corelab-umich/kiteCADRepo/solidworks/Exp Scale Manta Ray/Vendor Parts/Hi-Tec/HS-5086WP.jpg

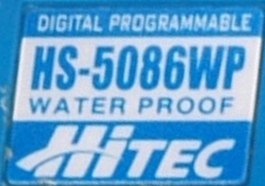
solidworks/Exp Scale Manta Ray/Vendor Parts/Hi-Tec/HS-5086WP.jpg
