corelab-umich/kiteCADRepo/README.md

# kiteCADRepo
Repo to house the CAD for the DOE kite
