corelab-umich/kiteCADRepo/solidworks/Exp Scale Manta Ray/EXK BOM.xlsx

ITEM NO. | PART NUMBER | DESCRIPTION | QTY. | Vendor | Notes | Date Ordered | Date Expected | Date Received
42 | SW1250MG | SERVO MOTOR | 4 | Amazon | In Stock | 2021-03-06 | 2021-03-12 | 2021-03-11
9 | BAR02 | DEPTH SENSOR | 1 | Blue Robotics | In Stock | N/A | N/A | N/A
1 | 2401K123 | SHAFT COUPLER - HSTAB | 2 | MCM | Ordered | 2021-03-10 | 2021-03-14
2 | 2401K820_ALUMINUM FLEXIBLE SHAFT COUPLING | SHAFT COUPLER FLEXIBLE COUPLING | 1 | MCM | Ordered | 2021-03-10 | 2021-03-14
3 | 2867T47 | BRIDLE HINGE PIN BUSHING | 2 | MCM | Ordered | 2021-03-10 | 2021-03-14
4 | 90145A508 | WING SHEAR PIN | 6 | MCM | Ordered | 2021-03-10 | 2021-03-14
5 | 92510A817 | ALUMINUM SPACER - TETHER PINCH LOCATION | 1 | MCM | Ordered | 2021-03-10 | 2021-03-14
6 | 92735A430 | BRIDLE HINGE PIN | 1 | MCM | Ordered | 2021-03-10 | 2021-03-14
7 | 92735A500 | CLEVIS PIN - TETHER | 1 | MCM | Ordered | 2021-03-10 | 2021-03-14
8 | 93615A216 | WING MOUNT SCREW | 6 | MCM | Ordered | 2021-03-10 | 2021-03-14
44 | W_626_2Z | BEARING 7mm ID X 19mm OD X 6mm H | 6 | MCM | In Stock | N/A | N/A
10 | Bridle |  | 1 | NCSU | 3D Printed | N/A
38 | MirrorEXK-02-0010 | MOTOR MOUNT STBD | 1 | NCSU | 3D Printed | N/A
39 | MirrorEXK-02-0024 | AILERON STBD | 1 | NCSU | 3D Printed | N/A
40 | MirrorEXK-02-0024 | AILERON HINGE STBD | 1 | NCSU | 3D Printed | N/A
34 | MCBH12-F | CONNECTOR, BULKHEAD, 12 PIN, FEMALE | 1 | TTI | Waiting on account w/ TTI. Currently waiting on Toni Rand | TBD
35 | MCBH8-F | CONNECTOR, 8 PIN, BULKHEAD, MALE | 1 | TTI | Waiting on account w/ TTI. Currently waiting on Toni Rand | TBD
36 | MCIL12M | CONNECTOR, 12 PIN, INLINE | 1 | TTI | Waiting on account w/ TTI. Currently waiting on Toni Rand | TBD
37 | MCIL8M | CONNECTOR, 8 PIN, INLINE | 1 | TTI | Waiting on account w/ TTI. Currently waiting on Toni Rand | TBD
11 | CB6014CR04-1P | NUTPLATE | 8 | VX | Quote Due Tomorrow
43 | Skin |  | 1 | VX | Quote Due Tomorrow
12 | EXK-01-0002 | NOSE CONE | 1 | Xometry | Order 15007 | 2021-03-09 | 2021-03-20
13 | EXK-01-0006 | TAILCONE | 1 | Xometry | Order 15009 | TBD
14 | EXK-01-0008 | FUSELAGE | 1 | Xometry | Order 15006 | TBD
17 | EXK-01-0014 | SPARS | 1 | Xometry | SoleSource | TBD
19 | EXK-02-0003 | RIB, WING ROOT | 1 | Xometry | SoleSource | TBD
20 | EXK-02-0003-02 | RIB WING ROOT STBD | 1 | Xometry | SoleSource | TBD
21 | EXK-02-0009-01 | RIB, WING TIP | 1 | Xometry | SoleSource | TBD
22 | EXK-02-0009-02 | RIB WING TIP STBD | 1 | Xometry | SoleSource | TBD
26 | EXK-02-0014-01 | SPAR, HORIZONTAL STABILIZER | 2 | Xometry | Shipped | TBD
27 | EXK-02-0014-02 | SPAR, VERTICAL STABILIZER | 1 | Xometry | Shipped | TBD
29 | EXK-02-0017 | WINGBOX | 1 | Xometry | Order 15005 | TBD
15 | EXK-01-0010 | STABILIZER | 3 | VX | Quote Due Tomorrow
16 | EXK-01-0012 | FOAM CORE | 1 | VX | Quote Due Tomorrow
18 | EXK-01-0016 | BRIDLE CLEVIS | 1 | NCSU | 3D Printed
23 | EXK-02-0010 | MOTOR MOUNT PORT | 1 | NCSU | 3D Printed
24 | EXK-02-0012 | STABILIZER BEARING BLOCK | 3 | Xometry | 1500A - Ordered | TBD | 2021-03-24
25 | EXK-02-0013 | STABILIZER CONTROL HORN | 2 | NCSU | Waterjet
28 | EXK-02-0015 | MOTOR CONTROL HORN | 2 | NCSU | Waterjet
30 | EXK-02-0024 | AILERON PORT | 1 | NCSU | 3D Printed
31 | EXK-02-0024 | AILERON HINGE PORT | 1 | NCSU | 3D Printed
32 | EXK-02-0025 | STATIC TRAILING EDGE PORT | 1 | NCSU | 3D Printed
33 | EXK-02-0028 | PCB MOUNT | 1 | NCSU | 3D Printed
41 | PCB-Step |  | 1
45 | Weights | N/A | Many | NCSU | Waterjet
