corelab-umich/kiteCADRepo/solidworks/Line Angle Sensor/LAS BOM.xlsx

ITEM NO. | PART NUMBER | DESCRIPTION | QTY. | Vendor
1 | LAS-01-0002 | LAS AZIMUTH PIVOT ARM | 1
2 | LAS-01-0008 | TETHER GUIDE ROLLER MOUNT | 1
3 | LAS-01-0010 | SHAFT END | 2
4 | LAS-01-0012 | TETHER ARM | 1
5 | LAS-01-0018 | LAS BOOM ARM BUOY | 1
6 | LAS-01-0020 | TETHER GUIDE ROLLER | 2
7 | LAS-02-0002 | LAS AZIMUTH AXIS - ENCODER | 1
8 | LAS-02-0003 | LAS AZIMUTH AXIS - PASSIVE | 1
9 | LAS-02-0006 | LAS ELEVATION PIVOT ARM | 1
10 | LAS-03-0002 | LAS BASE PLATE | 1
11 | LAS-03-0004 | LAS ELEVATION AXIS PIVOT MOUNT | 1
12 | LAS-03-0005 | LAS ELEVATION AXIS PIVOT MOUNT - OPPOSITE | 1
13 | LAS-03-0008 | TETHER REDIRECT | 1
14 | 4668K15 | BEARING, 440C, 1/2" SHAFT | 2 | MCMASTER CARR
15 | 5908K31 | BEARING, 316SS, 8mm SHAFT | 4 | MCMASTER CARR
16 | 90145A878 | 1/8" D, 5/16" L, 18-8 | 7 | MCMASTER CARR
17 | 90715A005 | LOCKNUT, 316 SS, 4-40 | 2 | MCMASTER CARR
18 | 90792A445 | 1/2" SHOULDER SCREW SHIM - 0.03" 316SS | 7 | MCMASTER CARR
19 | 91116A130 | WASHER, SS, OVERSIZED, M4 | 2 | MCMASTER CARR
20 | 92185A078 | #2-56, 5/16" L, 316 SS | 2 | MCMASTER CARR
21 | 92185A191 | #8-32, 5/16" L, 316 SS | 2 | MCMASTER CARR
22 | 92185A196 | #8-32, 5/8" L, 316 SS | 20 | MCMASTER CARR
23 | 92510A724 | ANODE, #8 X 1/2" OD X 3/8" L | 2 | MCMASTER CARR
24 | 92735A120 | 3/16" SS CLEVIS PIN | 2 | MCMASTER CARR
25 | 94805A115 | 3/6-16 JAM NUT 316 SS | 2 | MCMASTER CARR
26 | 97345A104 | SHOULDER SCREW, 316 SS, 1/8" X 5/8" | 2 | MCMASTER CARR
27 | 97345A732 | 3" X 1/2" 316 SHOULDER SCREW | 1 | MCMASTER CARR
28 | RM22-3D | RM22 ENCODER | 2 | RENISHAW
29 | RMA-shaft8mm | RMA MAGNETIC ACTUATOR | 2 | RENISHAW
