corelab-umich/kiteCADRepo/Creo/kite_7_31_20/kite_asm.stp

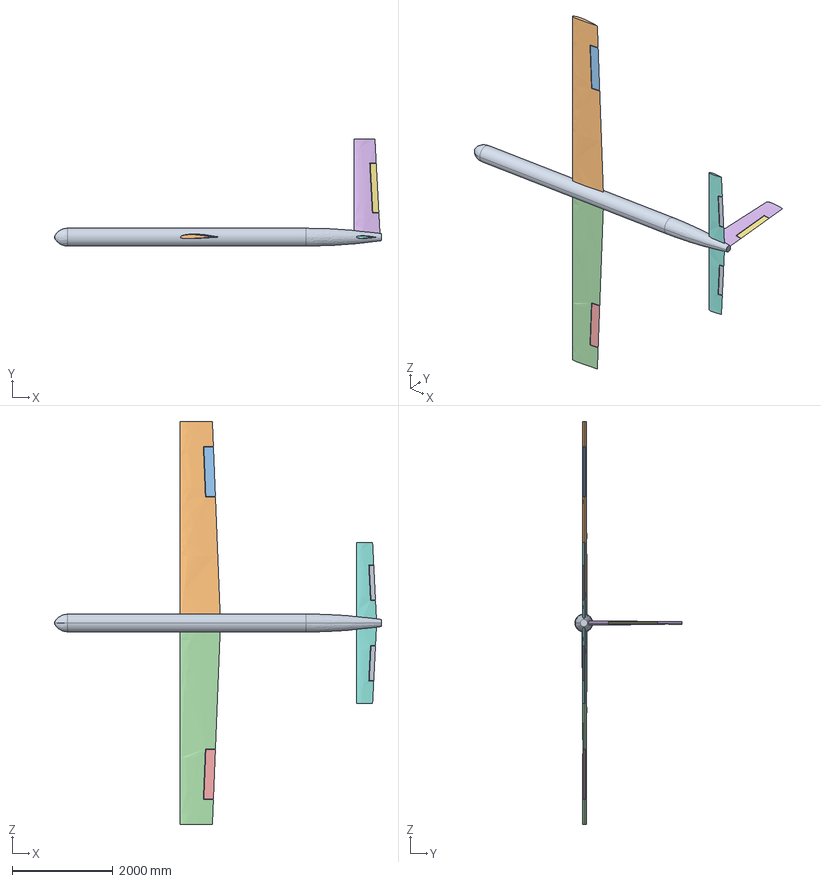
[picture p2: CAD file, 2020-09-25]
Creo/kite_7_31_20/kite_asm.stp
6500.0 x 2127.8 x 8000.0 mm
KITE_SKEL
FUSELAGE_CONCEPT
NACA2412_P_4M_0-8C_0S_0D_0-8T
NACA2412_S_4M_0-8C_0S_0D_0-8T
NACA0015_1-95M_0-52C_0S_0D_0-8T
NACA0015_1-6M_0-4C_0S_0D_0-8T
STBD_HSTAB
