corelab-umich/kiteCADRepo/solidworks/Pool Tow Testing - Full Scale/Kite Launch Platform.SLDASM

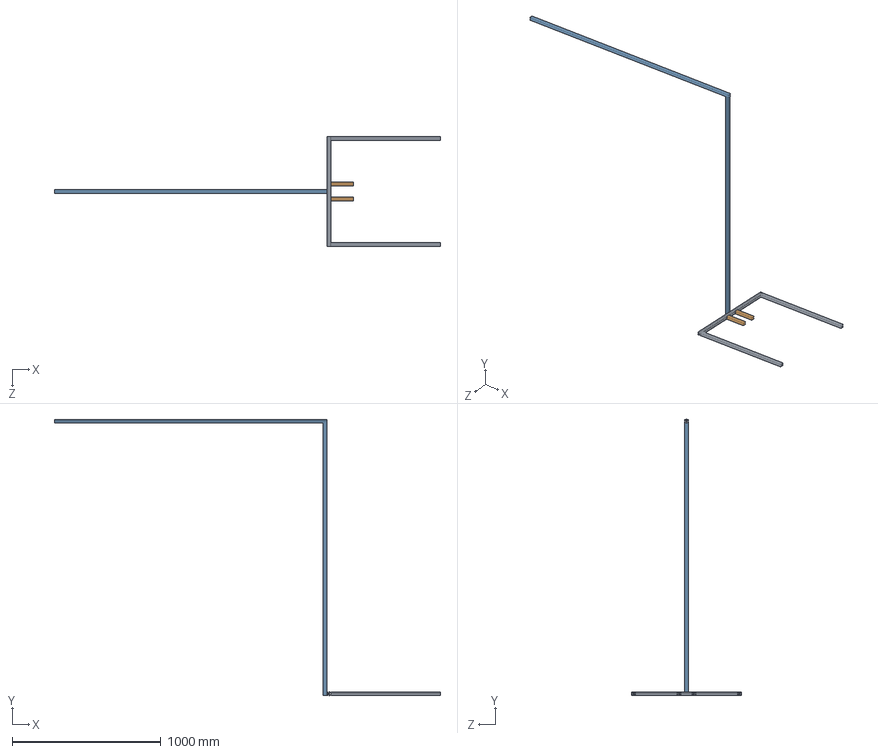
[picture p3: CAD file, 2021-04-08]
solidworks/Pool Tow Testing - Full Scale/Kite Launch Platform.SLDASM
2590.8 x 1854.2 x 736.6 mm
8020 -1inch - 2 ft 5 inchesV3 x 3
8020 -1inch - 0 ft 6 in x 2
8020 -1inch - 6 ft 0 in x 2
