corelab-umich/kiteCADRepo/solidworks/Pool Tow Testing - Full Scale/Raft/Raft Enclosure/Battery_Mount.SLDASM

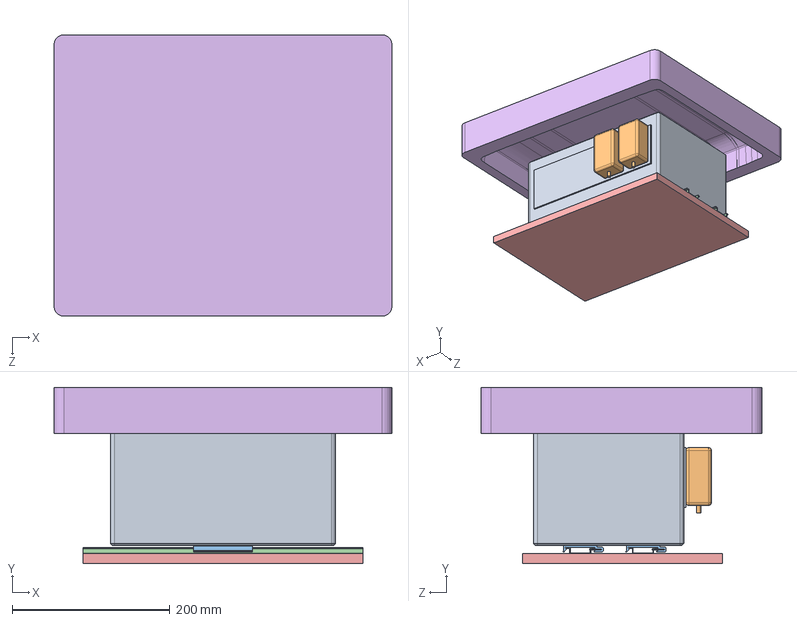
[picture p4: CAD file, 2021-01-22]
solidworks/Pool Tow Testing - Full Scale/Raft/Raft Enclosure/Battery_Mount.SLDASM
428.6 x 223.4 x 356.9 mm
GoalZero
ACAdapter x 2
8961K107_MOUNTING ADAPTERS FOR DIN RAIL x 2
8961K93_MOUNTING ADAPTERS FOR DIN RAIL-2 x 2
Back_Plate
1507 Top Tub
