corelab-umich/kiteCADRepo/solidworks/Pool Tow Testing - Full Scale/Retraction System/GomexusReel.SLDASM

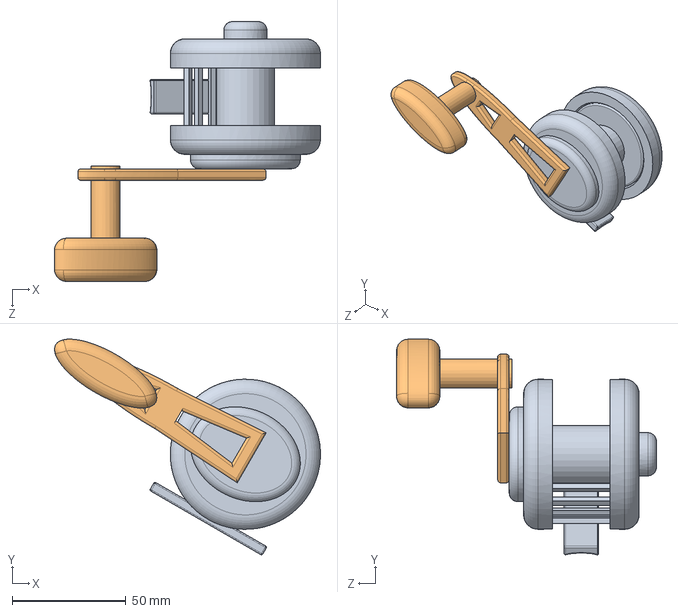
[picture p5: CAD file, 2021-02-22]
solidworks/Pool Tow Testing - Full Scale/Retraction System/GomexusReel.SLDASM
117.0 x 94.9 x 114.3 mm
Reel
Handle
