corelab-umich/kiteCADRepo/solidworks/Pool Tow Testing - Full Scale/TOW FEA ANALYSIS Brainstorm/_Tow System Assy BRAINSTORMV3FEA.SLDASM

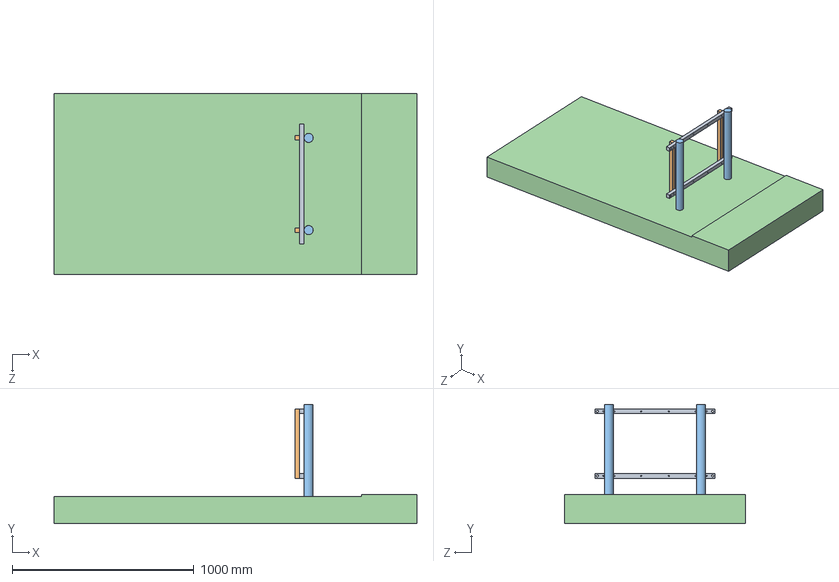
[picture p6: CAD file, 2021-01-13]
solidworks/Pool Tow Testing - Full Scale/TOW FEA ANALYSIS Brainstorm/_Tow System Assy BRAINSTORMV3FEA.SLDASM
2000.0 x 658.0 x 1000.0 mm
Guy Wire Span BeamV3FEA x 2
Guy Wire Vert BeamV3FEA x 2
6689T606 CHROME-PLATED HARDENED 4140 ALLOY STEEL ROD 2in ODFEA x 2
Pool Surface Constraints
