corelab-umich/kiteCADRepo/solidworks/TowAssy/Tow Test Assy V1.0.SLDASM

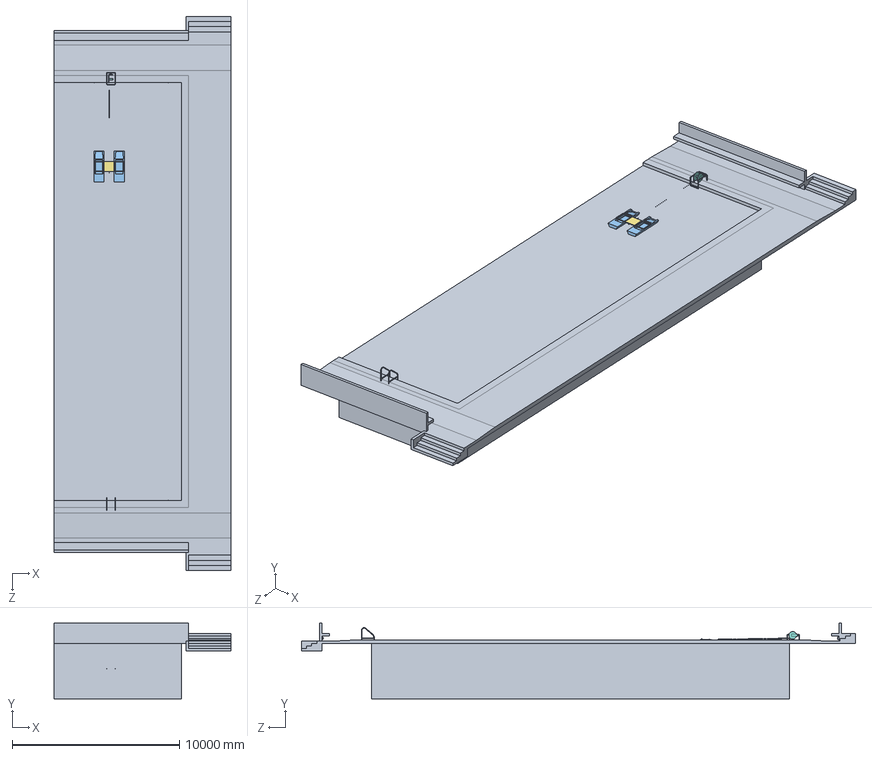
[picture p7: CAD file, 2020-10-07]
solidworks/TowAssy/Tow Test Assy V1.0.SLDASM
10591.8 x 4521.2 x 33153.4 mm
NCSU Olympic Pool V2.0
1.5 inch lifting eye - no nut x 4
6 foot Pontoon x 2
8020 -1inch - 6 feet x 2
8020 -1inch - 22 inches - lifting eye holes x 2
1.5 inch lifting eye x 6
2 ft x 2ft Al sheet
Double 8020 1 inch x 22 inch x 2
Basic Caribiner x 2
8020 -1inch - 5 ft 0 in x 2
8020 -1inch - 2 ft 4 inches x 2
8020 -1inch - 1 ft 6 in x 2
8020 -1inch - 0 ft 4.5 in x 2
8020 -1inch - 1 ft 7 in x 5
Retraction Bracket
Retraction Reel
1-2 inch x 1 inch SS, 1-2-20 x 4
1-2-20 SS Nut x 4
Retraction Cable
Swim Ladder V1.0
