corelab-umich/kiteCADRepo/solidworks/MantaRay/MRkiteAssemblyWithProp_FS.SLDASM

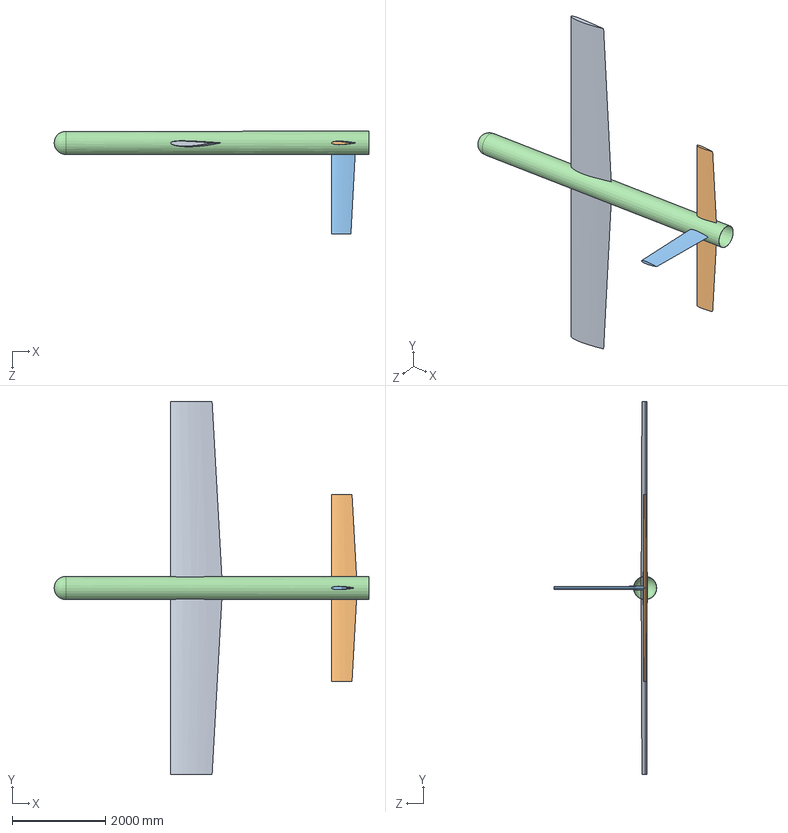
[picture p8: CAD file, 2021-01-22]
solidworks/MantaRay/MRkiteAssemblyWithProp_FS.SLDASM
6750.0 x 7999.9 x 2200.0 mm
MRwing_FS
MRhStab_FS
MRvStab_FS
MRfuselageWithProp_FS
