corelab-umich/kiteCADRepo/solidworks/Pool Tow Testing - Full Scale/Raft/Raft Enclosure/LCA_Baseline_Enclosure_16122020.SLDASM

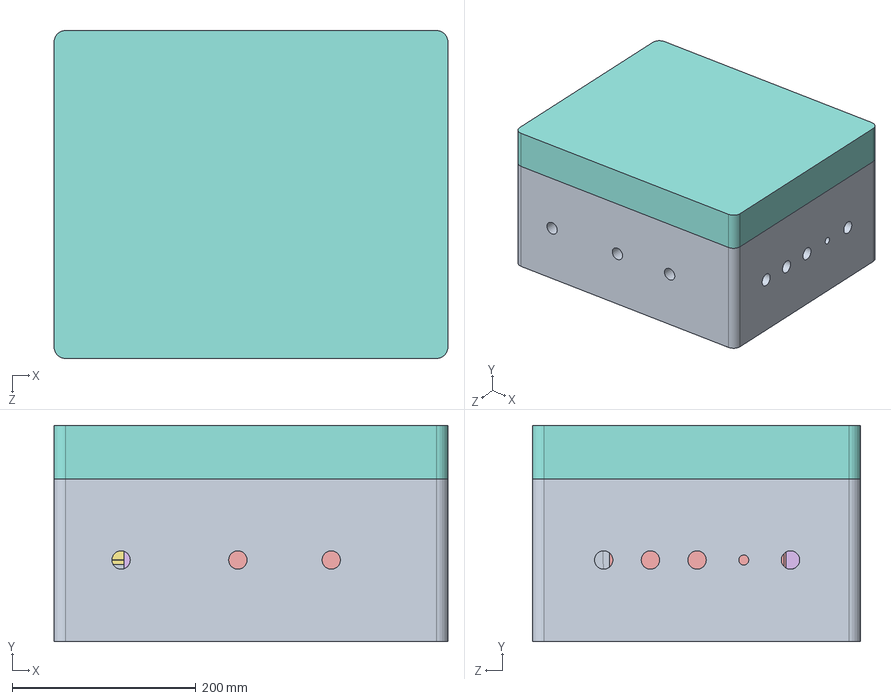
[picture p9: CAD file, 2021-01-22]
solidworks/Pool Tow Testing - Full Scale/Raft/Raft Enclosure/LCA_Baseline_Enclosure_16122020.SLDASM
428.6 x 235.5 x 356.9 mm
1507 Bottom Tub
Back_Plate
8961K93_MOUNTING ADAPTERS FOR DIN RAIL-2
8961K107_MOUNTING ADAPTERS FOR DIN RAIL
BaselineSpeedgoat
LoadCellAmplifier
8961K93_MOUNTING ADAPTERS FOR DIN RAIL 6in
1507 Top Tub
