corelab-umich/kiteCADRepo/solidworks/Pool Tow Testing - Full Scale/TOW FEA ANALYSIS Brainstorm/_Tow System Assy BRAINSTORMV3FEA_defeature.SLDPRT

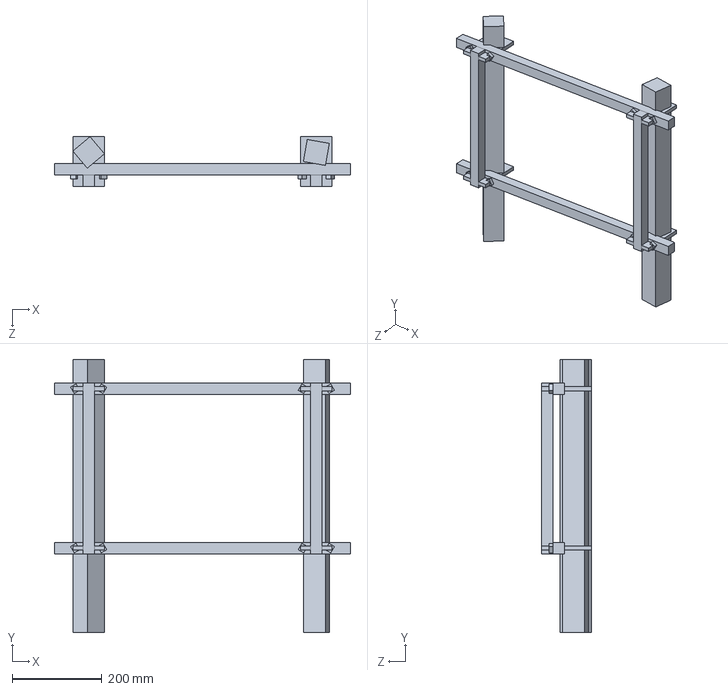
[picture p10: CAD file, 2021-01-08]
solidworks/Pool Tow Testing - Full Scale/TOW FEA ANALYSIS Brainstorm/_Tow System Assy BRAINSTORMV3FEA_defeature.SLDPRT
660.4 x 609.6 x 111.2 mm
