corelab-umich/kiteCADRepo/solidworks/Privateer/Total Pressure Line.SLDPRT

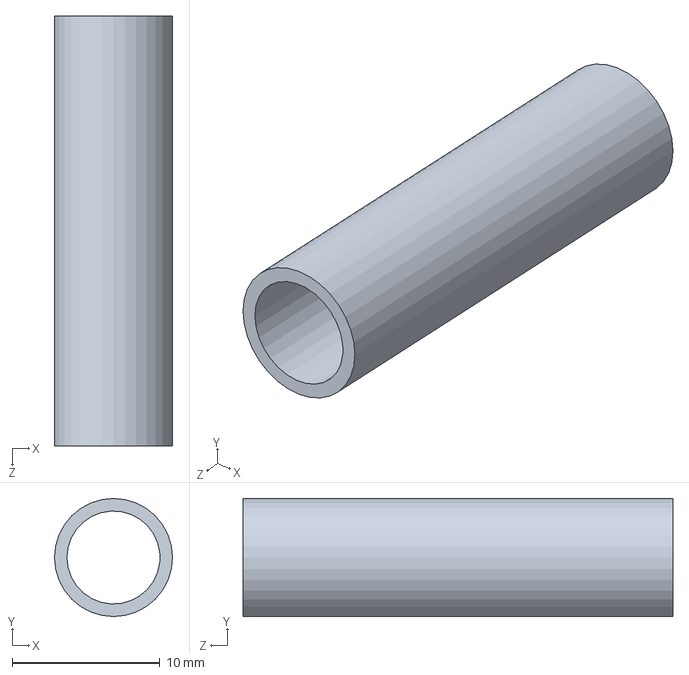
[picture p11: CAD file, 2024-01-24]
solidworks/Privateer/Total Pressure Line.SLDPRT
8.00 x 8.00 x 29.1 mm
