corelab-umich/kiteCADRepo/solidworks/Exp Scale Manta Ray/EXK-02-0019.SLDASM

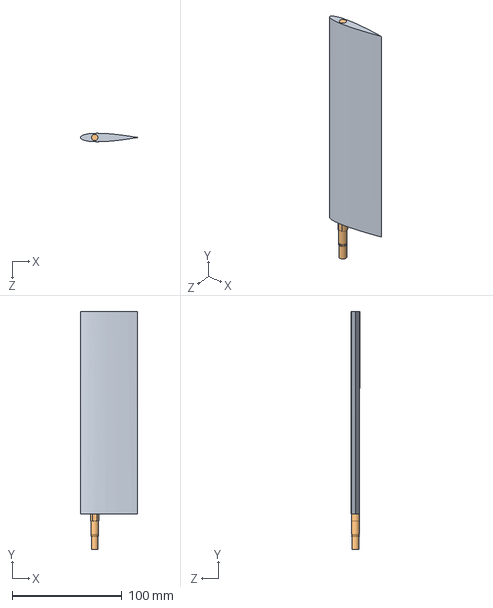
[picture p12: CAD file, 2024-01-24]
solidworks/Exp Scale Manta Ray/EXK-02-0019.SLDASM
52.0 x 217.2 x 7.79 mm
EXK-01-0010
EXK-02-0014
