corelab-umich/kiteCADRepo/solidworks/Exp Scale Manta Ray/Vendor Parts/KitePCB.SLDASM

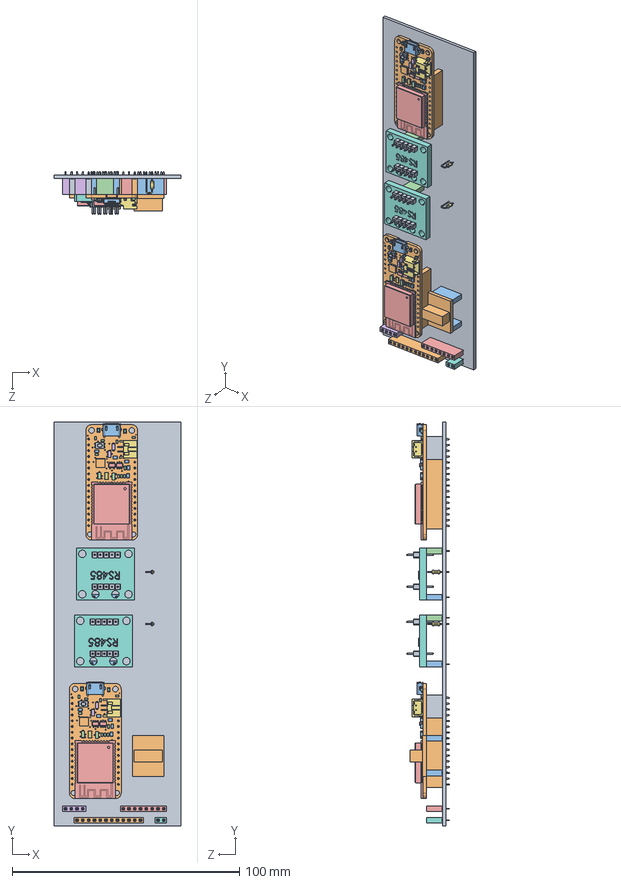
[picture p13: CAD file, 2021-05-12]
solidworks/Exp Scale Manta Ray/Vendor Parts/KitePCB.SLDASM
55.9 x 177.8 x 18.9 mm
SOLID.step.STEP x 2
SOLID-0.step.STEP x 3
SOLID-1.step.STEP x 4
SOLID-2.step.STEP x 2
SOLID-3.step.STEP
SOLID-4.step.STEP
SOLID-5.step.STEP x 2
SOLID-6.step.STEP
COMPOUND.step.STEP
Board.stp.STEP x 2
10uF.stp.STEP x 10
4.7K.stp.STEP x 18
MCP73831T-2ACI_OT.stp.STEP x 4
MBR120.stp.STEP x 2
JSTPH.stp.STEP x 2
RED.stp.STEP x 4
KMR2.stp.STEP x 2
CP2104.stp.STEP x 2
20329.stp.STEP x 2
mmbt2222.stp.STEP x 4
ESP32_WROOM32_SKINNY.stp.STEP x 2
DMG3415U.stp.STEP x 2
10K.stp.STEP x 2
UARTRS485Breakout.STEP x 2
5pin_M_254.STEP x 4
SWD_breakout.STEP
