corelab-umich/kiteCADRepo/solidworks/Exp Scale Manta Ray/Vendor Parts/Lord/huzzah32.stp.SLDASM

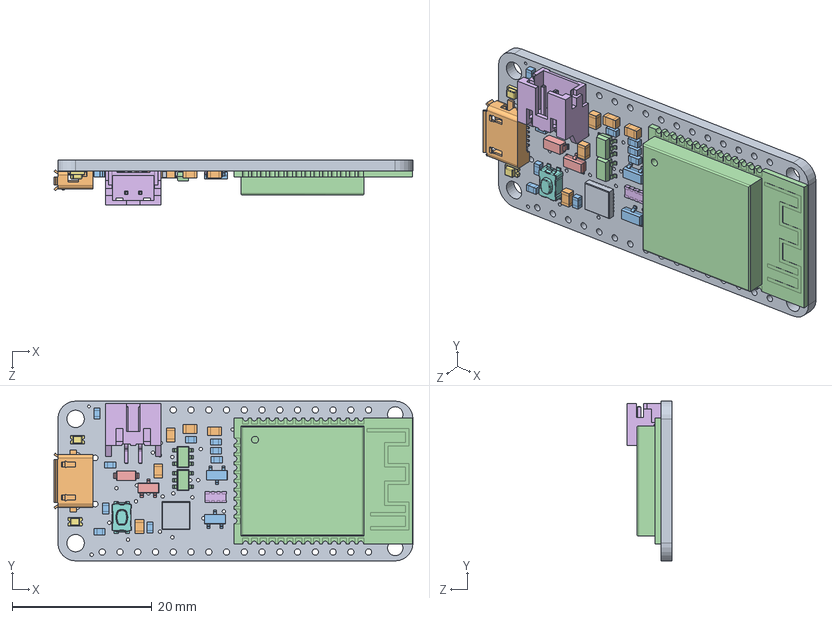
[picture p14: CAD file, 2020-10-07]
solidworks/Exp Scale Manta Ray/Vendor Parts/Lord/huzzah32.stp.SLDASM
51.4 x 22.9 x 6.37 mm
Board.stp
10uF.stp x 5
4.7K.stp x 9
MCP73831T-2ACI_OT.stp x 2
MBR120.stp
JSTPH.stp
RED.stp x 2
KMR2.stp
CP2104.stp
20329.stp
mmbt2222.stp x 2
ESP32_WROOM32_SKINNY.stp
DMG3415U.stp
10K.stp
