corelab-umich/kiteCADRepo/solidworks/Pool Tow Testing - Full Scale/Raft/LAS Standoff/_LAS Standoff Assy V1.0.SLDASM

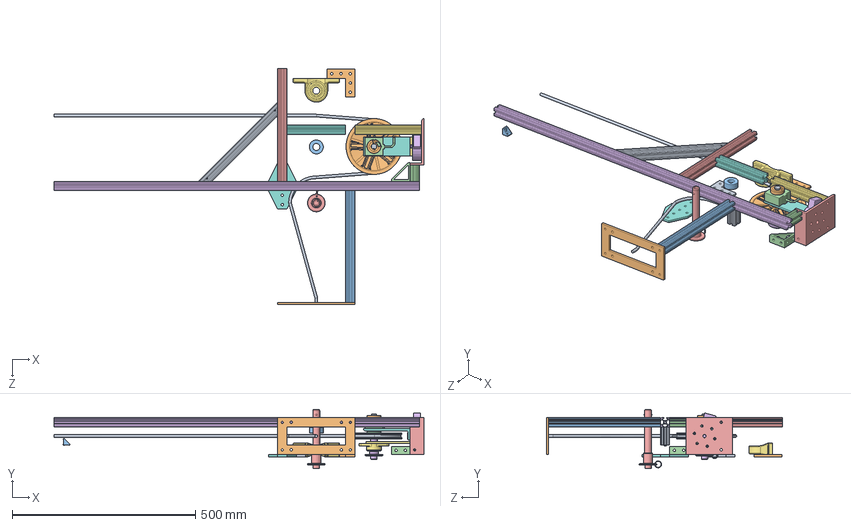
[picture p15: CAD file, 2021-07-02]
solidworks/Pool Tow Testing - Full Scale/Raft/LAS Standoff/_LAS Standoff Assy V1.0.SLDASM
1008.5 x 161.3 x 644.5 mm
Load Cell - 50 to 1000lbs
8982K461_ Left Custom for Load Cell and Pulley Bracket
8982K461_ Right Custom for Load Cell and Pulley Bracket
Encoder Placeholder
90585A068_TYPE 316 SS FLAT-HEAD SOCKET CAP SCREW
6656K182_ULTRA-THIN BALL BEARING x 2
7405K230_FULLY KEYED 316 STAINLESS STEEL DRIVE SHAFT
1511K260_QUICK-RELEASE CLAMPING SHAFT COLLAR
Custom Pulley for Encoder V2.0
