corelab-umich/kiteCADRepo/solidworks/Pool Tow Testing - Full Scale/Raft/Raft Enclosure/Battery Enclosure 16122020.SLDASM

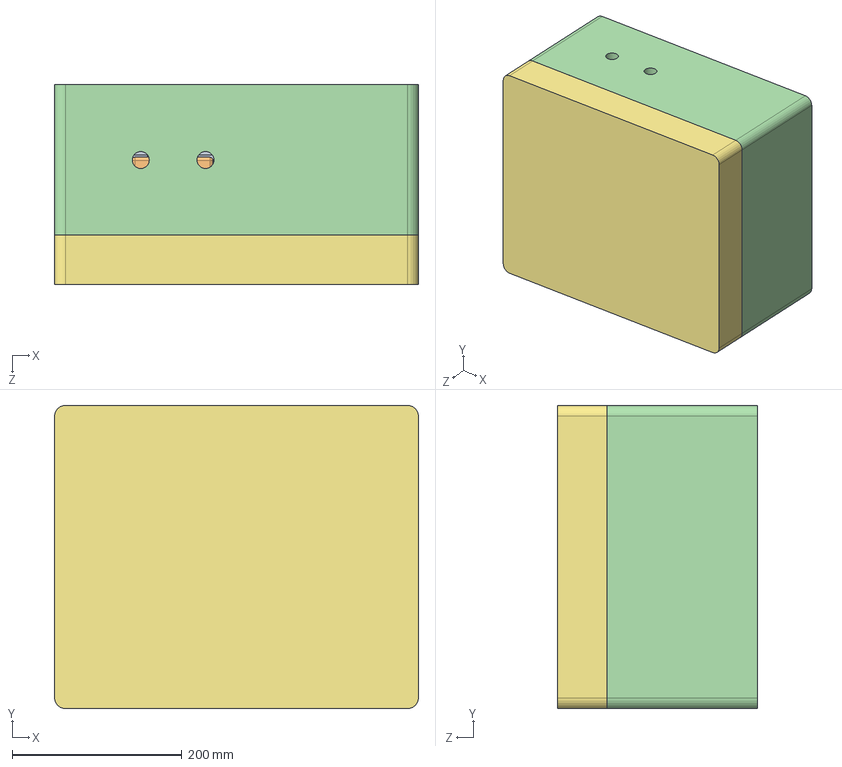
[picture p16: CAD file, 2021-01-22]
solidworks/Pool Tow Testing - Full Scale/Raft/Raft Enclosure/Battery Enclosure 16122020.SLDASM
428.6 x 356.9 x 235.5 mm
GoalZero
ACAdapter x 2
8961K107_MOUNTING ADAPTERS FOR DIN RAIL x 2
1507 Bottom Tub Battery 1
8961K93_MOUNTING ADAPTERS FOR DIN RAIL-2 x 2
Back_Plate
1507 Top Tub
