corelab-umich/kiteCADRepo/solidworks/Pool Tow Testing - Full Scale/TOW FEA Simplified/_Tow System Assy BRAINSTORMV3FEASimp.SLDASM

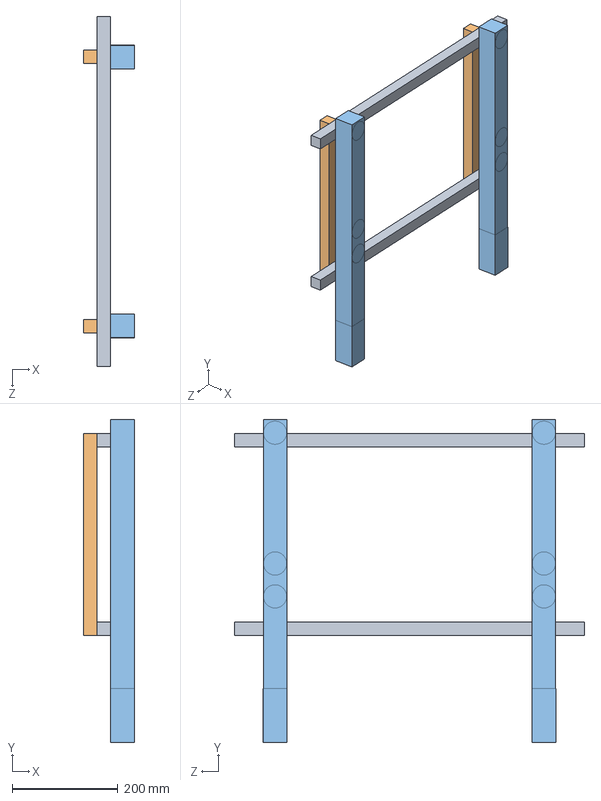
[picture p17: CAD file, 2021-01-18]
solidworks/Pool Tow Testing - Full Scale/TOW FEA Simplified/_Tow System Assy BRAINSTORMV3FEASimp.SLDASM
95.9 x 609.6 x 660.4 mm
Guy Wire Span BeamV3FEASimp x 2
Guy Wire Vert BeamV3FEASimp x 2
Chrome Plated Steel Simp x 2
