corelab-umich/kiteCADRepo/solidworks/Exp Scale Manta Ray/Vendor Parts/Hi-Tec/HS-5086WP.SLDASM

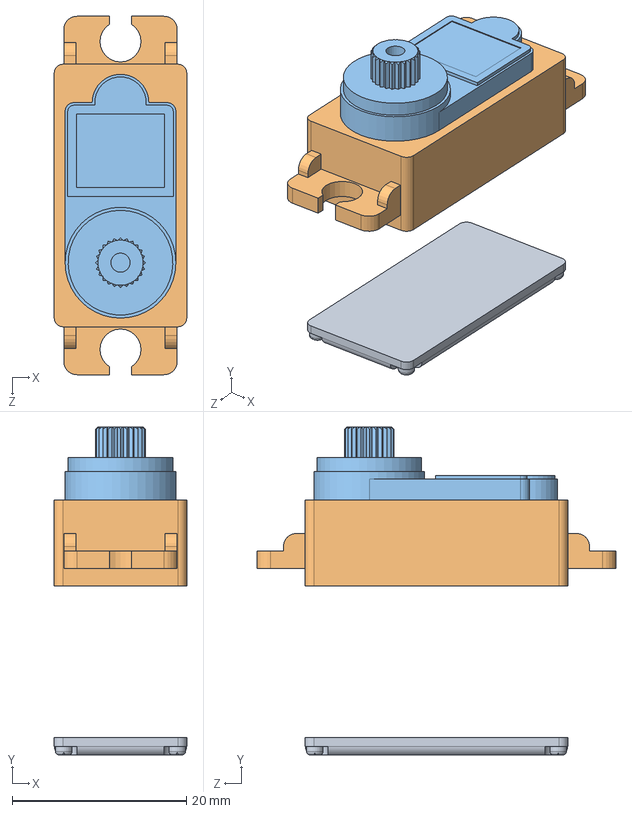
[picture p18: CAD file, 2020-12-30]
solidworks/Exp Scale Manta Ray/Vendor Parts/Hi-Tec/HS-5086WP.SLDASM
15.2 x 37.6 x 41.1 mm
HS-5086WP_bottom
HS-5086WP_upper
HS-5086WP_top
