corelab-umich/kiteCADRepo/solidworks/Pool Tow Testing - Full Scale/Retraction System/Retraction Reel Subassembly.SLDASM

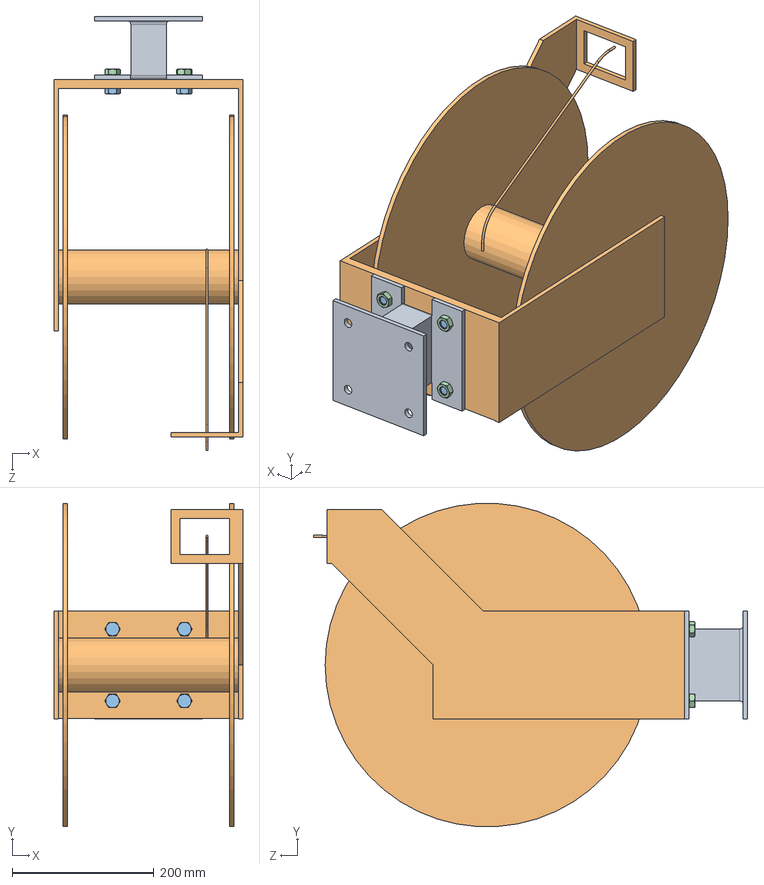
[picture p19: CAD file, 2020-12-16]
solidworks/Pool Tow Testing - Full Scale/Retraction System/Retraction Reel Subassembly.SLDASM
266.7 x 456.3 x 613.6 mm
Retraction Bracket
Retraction Reel
1-2 inch x 1 inch SS, 1-2-20 x 4
1-2-20 SS Nut x 4
