corelab-umich/kiteCADRepo/solidworks/Pool Tow Testing - Full Scale/Retraction System/_Retraction System Assy V1.0.SLDASM

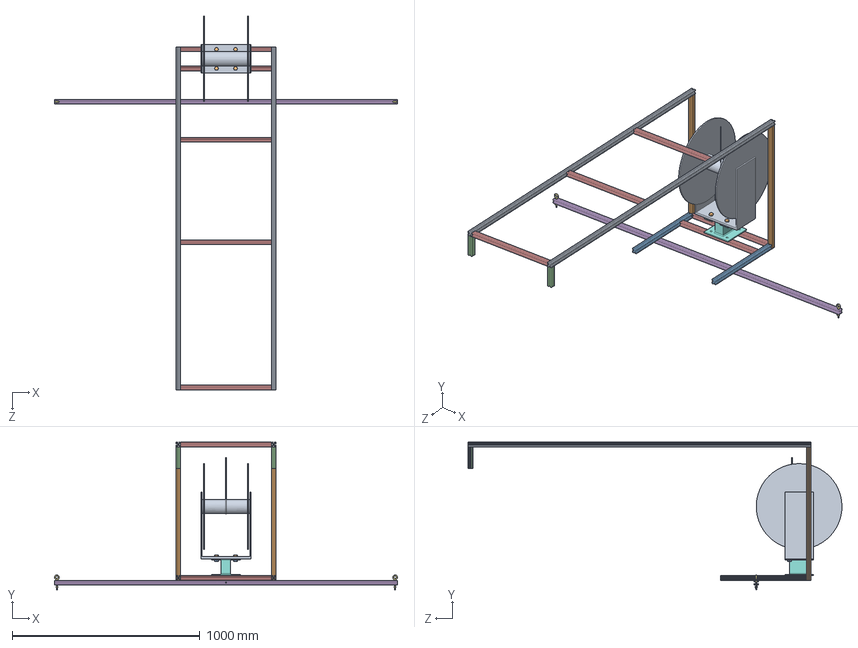
[picture p20: CAD file, 2020-12-16]
solidworks/Pool Tow Testing - Full Scale/Retraction System/_Retraction System Assy V1.0.SLDASM
1828.8 x 787.4 x 1993.8 mm
8020 -1inch - 5 ft 0 in x 2
8020 -1inch - 2 ft 4 inches x 2
8020 -1inch - 1 ft 6 in x 2
8020 -1inch - 0 ft 4.5 in x 2
8020 -1inch - 1 ft 7 in x 5
8020 -1inch - 6 feet with guide line holes
1.5 inch lifting eye x 2
Retraction Bracket
Retraction Reel
1-2 inch x 1 inch SS, 1-2-20 x 4
1-2-20 SS Nut x 4
