corelab-umich/kiteCADRepo/solidworks/Boat_w_A_Frame/kiteAssembly_FS.SLDPRT

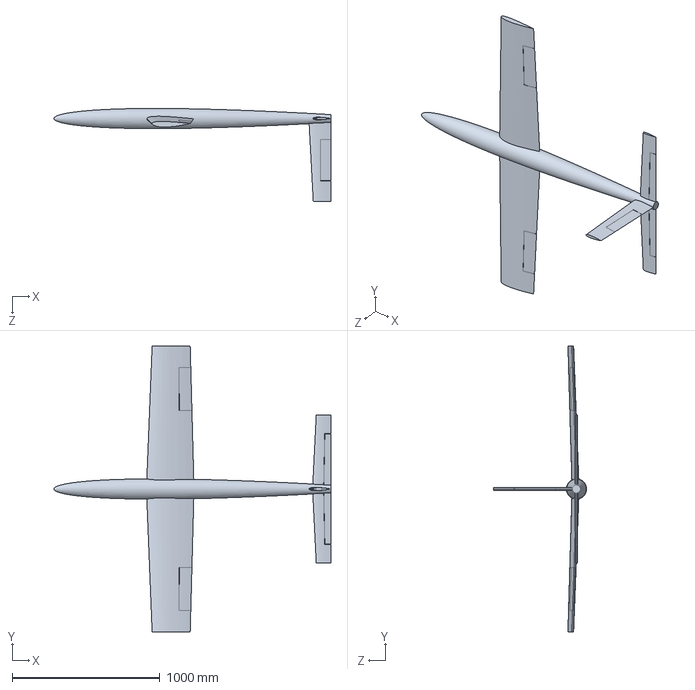
[picture p21: CAD file, 2024-01-24]
solidworks/Boat_w_A_Frame/kiteAssembly_FS.SLDPRT
1875.8 x 1935.0 x 631.1 mm
