corelab-umich/kiteCADRepo/solidworks/Pool Tow Testing - Full Scale/Retraction System/Retraction Frame.SLDASM

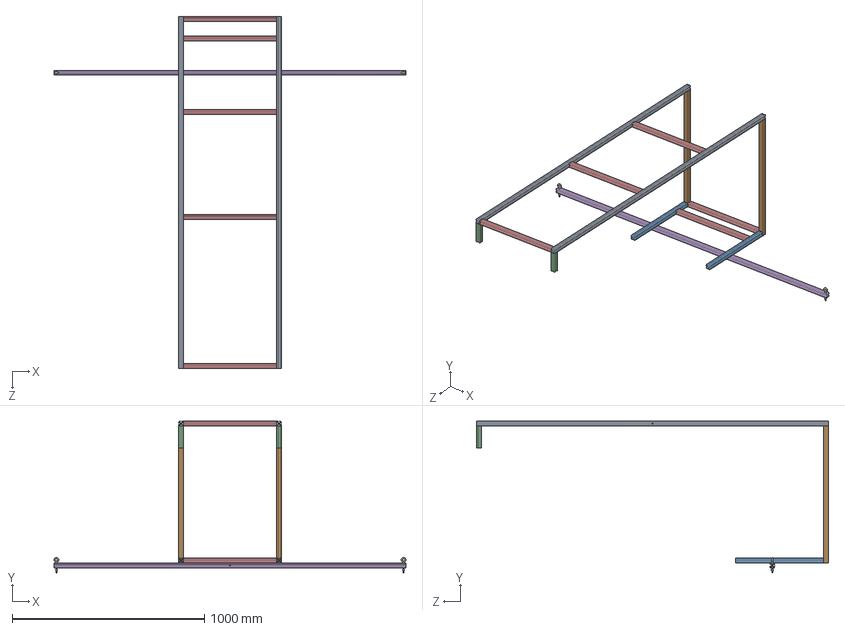
[picture p22: CAD file, 2020-10-29]
solidworks/Pool Tow Testing - Full Scale/Retraction System/Retraction Frame.SLDASM
1828.8 x 787.4 x 1828.8 mm
8020 -1inch - 5 ft 0 in x 2
8020 -1inch - 2 ft 4 inches x 2
8020 -1inch - 1 ft 6 in x 2
8020 -1inch - 0 ft 4.5 in x 2
8020 -1inch - 1 ft 7 in x 5
8020 -1inch - 6 feet with guide line holes
1.5 inch lifting eye x 2
