corelab-umich/kiteCADRepo/solidworks/Line Angle Sensor/LAS-02-0000.SLDASM

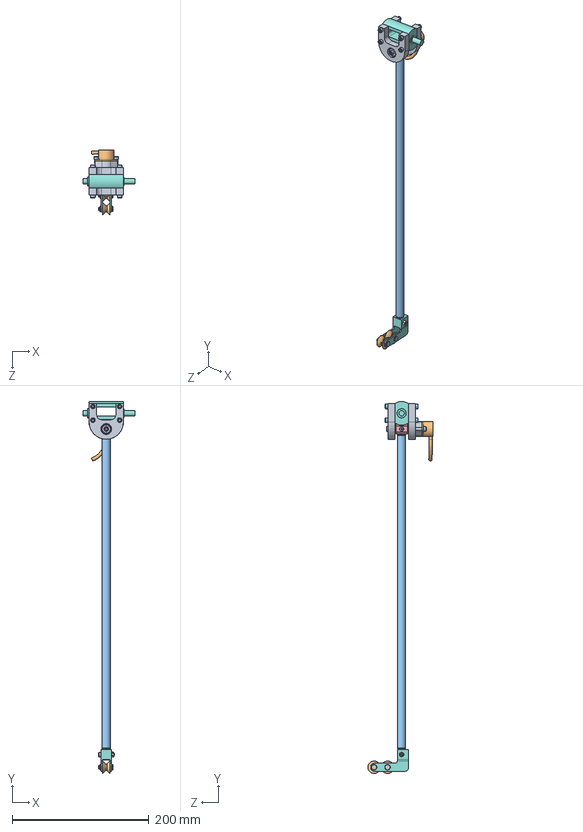
[picture p23: CAD file, 2024-01-24]
solidworks/Line Angle Sensor/LAS-02-0000.SLDASM
76.0 x 543.6 x 95.4 mm
LAS-02-0002
RM22-3D
LAS-01-0012
LAS-01-0010 x 2
LAS-01-0002
97345A104 x 2
90715A005 x 2
LAS-01-0008
92735A120_GROOVED CLEVIS PIN WITH RETAINING RING x 2
LAS-01-0020 x 2
socket head cap screw_ai x 11
dowel pin_ai x 3
RMA-shaft8mm
91116A130_TYPE 18-8 STAINLESS STL OVERSIZED FLAT WASHER
5908K310 x 2
LAS-02-0006
LAS-02-0003
