corelab-umich/kiteCADRepo/solidworks/Pool Tow Testing - Full Scale/TOW FEA ANALYSIS/FEA - _Tow System Assy V1.1_defeature.SLDPRT

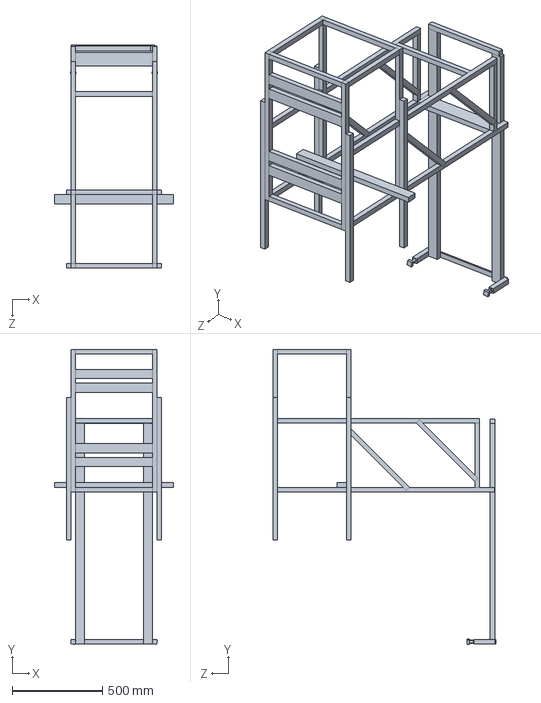
[picture p24: CAD file, 2020-12-30]
solidworks/Pool Tow Testing - Full Scale/TOW FEA ANALYSIS/FEA - _Tow System Assy V1.1_defeature.SLDPRT
660.4 x 1630.8 x 1235.2 mm
