corelab-umich/kiteCADRepo/solidworks/Line Angle Sensor/LAS-01-0016.SLDASM

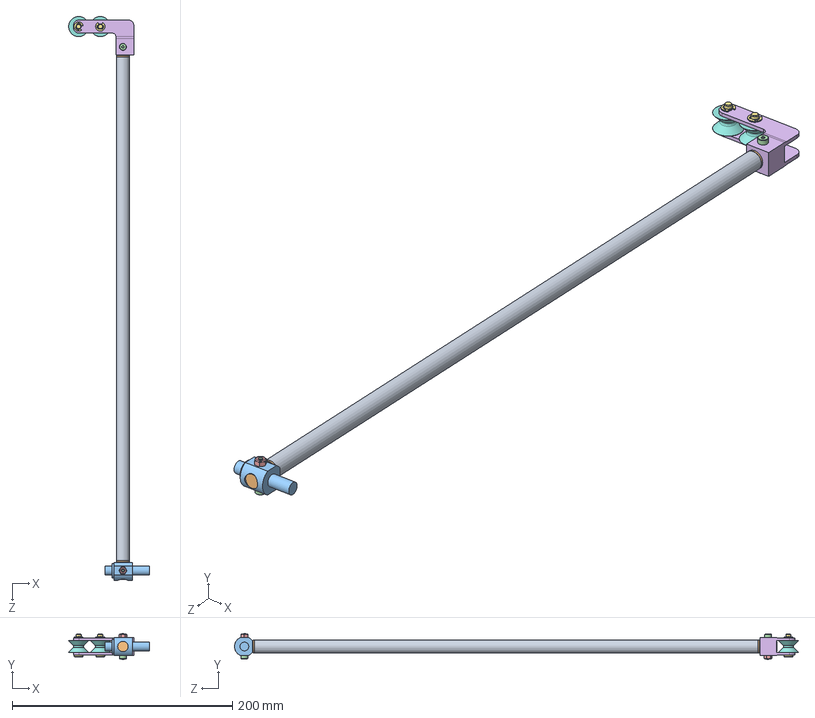
[picture p25: CAD file, 2024-01-24]
solidworks/Line Angle Sensor/LAS-01-0016.SLDASM
73.4 x 23.7 x 512.4 mm
LAS-01-0012
LAS-01-0010 x 2
LAS-01-0002
97345A104 x 2
90715A005 x 2
LAS-01-0008
92735A120_GROOVED CLEVIS PIN WITH RETAINING RING x 2
LAS-01-0020 x 2
