corelab-umich/kiteCADRepo/solidworks/Privateer/Full lake test Assm/lake test set up 2/18-18mm Misalinemnt coupler.SLDASM

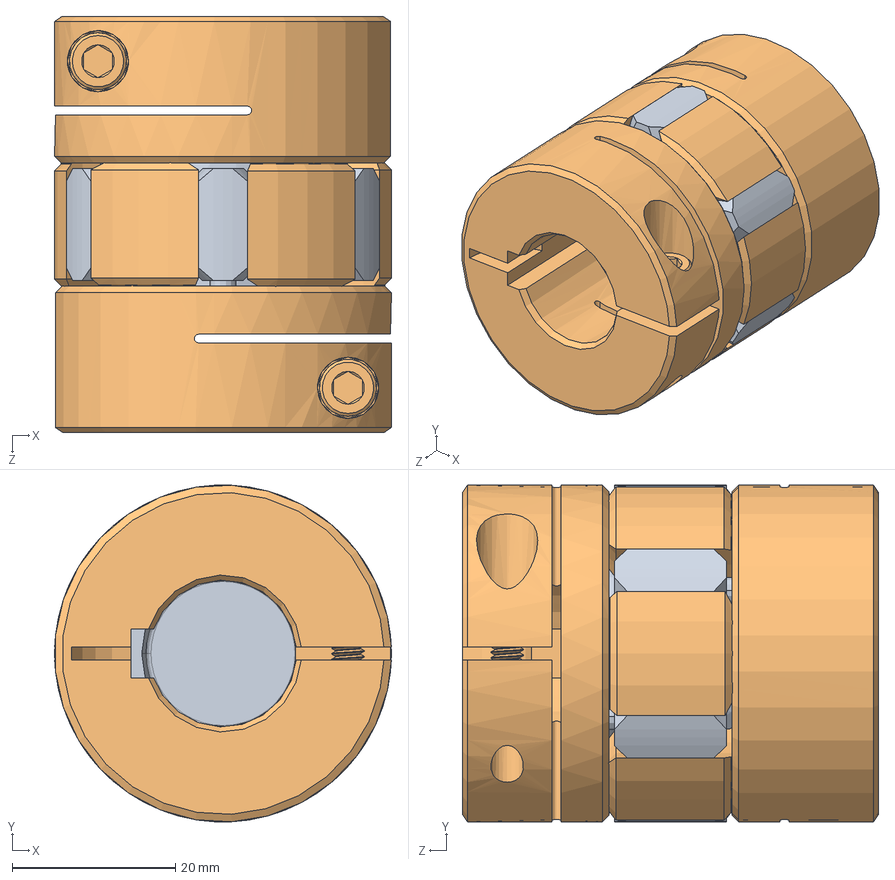
[picture p26: CAD file, 2021-07-02]
solidworks/Privateer/Full lake test Assm/lake test set up 2/18-18mm Misalinemnt coupler.SLDASM
41.3 x 41.3 x 51.0 mm
9845T210_VIBRATE-DAMPING PRECISION FLEXIBLE SHAFT CPLG
9845T471_VIBRATE-DAMPING PRECISION FLEXIBLE SHAFT COUPLING x 2
