corelab-umich/kiteCADRepo/solidworks/Privateer/Velocity Sensor and Pitot Tube As Built/Velocity Sensor V2.0.SLDASM

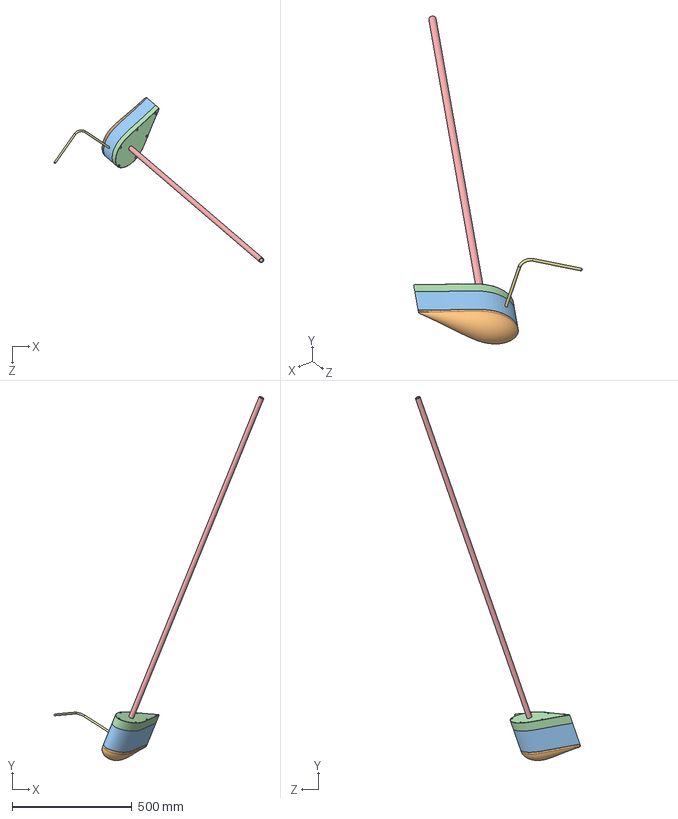
[picture p27: CAD file, 2021-07-02]
solidworks/Privateer/Velocity Sensor and Pitot Tube As Built/Velocity Sensor V2.0.SLDASM
875.0 x 1519.1 x 690.1 mm
655A-07-C
Lower End Cap
MidUnit-Eppler862
UppeCap-Eppler862
Strut
10-24 Thread Size_6in Long x 6
Pitot Tube
