corelab-umich/kiteCADRepo/solidworks/Exp Scale Manta Ray/Coupler_Assy.SLDASM

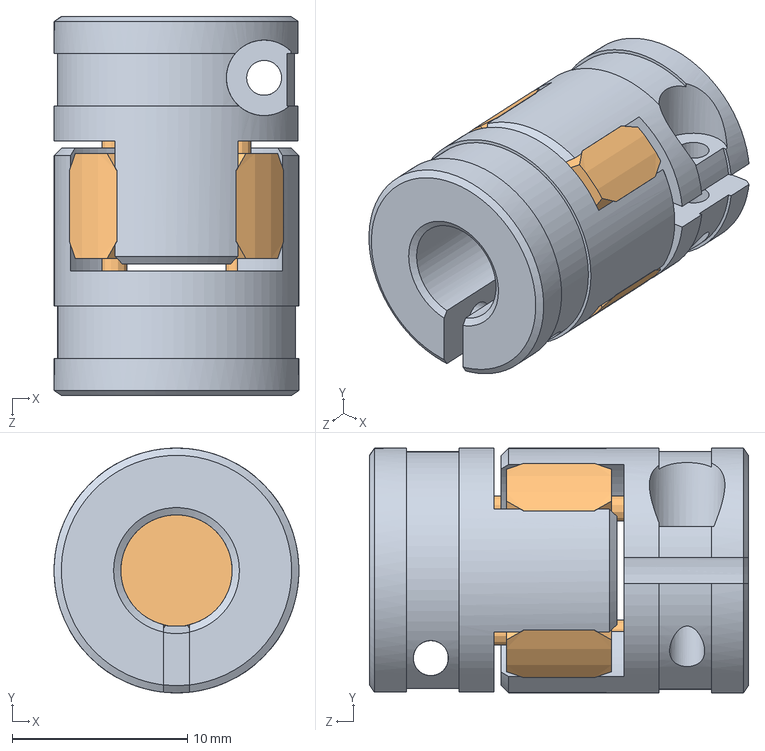
[picture p28: CAD file, 2024-01-24]
solidworks/Exp Scale Manta Ray/Coupler_Assy.SLDASM
14.0 x 14.0 x 21.6 mm
2401K123_ALUMINUM FLEXIBLE SHAFT COUPLING x 2
2401K820_ALUMINUM FLEXIBLE SHAFT COUPLING
