corelab-umich/kiteCADRepo/solidworks/Exp Scale Manta Ray/MirrorEXK-02-0028.SLDASM

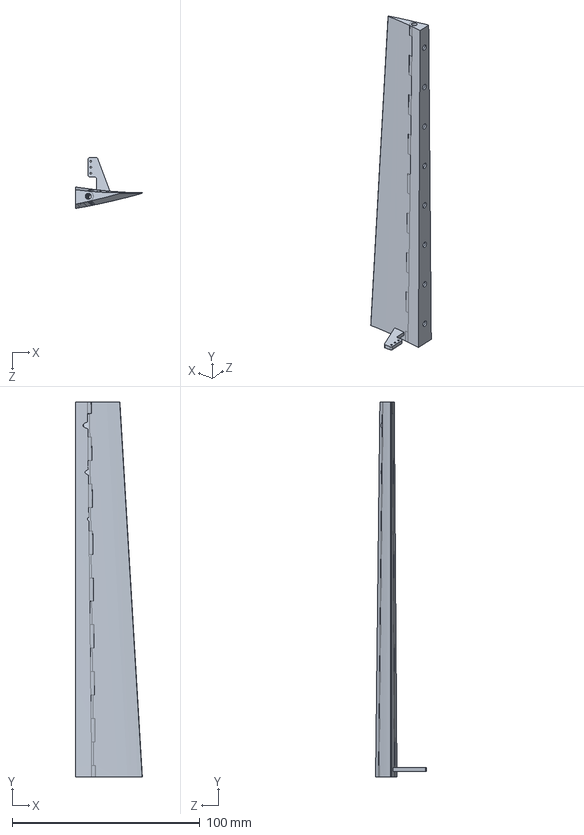
[picture p29: CAD file, 2024-01-24]
solidworks/Exp Scale Manta Ray/MirrorEXK-02-0028.SLDASM
35.6 x 200.0 x 27.2 mm
MirrorEXK-02-0024 x 2
