corelab-umich/kiteCADRepo/solidworks/Line Angle Sensor/LAS-01-0014.SLDASM

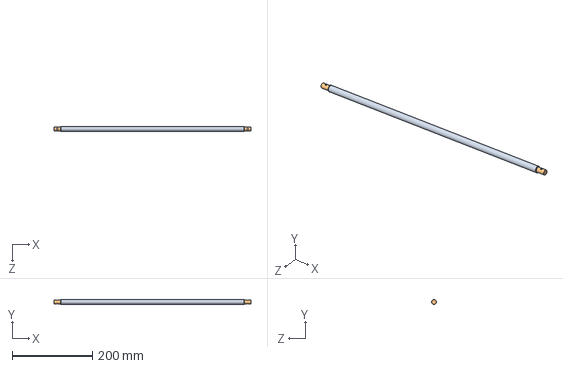
[picture p30: CAD file, 2024-01-24]
solidworks/Line Angle Sensor/LAS-01-0014.SLDASM
491.7 x 12.0 x 12.0 mm
LAS-01-0012
LAS-01-0010 x 2
