corelab-umich/kiteCADRepo/solidworks/Pool Tow Testing - Full Scale/TOW FEA ANALYSIS/FEA - _Tow System Assy V1.1_defeature v3.SLDPRT

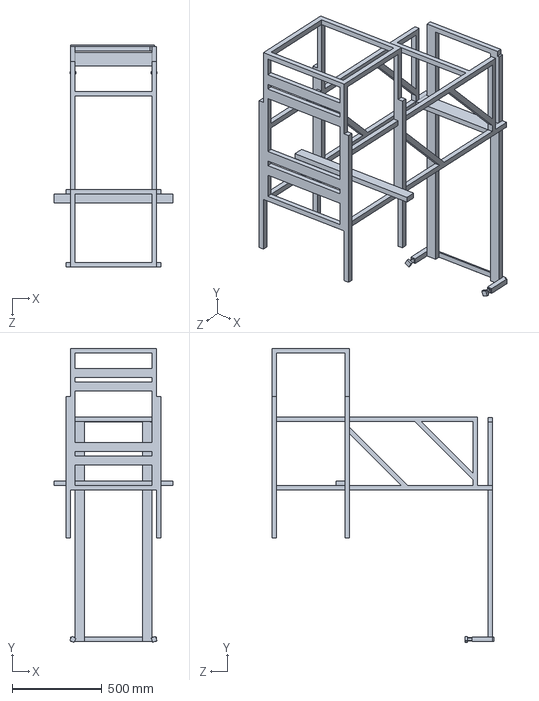
[picture p31: CAD file, 2020-12-30]
solidworks/Pool Tow Testing - Full Scale/TOW FEA ANALYSIS/FEA - _Tow System Assy V1.1_defeature v3.SLDPRT
660.4 x 1633.4 x 1235.2 mm
