corelab-umich/kiteCADRepo/solidworks/Privateer/Full lake test Assm/lake test set up 2/Drum assm.SLDASM

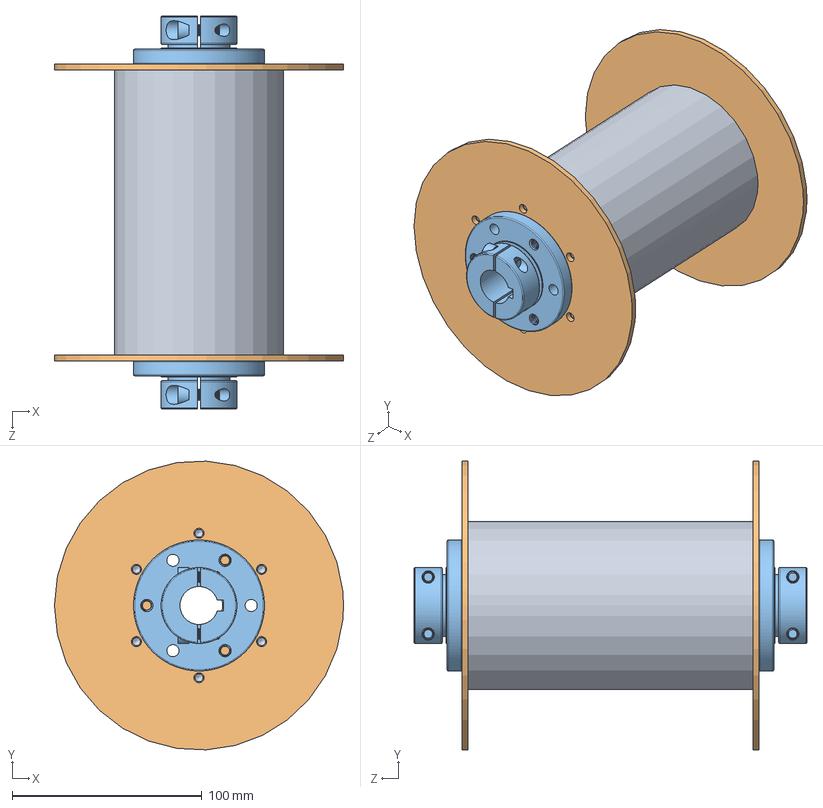
[picture p32: CAD file, 2021-07-02]
solidworks/Privateer/Full lake test Assm/lake test set up 2/Drum assm.SLDASM
152.4 x 152.2 x 207.1 mm
3.5in pipe
Disk x 2
9604T17_FLANGE-MOUNT SHAFT COLLAR (1) x 2
