corelab-umich/kiteCADRepo/solidworks/Exp Scale Manta Ray/Electronics Sled.SLDASM

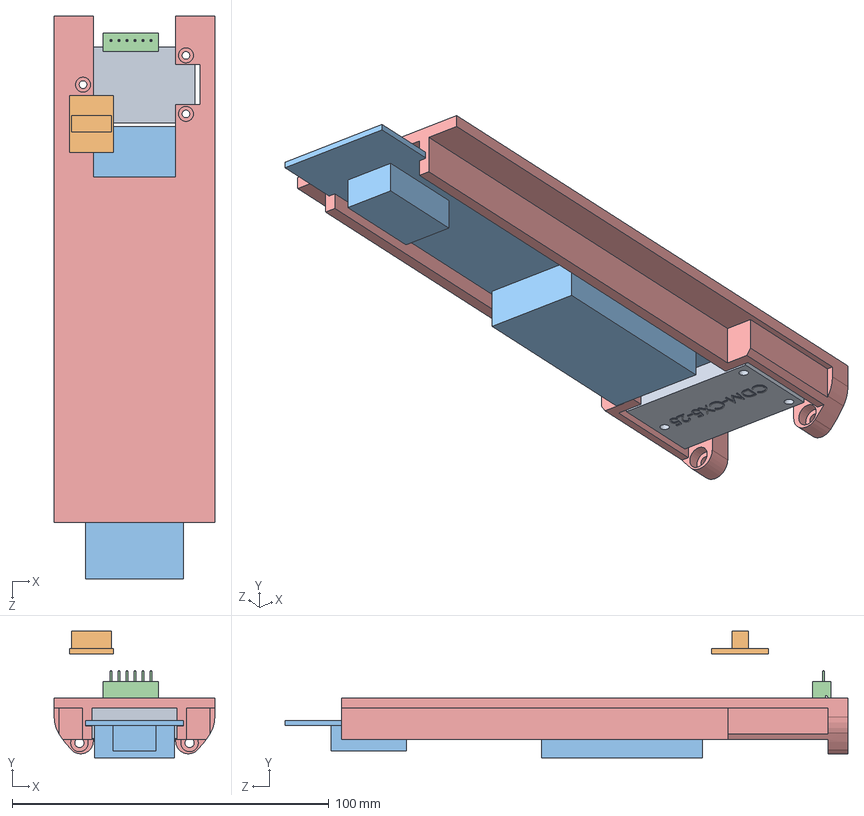
[picture p33: CAD file, 2024-01-24]
solidworks/Exp Scale Manta Ray/Electronics Sled.SLDASM
50.8 x 40.1 x 177.9 mm
CDMCX525
SWD_breakout.STEP
powerRegBoard
JSTXH6_pin_conn
EXK-02-0028-Slotted
