corelab-umich/kiteCADRepo/solidworks/Exp Scale Manta Ray/EXK-02-0028.SLDASM

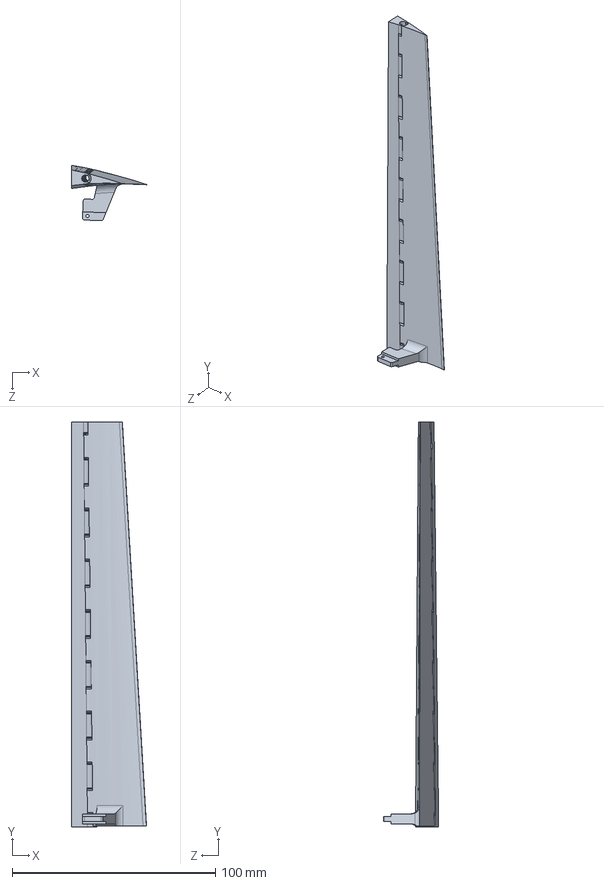
[picture p34: CAD file, 2024-01-24]
solidworks/Exp Scale Manta Ray/EXK-02-0028.SLDASM
37.0 x 199.5 x 27.3 mm
EXK-02-0024 x 2
