corelab-umich/kiteCADRepo/solidworks/Exp Scale Manta Ray/EXK-02-0016.SLDASM

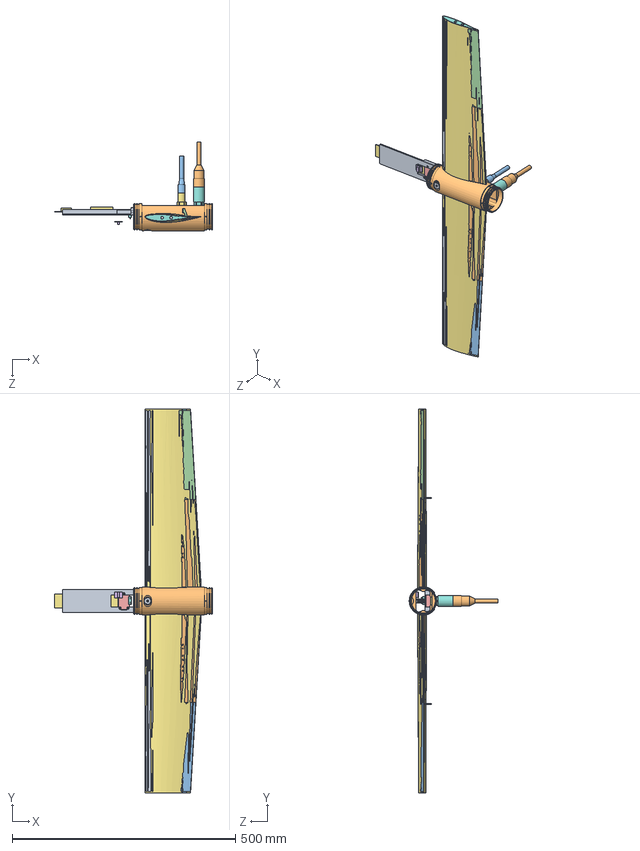
[picture p35: CAD file, 2024-01-24]
solidworks/Exp Scale Manta Ray/EXK-02-0016.SLDASM
354.6 x 860.3 x 198.6 mm
EXK-01-0012
EXK-02-0017
EXK-02-0009-01
EXK-02-0003
EXK-02-0010
SW0250MG x 2
Skin
EXK-02-0009-02
EXK-02-0003-02
EXK-02-0025
EXK-02-0024 x 2
EXK-01-0014
CB6014CR04-1P x 8
MirrorEXK-02-0010
MCBH8-F
MCBH12-F
BAR02
MCIL12M
MCIL8M
MirrorEXK-02-0024 x 2
CDMCX525
SWD_breakout.STEP
powerRegBoard
JSTXH6_pin_conn
EXK-02-0028-Slotted
