corelab-umich/kiteCADRepo/solidworks/Line Angle Sensor/LAS-03-0000.SLDASM

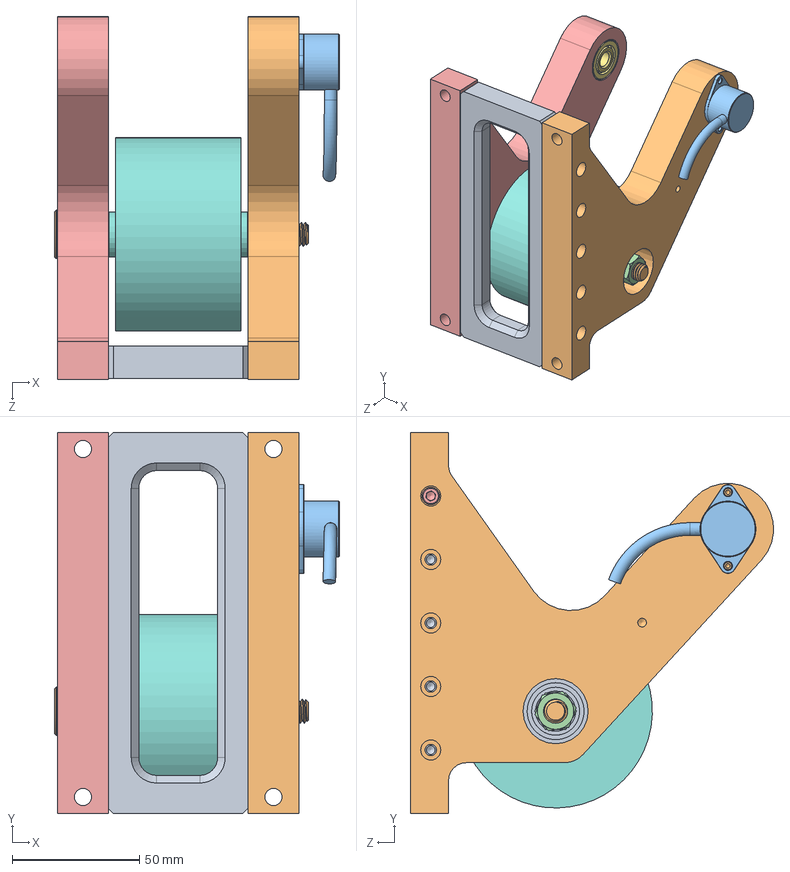
[picture p36: CAD file, 2024-01-24]
solidworks/Line Angle Sensor/LAS-03-0000.SLDASM
112.2 x 150.0 x 143.0 mm
LAS-03-0002
LAS-03-0004
RM22-3D
RMA-shaft8mm
socket head cap screw_ai
dowel pin_ai
5908K310 x 2
LAS-03-0008
4668K150 x 2
97345A732
90792A445 x 7
94805A115 x 2
LAS-03-0005
