corelab-umich/kiteCADRepo/solidworks/Line Angle Sensor/LAS-00-0000.SLDASM

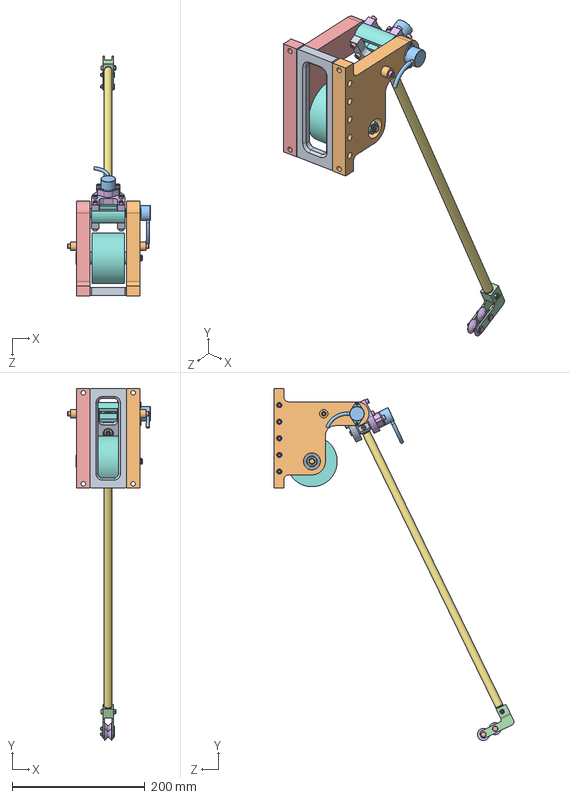
[picture p37: CAD file, 2021-05-12]
solidworks/Line Angle Sensor/LAS-00-0000.SLDASM
124.7 x 529.8 x 361.4 mm
LAS-03-0002
LAS-03-0004
RM22-3D x 2
RMA-shaft8mm x 2
socket head cap screw_ai x 24
dowel pin_ai x 7
5908K310 x 4
LAS-03-0008
4668K150 x 2
97345A732
90792A445 x 7
94805A115 x 2
LAS-03-0005
LAS-02-0002
LAS-01-0012
LAS-01-0010 x 2
LAS-01-0002
97345A104 x 2
90715A005 x 2
LAS-01-0008
92735A120_GROOVED CLEVIS PIN WITH RETAINING RING x 2
LAS-01-0020 x 2
91116A130_TYPE 18-8 STAINLESS STL OVERSIZED FLAT WASHER x 2
LAS-02-0006
LAS-02-0003
92510A724_ALUM UNTHRD SPACER x 2
