corelab-umich/kiteCADRepo/solidworks/Line Angle Sensor/Waterjet.SLDASM

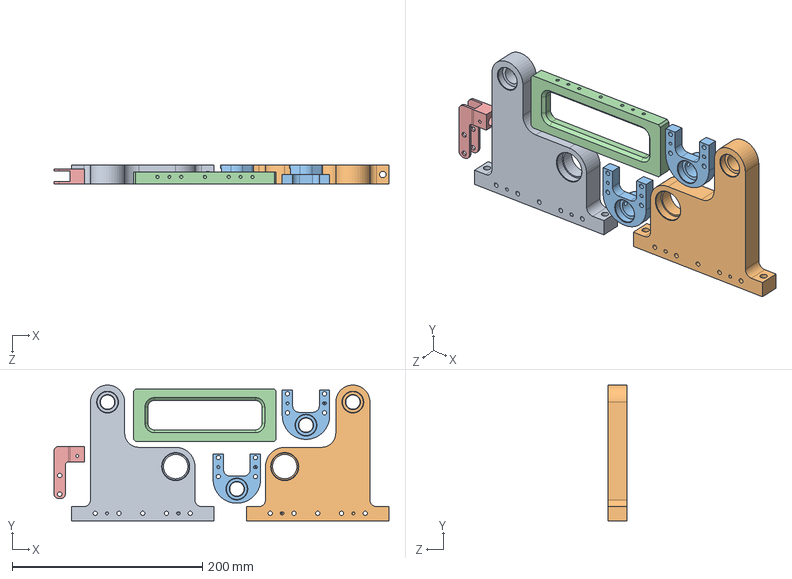
[picture p38: CAD file, 2020-11-17]
solidworks/Line Angle Sensor/Waterjet.SLDASM
352.5 x 142.9 x 20.0 mm
LAS-03-0005
LAS-03-0004
LAS-02-0002 x 2
LAS-03-0002
LAS-01-0008
