corelab-umich/kiteCADRepo/solidworks/Exp Scale Manta Ray/EXK-02-0022.SLDASM

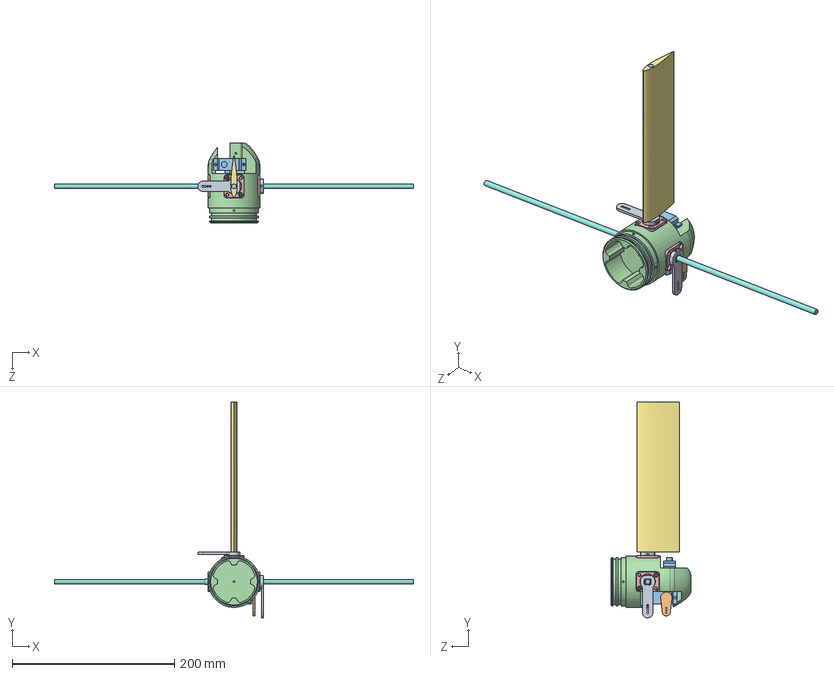
[picture p39: CAD file, 2024-01-24]
solidworks/Exp Scale Manta Ray/EXK-02-0022.SLDASM
442.3 x 265.8 x 98.8 mm
2401K123_ALUMINUM FLEXIBLE SHAFT COUPLING x 2
2401K820_ALUMINUM FLEXIBLE SHAFT COUPLING
SW0250MG x 2
EXK-01-0006
EXK-02-0012 x 3
W_626_2Z x 6
EXK-01-0010
EXK-02-0014 x 3
EXK-02-0013_Metal x 2
ControlAr,
