corelab-umich/kiteCADRepo/solidworks/Line Angle Sensor/LAS-01-0000.SLDASM

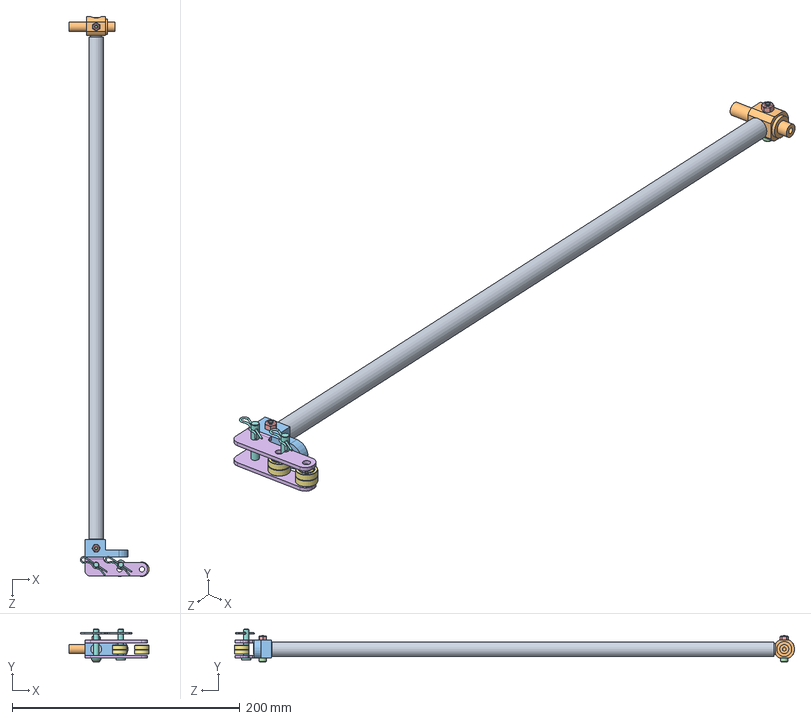
[picture p40: CAD file, 2020-09-30]
solidworks/Line Angle Sensor/LAS-01-0000.SLDASM
70.6 x 28.6 x 492.0 mm
LAS-01-0004
LAS-01-0002
97345A104_316 STAINLESS STEEL SHOULDER SCREW x 2
90715A005_TYPE 316 STAINLESS STEEL NYLON-INSERT LOCKNUT x 2
LAS-01-0008
5908K620_ULTRA-CORROSION-RESISTANT SS BALL BEARING x 4
92401A576_316 STAINLESS STEEL CLEVIS PIN x 2
