corelab-umich/kiteCADRepo/solidworks/Exp Scale Manta Ray/KitePCB.SLDASM

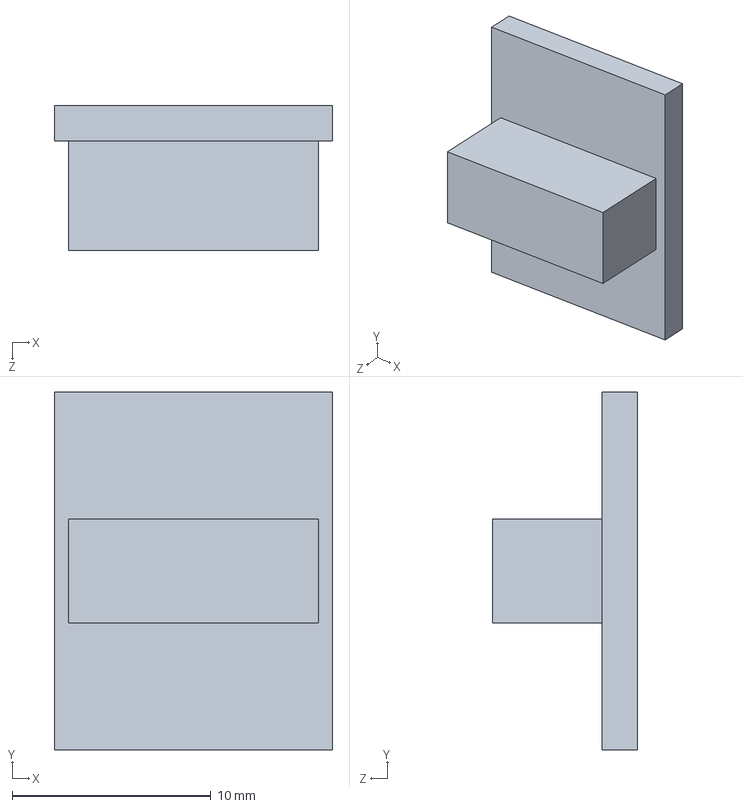
[picture p41: CAD file, 2024-01-24]
solidworks/Exp Scale Manta Ray/KitePCB.SLDASM
14.0 x 18.0 x 7.30 mm
