corelab-umich/kiteCADRepo/solidworks/Line Angle Sensor/Waterjet Layout.SLDASM

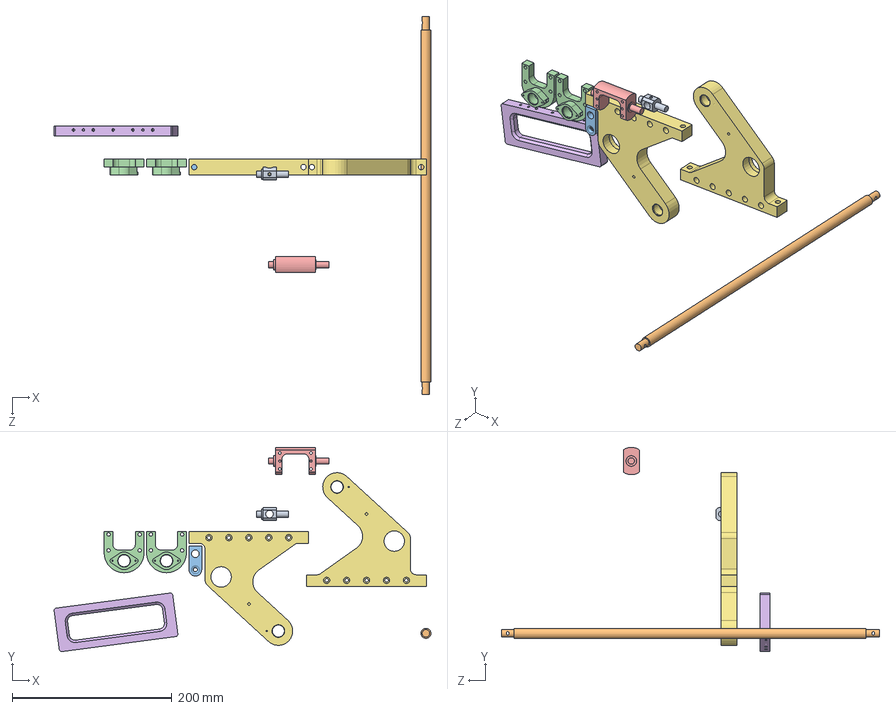
[picture p42: CAD file, 2020-09-30]
solidworks/Line Angle Sensor/Waterjet Layout.SLDASM
472.4 x 256.2 x 474.2 mm
LAS-01-0002
LAS-01-0004
LAS-01-0006
LAS-02-0002 x 2
LAS-02-0006
LAS-03-0002
LAS-03-0004 x 2
