corelab-umich/kiteCADRepo/solidworks/Exp Scale Manta Ray/EXK-02-0018.SLDASM

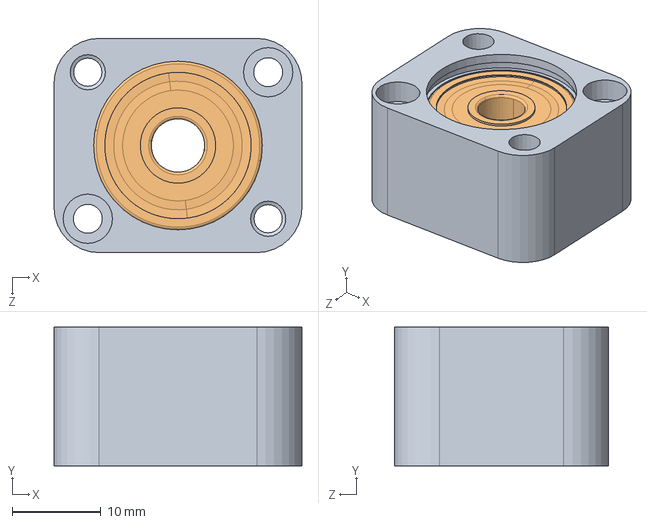
[picture p43: CAD file, 2024-01-24]
solidworks/Exp Scale Manta Ray/EXK-02-0018.SLDASM
27.9 x 15.6 x 24.1 mm
EXK-02-0012
W_626_2Z x 2
