corelab-umich/kiteCADRepo/solidworks/Exp Scale Manta Ray/5.SLDASM

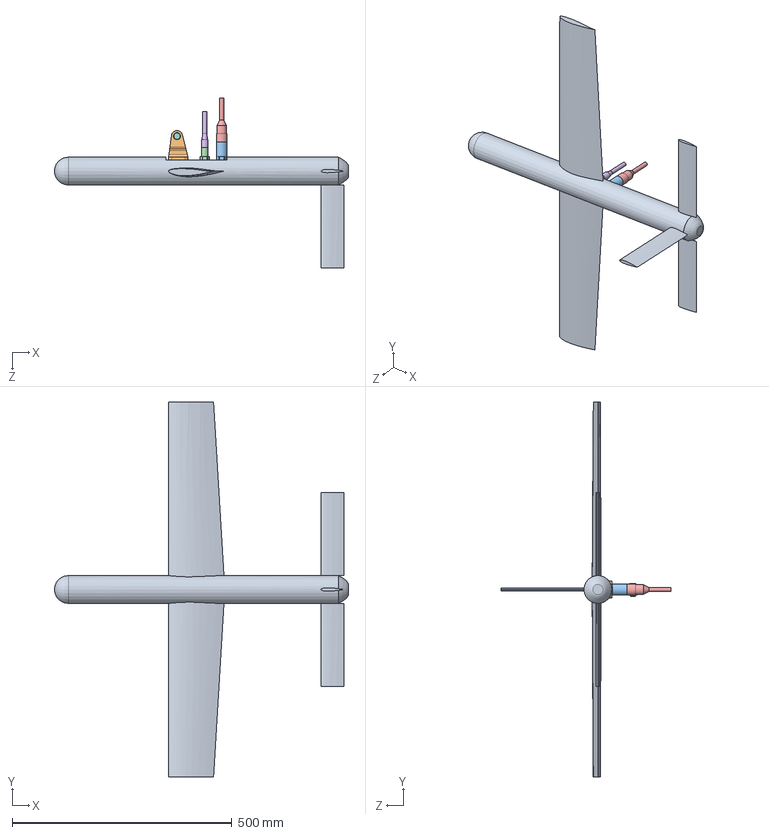
[picture p44: CAD file, 2021-07-02]
solidworks/Exp Scale Manta Ray/5.SLDASM
670.0 x 854.0 x 388.0 mm
Buoyancy Model
Bridle_Compact
MCBH12-F
MCBH8-F
MCIL12M
MCIL8M
92510A817_ALUM UNTHRD SPACER
92735A500_CLEVIS PIN WITH RETAINING RING GROOVE
