corelab-umich/kiteCADRepo/solidworks/Exp Scale Manta Ray/PCB-Step.SLDASM

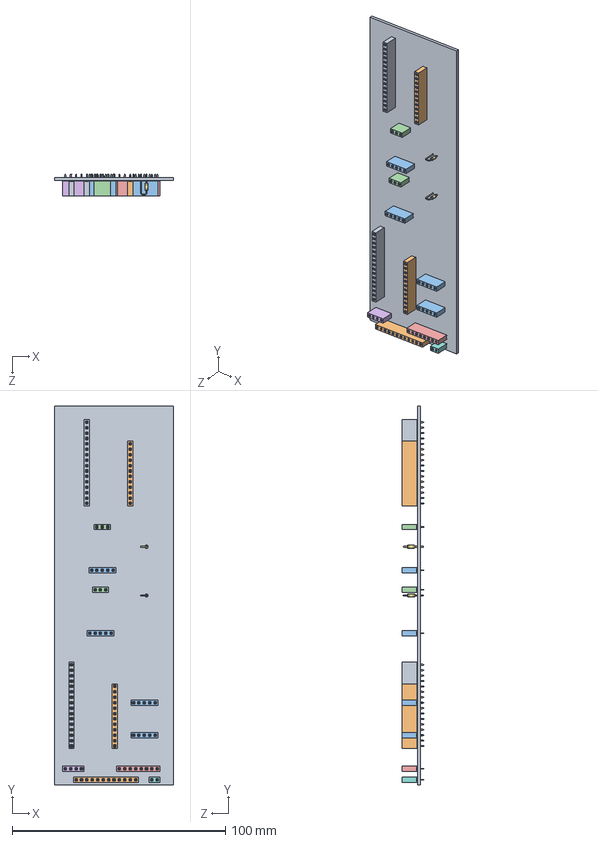
[picture p45: CAD file, 2021-07-02]
solidworks/Exp Scale Manta Ray/PCB-Step.SLDASM
55.9 x 177.8 x 10.1 mm
SOLID.step x 2
SOLID-0.step x 3
SOLID-1.step x 4
SOLID-2.step x 2
SOLID-3.step
SOLID-4.step
SOLID-5.step x 2
SOLID-6.step
COMPOUND.step
