corelab-umich/kiteCADRepo/solidworks/Pool Tow Testing - Full Scale/Tow System/_Tow System Assy V1.1.SLDASM

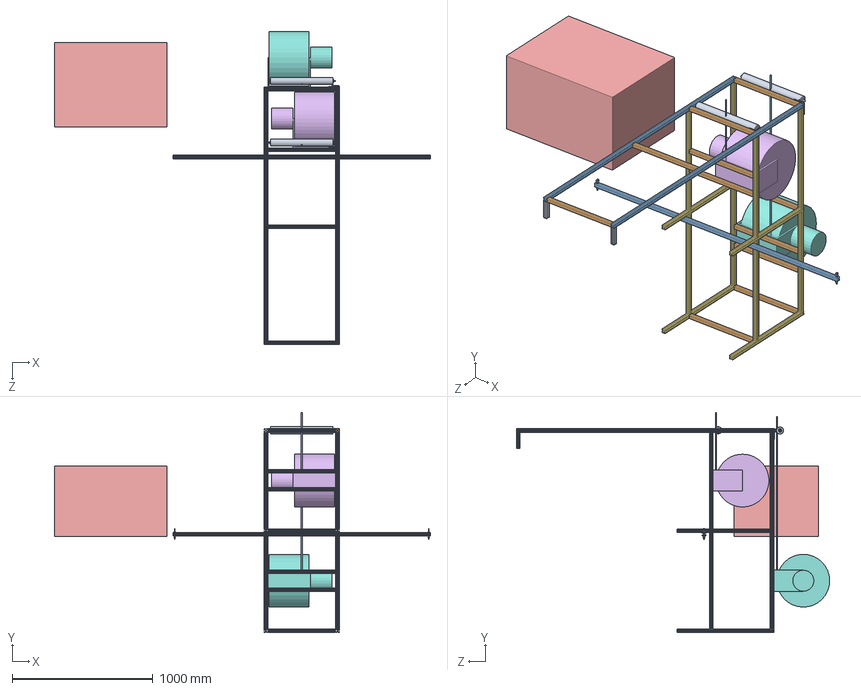
[picture p46: CAD file, 2020-10-30]
solidworks/Pool Tow Testing - Full Scale/Tow System/_Tow System Assy V1.1.SLDASM
2670.4 x 1563.3 x 2226.3 mm
8020 -1inch - 0 ft 4.5 in x 2
8020 -1inch - 1 ft 7 in x 12
8020 -1inch - 6 feet with guide line holes x 3
1.5 inch lifting eye x 2
Tow Winch Size Requirement
Blue Robotics Spool - Tow
8020 -1inch - 2 ft 3 in x 12
Blue Robotics Spool - Kite
2 inch roller x 2
L Bracket
1 inch x 2 inch L bracket x 2
