corelab-umich/kiteCADRepo/solidworks/Exp Scale Manta Ray/EXK-02-0030.SLDASM

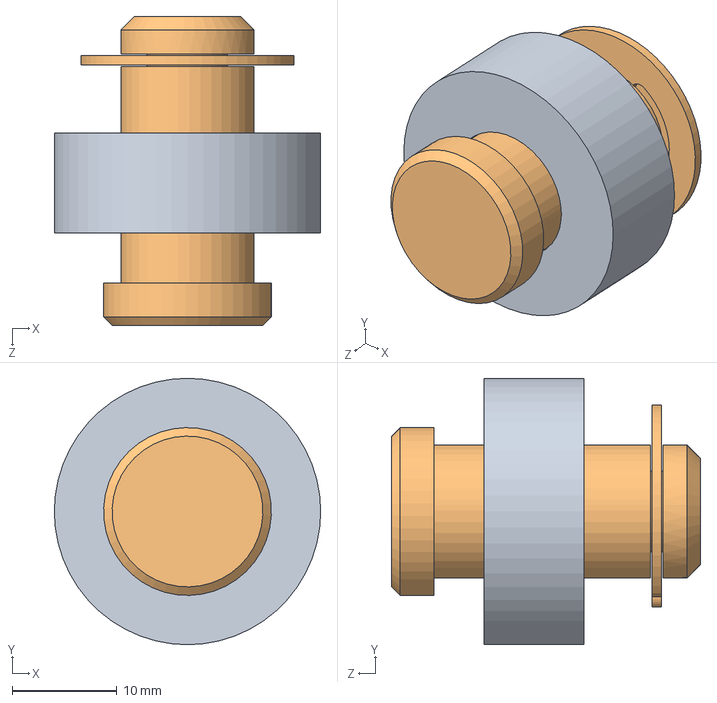
[picture p47: CAD file, 2021-05-12]
solidworks/Exp Scale Manta Ray/EXK-02-0030.SLDASM
25.4 x 25.4 x 29.5 mm
92510A817_ALUM UNTHRD SPACER
92735A500_CLEVIS PIN WITH RETAINING RING GROOVE
