corelab-umich/kiteCADRepo/solidworks/Exp Scale Manta Ray/Assem2.SLDASM

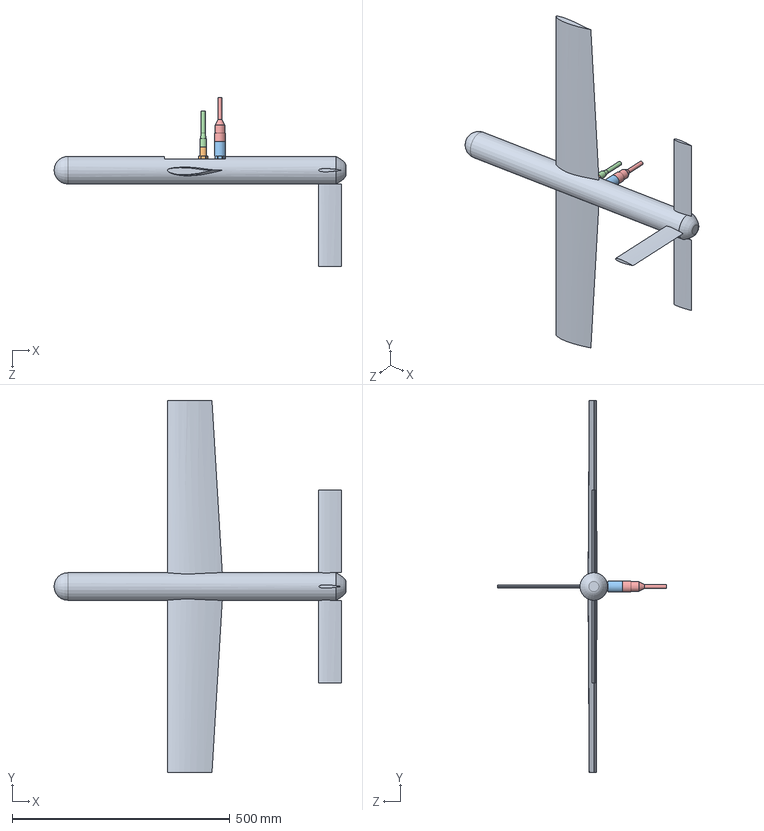
[picture p48: CAD file, 2021-05-12]
solidworks/Exp Scale Manta Ray/Assem2.SLDASM
670.0 x 854.0 x 388.0 mm
Buoyancy Model
MCBH8-F
MCBH12-F
MCIL8M
MCIL12M
