corelab-umich/kiteCADRepo/solidworks/Exp Scale Manta Ray/Assem3.SLDASM

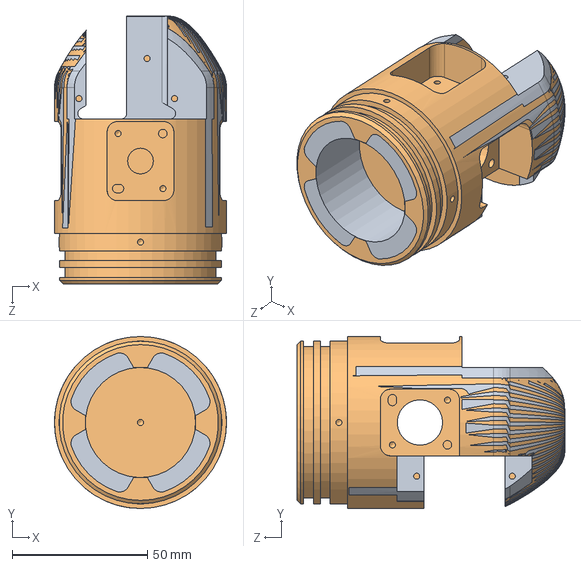
[picture p49: CAD file, 2021-05-12]
solidworks/Exp Scale Manta Ray/Assem3.SLDASM
63.5 x 63.5 x 98.8 mm
EXK-01-0006_R-
EXK-01-0006
