corelab-umich/kiteCADRepo/solidworks/Exp Scale Manta Ray/Assem4.SLDASM

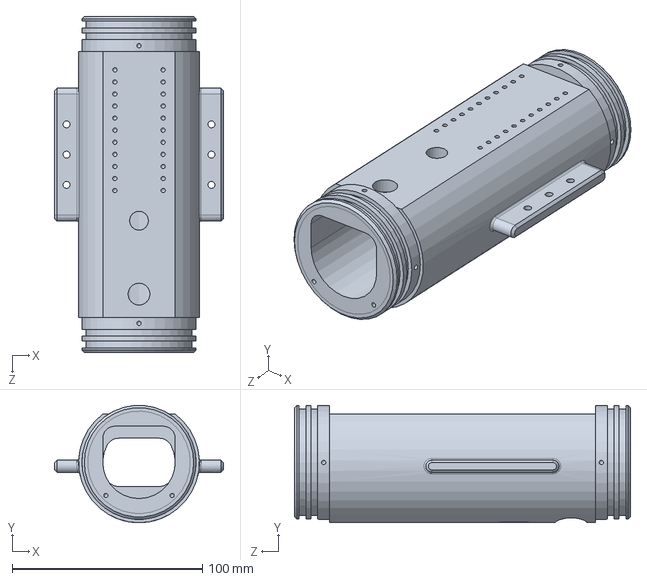
[picture p50: CAD file, 2021-05-12]
solidworks/Exp Scale Manta Ray/Assem4.SLDASM
88.9 x 61.8 x 176.8 mm
EXK-02-0017 x 2
