corelab-umich/kiteCADRepo/solidworks/Exp Scale Manta Ray/EXK-00-0000.SLDASM

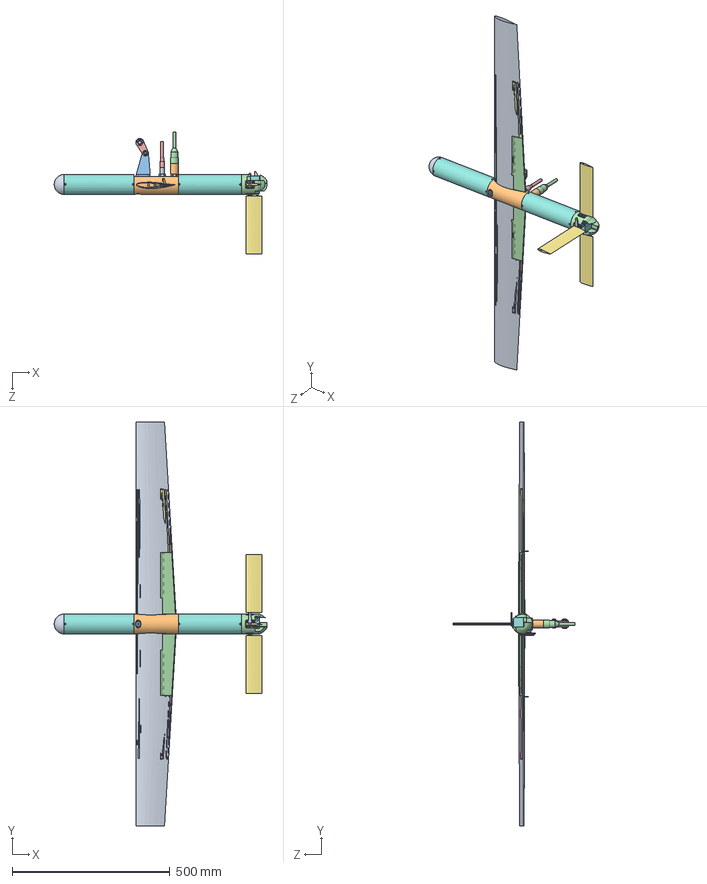
[picture p51: CAD file, 2021-03-09]
solidworks/Exp Scale Manta Ray/EXK-00-0000.SLDASM
674.1 x 1281.0 x 388.0 mm
EXK-01-0012
EXK-02-0017
93615A216_TYPE 18-8 SS LOW PROFILE SOCKET CAP SCREW x 3
EXK-02-0009-01
EXK-02-0003
90145A508_18-8 STAINLESS STEEL DOWEL PIN
EXK-02-0010
SW0250MG x 4
EXK-02-0009-02
EXK-02-0003-02
EXK-02-0025
EXK-02-0024 x 2
EXK-01-0014
CB6014CR04-1P x 8
MirrorEXK-02-0010
MCBH8-F
MCBH12-F
BAR02
MCIL12M
MCIL8M
EXK-02-0028
MirrorEXK-02-0024 x 2
EXK-01-0008
EXK-01-0002
2401K123_ALUMINUM FLEXIBLE SHAFT COUPLING x 2
2401K820_ALUMINUM FLEXIBLE SHAFT COUPLING
EXK-01-0006
EXK-02-0012 x 3
W_626_2Z x 6
EXK-01-0010 x 3
EXK-02-0014 x 3
EXK-02-0013 x 2
EXK-02-0015
92510A817_ALUM UNTHRD SPACER
EXK-01-0016
92735A500_CLEVIS PIN WITH RETAINING RING GROOVE
2867T470_CORROSION-RESISTANT SLEEVE BEARING x 2
92735A430_GROOVED CLEVIS PIN WITH RETAINING RING
SOLID.step x 2
SOLID-0.step x 3
SOLID-1.step x 4
SOLID-2.step x 2
SOLID-3.step
SOLID-4.step
SOLID-5.step x 2
SOLID-6.step
COMPOUND.step
