corelab-umich/kiteCADRepo/solidworks/Exp Scale Manta Ray/NCSU h-Stab Assy.STEP

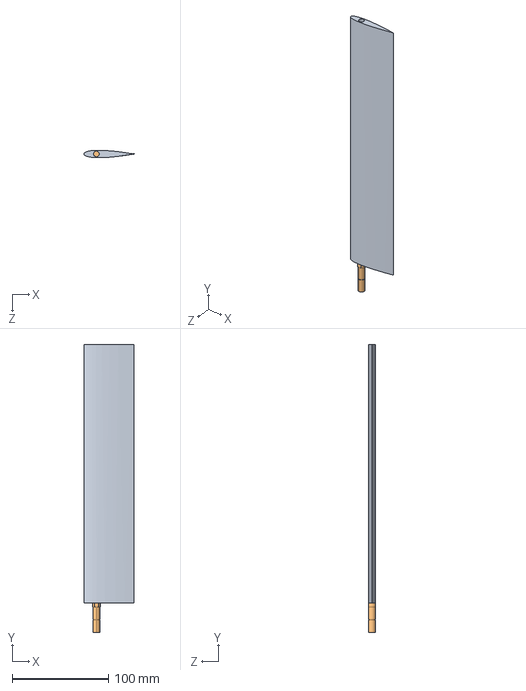
[picture p52: CAD file, 2021-02-04]
solidworks/Exp Scale Manta Ray/NCSU h-Stab Assy.STEP
52.0 x 298.7 x 7.68 mm
EXK-01-0010
EXK-02-0014_hStab1
