corelab-umich/kiteCADRepo/solidworks/Exp Scale Manta Ray/NCSU v-Stab Assy.STEP

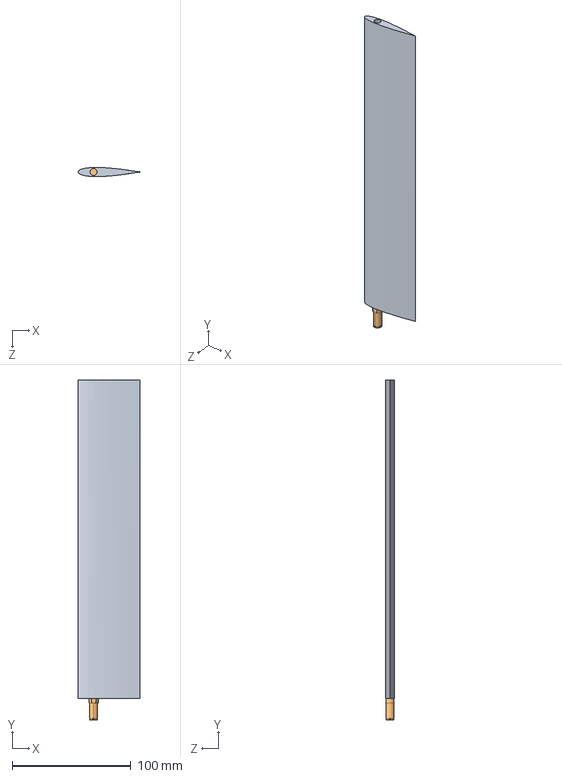
[picture p53: CAD file, 2021-02-04]
solidworks/Exp Scale Manta Ray/NCSU v-Stab Assy.STEP
52.0 x 286.3 x 7.72 mm
EXK-01-0010
EXK-02-0014_vStab
