corelab-umich/kiteCADRepo/solidworks/Exp Scale Manta Ray/EXK-02-0021.SLDASM

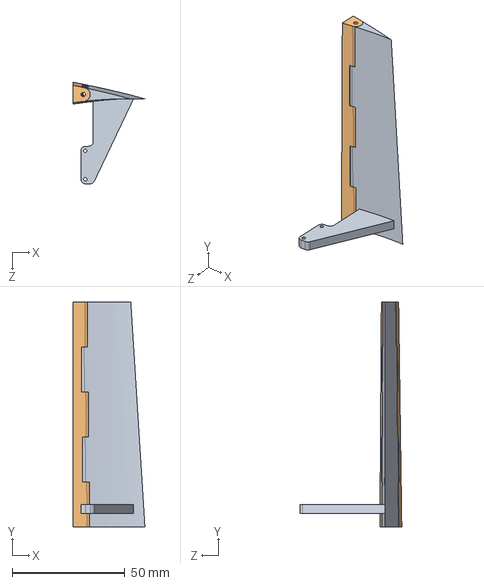
[picture p54: CAD file, 2021-01-22]
solidworks/Exp Scale Manta Ray/EXK-02-0021.SLDASM
32.0 x 100.0 x 45.2 mm
EXK-02-0005
EXK-02-0006
