corelab-umich/kiteCADRepo/solidworks/Exp Scale Manta Ray/Stabilizer Actuated Assembly.SLDASM

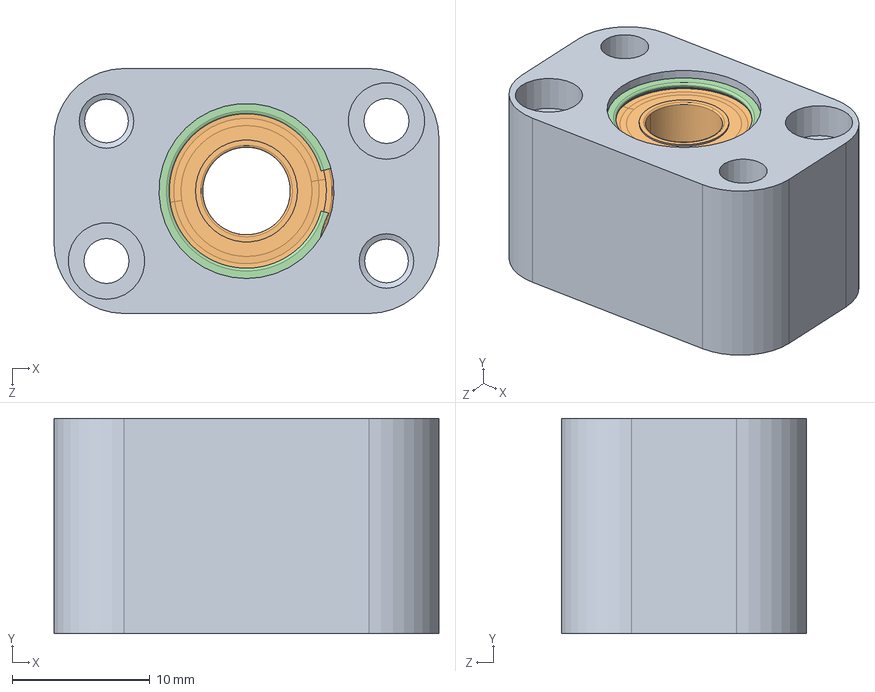
[picture p55: CAD file, 2021-01-22]
solidworks/Exp Scale Manta Ray/Stabilizer Actuated Assembly.SLDASM
27.9 x 15.6 x 17.8 mm
EXK-02-0012
D_W_R188_2RS1 x 2
91182A604_TYPE 316 STAINLESS STEEL SHIM FOR BEARINGS x 7
92479A730_EASY INSTALL SPIRAL INTERNAL RETAINING RING
