corelab-umich/kiteCADRepo/solidworks/Exp Scale Manta Ray/Stabilizer.SLDASM

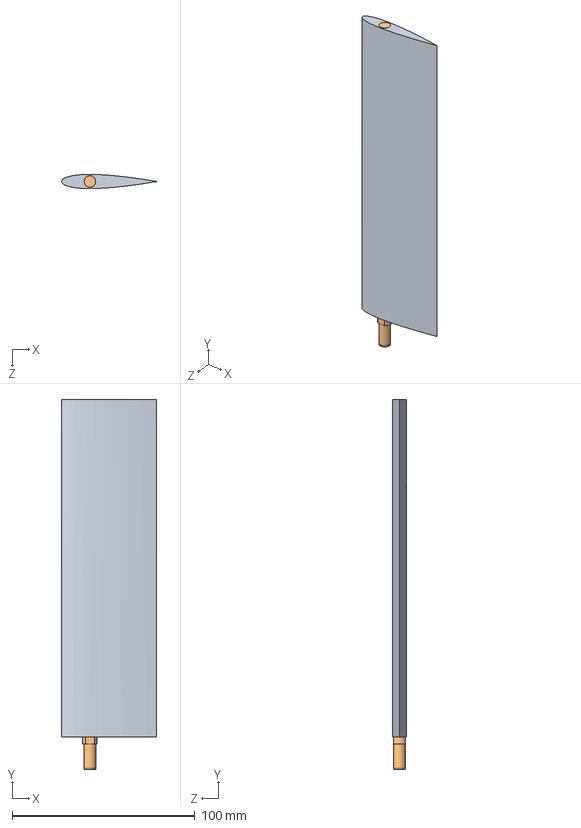
[picture p56: CAD file, 2021-01-22]
solidworks/Exp Scale Manta Ray/Stabilizer.SLDASM
52.0 x 202.7 x 7.79 mm
MRvStab_FS
EXK-02-0014
