corelab-umich/kiteCADRepo/solidworks/Exp Scale Manta Ray/Tail Boom.SLDASM

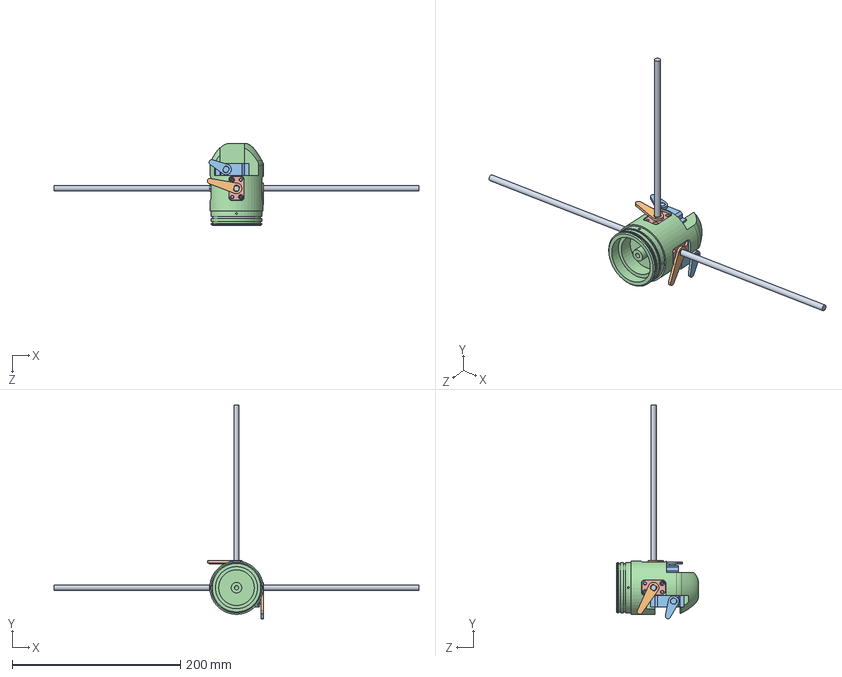
[picture p57: CAD file, 2021-01-22]
solidworks/Exp Scale Manta Ray/Tail Boom.SLDASM
434.1 x 254.1 x 97.7 mm
2401K123_ALUMINUM FLEXIBLE SHAFT COUPLING x 2
2401K820_ALUMINUM FLEXIBLE SHAFT COUPLING
SW0250MG x 2
EXK-01-0006
EXK-02-0012 x 3
D_W_R188_2RS1 x 6
91182A604_TYPE 316 STAINLESS STEEL SHIM FOR BEARINGS x 21
92479A730_EASY INSTALL SPIRAL INTERNAL RETAINING RING x 3
EXK-02-0014 x 3
EXK-02-0013 x 2
EXK-02-0015 x 2
