corelab-umich/kiteCADRepo/solidworks/Exp Scale Manta Ray/EXK-02-0008-ASY.SLDASM

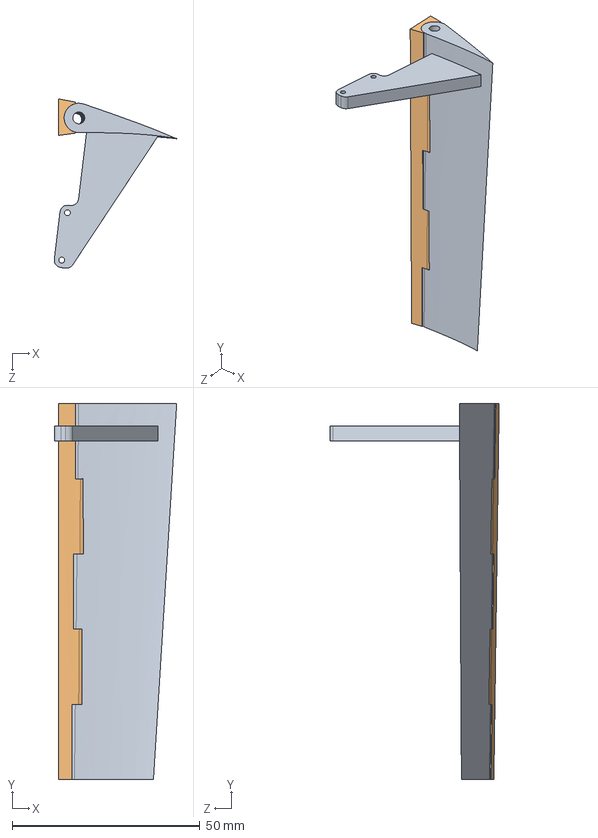
[picture p58: CAD file, 2021-01-22]
solidworks/Exp Scale Manta Ray/EXK-02-0008-ASY.SLDASM
32.6 x 100.0 x 45.1 mm
EXK-02-0005-01
EXK-02-0006-01
