corelab-umich/kiteCADRepo/solidworks/Exp Scale Manta Ray/MRkiteAssemblyWithProp_FS.STEP

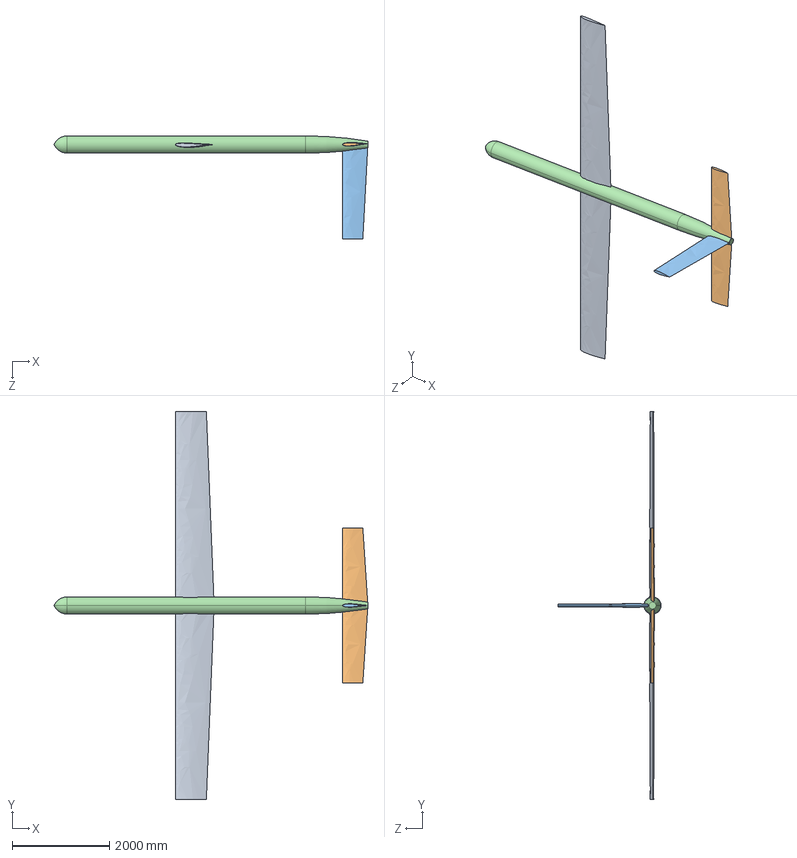
[picture p59: CAD file, 2020-09-25]
solidworks/Exp Scale Manta Ray/MRkiteAssemblyWithProp_FS.STEP
6470.0 x 8000.0 x 2127.8 mm
MRwing_FS
MRhStab_FS
MRvStab_FS
MRfuselageWithProp_FS
