corelab-umich/kiteCADRepo/solidworks/Exp Scale Manta Ray/MRkiteAssembly4Turb_FS.STEP

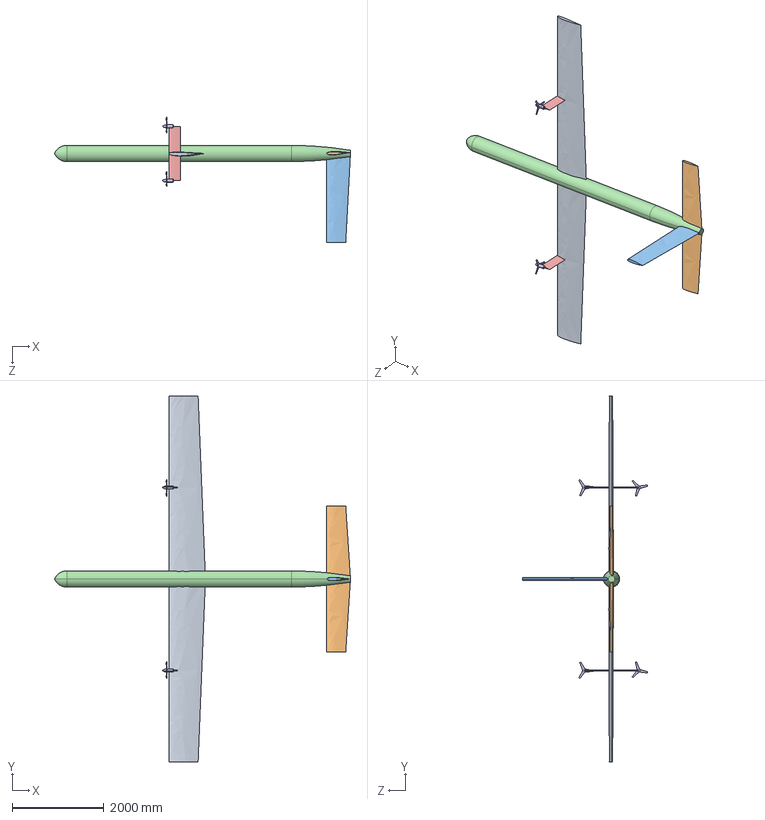
[picture p60: CAD file, 2020-09-25]
solidworks/Exp Scale Manta Ray/MRkiteAssembly4Turb_FS.STEP
6470.0 x 8000.0 x 2740.8 mm
MRwing_FS
MRhStab_FS
MRvStab_FS
MRfuselageWithProp_FS
MRturb_FS x 2
MRturbblade_FS x 4
