corelab-umich/kiteCADRepo/solidworks/Boat_w_A_Frame/A-Frame.SLDPRT

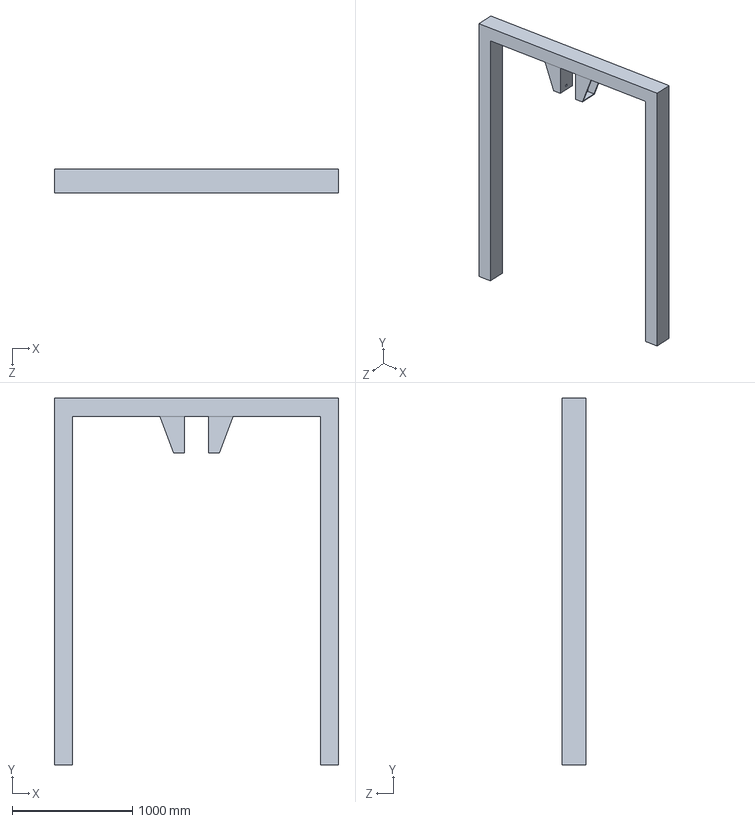
[picture p61: CAD file, 2024-01-24]
solidworks/Boat_w_A_Frame/A-Frame.SLDPRT
2362.2 x 3048.0 x 203.2 mm
