corelab-umich/kiteCADRepo/solidworks/Exp Scale Manta Ray/ForMariah060421/Kite Stand.SLDPRT

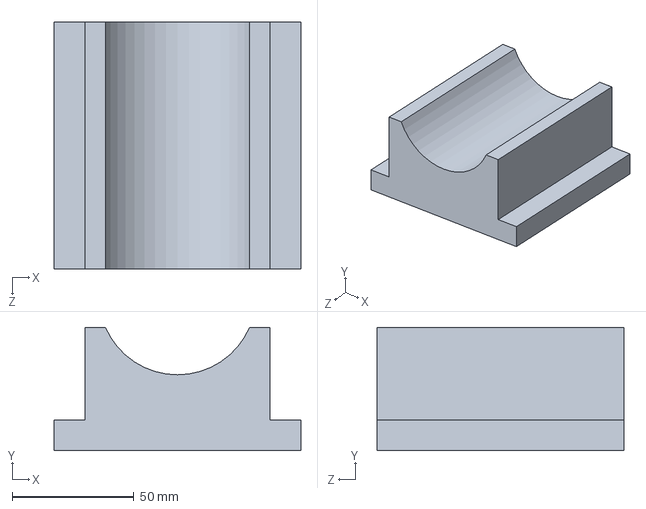
[picture p62: CAD file, 2021-07-02]
solidworks/Exp Scale Manta Ray/ForMariah060421/Kite Stand.SLDPRT
101.6 x 50.8 x 101.6 mm
