corelab-umich/kiteCADRepo/solidworks/Exp Scale Manta Ray/ForMariah061121/EXK-02-0024-STBDH3.STL

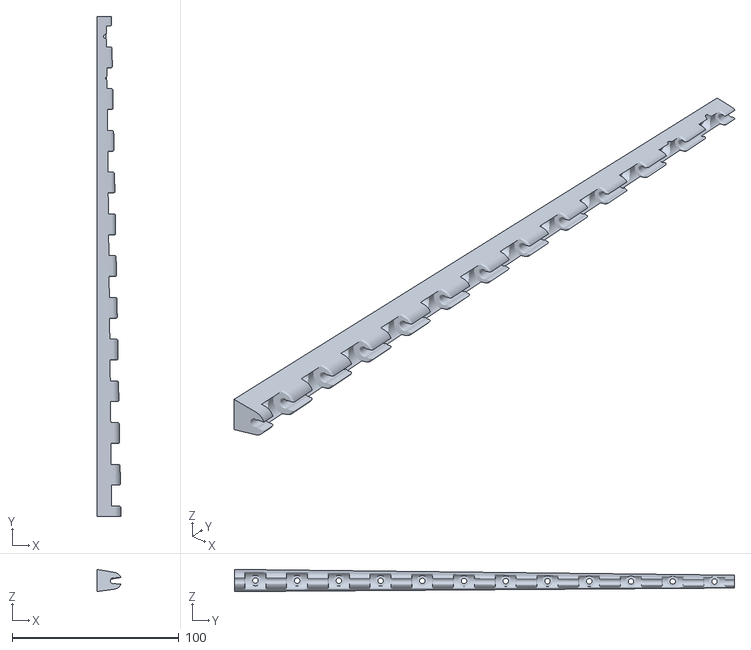
[picture p63: CAD file, 2021-07-02]
solidworks/Exp Scale Manta Ray/ForMariah061121/EXK-02-0024-STBDH3.STL
14.5 x 299.5 x 13.3
