corelab-umich/kiteCADRepo/solidworks/Exp Scale Manta Ray/JSTXH6_pin_conn.SLDPRT

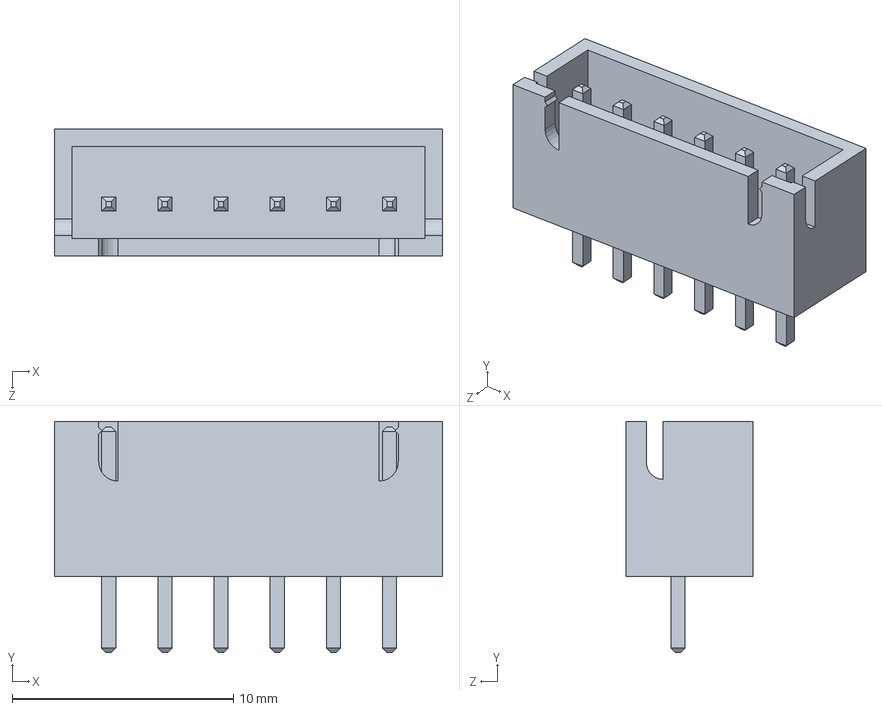
[picture p64: CAD file, 2024-01-24]
solidworks/Exp Scale Manta Ray/JSTXH6_pin_conn.SLDPRT
17.5 x 10.4 x 5.75 mm
