corelab-umich/kiteCADRepo/solidworks/Exp Scale Manta Ray/Vendor Parts/ADAFRUIT/Huzzah32ESP32Feather.SLDPRT

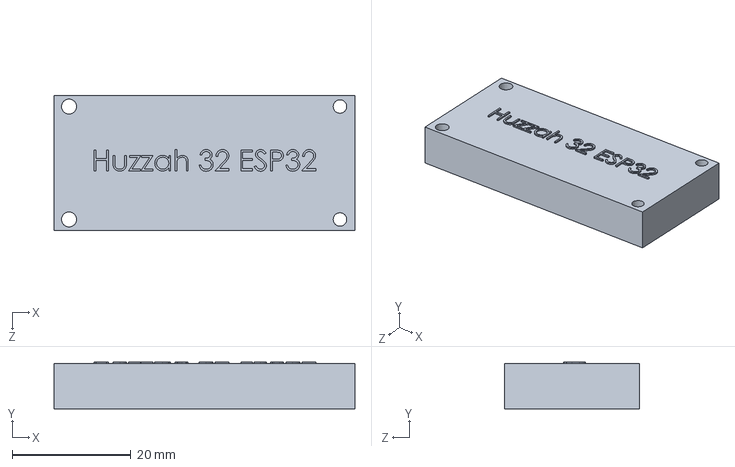
[picture p65: CAD file, 2020-10-19]
solidworks/Exp Scale Manta Ray/Vendor Parts/ADAFRUIT/Huzzah32ESP32Feather.SLDPRT
50.8 x 7.87 x 22.9 mm
