corelab-umich/kiteCADRepo/solidworks/Exp Scale Manta Ray/Vendor Parts/Arduino/Nano-New1.SLDPRT

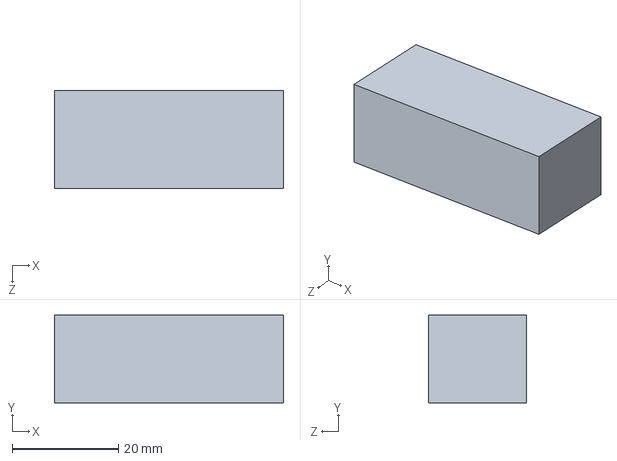
[picture p66: CAD file, 2020-12-16]
solidworks/Exp Scale Manta Ray/Vendor Parts/Arduino/Nano-New1.SLDPRT
43.2 x 16.5 x 18.5 mm
