corelab-umich/kiteCADRepo/solidworks/Exp Scale Manta Ray/Vendor Parts/Bosch/BNO055.SLDPRT

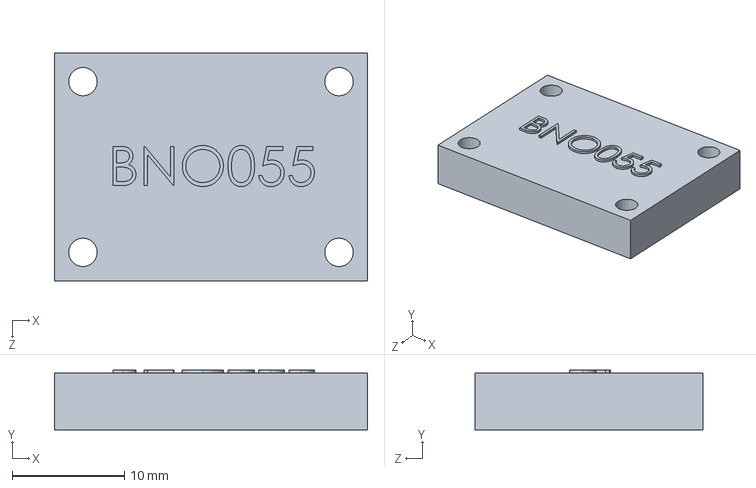
[picture p67: CAD file, 2020-10-19]
solidworks/Exp Scale Manta Ray/Vendor Parts/Bosch/BNO055.SLDPRT
27.9 x 5.33 x 20.3 mm
