corelab-umich/kiteCADRepo/solidworks/Exp Scale Manta Ray/Vendor Parts/CB6014CR04-1P.SLDPRT

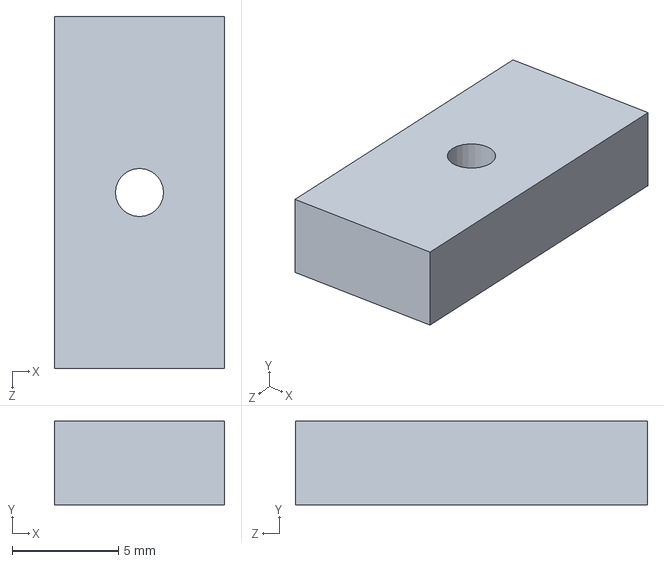
[picture p68: CAD file, 2024-01-24]
solidworks/Exp Scale Manta Ray/Vendor Parts/CB6014CR04-1P.SLDPRT
8.00 x 3.94 x 16.5 mm
