corelab-umich/kiteCADRepo/solidworks/Exp Scale Manta Ray/Vendor Parts/ECOPOWER/640T.SLDPRT

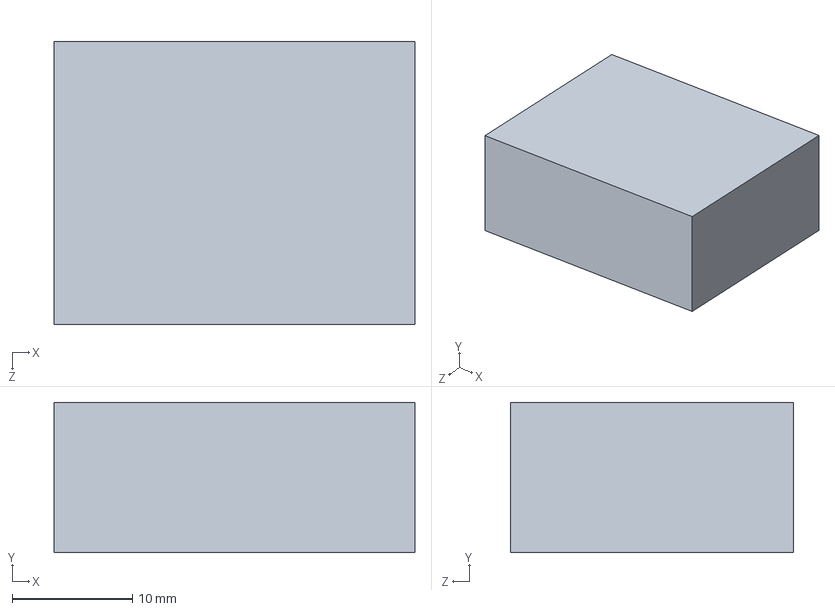
[picture p69: CAD file, 2020-12-16]
solidworks/Exp Scale Manta Ray/Vendor Parts/ECOPOWER/640T.SLDPRT
30.0 x 12.5 x 23.5 mm
