corelab-umich/kiteCADRepo/solidworks/Exp Scale Manta Ray/Vendor Parts/Hi-Tec/HS-5086WP_bottom.SLDPRT

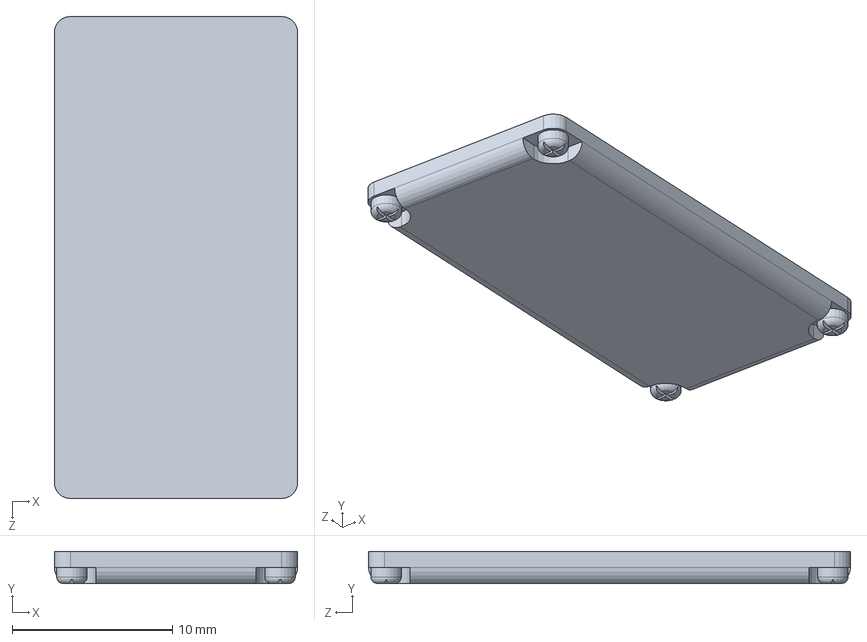
[picture p70: CAD file, 2020-12-30]
solidworks/Exp Scale Manta Ray/Vendor Parts/Hi-Tec/HS-5086WP_bottom.SLDPRT
15.2 x 2.00 x 30.1 mm
