corelab-umich/kiteCADRepo/solidworks/Exp Scale Manta Ray/Vendor Parts/Lord/CDMCX525.SLDPRT

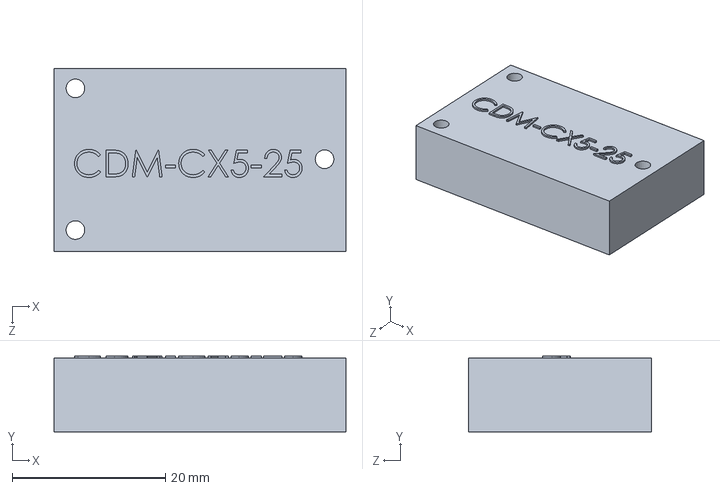
[picture p71: CAD file, 2020-10-19]
solidworks/Exp Scale Manta Ray/Vendor Parts/Lord/CDMCX525.SLDPRT
38.1 x 9.91 x 23.9 mm
