corelab-umich/kiteCADRepo/solidworks/Exp Scale Manta Ray/Vendor Parts/Savox/SW1250MG.SLDPRT

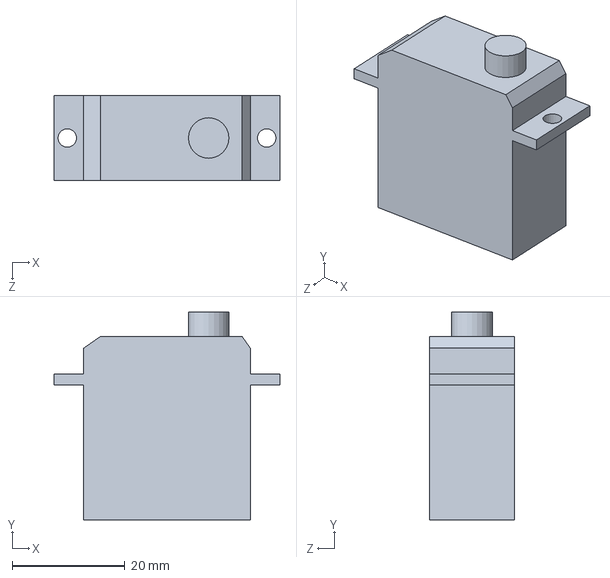
[picture p72: CAD file, 2021-04-08]
solidworks/Exp Scale Manta Ray/Vendor Parts/Savox/SW1250MG.SLDPRT
40.0 x 36.8 x 15.0 mm
