corelab-umich/kiteCADRepo/solidworks/Exp Scale Manta Ray/Vendor Parts/SKF/W_626_2Z.SLDPRT

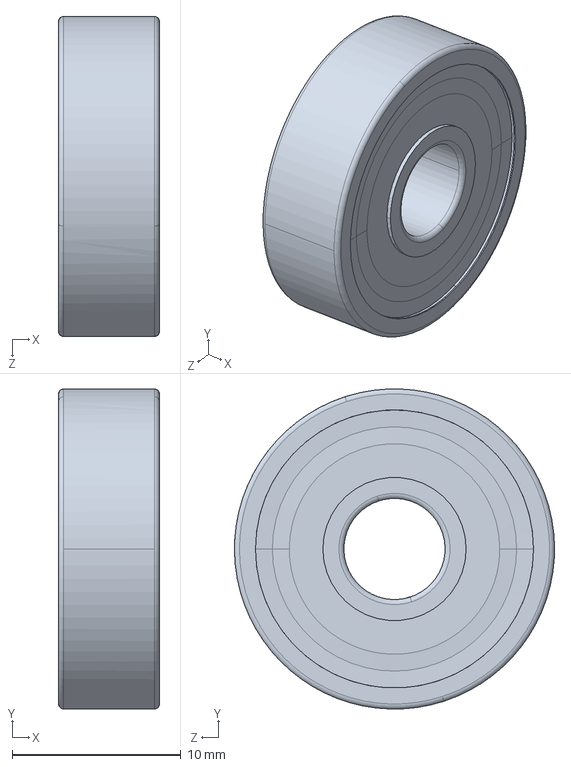
[picture p73: CAD file, 2024-01-24]
solidworks/Exp Scale Manta Ray/Vendor Parts/SKF/W_626_2Z.SLDPRT
6.00 x 19.0 x 19.0 mm
