corelab-umich/kiteCADRepo/solidworks/Exp Scale Manta Ray/Vendor Parts/SparkFun/UARTRS485Breakout.SLDPRT

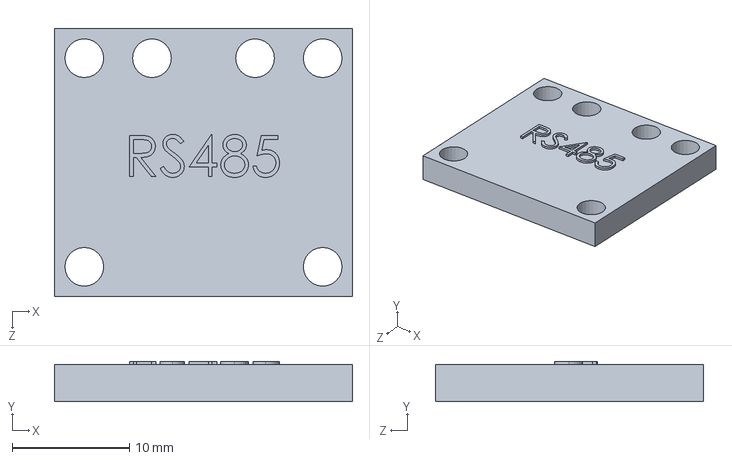
[picture p74: CAD file, 2020-10-19]
solidworks/Exp Scale Manta Ray/Vendor Parts/SparkFun/UARTRS485Breakout.SLDPRT
25.4 x 3.43 x 22.9 mm
