corelab-umich/kiteCADRepo/solidworks/Exp Scale Manta Ray/Vendor Parts/TE CONNECTIVITY/MCBH12-F.SLDPRT

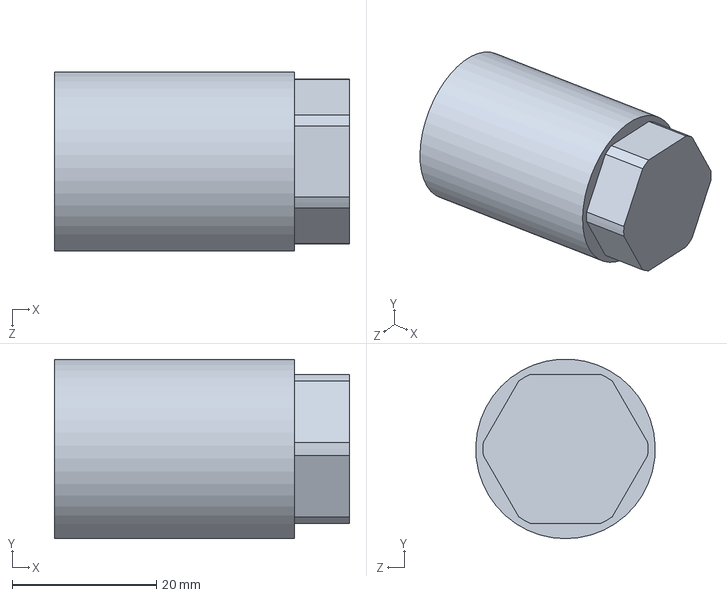
[picture p75: CAD file, 2024-01-24]
solidworks/Exp Scale Manta Ray/Vendor Parts/TE CONNECTIVITY/MCBH12-F.SLDPRT
40.9 x 24.9 x 24.9 mm
