corelab-umich/kiteCADRepo/solidworks/fuselage_FS.SLDPRT

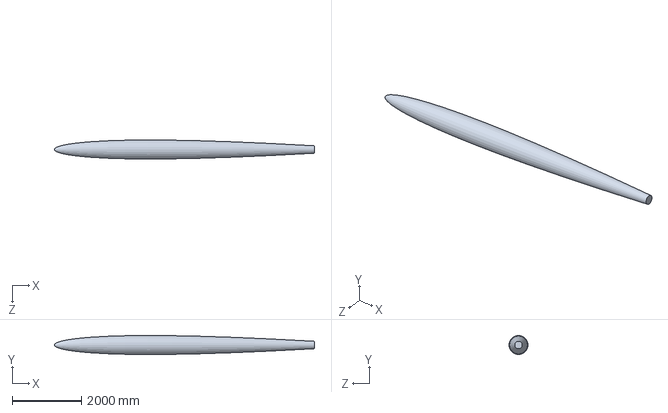
[picture p76: CAD file, 2024-01-24]
solidworks/fuselage_FS.SLDPRT
7503.0 x 549.0 x 549.0 mm
