corelab-umich/kiteCADRepo/solidworks/Line Angle Sensor/For_Steve/LAS-03-0005.SLDPRT

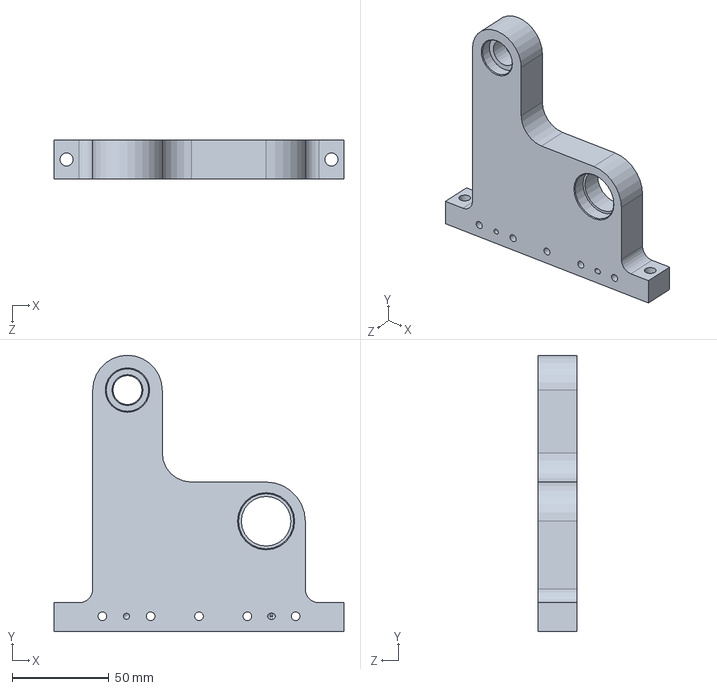
[picture p77: CAD file, 2020-11-17]
solidworks/Line Angle Sensor/For_Steve/LAS-03-0005.SLDPRT
150.0 x 143.0 x 20.0 mm
