corelab-umich/kiteCADRepo/solidworks/Line Angle Sensor/Released Prints/LAS-02-0006.step

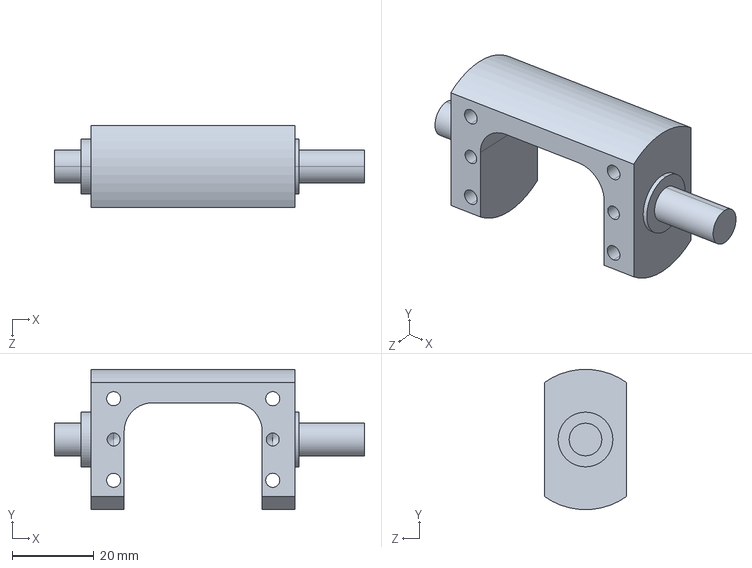
[picture p79: CAD file, 2020-09-30]
solidworks/Line Angle Sensor/Released Prints/LAS-02-0006.step
76.0 x 34.4 x 20.0 mm
