corelab-umich/kiteCADRepo/solidworks/Line Angle Sensor/Vendor Products/Renishaw/RM22-3D.SLDPRT

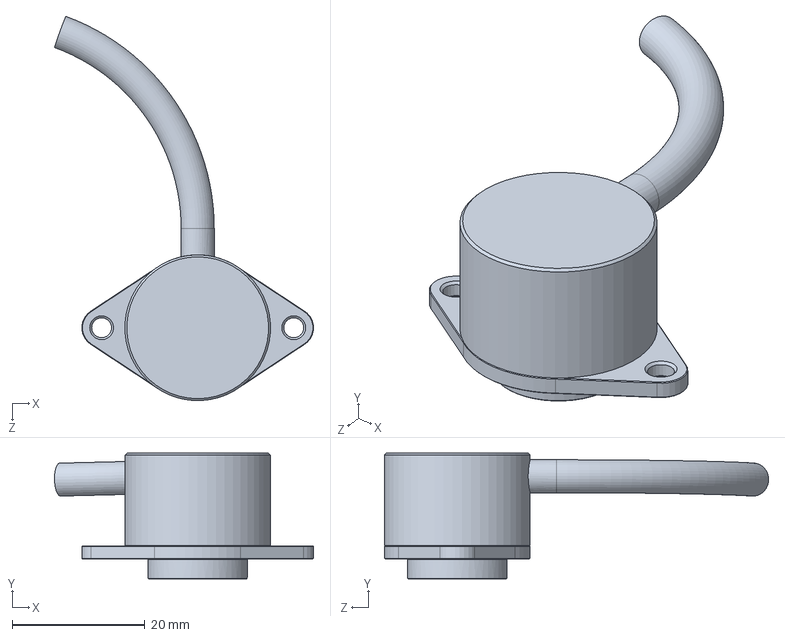
[picture p80: CAD file, 2024-01-24]
solidworks/Line Angle Sensor/Vendor Products/Renishaw/RM22-3D.SLDPRT
39.1 x 19.0 x 58.0 mm
