corelab-umich/kiteCADRepo/solidworks/MantaRay/MRwing_FS.SLDPRT

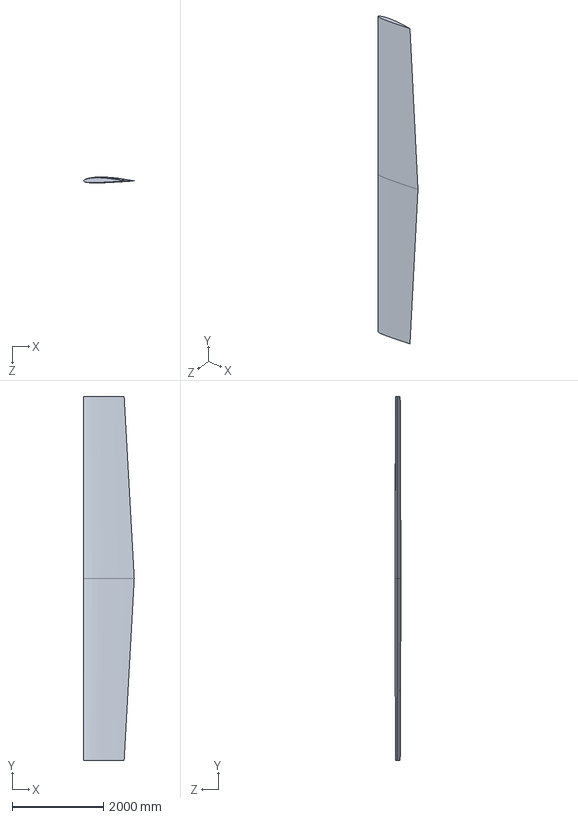
[picture p81: CAD file, 2021-01-22]
solidworks/MantaRay/MRwing_FS.SLDPRT
1111.2 x 7999.9 x 132.9 mm
