corelab-umich/kiteCADRepo/solidworks/Pool Tow Testing - Full Scale/Pool Full Scale Layout/Kite Tether Midsection.SLDPRT

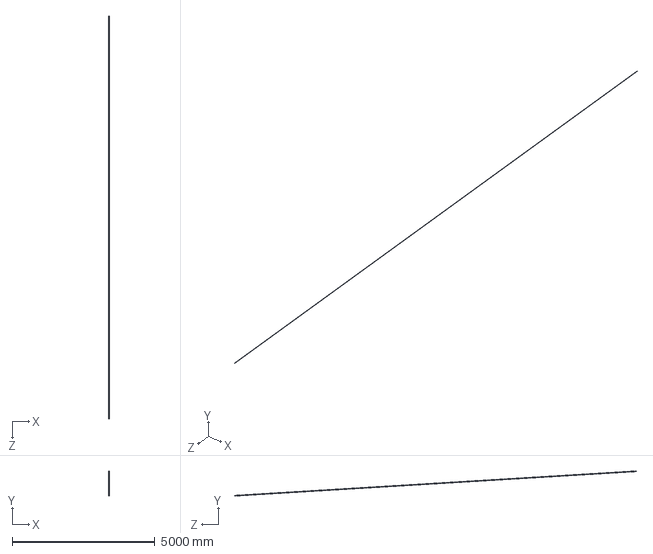
[picture p82: CAD file, 2020-10-30]
solidworks/Pool Tow Testing - Full Scale/Pool Full Scale Layout/Kite Tether Midsection.SLDPRT
7.60 x 865.2 x 14101.6 mm
