corelab-umich/kiteCADRepo/solidworks/Pool Tow Testing - Full Scale/Raft/Tether thru redirect and LAS Placeholder.SLDPRT

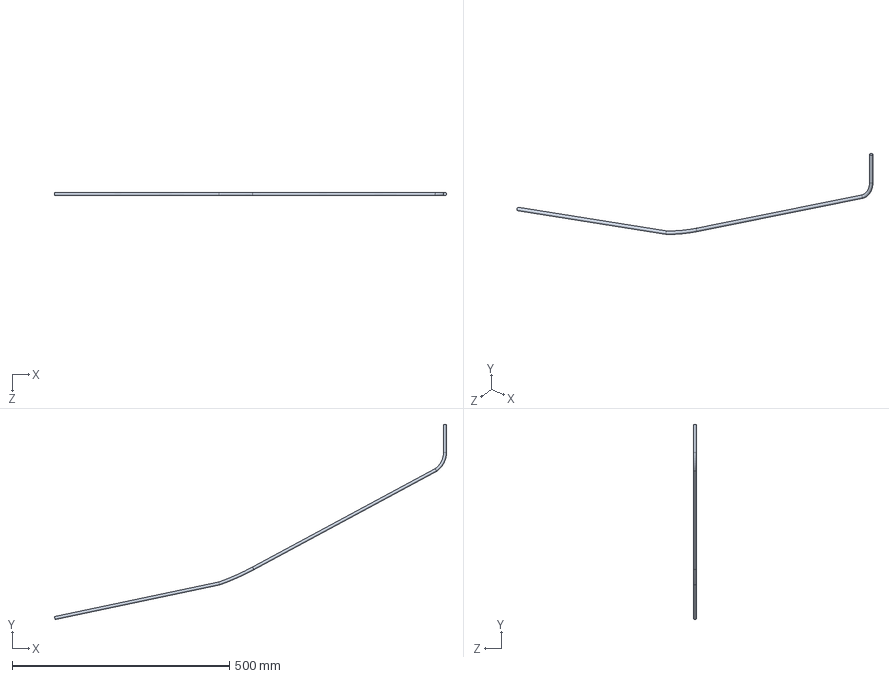
[picture p83: CAD file, 2024-01-24]
solidworks/Pool Tow Testing - Full Scale/Raft/Tether thru redirect and LAS Placeholder.SLDPRT
902.4 x 449.1 x 7.00 mm
