corelab-umich/kiteCADRepo/solidworks/Pool Tow Testing - Full Scale/Retration System V2/8020 - 2inch - 15 in V302_weight bar.SLDPRT

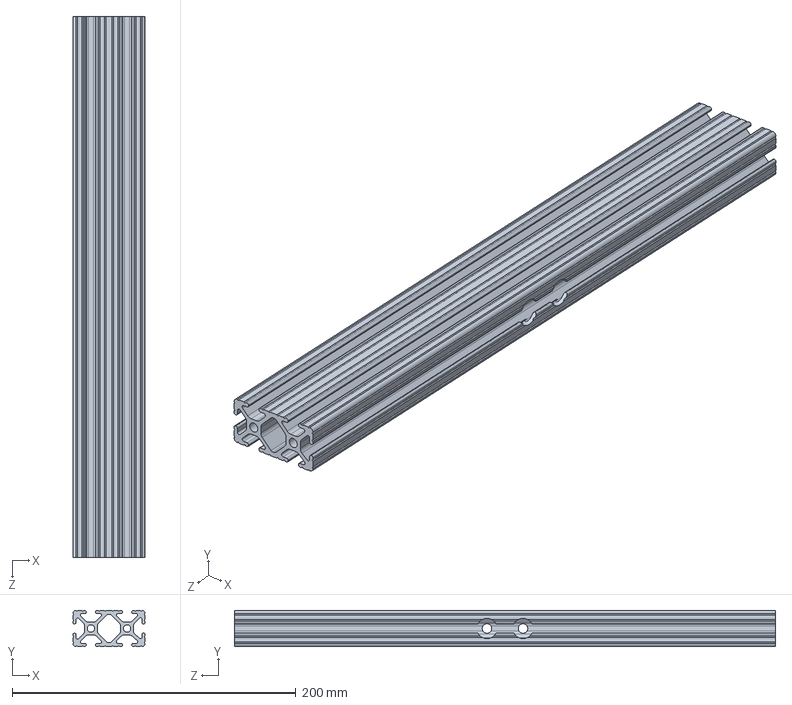
[picture p84: CAD file, 2021-02-19]
solidworks/Pool Tow Testing - Full Scale/Retration System V2/8020 - 2inch - 15 in V302_weight bar.SLDPRT
50.8 x 25.4 x 381.0 mm
