corelab-umich/kiteCADRepo/solidworks/Pool Tow Testing - Full Scale/Retrieval System/Fishing Line Placeholder.SLDPRT

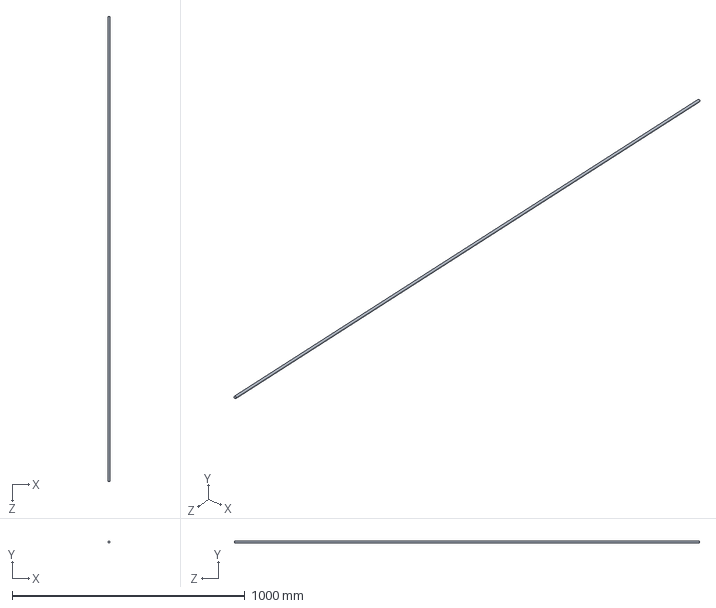
[picture p85: CAD file, 2020-12-31]
solidworks/Pool Tow Testing - Full Scale/Retrieval System/Fishing Line Placeholder.SLDPRT
7.60 x 7.60 x 2000.0 mm
