corelab-umich/kiteCADRepo/solidworks/Pool Tow Testing - Full Scale/TOW FEA ANALYSIS/FEA - 8020 -1inch - 0 ft 4.5 in.SLDPRT

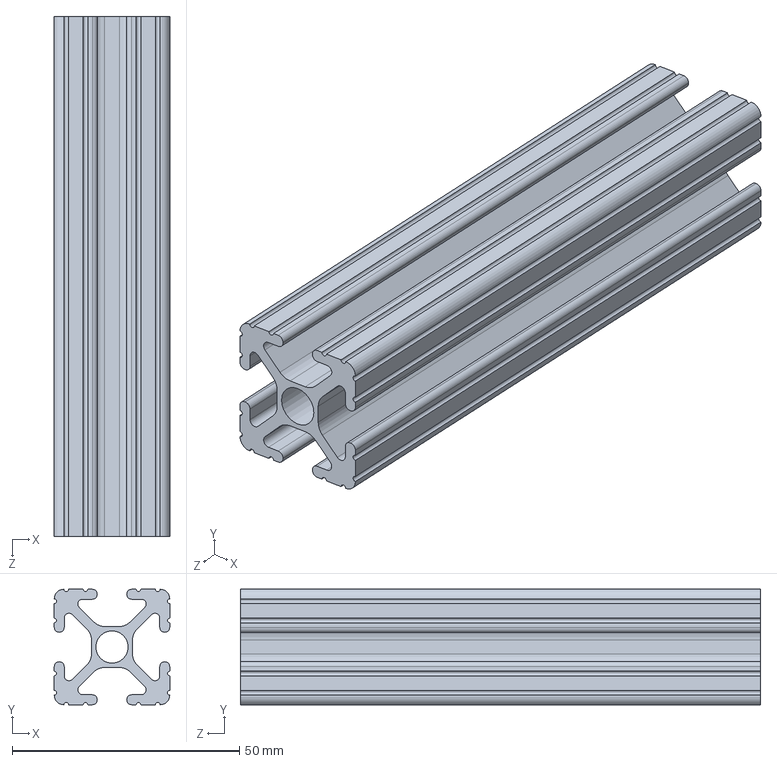
[picture p86: CAD file, 2020-12-30]
solidworks/Pool Tow Testing - Full Scale/TOW FEA ANALYSIS/FEA - 8020 -1inch - 0 ft 4.5 in.SLDPRT
25.4 x 25.4 x 114.3 mm
