corelab-umich/kiteCADRepo/solidworks/Pool Tow Testing - Full Scale/TOW FEA Simplified/Chrome Plated Steel Simp.SLDPRT

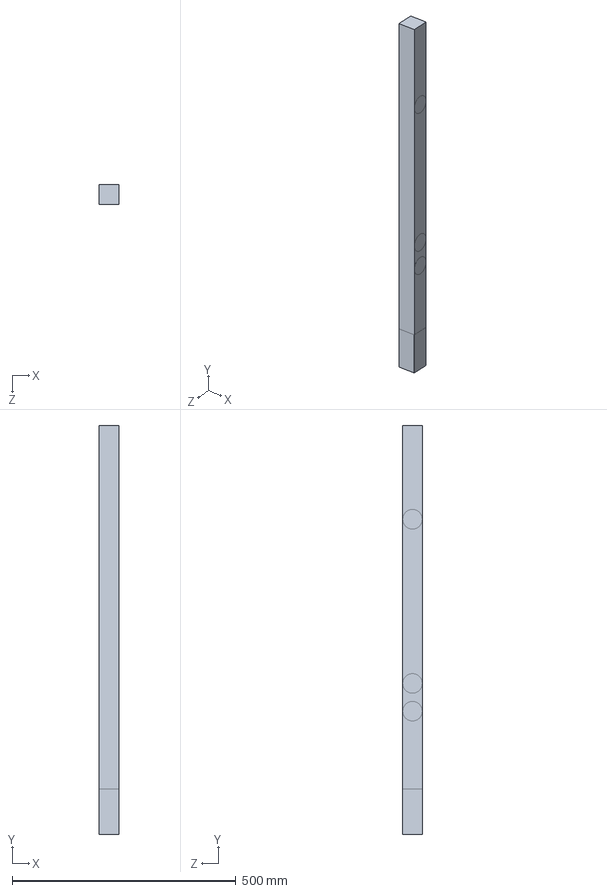
[picture p87: CAD file, 2021-01-18]
solidworks/Pool Tow Testing - Full Scale/TOW FEA Simplified/Chrome Plated Steel Simp.SLDPRT
45.2 x 914.4 x 44.6 mm
