corelab-umich/kiteCADRepo/solidworks/Pool Tow Testing - Full Scale/Tow System Brainstorm/Counterweight.SLDPRT

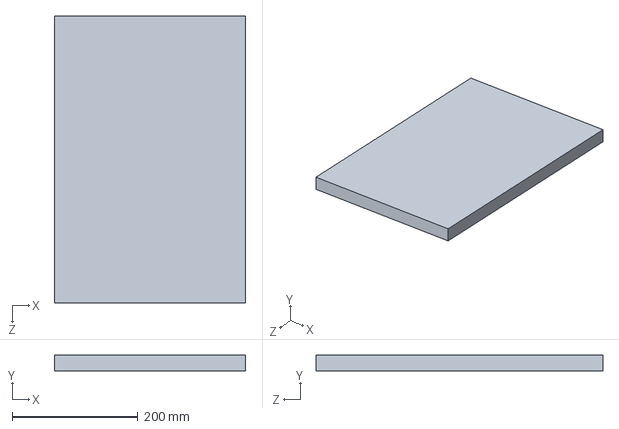
[picture p88: CAD file, 2021-01-08]
solidworks/Pool Tow Testing - Full Scale/Tow System Brainstorm/Counterweight.SLDPRT
304.8 x 25.4 x 457.2 mm
