corelab-umich/kiteCADRepo/solidworks/Pool Tow Testing - Full Scale/Tow System V4.0/8020 -1inch - 6 ft 0 in.SLDPRT

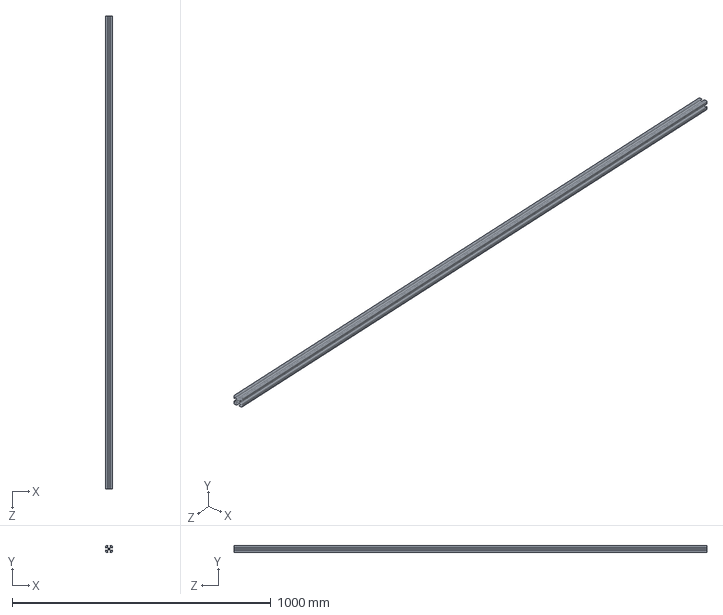
[picture p89: CAD file, 2021-04-08]
solidworks/Pool Tow Testing - Full Scale/Tow System V4.0/8020 -1inch - 6 ft 0 in.SLDPRT
25.4 x 25.4 x 1828.8 mm
