corelab-umich/kiteCADRepo/solidworks/Pool Tow Testing - Full Scale/Tow System/UMD Winch/UMD - Winch Side Plate - DJH Edits.SLDPRT

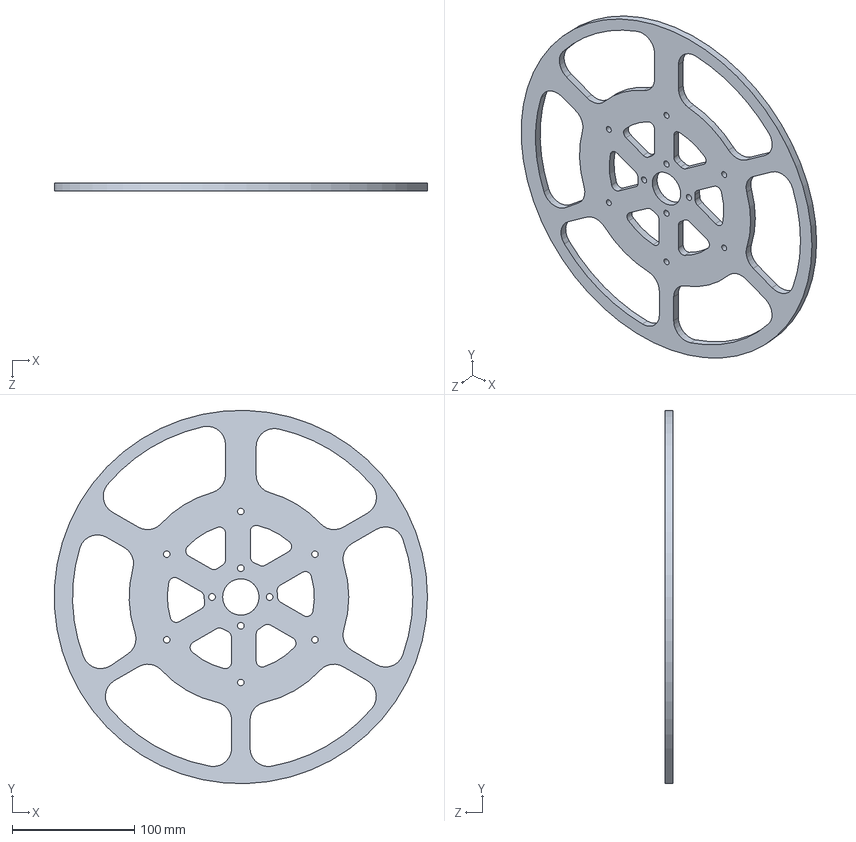
[picture p90: CAD file, 2021-04-08]
solidworks/Pool Tow Testing - Full Scale/Tow System/UMD Winch/UMD - Winch Side Plate - DJH Edits.SLDPRT
304.5 x 304.7 x 6.35 mm
