corelab-umich/kiteCADRepo/solidworks/Privateer/Full lake test Assm/3D print Pully/34tooth pully.SLDPRT

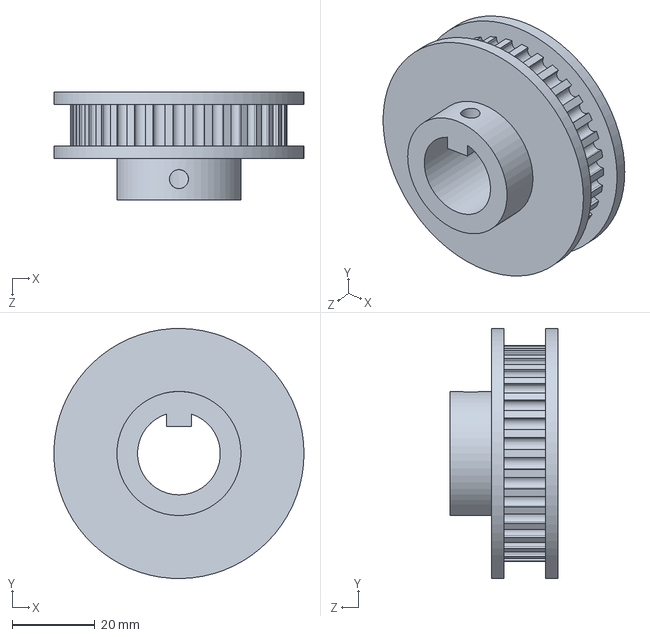
[picture p91: CAD file, 2021-07-02]
solidworks/Privateer/Full lake test Assm/3D print Pully/34tooth pully.SLDPRT
60.4 x 60.4 x 26.0 mm
