corelab-umich/kiteCADRepo/solidworks/Privateer/Full lake test Assm/lake test set up 2/bearing mount.SLDPRT

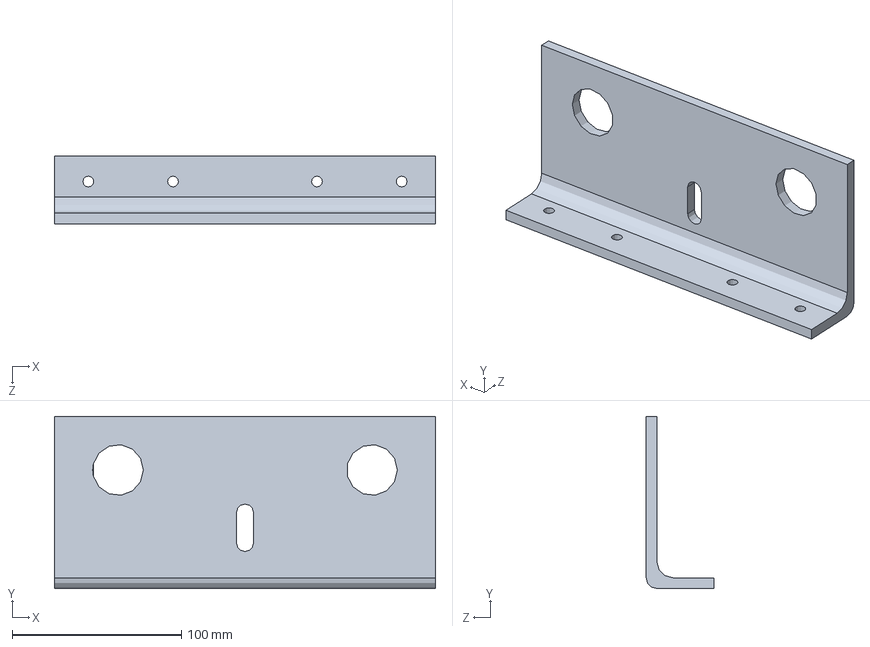
[picture p92: CAD file, 2021-07-02]
solidworks/Privateer/Full lake test Assm/lake test set up 2/bearing mount.SLDPRT
225.0 x 101.6 x 40.0 mm
