corelab-umich/kiteCADRepo/solidworks/Privateer/Full lake test Assm/Research (Col)/Encoder v1.SLDPRT

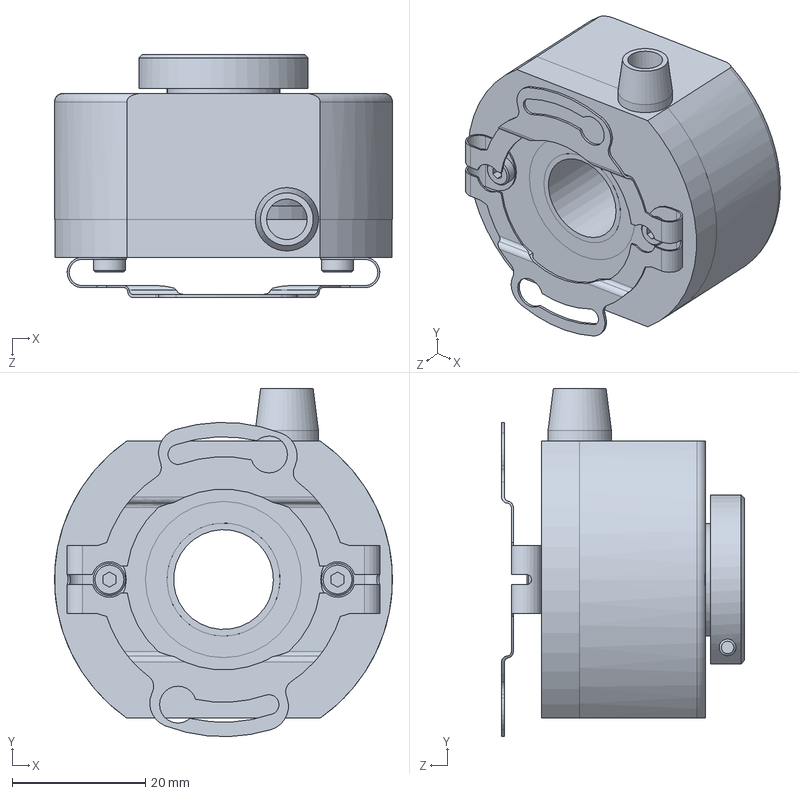
[picture p93: CAD file, 2021-07-02]
solidworks/Privateer/Full lake test Assm/Research (Col)/Encoder v1.SLDPRT
50.8 x 52.3 x 36.5 mm
