corelab-umich/kiteCADRepo/solidworks/Privateer/Lake Body.SLDPRT

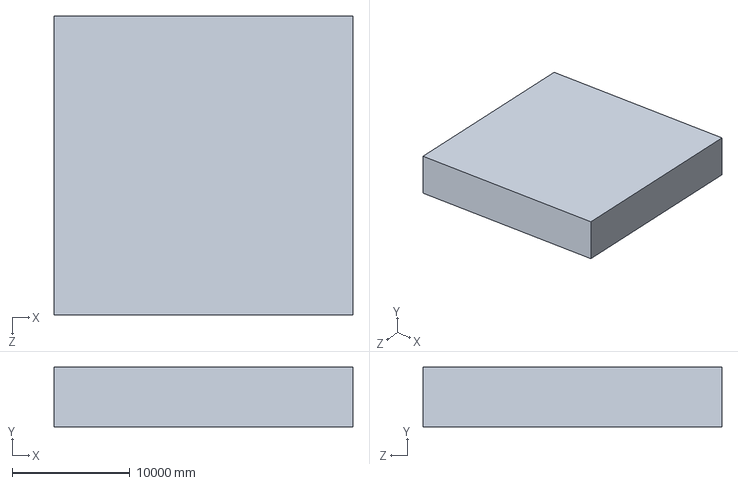
[picture p94: CAD file, 2024-01-24]
solidworks/Privateer/Lake Body.SLDPRT
25400.0 x 5080.0 x 25400.0 mm
