corelab-umich/kiteCADRepo/solidworks/Privateer/Velocity Sensor and Pitot Tube As Built/655A-07-C.SLDPRT

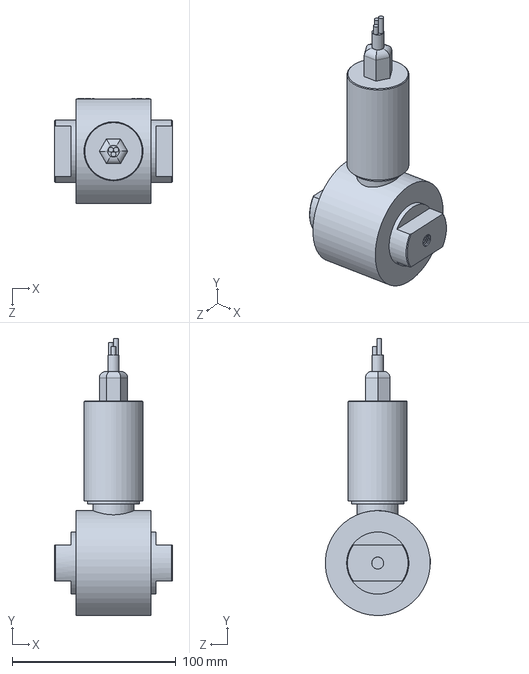
[picture p95: CAD file, 2024-01-24]
solidworks/Privateer/Velocity Sensor and Pitot Tube As Built/655A-07-C.SLDPRT
72.0 x 169.0 x 64.2 mm
