corelab-umich/kiteCADRepo/solidworks/Boat_w_A_Frame/Winch-2000.SLDPRT

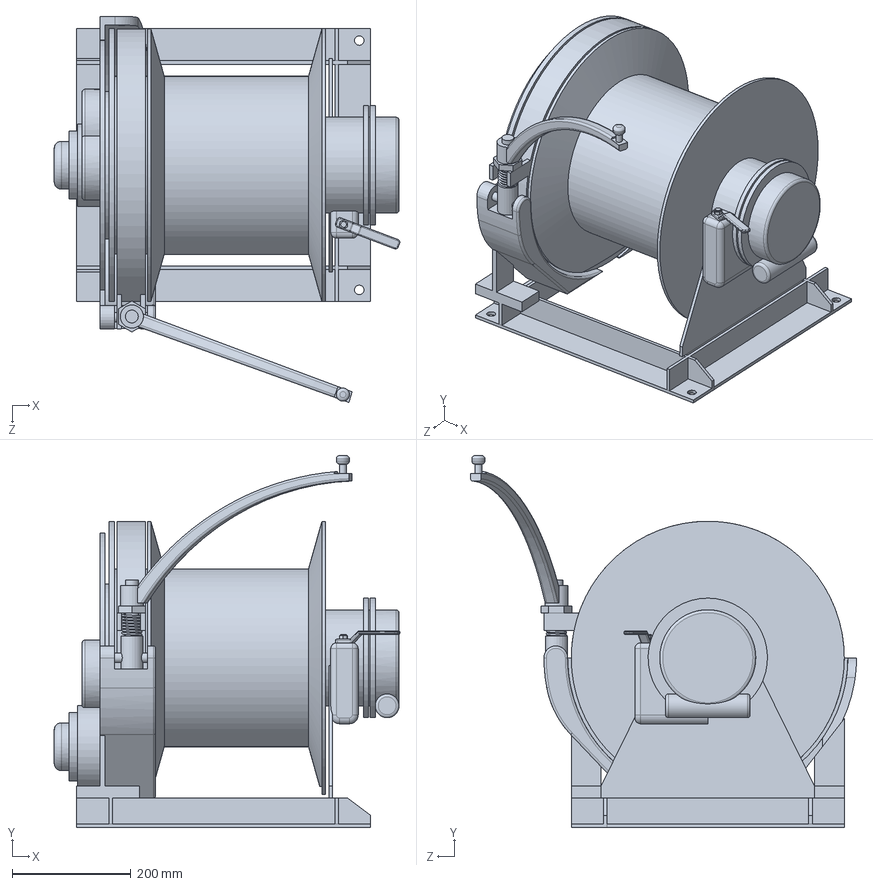
[picture p96: CAD file, 2024-01-24]
solidworks/Boat_w_A_Frame/Winch-2000.SLDPRT
582.4 x 626.9 x 650.3 mm
