corelab-umich/kiteCADRepo/solidworks/Exp Scale Manta Ray/ForMariah061121/EXK-02-0024-STBDA3.STL

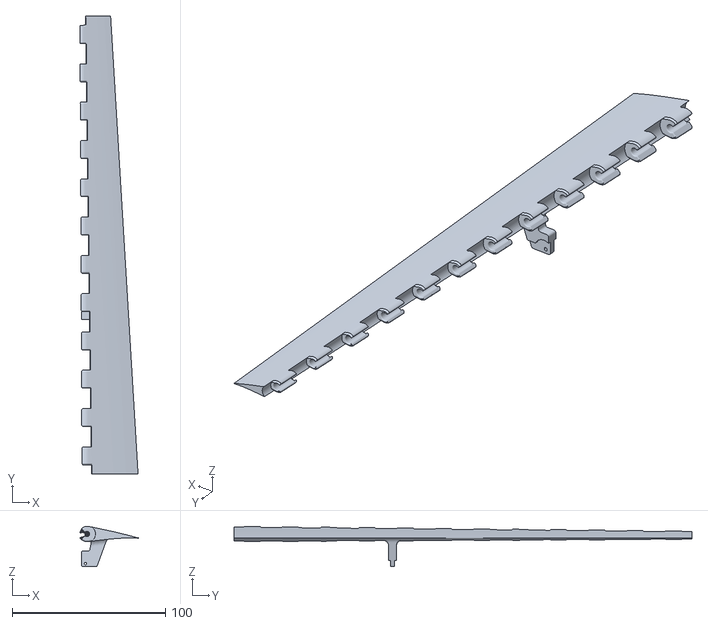
[picture p97: CAD file, 2021-07-02]
solidworks/Exp Scale Manta Ray/ForMariah061121/EXK-02-0024-STBDA3.STL
38.0 x 299.0 x 26.3
