corelab-umich/kiteCADRepo/solidworks/Exp Scale Manta Ray/powerRegBoard.SLDPRT

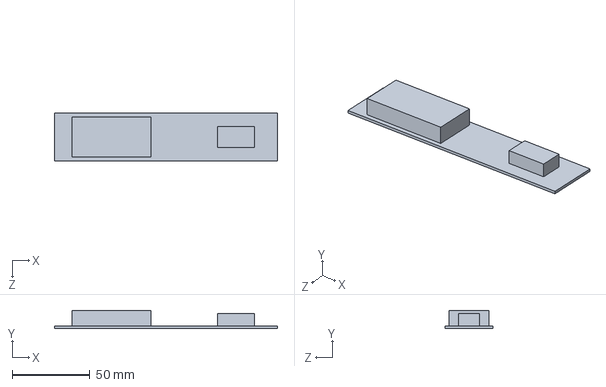
[picture p98: CAD file, 2024-01-24]
solidworks/Exp Scale Manta Ray/powerRegBoard.SLDPRT
143.0 x 11.8 x 31.0 mm
