corelab-umich/kiteCADRepo/solidworks/Exp Scale Manta Ray/Vendor Parts/Arduino/ArduinoNano.SLDPRT

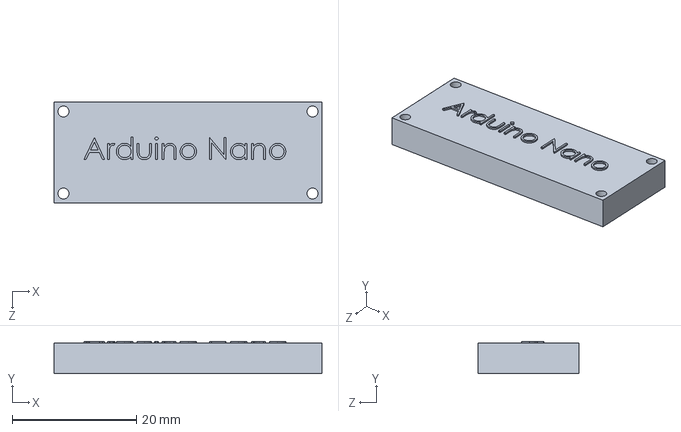
[picture p99: CAD file, 2020-10-19]
solidworks/Exp Scale Manta Ray/Vendor Parts/Arduino/ArduinoNano.SLDPRT
43.2 x 5.21 x 16.3 mm
