corelab-umich/kiteCADRepo/solidworks/Exp Scale Manta Ray/Vendor Parts/Blue Robotics/BAR02.SLDPRT

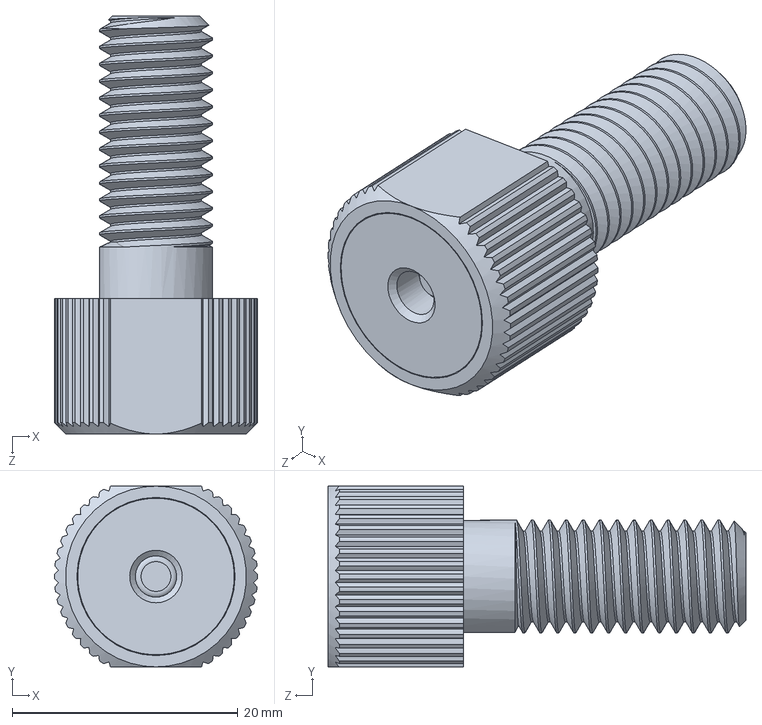
[picture p100: CAD file, 2024-01-24]
solidworks/Exp Scale Manta Ray/Vendor Parts/Blue Robotics/BAR02.SLDPRT
18.0 x 16.0 x 37.0 mm
