corelab-umich/kiteCADRepo/solidworks/Exp Scale Manta Ray/Vendor Parts/Hi-Tec/HS-5086WP_upper.SLDPRT

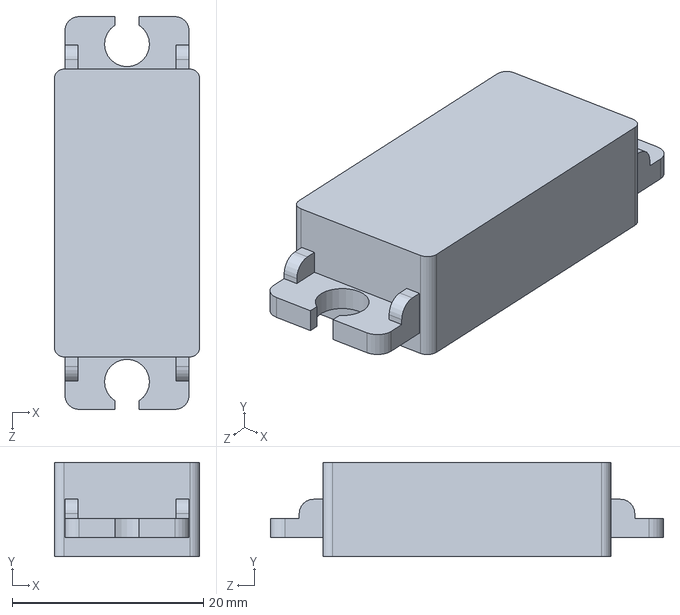
[picture p101: CAD file, 2020-12-30]
solidworks/Exp Scale Manta Ray/Vendor Parts/Hi-Tec/HS-5086WP_upper.SLDPRT
15.2 x 9.85 x 41.1 mm
