corelab-umich/kiteCADRepo/solidworks/Exp Scale Manta Ray/Vendor Parts/Lord/3DM-CX5-25.SLDPRT

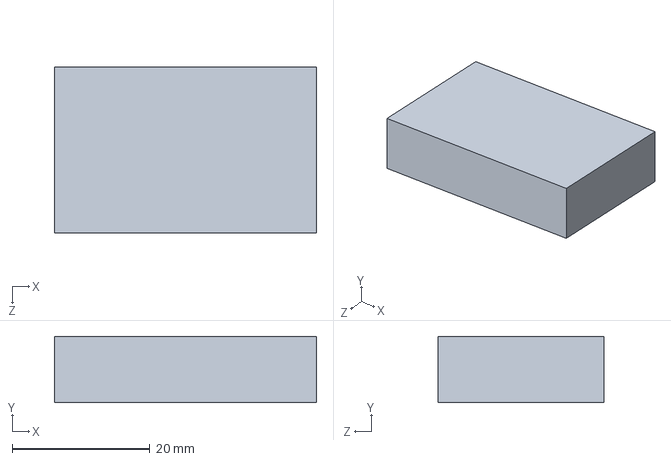
[picture p102: CAD file, 2020-10-07]
solidworks/Exp Scale Manta Ray/Vendor Parts/Lord/3DM-CX5-25.SLDPRT
38.1 x 9.65 x 24.1 mm
