corelab-umich/kiteCADRepo/solidworks/Exp Scale Manta Ray/Vendor Parts/SKF/D_W_R188_2RS1.SLDPRT

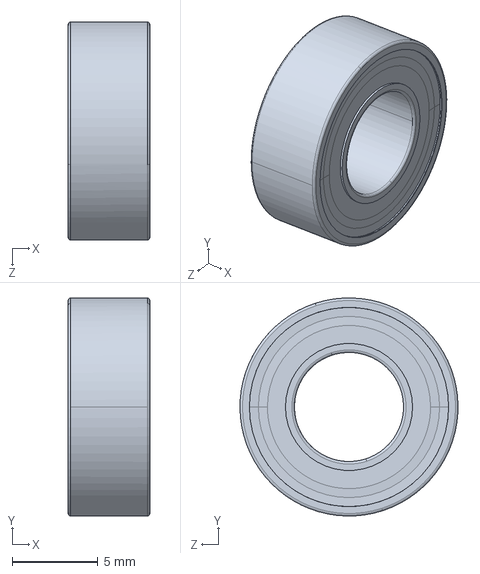
[picture p103: CAD file, 2020-12-30]
solidworks/Exp Scale Manta Ray/Vendor Parts/SKF/D_W_R188_2RS1.SLDPRT
4.76 x 12.7 x 12.7 mm
