corelab-umich/kiteCADRepo/solidworks/Exp Scale Manta Ray/Vendor Parts/TE CONNECTIVITY/MCIL8M.SLDPRT

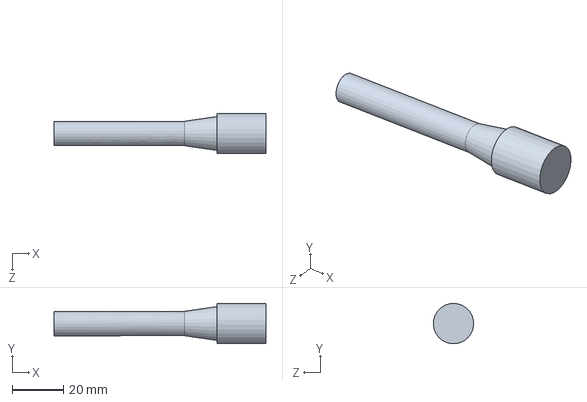
[picture p104: CAD file, 2024-01-24]
solidworks/Exp Scale Manta Ray/Vendor Parts/TE CONNECTIVITY/MCIL8M.SLDPRT
82.5 x 15.7 x 15.7 mm
