corelab-umich/kiteCADRepo/solidworks/fuselageWithProp_FS.SLDPRT

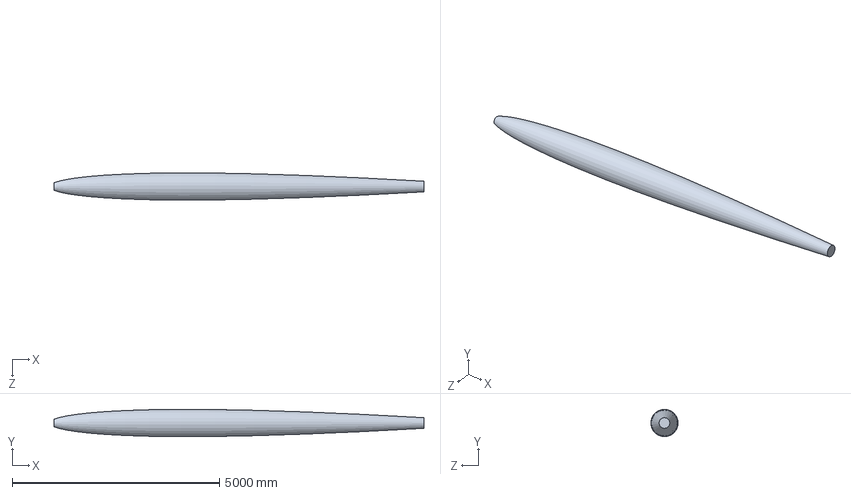
[picture p105: CAD file, 2024-01-24]
solidworks/fuselageWithProp_FS.SLDPRT
8920.0 x 658.5 x 657.2 mm
