corelab-umich/kiteCADRepo/solidworks/Line Angle Sensor/For_Steve/LAS-02-0006.SLDPRT

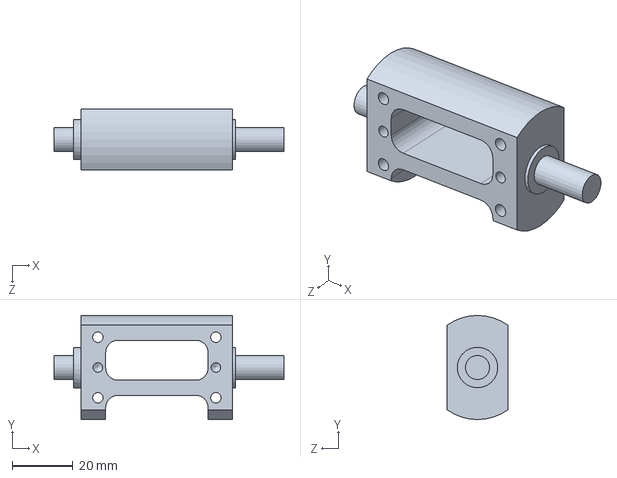
[picture p106: CAD file, 2020-10-07]
solidworks/Line Angle Sensor/For_Steve/LAS-02-0006.SLDPRT
76.0 x 34.4 x 20.0 mm
