corelab-umich/kiteCADRepo/solidworks/Line Angle Sensor/LAS-02-0002.SLDPRT

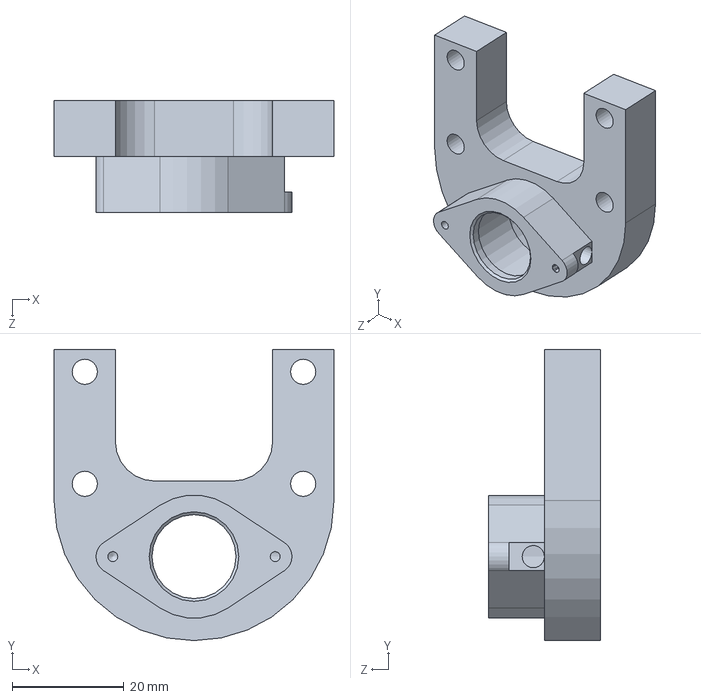
[picture p107: CAD file, 2024-01-24]
solidworks/Line Angle Sensor/LAS-02-0002.SLDPRT
50.0 x 52.0 x 20.0 mm
