corelab-umich/kiteCADRepo/solidworks/Line Angle Sensor/Vendor Products/Renishaw/RMA-shaft8mm.SLDPRT

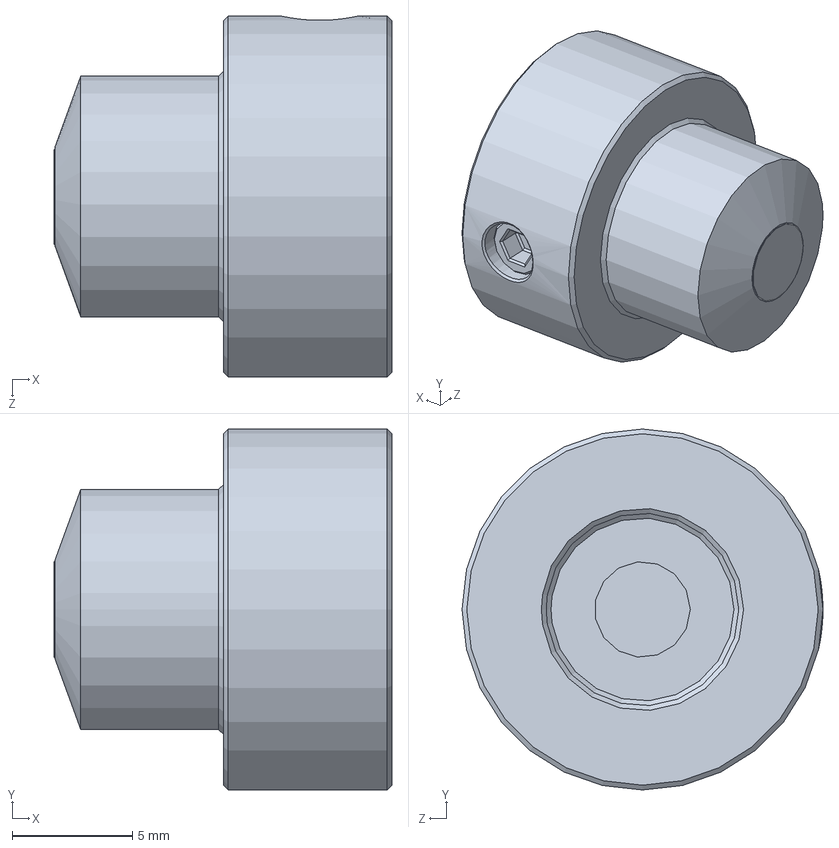
[picture p108: CAD file, 2024-01-24]
solidworks/Line Angle Sensor/Vendor Products/Renishaw/RMA-shaft8mm.SLDPRT
14.0 x 15.0 x 15.0 mm
