corelab-umich/kiteCADRepo/solidworks/Pool Tow Testing - Full Scale/Pool Full Scale Layout/Retraction Tether V2.0.SLDPRT

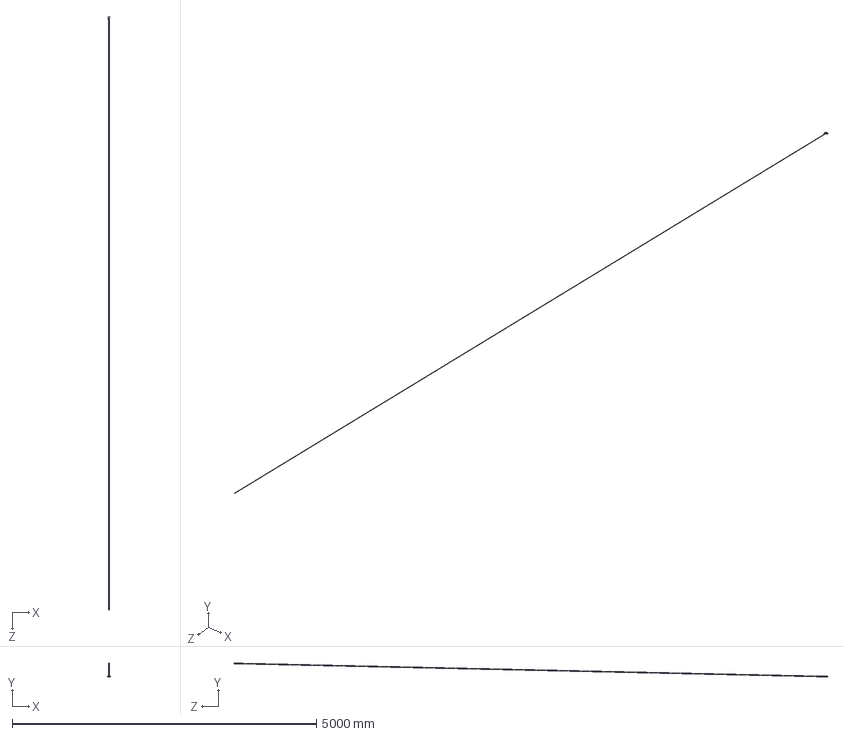
[picture p109: CAD file, 2020-10-19]
solidworks/Pool Tow Testing - Full Scale/Pool Full Scale Layout/Retraction Tether V2.0.SLDPRT
37.8 x 219.1 x 9738.8 mm
