corelab-umich/kiteCADRepo/solidworks/Pool Tow Testing - Full Scale/Retraction System/Reel.SLDPRT

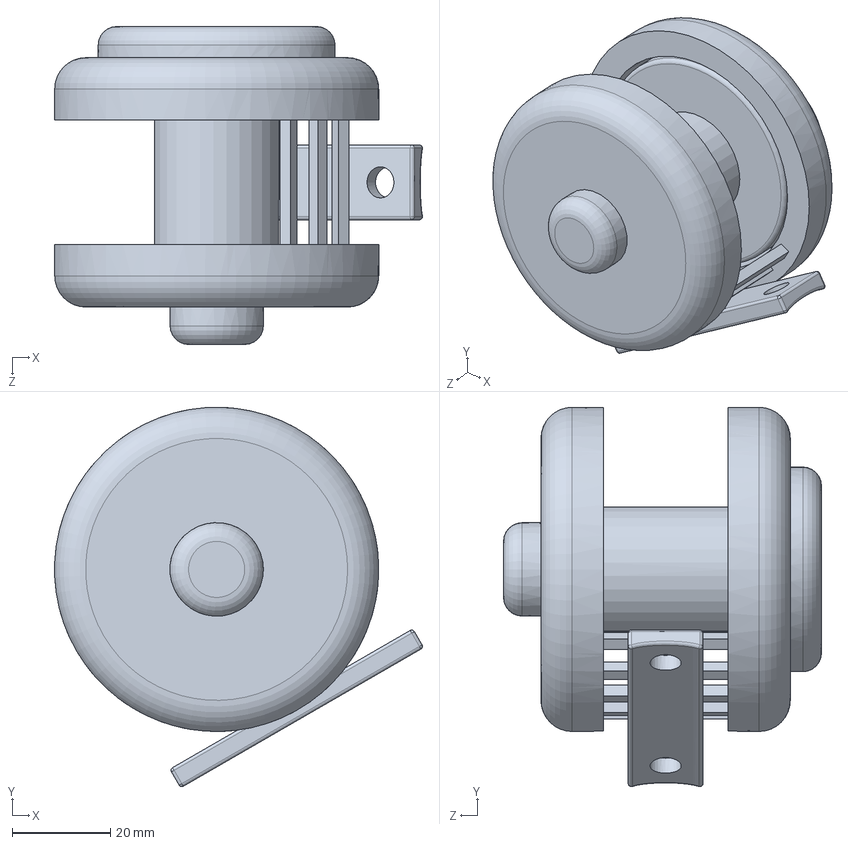
[picture p110: CAD file, 2020-12-31]
solidworks/Pool Tow Testing - Full Scale/Retraction System/Reel.SLDPRT
74.9 x 77.3 x 64.8 mm
