corelab-umich/kiteCADRepo/solidworks/Pool Tow Testing - Full Scale/Retration System V2/Fishing Line Placeholder.SLDPRT

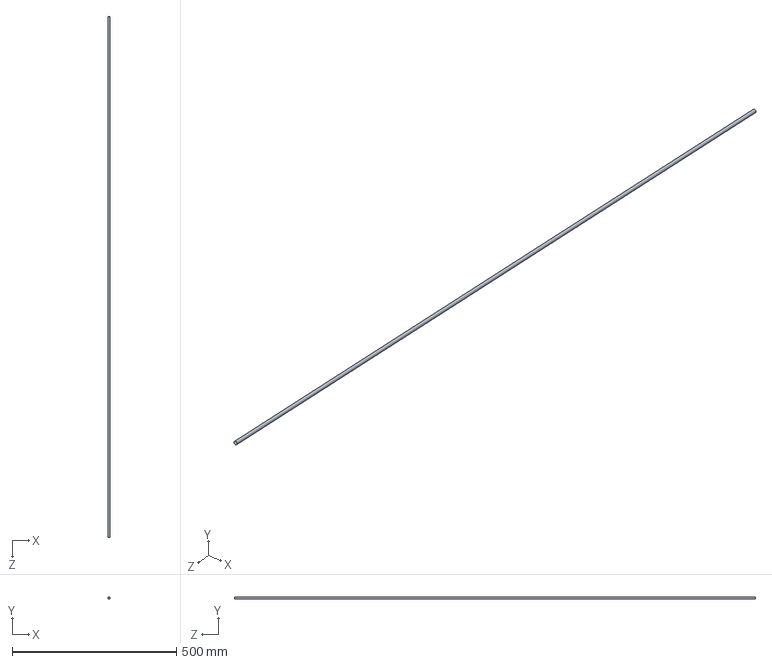
[picture p111: CAD file, 2021-01-22]
solidworks/Pool Tow Testing - Full Scale/Retration System V2/Fishing Line Placeholder.SLDPRT
7.60 x 7.60 x 1586.0 mm
