corelab-umich/kiteCADRepo/solidworks/Pool Tow Testing - Full Scale/TOW FEA ANALYSIS/FEA - 92851A140_SS HIGH-TENSION PUSH-BUTTON QUICK-RELEASE PIN - 4in usable length.SLDPRT

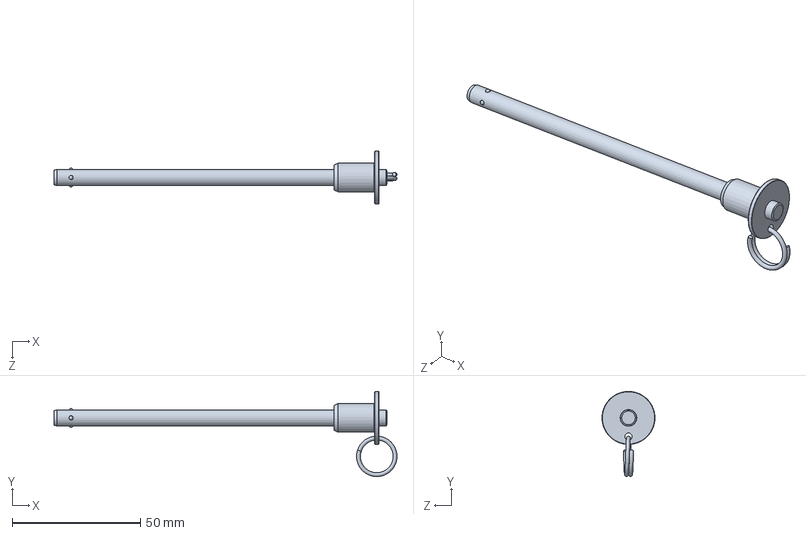
[picture p112: CAD file, 2020-12-30]
solidworks/Pool Tow Testing - Full Scale/TOW FEA ANALYSIS/FEA - 92851A140_SS HIGH-TENSION PUSH-BUTTON QUICK-RELEASE PIN - 4in usable length.SLDPRT
133.5 x 33.2 x 20.6 mm
