corelab-umich/kiteCADRepo/solidworks/Pool Tow Testing - Full Scale/TOW FEA Simplified/Guy Wire Span BeamV3FEASimp.SLDPRT

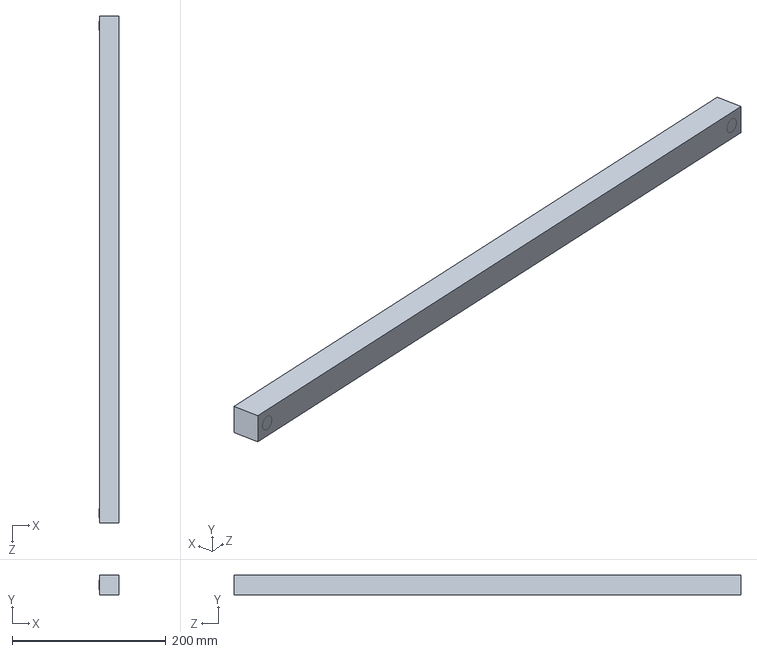
[picture p113: CAD file, 2021-01-18]
solidworks/Pool Tow Testing - Full Scale/TOW FEA Simplified/Guy Wire Span BeamV3FEASimp.SLDPRT
25.5 x 25.4 x 660.4 mm
