corelab-umich/kiteCADRepo/solidworks/Pool Tow Testing - Full Scale/Tow System V4.0/String Potentiometer.SLDPRT

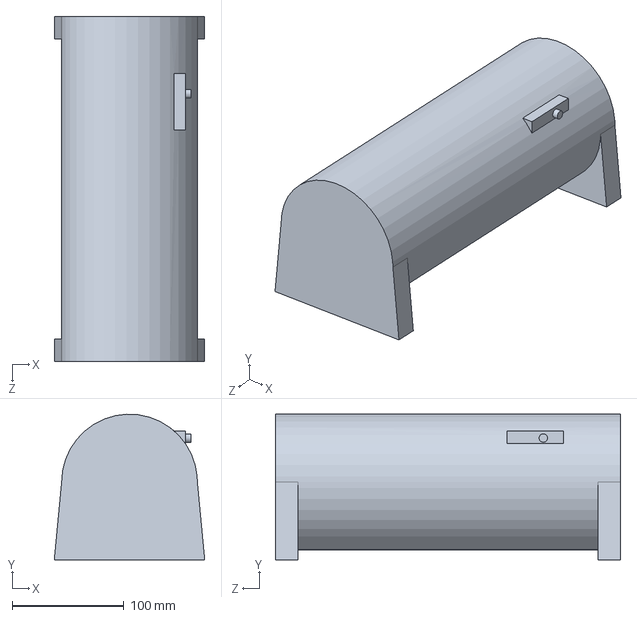
[picture p114: CAD file, 2021-04-08]
solidworks/Pool Tow Testing - Full Scale/Tow System V4.0/String Potentiometer.SLDPRT
134.6 x 130.2 x 308.6 mm
