corelab-umich/kiteCADRepo/solidworks/Privateer/Full lake test Assm/Level wind/Levelwind.SLDPRT

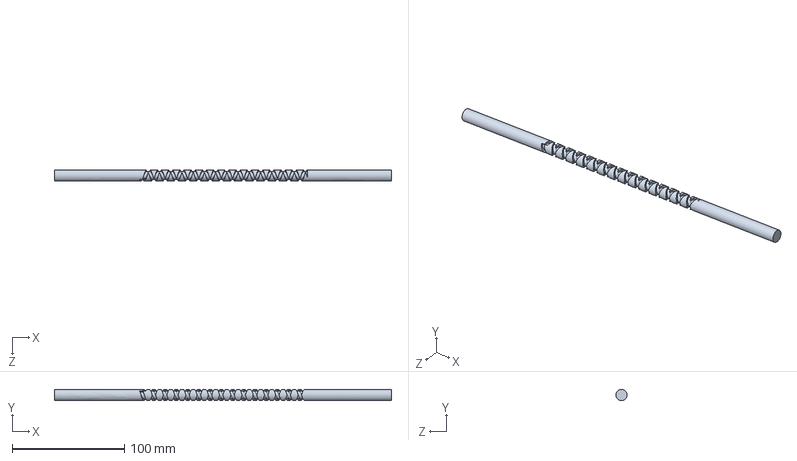
[picture p115: CAD file, 2021-07-02]
solidworks/Privateer/Full lake test Assm/Level wind/Levelwind.SLDPRT
300.0 x 10.0 x 10.0 mm
