corelab-umich/kiteCADRepo/solidworks/Privateer/Full lake test Assm/Research (Col)/Motor mount.SLDPRT

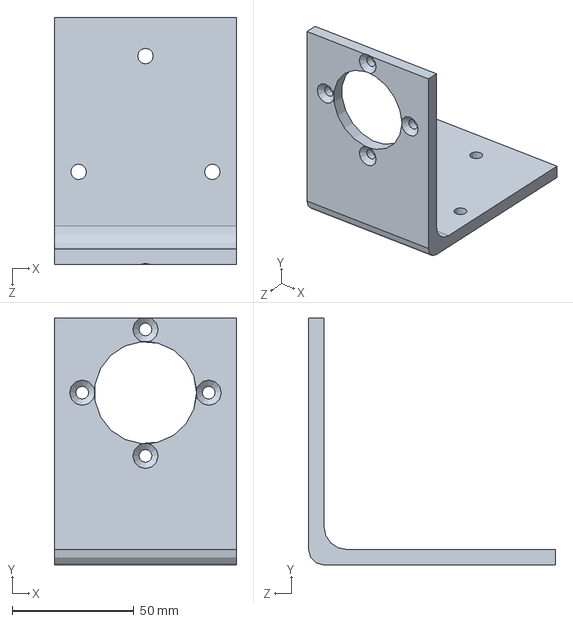
[picture p116: CAD file, 2021-07-02]
solidworks/Privateer/Full lake test Assm/Research (Col)/Motor mount.SLDPRT
75.0 x 101.6 x 101.6 mm
