corelab-umich/kiteCADRepo/solidworks/Privateer/Velocity Sensor and Pitot Tube As Built/Pitot Tube.SLDPRT

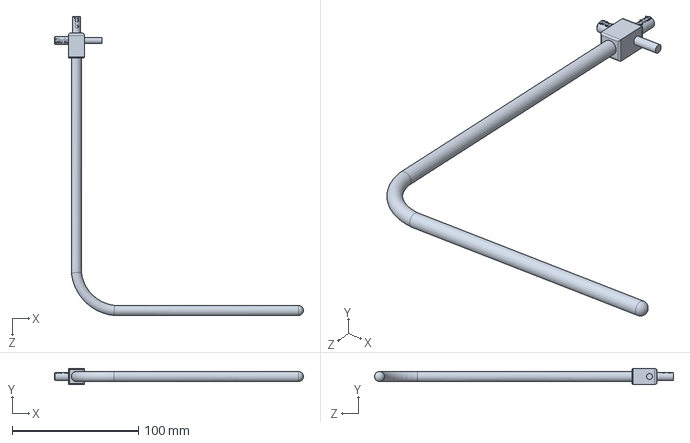
[picture p117: CAD file, 2024-01-24]
solidworks/Privateer/Velocity Sensor and Pitot Tube As Built/Pitot Tube.SLDPRT
197.4 x 12.7 x 237.0 mm
