corelab-umich/kiteCADRepo/solidworks/Boat_w_A_Frame/Block.SLDPRT

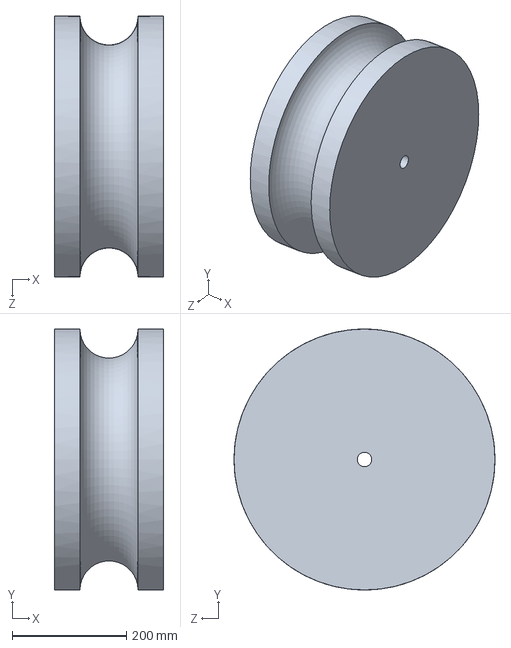
[picture p118: CAD file, 2024-01-24]
solidworks/Boat_w_A_Frame/Block.SLDPRT
190.5 x 457.2 x 457.2 mm
