corelab-umich/kiteCADRepo/solidworks/Exp Scale Manta Ray/ForMariah060421/EXK-02-0024_060421-Try2.STL

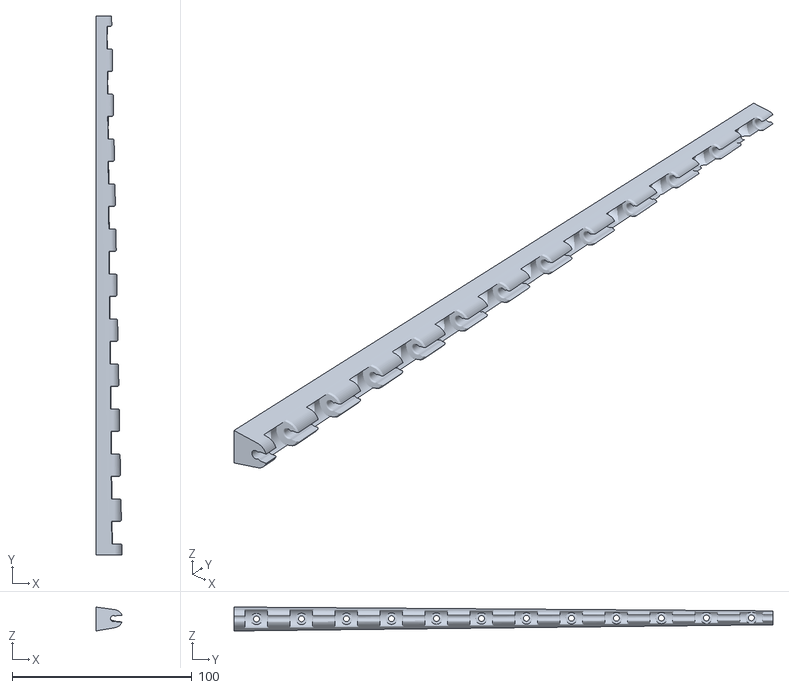
[picture p119: CAD file, 2021-07-02]
solidworks/Exp Scale Manta Ray/ForMariah060421/EXK-02-0024_060421-Try2.STL
14.5 x 299.5 x 13.3
