corelab-umich/kiteCADRepo/solidworks/Exp Scale Manta Ray/ForMariah52121/PORTHinge-200mm.STL

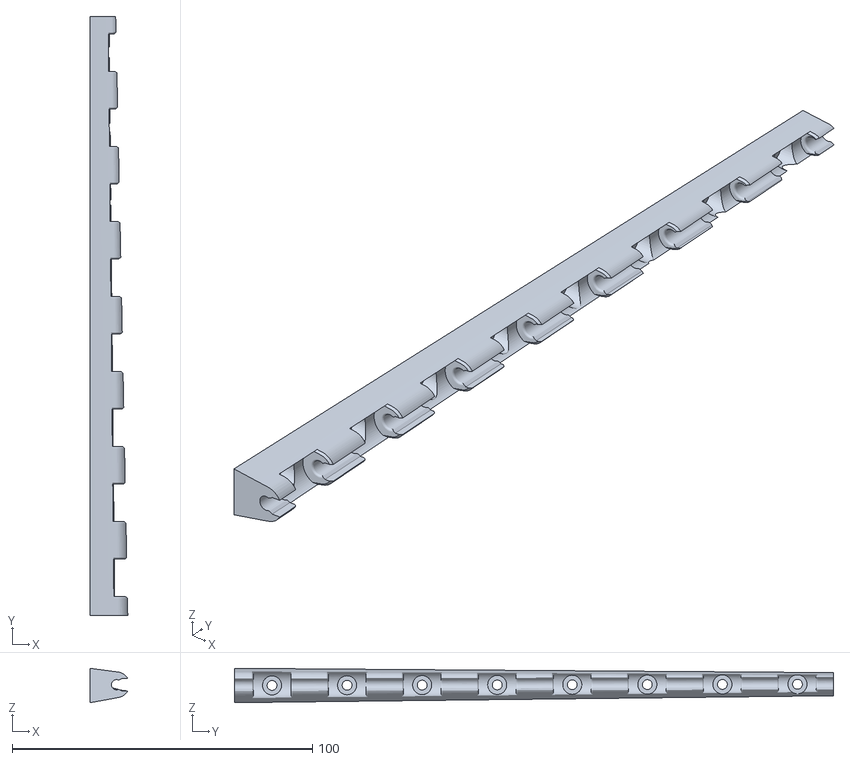
[picture p120: CAD file, 2021-07-02]
solidworks/Exp Scale Manta Ray/ForMariah52121/PORTHinge-200mm.STL
12.5 x 199.5 x 11.4
