corelab-umich/kiteCADRepo/solidworks/Exp Scale Manta Ray/Vendor Parts/Hi-Tec/HS-5086WP_top.SLDPRT

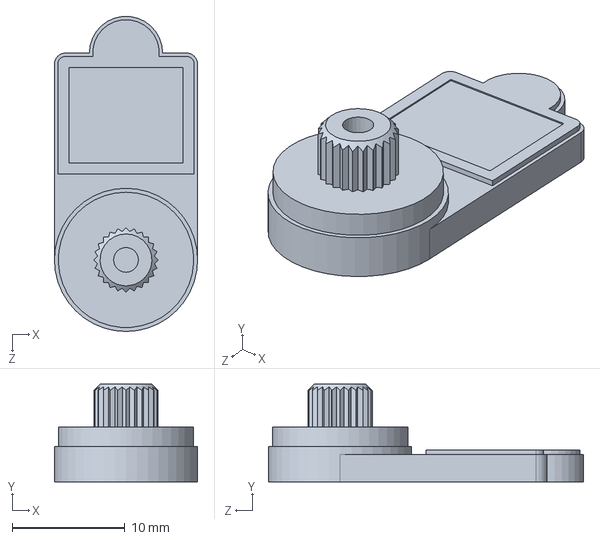
[picture p121: CAD file, 2020-12-30]
solidworks/Exp Scale Manta Ray/Vendor Parts/Hi-Tec/HS-5086WP_top.SLDPRT
12.7 x 8.65 x 27.9 mm
