corelab-umich/kiteCADRepo/solidworks/kiteAssembly_FS.SLDASM

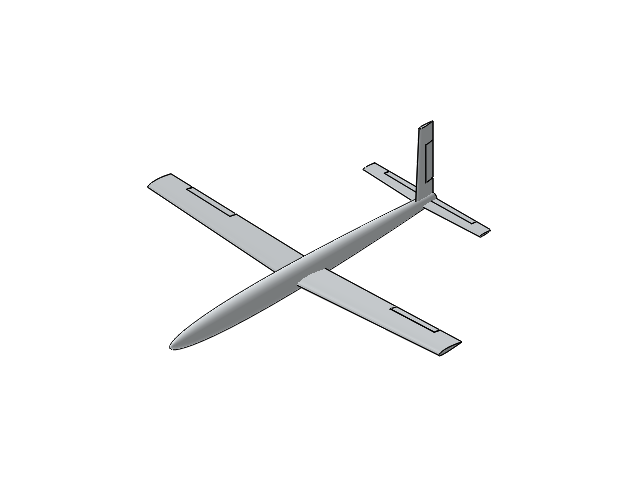
[picture p122: CAD file, 2024-01-24]
solidworks/kiteAssembly_FS.SLDASM
wing_FS
fuselage_FS
hStab_FS
vStab_FS
