corelab-umich/kiteCADRepo/solidworks/kiteAssemblyWithProp_FS.SLDASM

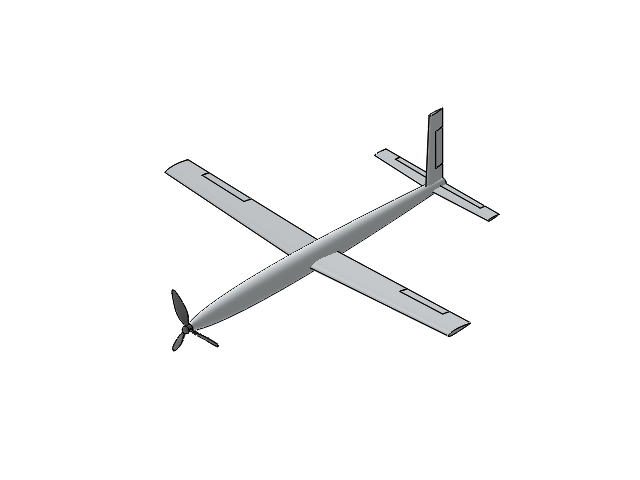
[picture p123: CAD file, 2024-01-24]
solidworks/kiteAssemblyWithProp_FS.SLDASM
wing_FS
hStab_FS
vStab_FS
fuselageWithProp_FS
propellerGrabCad
