corelab-umich/kiteCADRepo/solidworks/Privateer/Full Scale Lake Layout.SLDASM

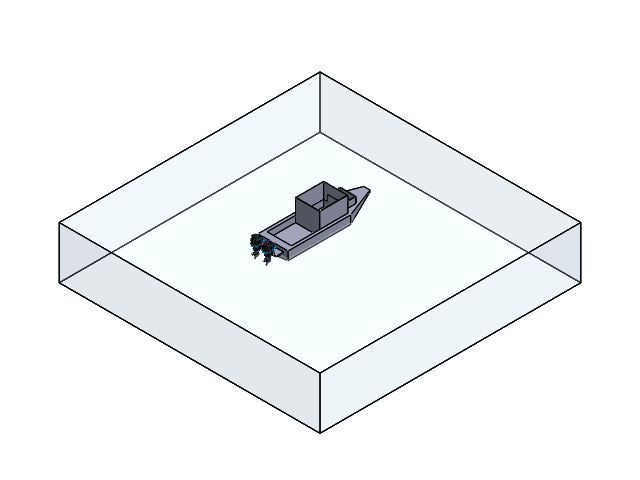
[picture p124: CAD file, 2024-01-24]
solidworks/Privateer/Full Scale Lake Layout.SLDASM
Privateer Hull
F300B_ETX_3D_STEP x 2
Lake Body
