corelab-umich/kiteCADRepo/solidworks/Privateer/Full lake test Assm/lake test set up 2/28tooth.SLDASM

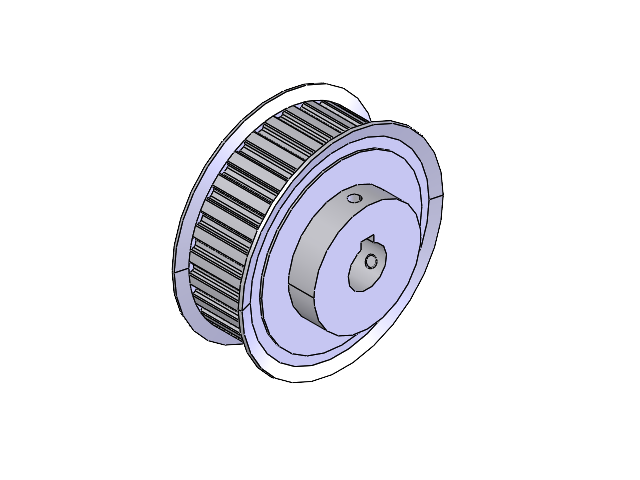
[picture p125: CAD file, 2021-07-02]
solidworks/Privateer/Full lake test Assm/lake test set up 2/28tooth.SLDASM
ATPA28L100_B_N18_3 x 2
ATPA28L100_B_N18_6
