corelab-umich/kiteCADRepo/(list of files, cad)

Other CAD files:
solidworks/Pool Tow Testing - Full Scale/Raft/Raft Enclosure/LCA_Enclosure_Mount.SLDASM
solidworks/Line Angle Sensor/Vendor Products/MCM/SFXFA8-12-F21-SET.stp.SLDASM
solidworks/Privateer/Full lake test Assm/lake test set up 2/15-18mm Misalinemnt coupler.SLDASM
solidworks/Pool Tow Testing - Full Scale/Raft/LCA_Baseline_Enclosure_16122020.SLDASM
solidworks/Exp Scale Manta Ray/PinSocket_1x08_P2.54mm_Vertical.step.SLDASM
solidworks/Exp Scale Manta Ray/PinSocket_1x03_P2.54mm_Vertical.step.SLDASM
solidworks/Exp Scale Manta Ray/PinSocket_1x02_P2.54mm_Vertical.step.SLDASM
solidworks/Exp Scale Manta Ray/PinSocket_1x12_P2.54mm_Vertical.step.SLDASM
solidworks/Exp Scale Manta Ray/R_Axial_DIN0204_L3.6mm_D1.6mm_P2.54mm_Vertical.step.SLDASM
solidworks/Exp Scale Manta Ray/PinSocket_1x04_P2.54mm_Vertical.step.SLDASM
solidworks/Exp Scale Manta Ray/PinSocket_1x16_P2.54mm_Vertical.step.SLDASM
solidworks/Exp Scale Manta Ray/PinSocket_1x05_P2.54mm_Vertical.step.SLDASM
solidworks/Exp Scale Manta Ray/Assem1.SLDASM
solidworks/Exp Scale Manta Ray/kite_asm_JB.SLDASM
solidworks/Exp Scale Manta Ray/ForMariah52121/STBDHinge-300mm.STL
solidworks/Privateer/Full lake test Assm/SOLIDWORKS/ATPA28L100_B_N18_6.SLDPRT
solidworks/Exp Scale Manta Ray/ForMariah060421/MirrorEXK-02-0024_060421.STL
solidworks/Exp Scale Manta Ray/ForMariah52121/STBDAil-300mm.STL
solidworks/Exp Scale Manta Ray/Vendor Parts/ADAFRUIT/huzzah32.stp
solidworks/Exp Scale Manta Ray/Vendor Parts/SW0250MG.SLDPRT
solidworks/Line Angle Sensor/Released Prints/01_LAS-03-0004.dxf
solidworks/Privateer/Full lake test Assm/3D print Pully/34tooth pully_10mmID.SLDPRT
solidworks/Privateer/Full lake test Assm/SOLIDWORKS/ATPA28L100_B_N18_3.SLDPRT
solidworks/Exp Scale Manta Ray/ForMariah061121/EXK-02-0024-PH3.STL
solidworks/Exp Scale Manta Ray/Vendor Parts/Arduino/Nano.SLDPRT
solidworks/Exp Scale Manta Ray/Vendor Parts/Blue Robotics/BlueRoboticsBar02.SLDPRT
Inventor/FS_fuselage.ipt
Inventor/FS_hStab.ipt
Inventor/FS_kite.iam
Inventor/FS_kiteDrawing.idw
Inventor/FS_vStab.ipt
Inventor/FS_wing.ipt
solidworks/Boat_w_A_Frame/Hull.SLDPRT
solidworks/Boat_w_A_Frame/LockingPin.SLDPRT
solidworks/Boat_w_A_Frame/Tether.SLDPRT
solidworks/Boat_w_A_Frame/subsonus_mount.SLDPRT
solidworks/Exp Scale Manta Ray/10K.stp.STEP.SLDPRT
solidworks/Exp Scale Manta Ray/10uF.stp.STEP.SLDPRT
solidworks/Exp Scale Manta Ray/20329.stp.STEP.SLDPRT
solidworks/Exp Scale Manta Ray/4.7K.stp.STEP.SLDPRT
solidworks/Exp Scale Manta Ray/5pin_M_254.STEP.SLDPRT
solidworks/Exp Scale Manta Ray/Aileron.SLDPRT
solidworks/Exp Scale Manta Ray/AileronTry2.SLDPRT
solidworks/Exp Scale Manta Ray/Board.stp.STEP.SLDPRT
solidworks/Exp Scale Manta Ray/Bridle.SLDPRT
solidworks/Exp Scale Manta Ray/Bridle_Compact.SLDPRT
solidworks/Exp Scale Manta Ray/Bridle_Compact_For3D.SLDPRT
solidworks/Exp Scale Manta Ray/Buoyancy Model.SLDPRT
solidworks/Exp Scale Manta Ray/Buoyancy Model.STEP
solidworks/Exp Scale Manta Ray/CDMCX525.SLDPRT
solidworks/Exp Scale Manta Ray/COMPOUND.step.SLDPRT
solidworks/Exp Scale Manta Ray/COMPOUND.step.STEP.SLDPRT
solidworks/Exp Scale Manta Ray/CP2104.stp.STEP.SLDPRT
solidworks/Exp Scale Manta Ray/ControlAr,.SLDPRT
solidworks/Exp Scale Manta Ray/D777MG.SLDPRT
solidworks/Exp Scale Manta Ray/D85MG.SLDPRT
solidworks/Exp Scale Manta Ray/DMG3415U.stp.STEP.SLDPRT
solidworks/Exp Scale Manta Ray/ELevatorTooling.SLDPRT
solidworks/Exp Scale Manta Ray/ESP32_WROOM32_SKINNY.stp.STEP.SLDPRT
solidworks/Exp Scale Manta Ray/EXK-01-0002.SLDDRW
solidworks/Exp Scale Manta Ray/EXK-01-0002.SLDPRT
solidworks/Exp Scale Manta Ray/EXK-01-0004.SLDPRT
solidworks/Exp Scale Manta Ray/EXK-01-0006.SLDDRW
solidworks/Exp Scale Manta Ray/EXK-01-0006.SLDPRT
solidworks/Exp Scale Manta Ray/EXK-01-0008-01.SLDDRW
solidworks/Exp Scale Manta Ray/EXK-01-0008-01.STEP
solidworks/Exp Scale Manta Ray/EXK-01-0008-02.SLDDRW
solidworks/Exp Scale Manta Ray/EXK-01-0008-02.STEP
solidworks/Exp Scale Manta Ray/EXK-01-0008.SLDPRT
solidworks/Exp Scale Manta Ray/EXK-01-0010.SLDPRT
solidworks/Exp Scale Manta Ray/EXK-01-0012.SLDPRT
solidworks/Exp Scale Manta Ray/EXK-01-0014-01.SLDDRW
solidworks/Exp Scale Manta Ray/EXK-01-0014-01.SLDPRT
solidworks/Exp Scale Manta Ray/EXK-01-0014-01.STEP
solidworks/Exp Scale Manta Ray/EXK-01-0014-02.SLDDRW
solidworks/Exp Scale Manta Ray/EXK-01-0014-02.STEP
solidworks/Exp Scale Manta Ray/EXK-01-0014-03.STEP
solidworks/Exp Scale Manta Ray/EXK-01-0014-04.STEP
solidworks/Exp Scale Manta Ray/EXK-01-0014.SLDPRT
solidworks/Exp Scale Manta Ray/EXK-01-0014.step
solidworks/Exp Scale Manta Ray/EXK-01-0014TEST.SLDPRT
solidworks/Exp Scale Manta Ray/EXK-01-0014TEST.STEP
solidworks/Exp Scale Manta Ray/EXK-01-0016.SLDPRT
solidworks/Exp Scale Manta Ray/EXK-02-0001.SLDPRT
solidworks/Exp Scale Manta Ray/EXK-02-0002.SLDPRT
solidworks/Exp Scale Manta Ray/EXK-02-0003-02.SLDPRT
solidworks/Exp Scale Manta Ray/EXK-02-0003-02.STEP
solidworks/Exp Scale Manta Ray/EXK-02-0003.SLDDRW
solidworks/Exp Scale Manta Ray/EXK-02-0003.SLDPRT
solidworks/Exp Scale Manta Ray/EXK-02-0005-01.SLDPRT
solidworks/Exp Scale Manta Ray/EXK-02-0005.SLDPRT
solidworks/Exp Scale Manta Ray/EXK-02-0006-01.SLDPRT
solidworks/Exp Scale Manta Ray/EXK-02-0006.SLDPRT
solidworks/Exp Scale Manta Ray/EXK-02-0007.SLDPRT
solidworks/Exp Scale Manta Ray/EXK-02-0009-01.SLDDRW
solidworks/Exp Scale Manta Ray/EXK-02-0009-01.SLDPRT
solidworks/Exp Scale Manta Ray/EXK-02-0009-02.SLDPRT
solidworks/Exp Scale Manta Ray/EXK-02-0009-02.STEP
solidworks/Exp Scale Manta Ray/EXK-02-0009.SLDDRW
solidworks/Exp Scale Manta Ray/EXK-02-0009.SLDPRT
solidworks/Exp Scale Manta Ray/EXK-02-0010.SLDPRT
solidworks/Exp Scale Manta Ray/EXK-02-0012.SLDDRW
solidworks/Exp Scale Manta Ray/EXK-02-0012.SLDPRT
solidworks/Exp Scale Manta Ray/EXK-02-0012_Fixed.SLDPRT
solidworks/Exp Scale Manta Ray/EXK-02-0013.SLDPRT
solidworks/Exp Scale Manta Ray/EXK-02-0013_Metal.SLDDRW
solidworks/Exp Scale Manta Ray/EXK-02-0013_Metal.SLDPRT
solidworks/Exp Scale Manta Ray/EXK-02-0014-01.SLDDRW
solidworks/Exp Scale Manta Ray/EXK-02-0014-01.STEP
solidworks/Exp Scale Manta Ray/EXK-02-0014-02.SLDDRW
solidworks/Exp Scale Manta Ray/EXK-02-0014-02.STEP
solidworks/Exp Scale Manta Ray/EXK-02-0014.SLDPRT
solidworks/Exp Scale Manta Ray/EXK-02-0015.SLDPRT
solidworks/Exp Scale Manta Ray/EXK-02-0016.SLDDRW
solidworks/Exp Scale Manta Ray/EXK-02-0017.SLDDRW
solidworks/Exp Scale Manta Ray/EXK-02-0017.SLDPRT
solidworks/Exp Scale Manta Ray/EXK-02-0018.SLDDRW
solidworks/Exp Scale Manta Ray/EXK-02-0019-hStab.STEP
solidworks/Exp Scale Manta Ray/EXK-02-0019-vStab.STEP
solidworks/Exp Scale Manta Ray/EXK-02-0019.SLDDRW
solidworks/Exp Scale Manta Ray/EXK-02-0020.SLDPRT
solidworks/Exp Scale Manta Ray/EXK-02-0022.SLDDRW
solidworks/Exp Scale Manta Ray/EXK-02-0024.SLDPRT
solidworks/Exp Scale Manta Ray/EXK-02-0025.SLDPRT
solidworks/Exp Scale Manta Ray/EXK-02-0026.SLDPRT
solidworks/Exp Scale Manta Ray/EXK-02-0027.SLDPRT
solidworks/Exp Scale Manta Ray/EXK-02-0028-Slotted.SLDPRT
solidworks/Exp Scale Manta Ray/EXK-02-0028.SLDPRT
solidworks/Exp Scale Manta Ray/ElevatorCtrlArmBushing.SLDPRT
solidworks/Exp Scale Manta Ray/ElevatorCtrlArmBushing.STL
solidworks/Exp Scale Manta Ray/ForMariah060421/EXK-02-0024_060421.STL
solidworks/Exp Scale Manta Ray/ForMariah060421/MirrorEXK-02-0024_060421-Try2.STL
solidworks/Exp Scale Manta Ray/ForMariah061121/EXK-02-0024-PA3.STL
solidworks/Exp Scale Manta Ray/ForMariah52121/PORTAil-200mm.STL
solidworks/Exp Scale Manta Ray/ForMariah52121/PORTAil-300mm.STL
solidworks/Exp Scale Manta Ray/ForMariah52121/PORTHinge-300mm.STL
solidworks/Exp Scale Manta Ray/ForMariah52121/STBDAil-200mm.STL
solidworks/Exp Scale Manta Ray/ForMariah52121/STBDHinge-200mm.STL
solidworks/Exp Scale Manta Ray/FusePhase2.SLDPRT
solidworks/Exp Scale Manta Ray/FusePhase2Front.SLDPRT
solidworks/Exp Scale Manta Ray/FusePhase2Front.STEP
solidworks/Exp Scale Manta Ray/FusePhase2Rear.SLDPRT
solidworks/Exp Scale Manta Ray/FusePhase2Rear.STEP
solidworks/Exp Scale Manta Ray/FuseTestPhase2.SLDPRT
solidworks/Exp Scale Manta Ray/FuselagePhase2.SLDPRT
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
