corelab-umich/kiteCADRepo/solidworks/Line Angle Sensor/Fabrication Request LAS.pdf

## Mechanical & Aerospace Engineering

## Fabrication Facility Request Form

1. Job Classification

Research (ERSD# _________________) Education ____________

2. Required Service (machining, welding Etc... ) Machining/Wire EDM/Waterjet ____________________________________________________________ Andrew Abney
3. Requester: _______________________________________
4. Faculty Members Approval (electronic signature preferred) _________________________________________________ 10/2/2020
5. Date Submitted: _______________________
6. Job Description : Machine parts per LAS BOM and associated drawings.
_____________________________________________________________ _____________________________________________________________

## Submittal Instructions

Submit the following file types to Maefabfacility1228@gmail.com

- PDF file for quick reference during machining
- Part DWG (drawing, blue print etc.)
- 3D Solid Models ( Solid Works )
- Down load the Research Fabrication Request from MY MAE
- Use the following link to edit & sign PDFs free https://dochub.com/

Materials should be delivered to the Research Fabrication Facility (room

1228) after all Forms have been submitted to the following email address.

Maefabfacility1228@gmail.com

*Fill out the form. Then save before uploading to dochub for signature.
