corelab-umich/kiteCADRepo/solidworks/Exp Scale Manta Ray/PerformanceLog.txt

Number of Contacts: 42
Number of contact data: 5196
