corelab-umich/kiteCADRepo/solidworks/Pool Tow Testing - Full Scale/TOW FEA Simplified/PerformanceLog.txt

Number of Contacts: 8
Number of contact data: 1564
