corelab-umich/kiteCADRepo/solidworks/Pool Tow Testing - Full Scale/TOW FEA ANALYSIS Brainstorm/PerformanceLog.txt

Number of Contacts: 4
Number of contact data: 1228
