corelab-umich/kiteCADRepo/solidworks/Exp Scale Manta Ray/Tail Cone Assembly.pdf

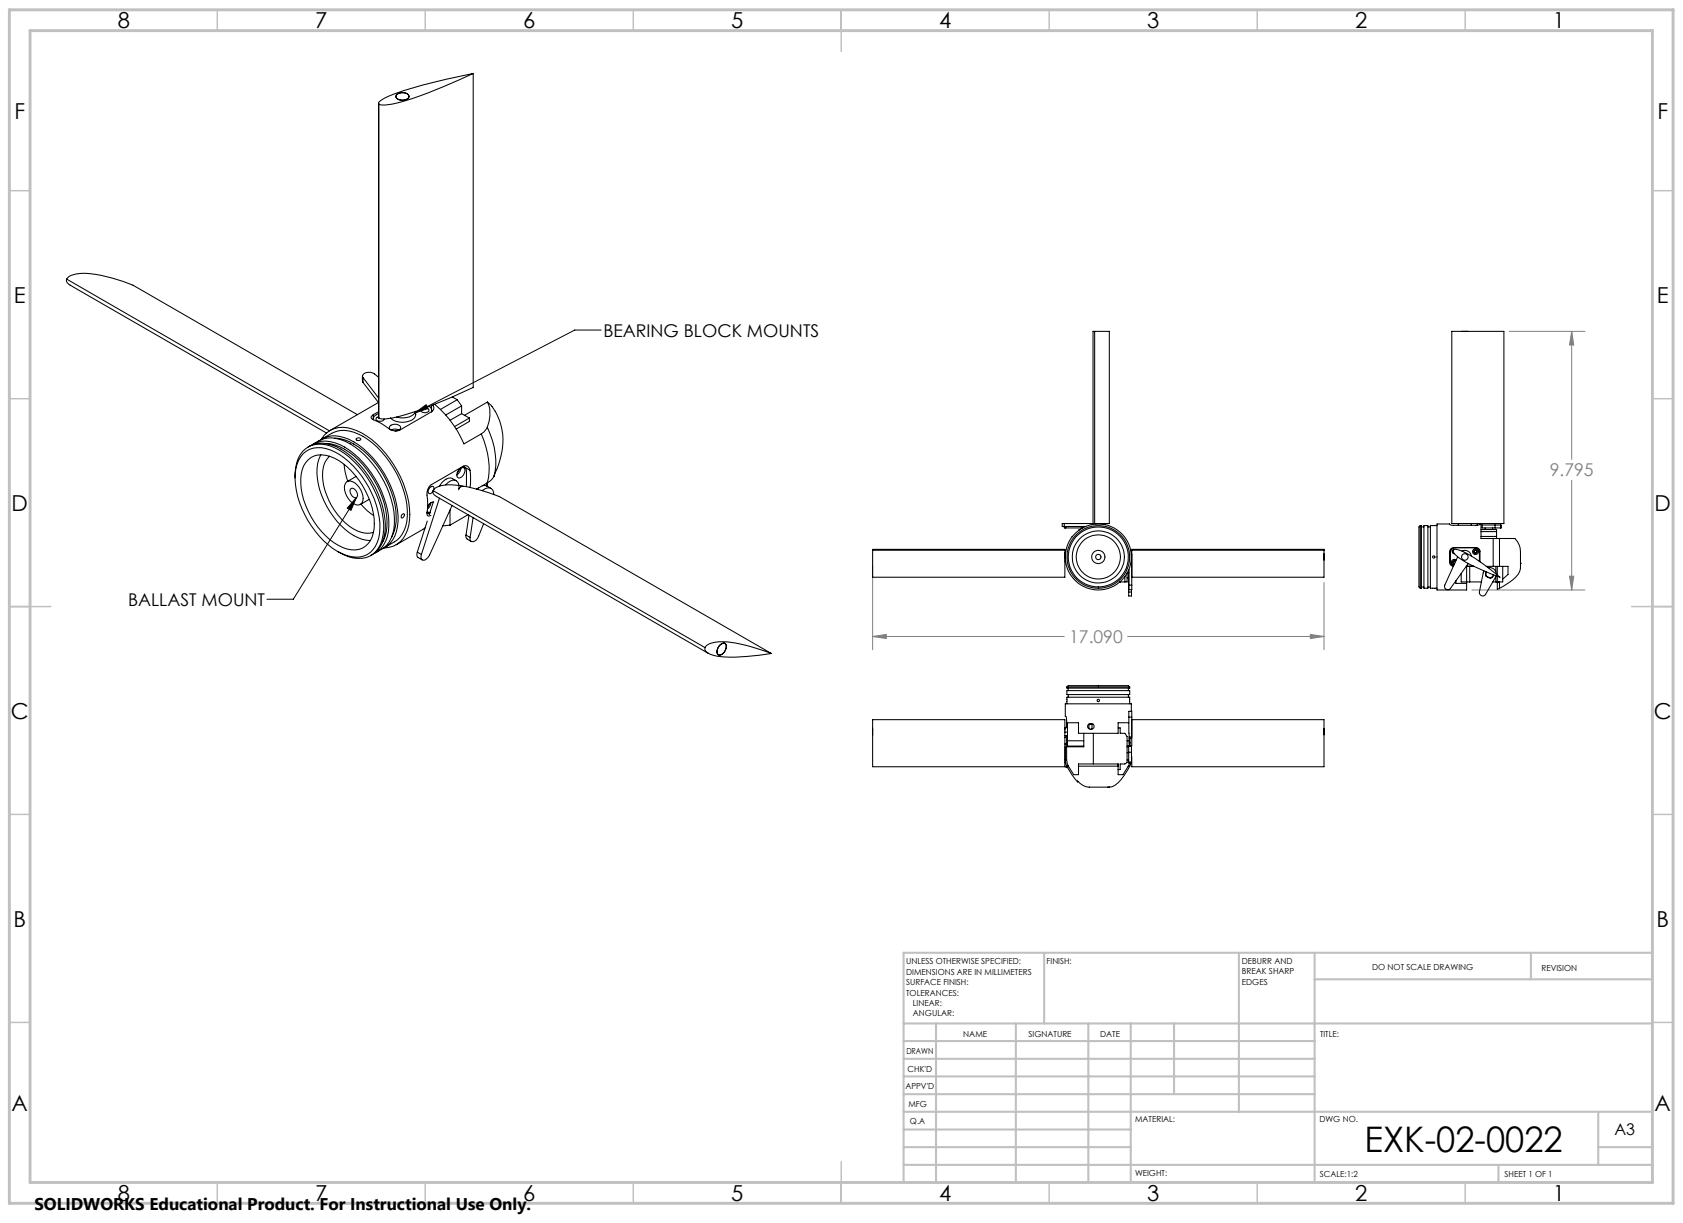
[picture p126: page 1]
BALLAST MOUNT; FINISH:; DEBURR AND; BREAK SHARP; DO NOT SCALE DRAWING; REVISION; SCALE:1:2; SHEET 1 OF 1

BEARING BLOCK MOUNTS

UNLESS OTHERWISE SPECIFIED:
DIMENSIONS ARE IN MILLIMETERS
SURFACE FINISH:
TOLERANCES:
LINEAR:
ANGULAR:

NAME | SIGNATURE | DATE | | | | TITLE:

DRAWN
CHK'D
APPV'D
MFG
Q.A | | | | MATERIAL: | DWG NO. EXK-02-0022 | A3

SOLIDWORKS Educational Product. For Instructional Use Only.
