corelab-umich/kiteCADRepo/solidworks/Exp Scale Manta Ray/Wing Assembly.PDF

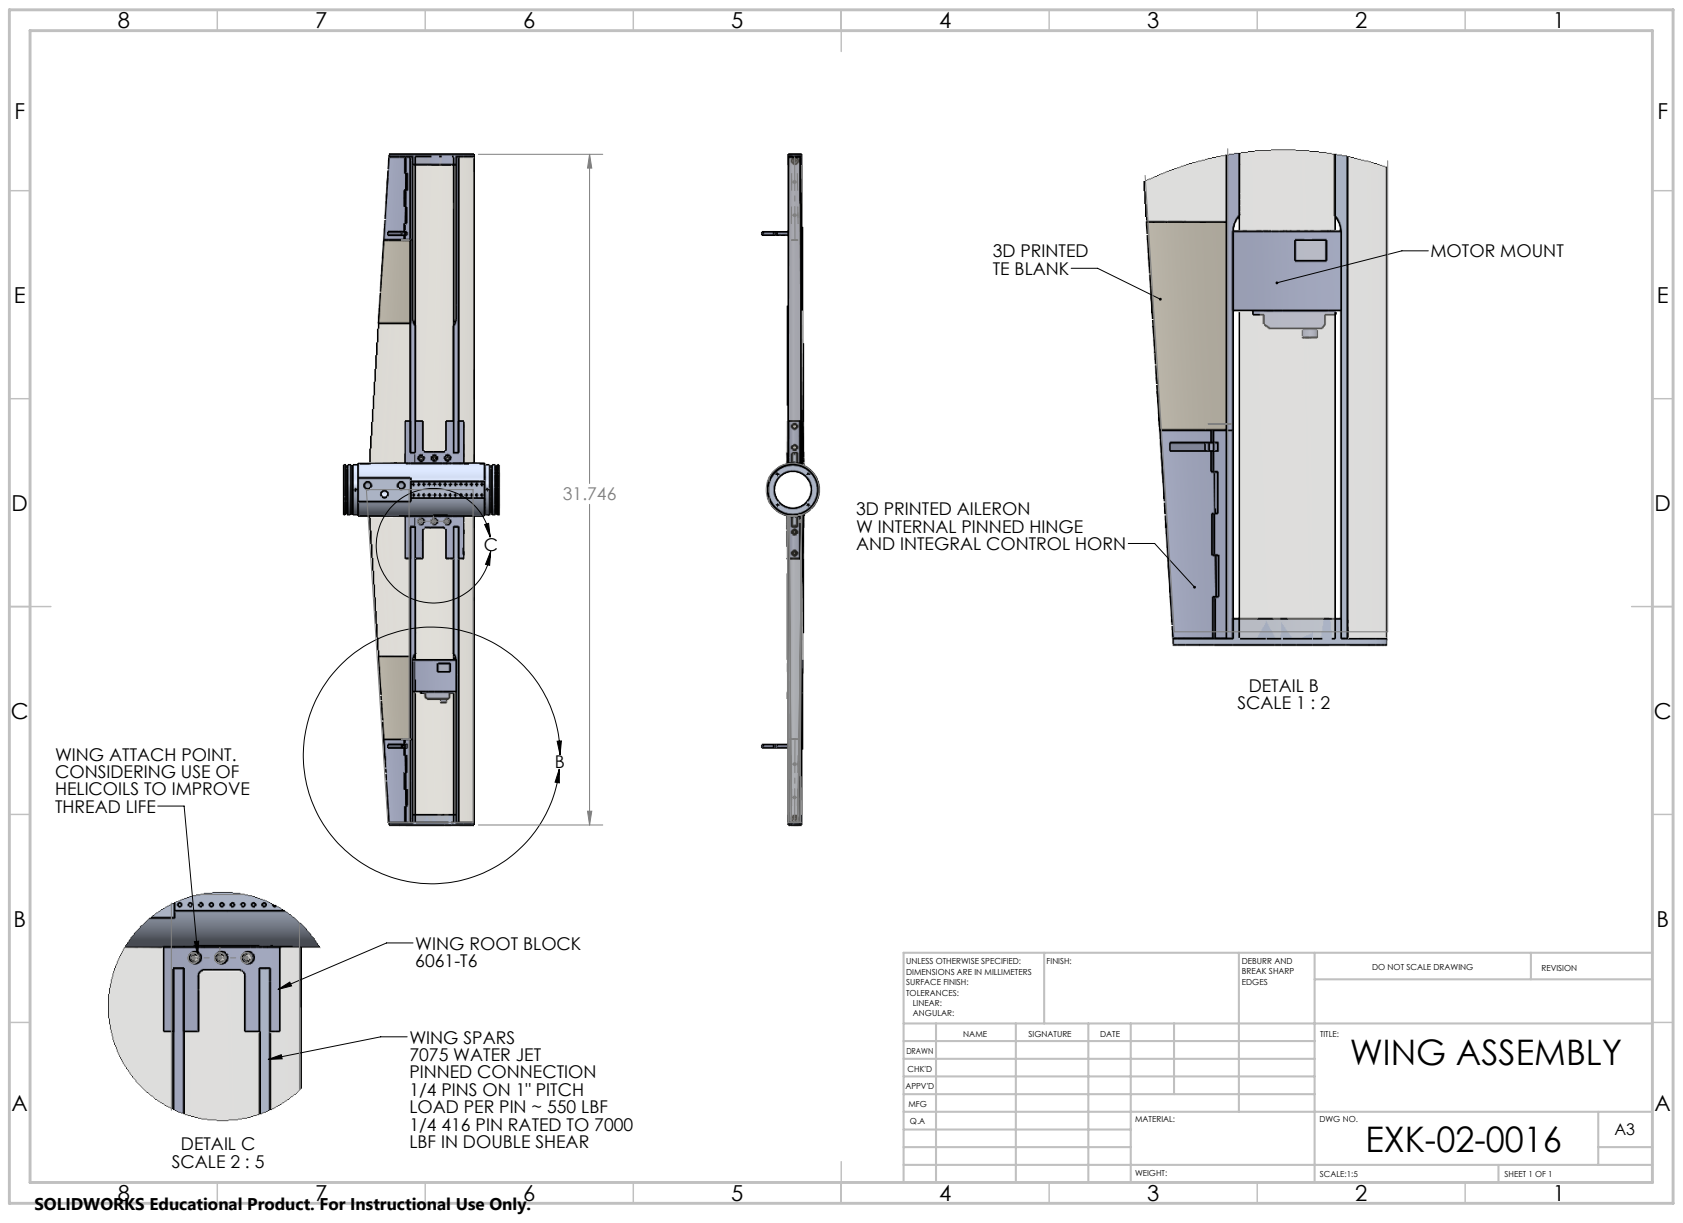
[picture p127: page 1]
DETAIL B SCALE 1 : 2; 3D PRINTED TE BLANK; MOTOR MOUNT; FINISH:; DEBURR AND; BREAK SHARP; DO NOT SCALE DRAWING; REVISION; SCALE:1:5; SHEET 1 OF 1

3D PRINTED AILERON
W INTERNAL PINNED HINGE
AND INTEGRAL CONTROL HORN

WING ATTACH POINT.
CONSIDERING USE OF
HELICOILS TO IMPROVE
THREAD LIFE

WING ROOT BLOCK

UNLESS OTHERWISE SPECIFIED:
DIMENSIONS ARE IN MILLIMETERS
SURFACE FINISH:
TOLERANCES:
LINEAR:
ANGULAR:

WING SPARS
7075 WATER JET
PINNED CONNECTION
1/4 PINS ON 1" PITCH
LOAD PER PIN ~ 550 LBF
1/4 416 PIN RATED TO 7000
LBF IN DOUBLE SHEAR

NAME | SIGNATURE | DATE | | | | TITLE: WING ASSEMBLY

DRAWN
CHK'D
APPV'D
MFG
Q.A | | | | MATERIAL: | DWG NO. EXK-02-0016 | A3

DETAIL C
SCALE 2 : 5
SOLIDWORKS Educational Product. For Instructional Use Only.
