corelab-umich/kiteCADRepo/solidworks/Exp Scale Manta Ray/EXK-01-0002_R1.PDF

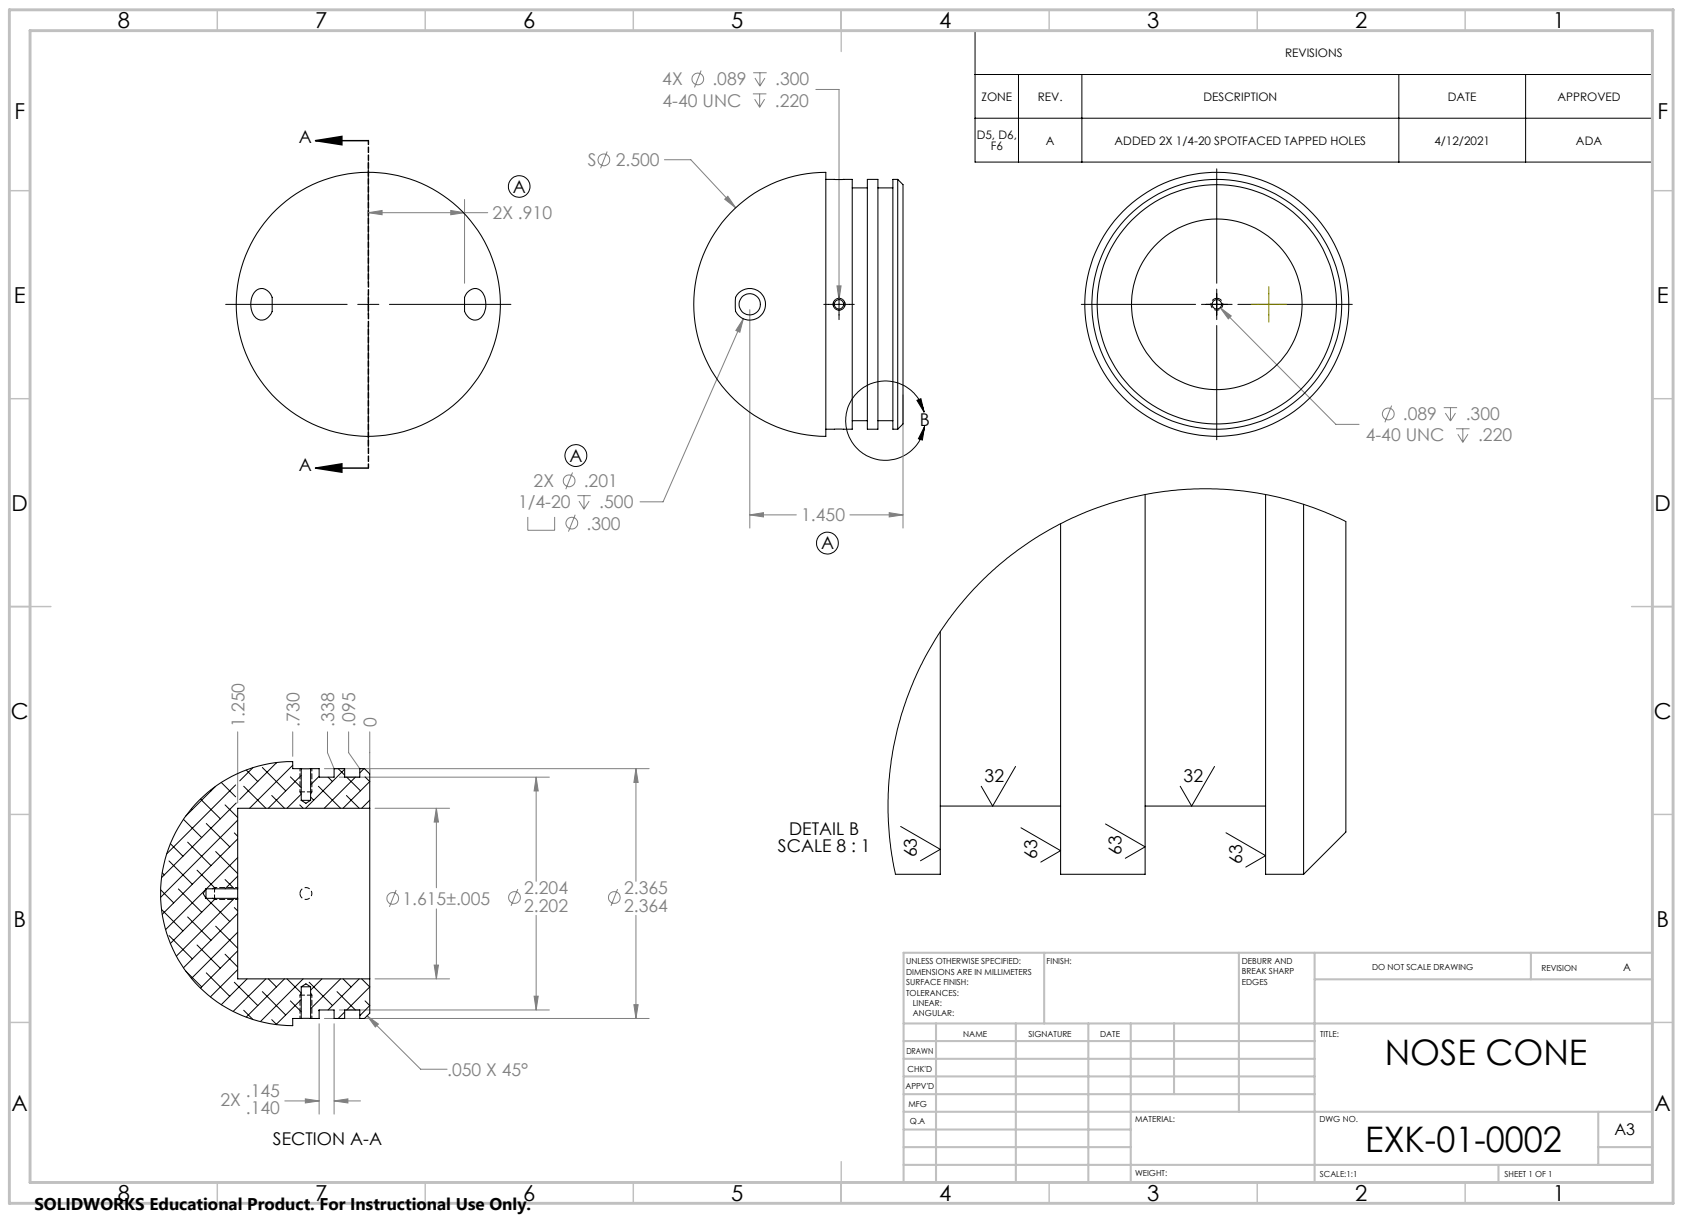
[picture p130: page 1]
4-40 UNC; SECTION A-A; DETAIL B SCALE 8 : 1; FINISH:; DEBURR AND; BREAK SHARP; DO NOT SCALE DRAWING; REVISION; SCALE:1:1; SHEET 1 OF 1

REVISIONS

ZONE | REV. | DESCRIPTION | DATE | APPROVED

D5, D6, F6 | A | ADDED 2X 1/4-20 SPOTFACED TAPPED HOLES | 4/12/2021 | ADA

UNLESS OTHERWISE SPECIFIED:
DIMENSIONS ARE IN MILLIMETERS
SURFACE FINISH:
TOLERANCES:
LINEAR:
ANGULAR:

NAME | SIGNATURE | DATE | | | | TITLE: NOSE CONE

DRAWN
CHK'D
APPV'D
MFG
Q.A | | | | MATERIAL: | DWG NO. EXK-01-0002 | A3

SOLIDWORKS Educational Product. For Instructional Use Only.
