corelab-umich/kiteCADRepo/solidworks/Exp Scale Manta Ray/EXK-01-0008-01_RevB.PDF

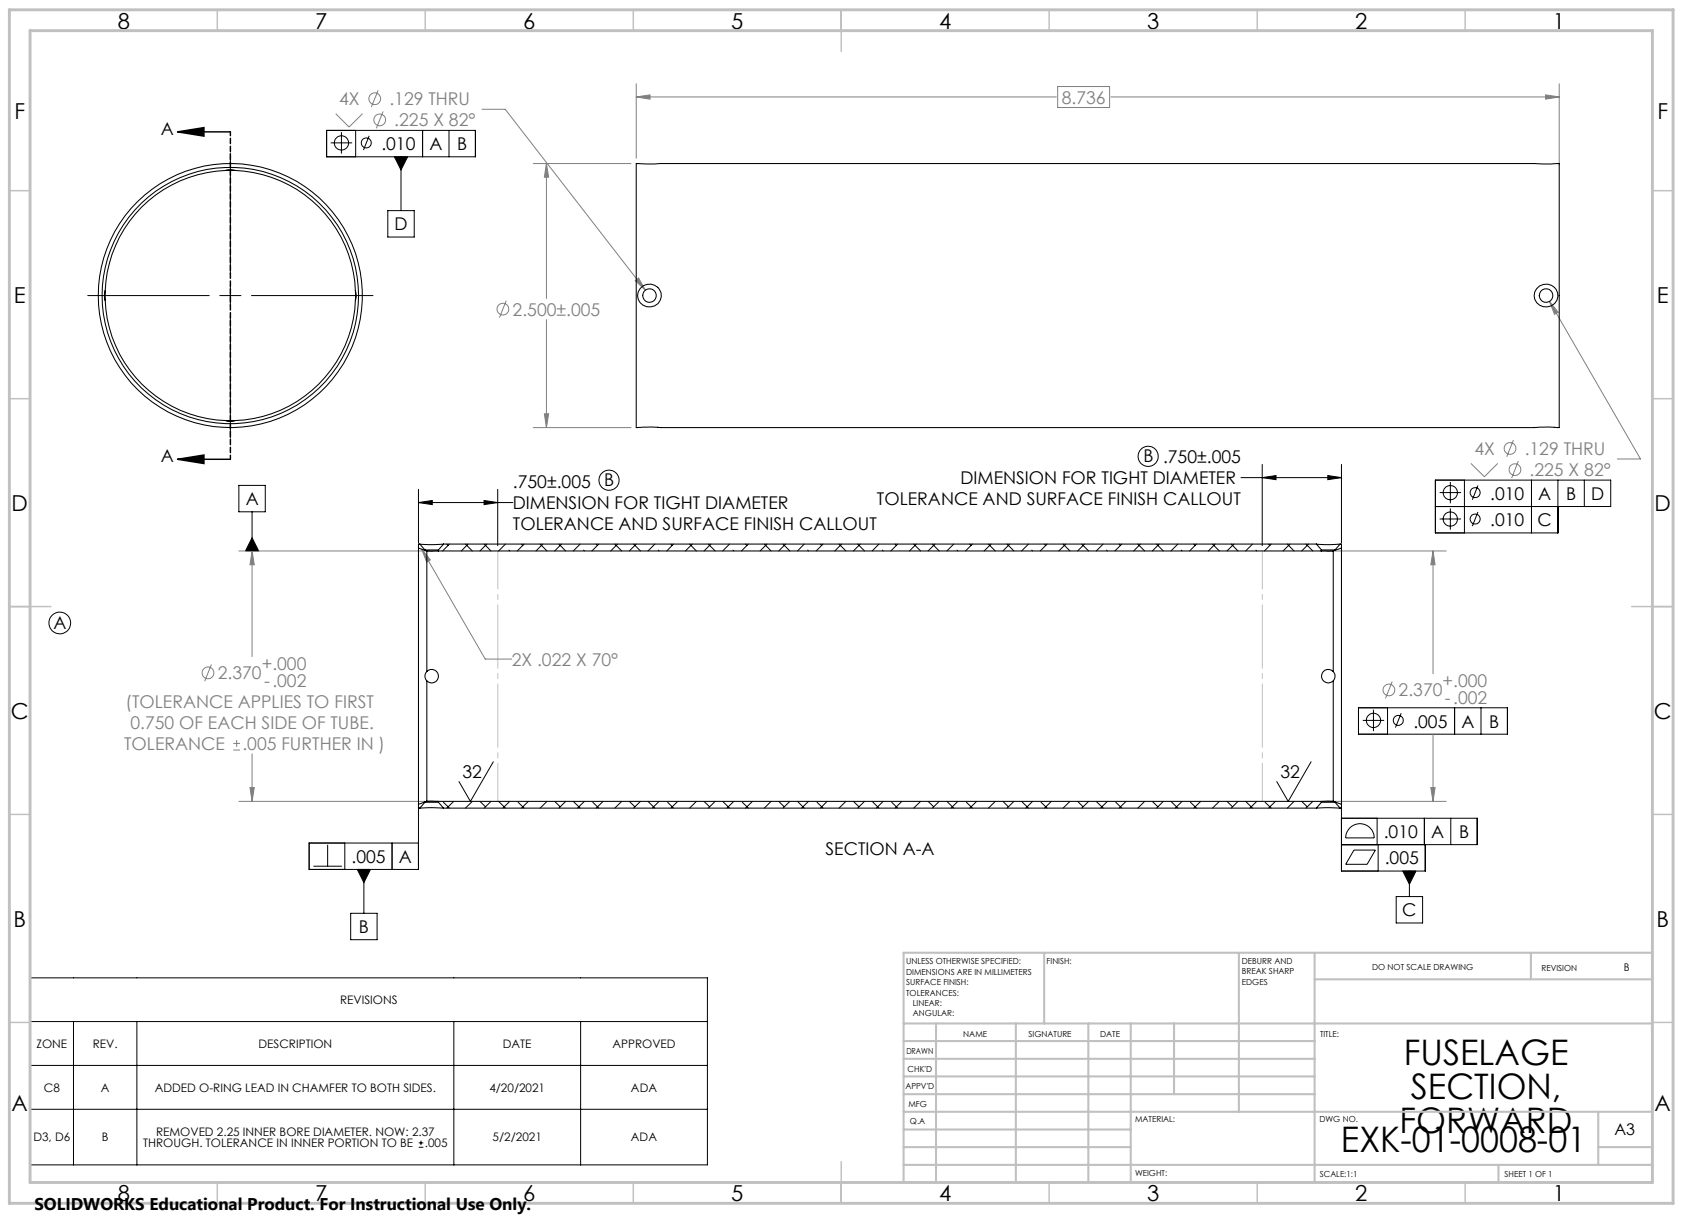
[picture p131: page 1]
.129 THRU; TOLERANCE; .005 FURTHER IN ); SECTION A-A; REMOVED 2.25 INNER BORE DIAMETER. NOW: 2.37; THROUGH. TOLERANCE IN INNER PORTION TO BE .005; ADA; FINISH:; DEBURR AND; BREAK SHARP; DO NOT SCALE DRAWING; REVISION; DWG NO.; SCALE:1:1; SHEET 1 OF 1

DIMENSION FOR TIGHT DIAMETER
TOLERANCE AND SURFACE FINISH CALLOUT

(TOLERANCE APPLIES TO FIRST
0.750 OF EACH SIDE OF TUBE.

UNLESS OTHERWISE SPECIFIED:
DIMENSIONS ARE IN MILLIMETERS
SURFACE FINISH:
TOLERANCES:
LINEAR:
ANGULAR:

DRAWN
CHK'D
APPV'D
MFG

C8 | A | ADDED O-RING LEAD IN CHAMFER TO BOTH SIDES. | 4/20/2021 | ADA

SOLIDWORKS Educational Product. For Instructional Use Only.
