corelab-umich/kiteCADRepo/solidworks/Exp Scale Manta Ray/EXK-01-0008-02_Revb.PDF

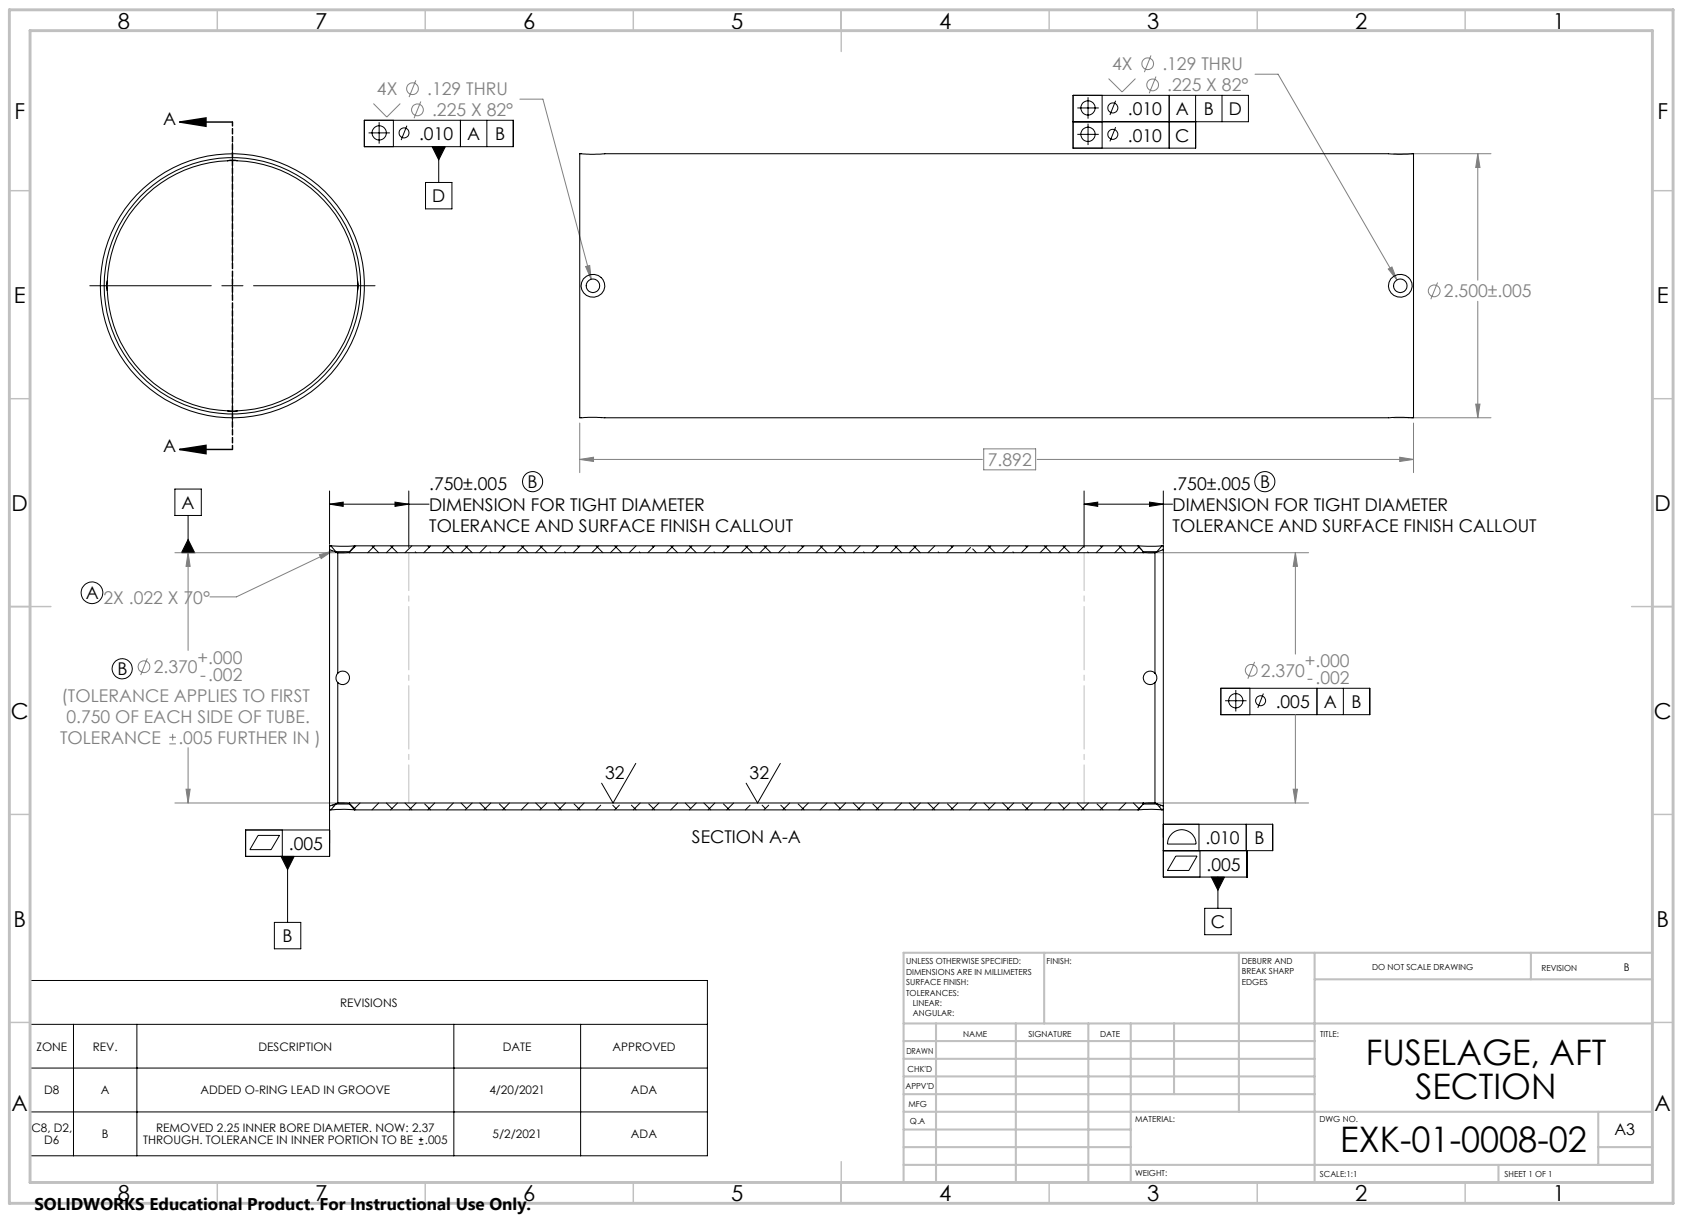
[picture p132: page 1]
TOLERANCE; .005 FURTHER IN ); SECTION A-A; .129 THRU; REMOVED 2.25 INNER BORE DIAMETER. NOW: 2.37; THROUGH. TOLERANCE IN INNER PORTION TO BE .005; ADA; FINISH:; DEBURR AND; BREAK SHARP; DO NOT SCALE DRAWING; REVISION; DWG NO.; SCALE:1:1; SHEET 1 OF 1; FUSELAGE, AFT

DIMENSION FOR TIGHT DIAMETER
TOLERANCE AND SURFACE FINISH CALLOUT

(TOLERANCE APPLIES TO FIRST
0.750 OF EACH SIDE OF TUBE.

UNLESS OTHERWISE SPECIFIED:
DIMENSIONS ARE IN MILLIMETERS
SURFACE FINISH:
TOLERANCES:
LINEAR:
ANGULAR:

DRAWN
CHK'D
APPV'D
MFG

D8 | A | ADDED O-RING LEAD IN GROOVE | 4/20/2021 | ADA

SOLIDWORKS Educational Product. For Instructional Use Only.
