corelab-umich/kiteCADRepo/solidworks/Exp Scale Manta Ray/EXK-02-0017.pdf

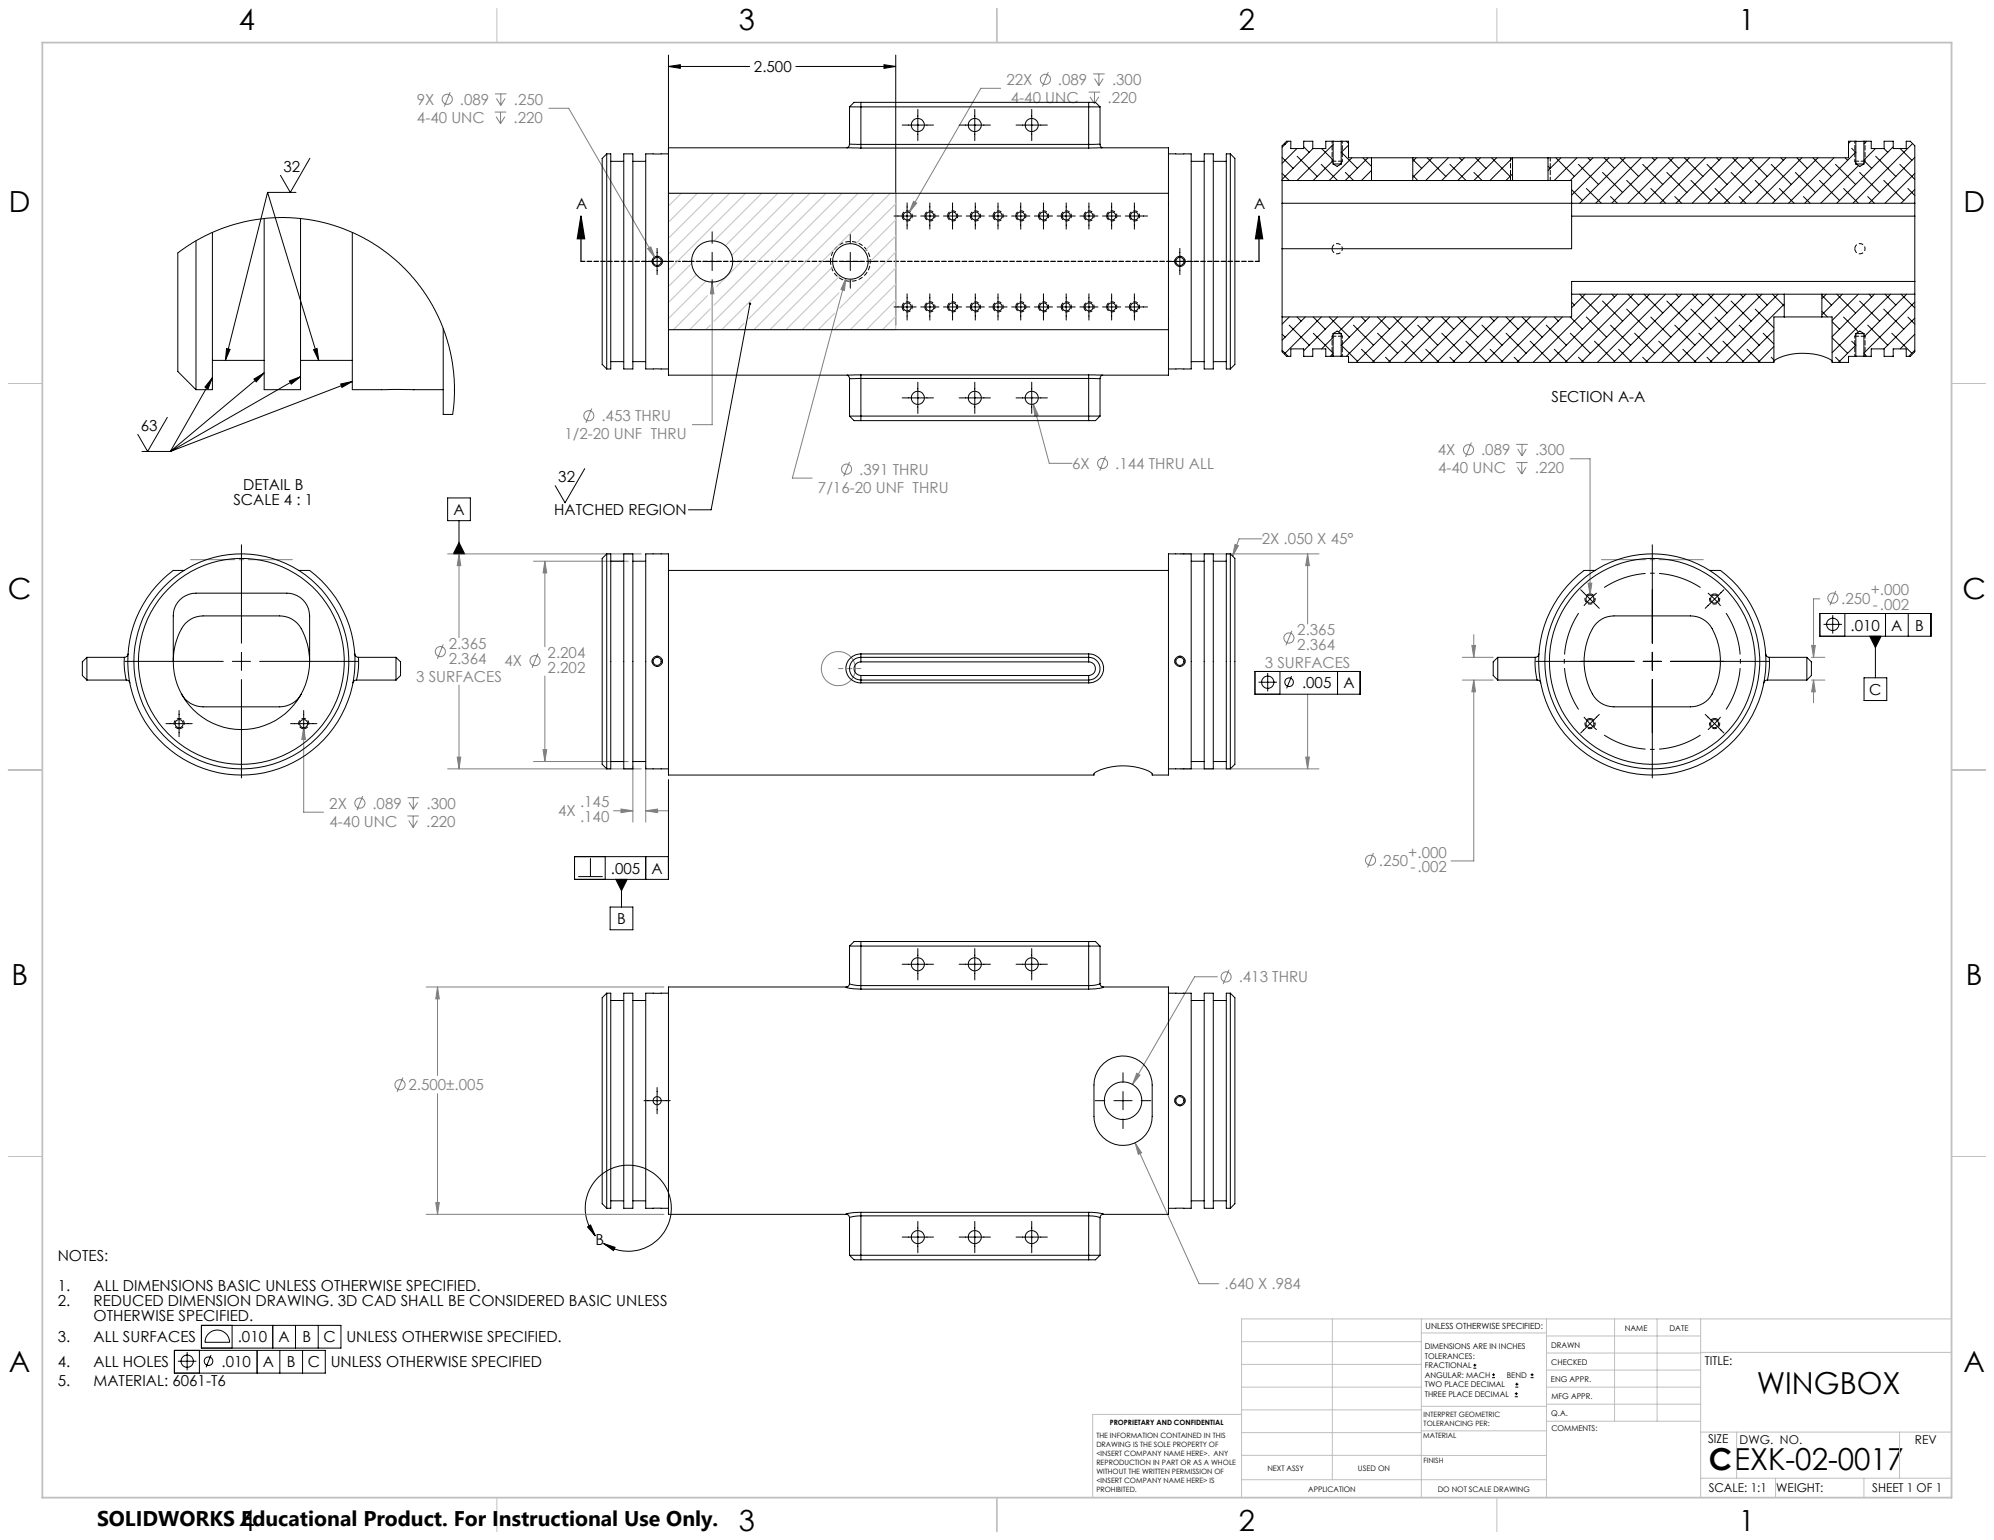
[picture p134: page 1]
4-40 UNC; 3 SURFACES; .144 THRU ALL; .453 THRU 1/2-20 UNF THRU; .391 THRU 7/16-20 UNF THRU; HATCHED REGION; .413 THRU; DETAIL B SCALE 4 : 1; SECTION A-A; 3. ALL SURFACES; UNLESS OTHERWISE SPECIFIED.; 4. ALL HOLES; UNLESS OTHERWISE SPECIFIED

NOTES:
1. ALL DIMENSIONS BASIC UNLESS OTHERWISE SPECIFIED.
2. REDUCED DIMENSION DRAWING. 3D CAD SHALL BE CONSIDERED BASIC UNLESS
OTHERWISE SPECIFIED.
5. MATERIAL: 6061-T6

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

CHECKED | | | TITLE: WINGBOX

ENG APPR.
MFG APPR.

INTERPRET GEOMETRIC TOLERANCING PER: | Q.A.
MATERIAL | | SIZE C EXK-02-0017 | DWG. NO. | REV

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

NEXT ASSY | USED ON | FINISH

APPLICATION | DO NOT SCALE DRAWING | | SCALE: 1:1 | WEIGHT: | SHEET 1 OF 1

SOLIDWORKS Educational Product. For Instructional Use Only.
