corelab-umich/kiteCADRepo/solidworks/Exp Scale Manta Ray/EXK-01-0014-01.pdf

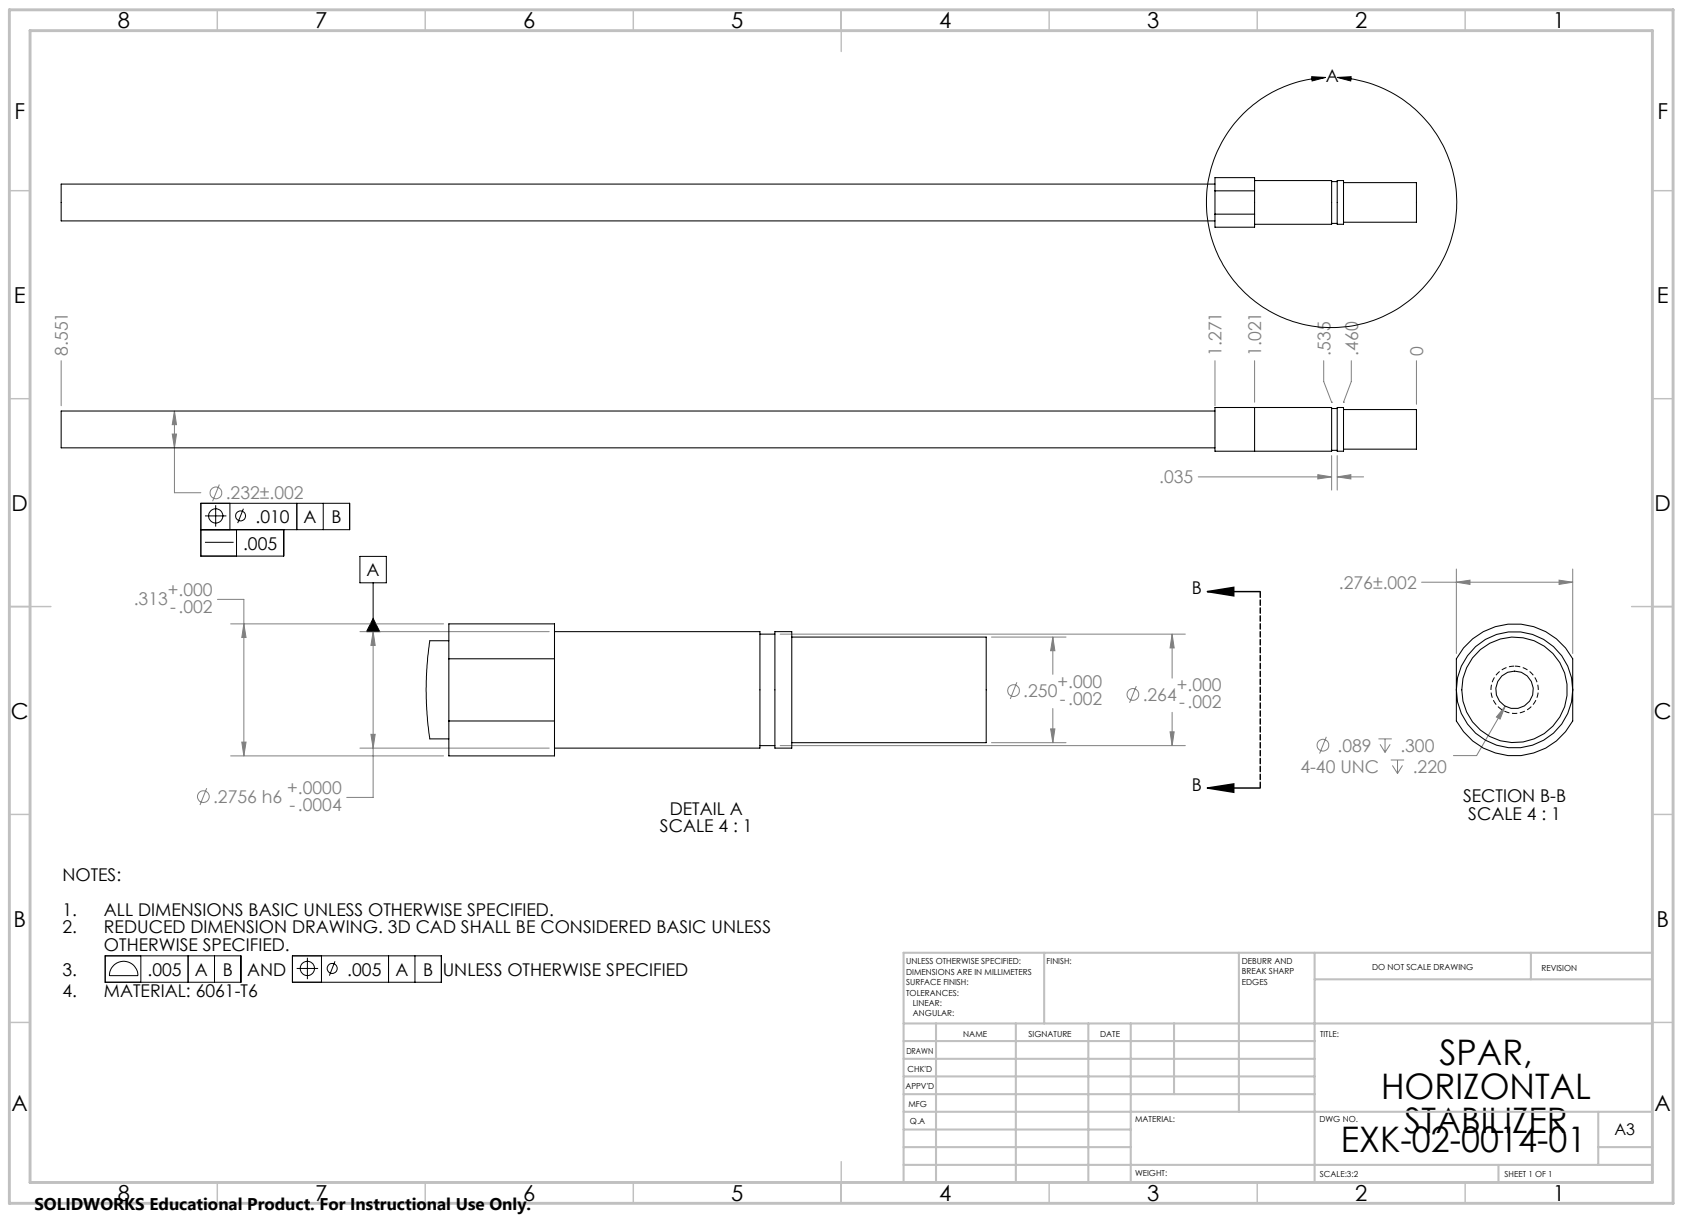
[picture p135: page 1]
DETAIL A SCALE 4 : 1; 4-40 UNC; SECTION B-B SCALE 4 : 1; AND; UNLESS OTHERWISE SPECIFIED; FINISH:; DEBURR AND; BREAK SHARP; DO NOT SCALE DRAWING; REVISION; SCALE:3:2; SHEET 1 OF 1

.010 | A | B
.005

NOTES:
1. ALL DIMENSIONS BASIC UNLESS OTHERWISE SPECIFIED.
2. REDUCED DIMENSION DRAWING. 3D CAD SHALL BE CONSIDERED BASIC UNLESS
OTHERWISE SPECIFIED.
4. MATERIAL: 6061-T6

UNLESS OTHERWISE SPECIFIED:
DIMENSIONS ARE IN MILLIMETERS
SURFACE FINISH:
TOLERANCES:
LINEAR:
ANGULAR:

NAME | SIGNATURE | DATE | | | | TITLE: SPAR, HORIZONTAL

DRAWN
CHK'D
APPV'D
Q.A | | | | MATERIAL: | STABILIZER DWG NO. EXK-02-0014-01 | A3
MFG

SOLIDWORKS Educational Product. For Instructional Use Only.
