corelab-umich/kiteCADRepo/solidworks/Exp Scale Manta Ray/EXK-02-0009-01.pdf

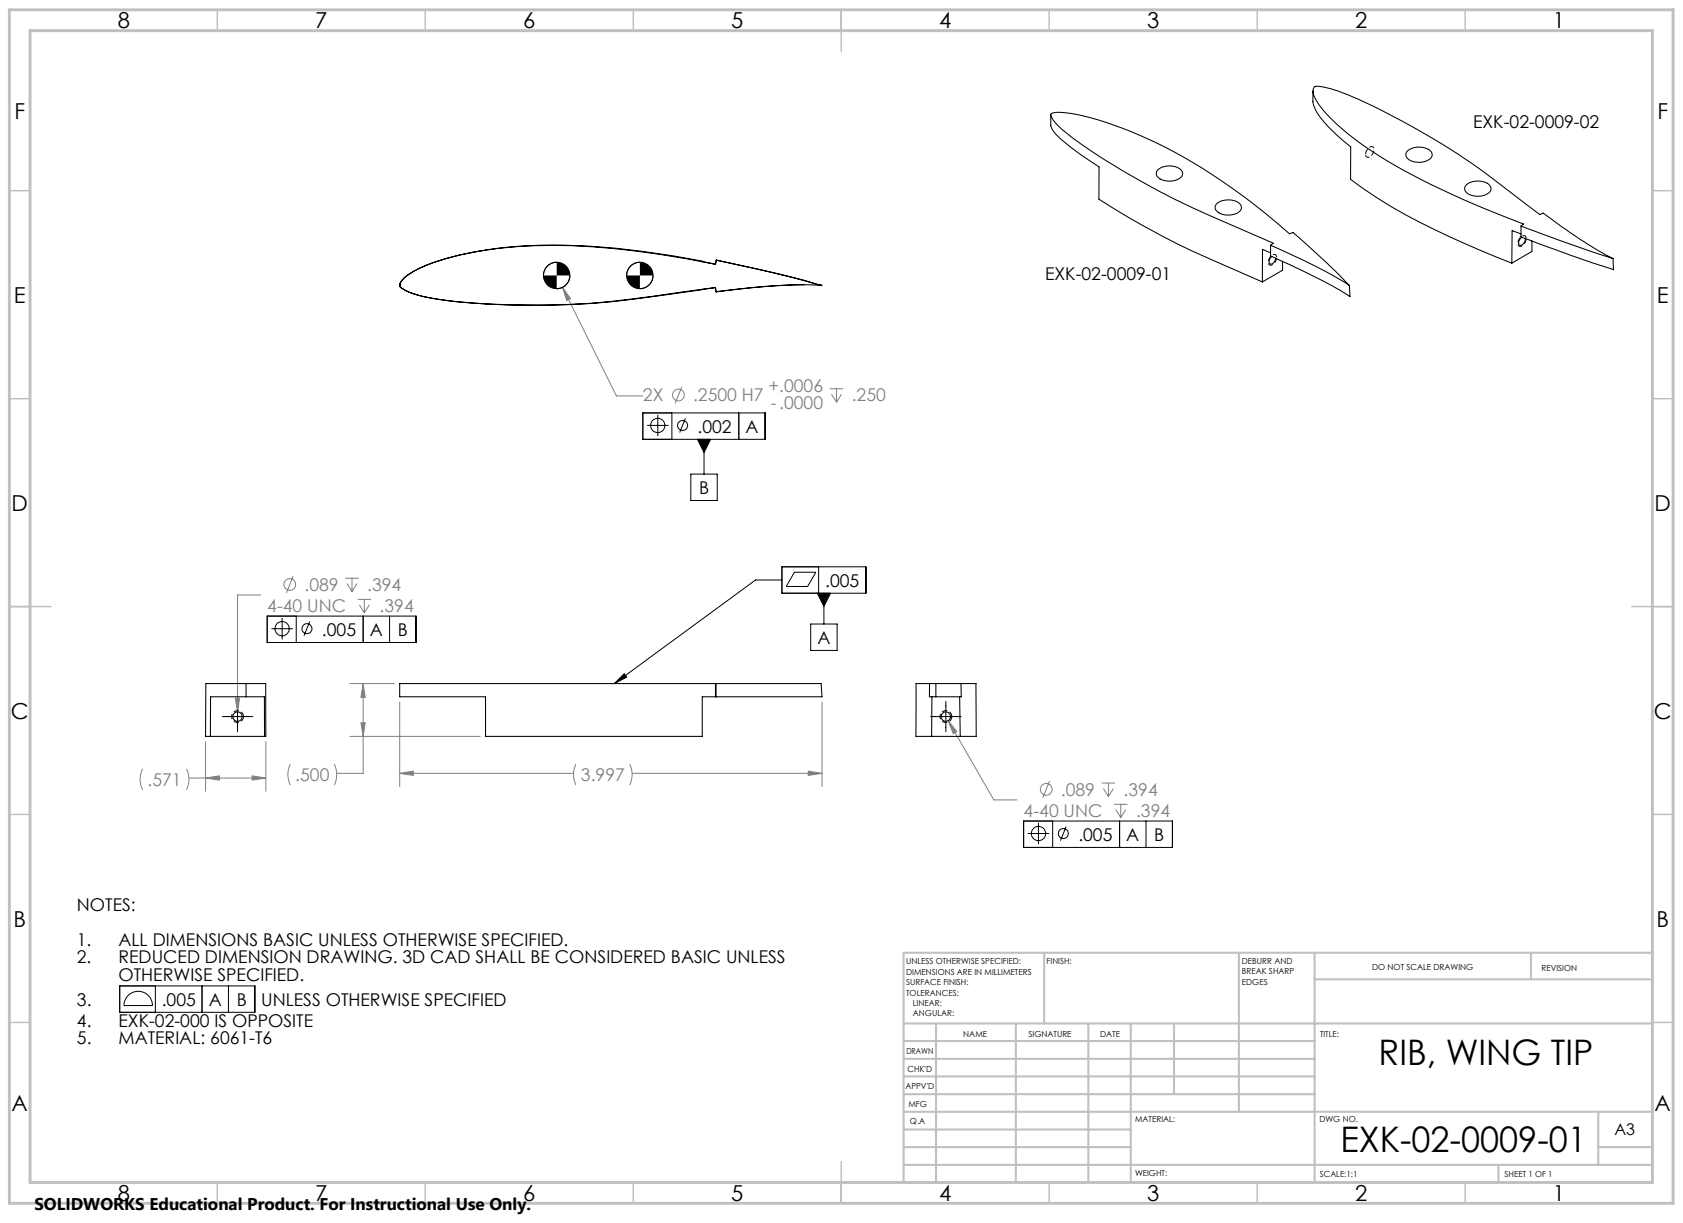
[picture p137: page 1]
4-40 UNC; UNLESS OTHERWISE SPECIFIED; FINISH:; DEBURR AND; BREAK SHARP; DO NOT SCALE DRAWING; REVISION; SCALE:1:1; SHEET 1 OF 1

NOTES:
1. ALL DIMENSIONS BASIC UNLESS OTHERWISE SPECIFIED.
2. REDUCED DIMENSION DRAWING. 3D CAD SHALL BE CONSIDERED BASIC UNLESS
OTHERWISE SPECIFIED.
4. EXK-02-000 IS OPPOSITE
5. MATERIAL: 6061-T6

UNLESS OTHERWISE SPECIFIED:
DIMENSIONS ARE IN MILLIMETERS
SURFACE FINISH:
TOLERANCES:
LINEAR:
ANGULAR:

NAME | SIGNATURE | DATE | | | | TITLE: RIB, WING TIP

DRAWN
CHK'D
APPV'D
MFG
Q.A | | | | MATERIAL: | DWG NO. EXK-02-0009-01 | A3

SOLIDWORKS Educational Product. For Instructional Use Only.
