corelab-umich/kiteCADRepo/solidworks/Exp Scale Manta Ray/Nose Cone.pdf

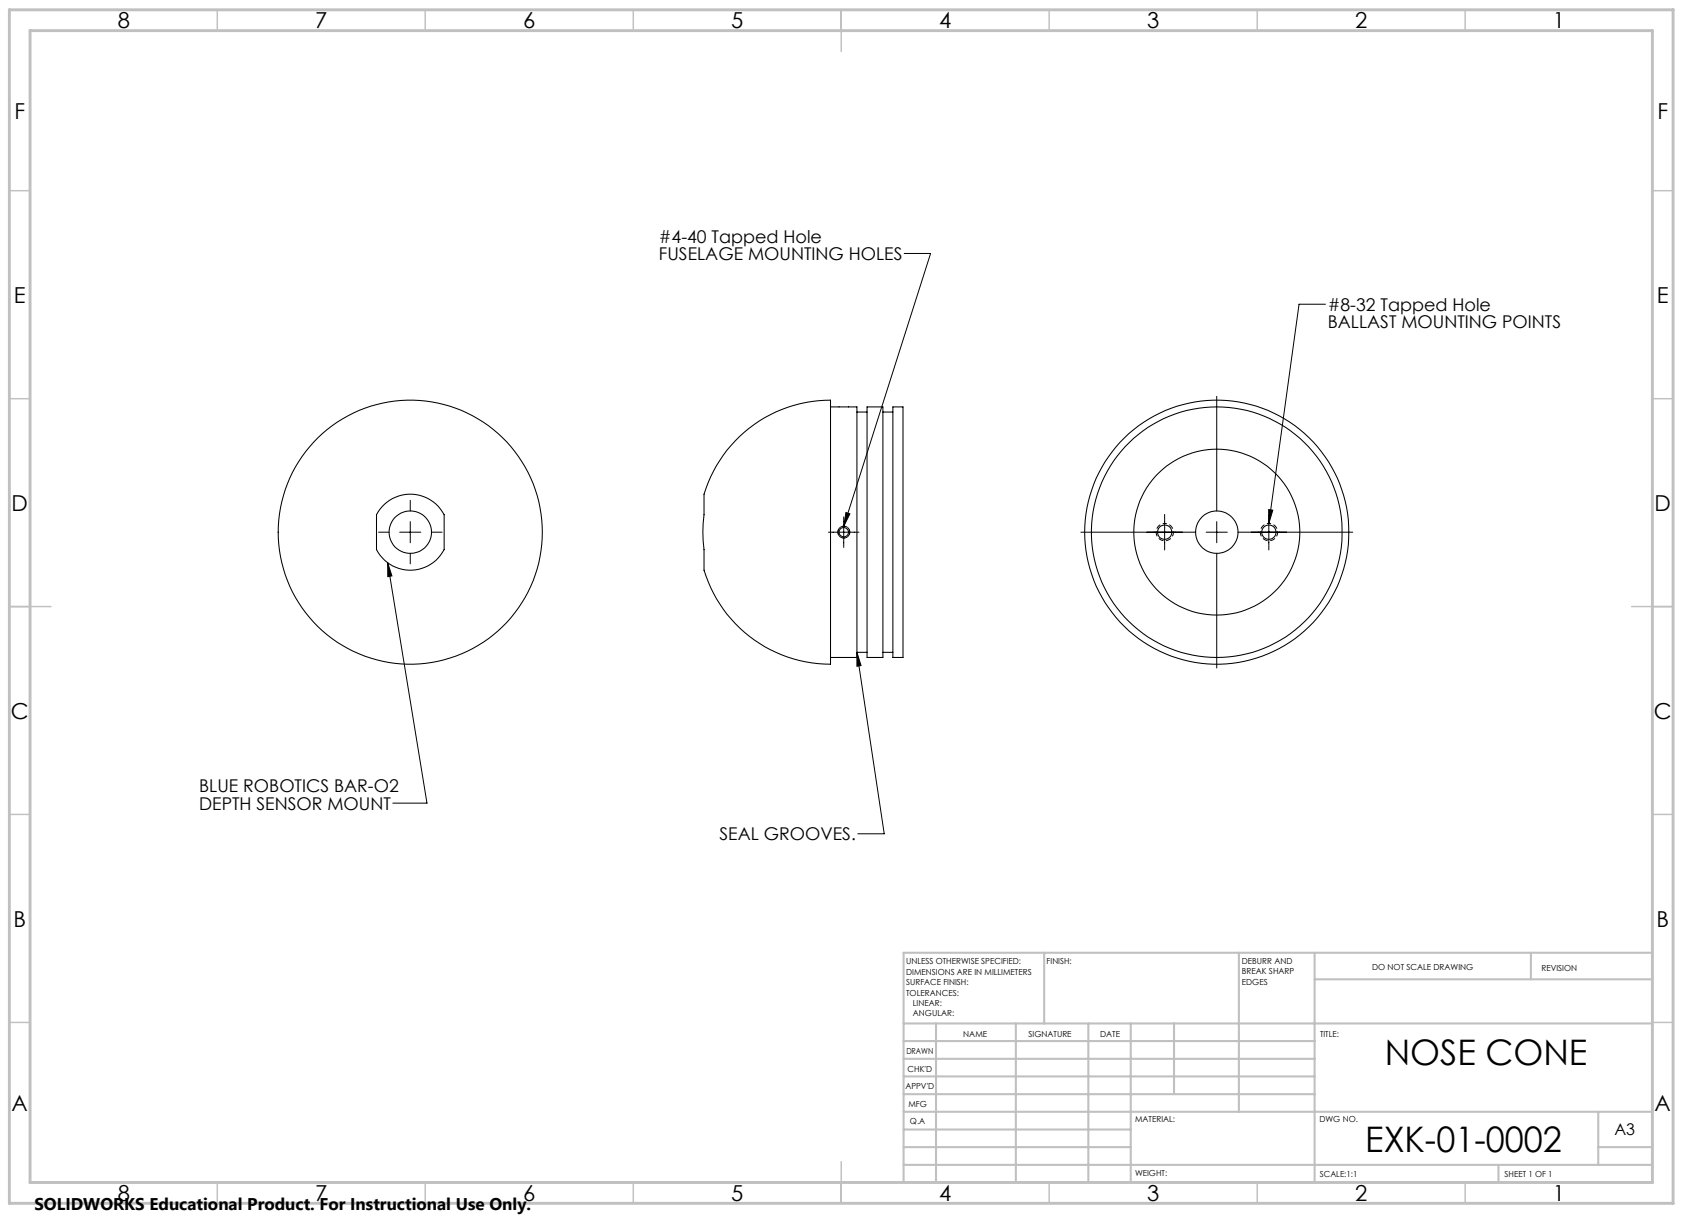
[picture p138: page 1]
SEAL GROOVES.; FINISH:; DEBURR AND; BREAK SHARP; DO NOT SCALE DRAWING; REVISION; SCALE:1:1; SHEET 1 OF 1

#4-40 Tapped Hole
FUSELAGE MOUNTING HOLES

#8-32 Tapped Hole
BALLAST MOUNTING POINTS

BLUE ROBOTICS BAR-O2
DEPTH SENSOR MOUNT

UNLESS OTHERWISE SPECIFIED:
DIMENSIONS ARE IN MILLIMETERS
SURFACE FINISH:
TOLERANCES:
LINEAR:
ANGULAR:

NAME | SIGNATURE | DATE | | | | TITLE: NOSE CONE

DRAWN
CHK'D
APPV'D
MFG
Q.A | | | | MATERIAL: | DWG NO. EXK-01-0002 | A3

SOLIDWORKS Educational Product. For Instructional Use Only.
