corelab-umich/kiteCADRepo/solidworks/Exp Scale Manta Ray/Stabilizer Bearing Block.pdf

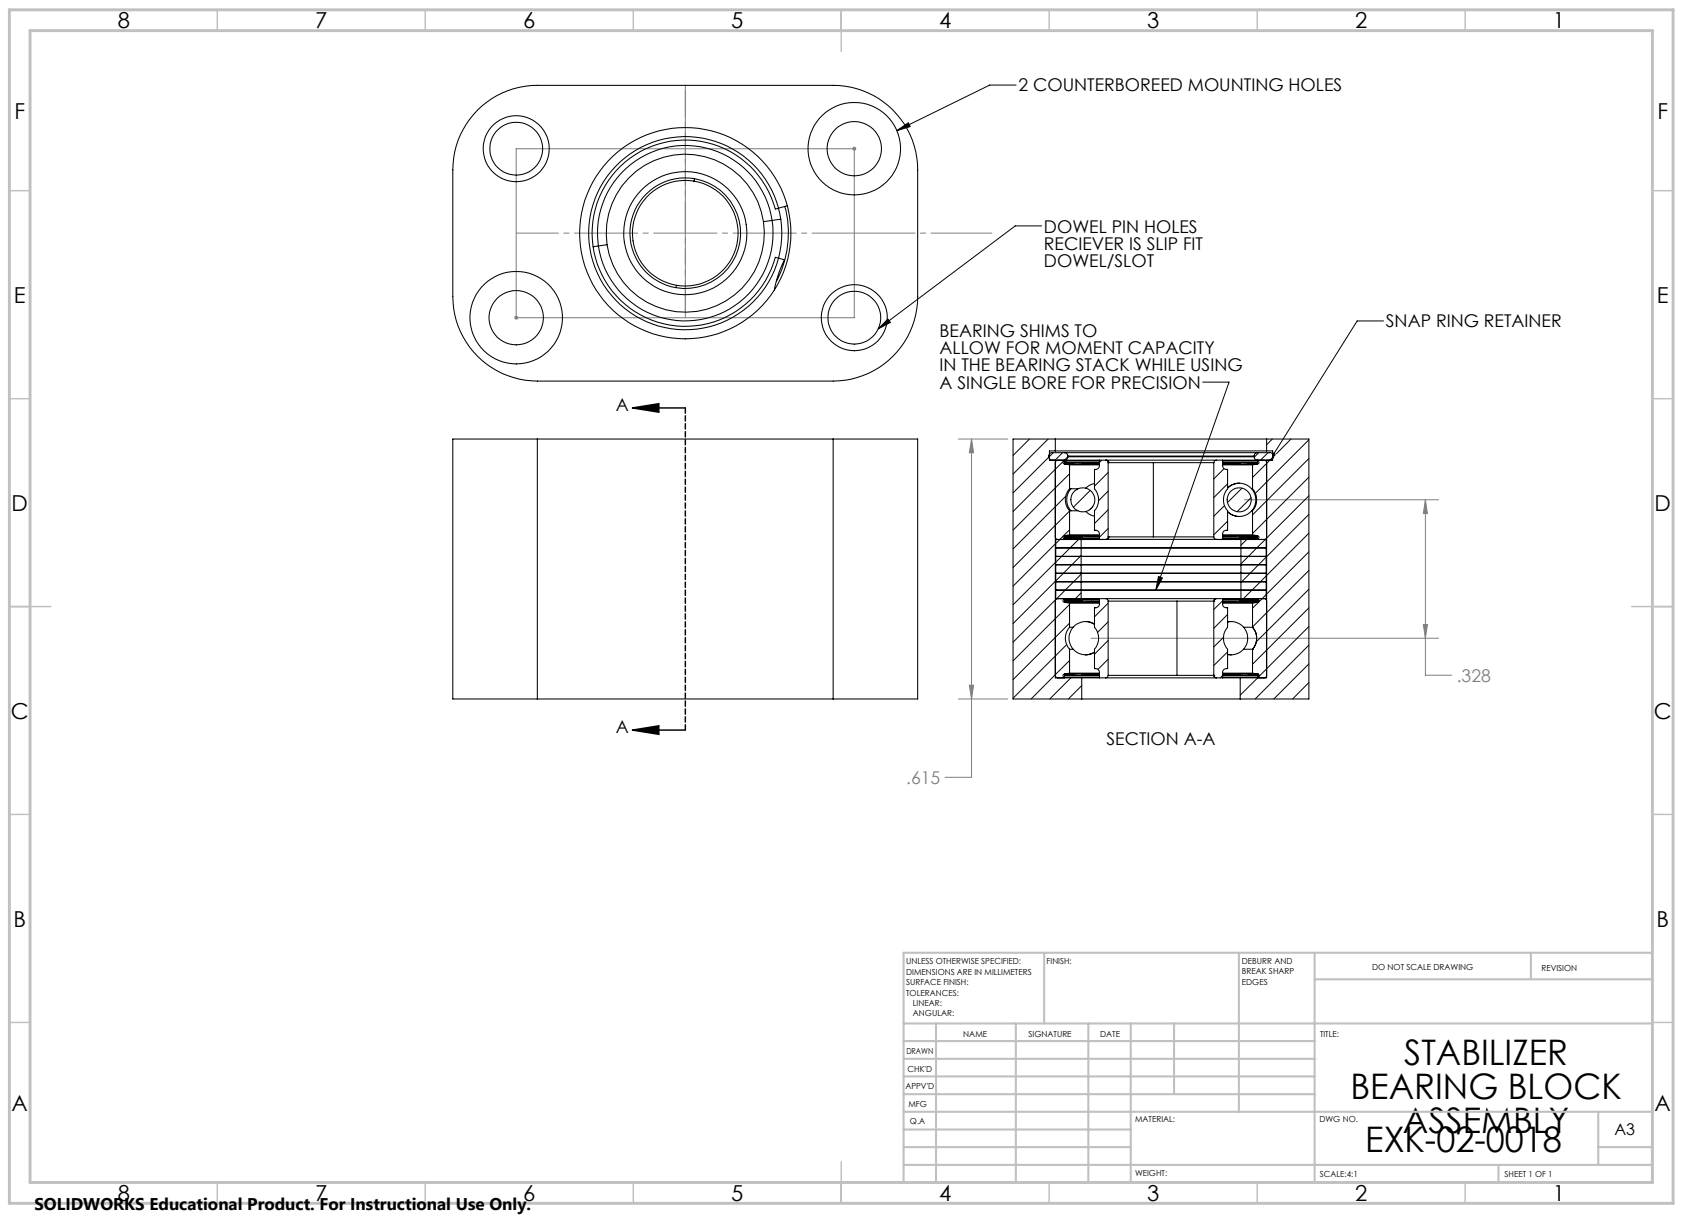
[picture p139: page 1]
SECTION A-A; FINISH:; DEBURR AND; BREAK SHARP; DO NOT SCALE DRAWING; REVISION; SCALE:4:1; SHEET 1 OF 1

2 COUNTERBOREED MOUNTING HOLES

DOWEL PIN HOLES
RECIEVER IS SLIP FIT
DOWEL/SLOT

SNAP RING RETAINER BEARING SHIMS TO
ALLOW FOR MOMENT CAPACITY
IN THE BEARING STACK WHILE USING
A SINGLE BORE FOR PRECISION

UNLESS OTHERWISE SPECIFIED:
DIMENSIONS ARE IN MILLIMETERS
SURFACE FINISH:
TOLERANCES:
LINEAR:
ANGULAR:

NAME | SIGNATURE | DATE | | | | TITLE: STABILIZER BEARING BLOCK

DRAWN
CHK'D
APPV'D
Q.A | | | | MATERIAL: | ASSEMBLY DWG NO. EXK-02-0018 | A3
MFG

SOLIDWORKS Educational Product. For Instructional Use Only.
