corelab-umich/kiteCADRepo/solidworks/Exp Scale Manta Ray/Stabilzer.pdf

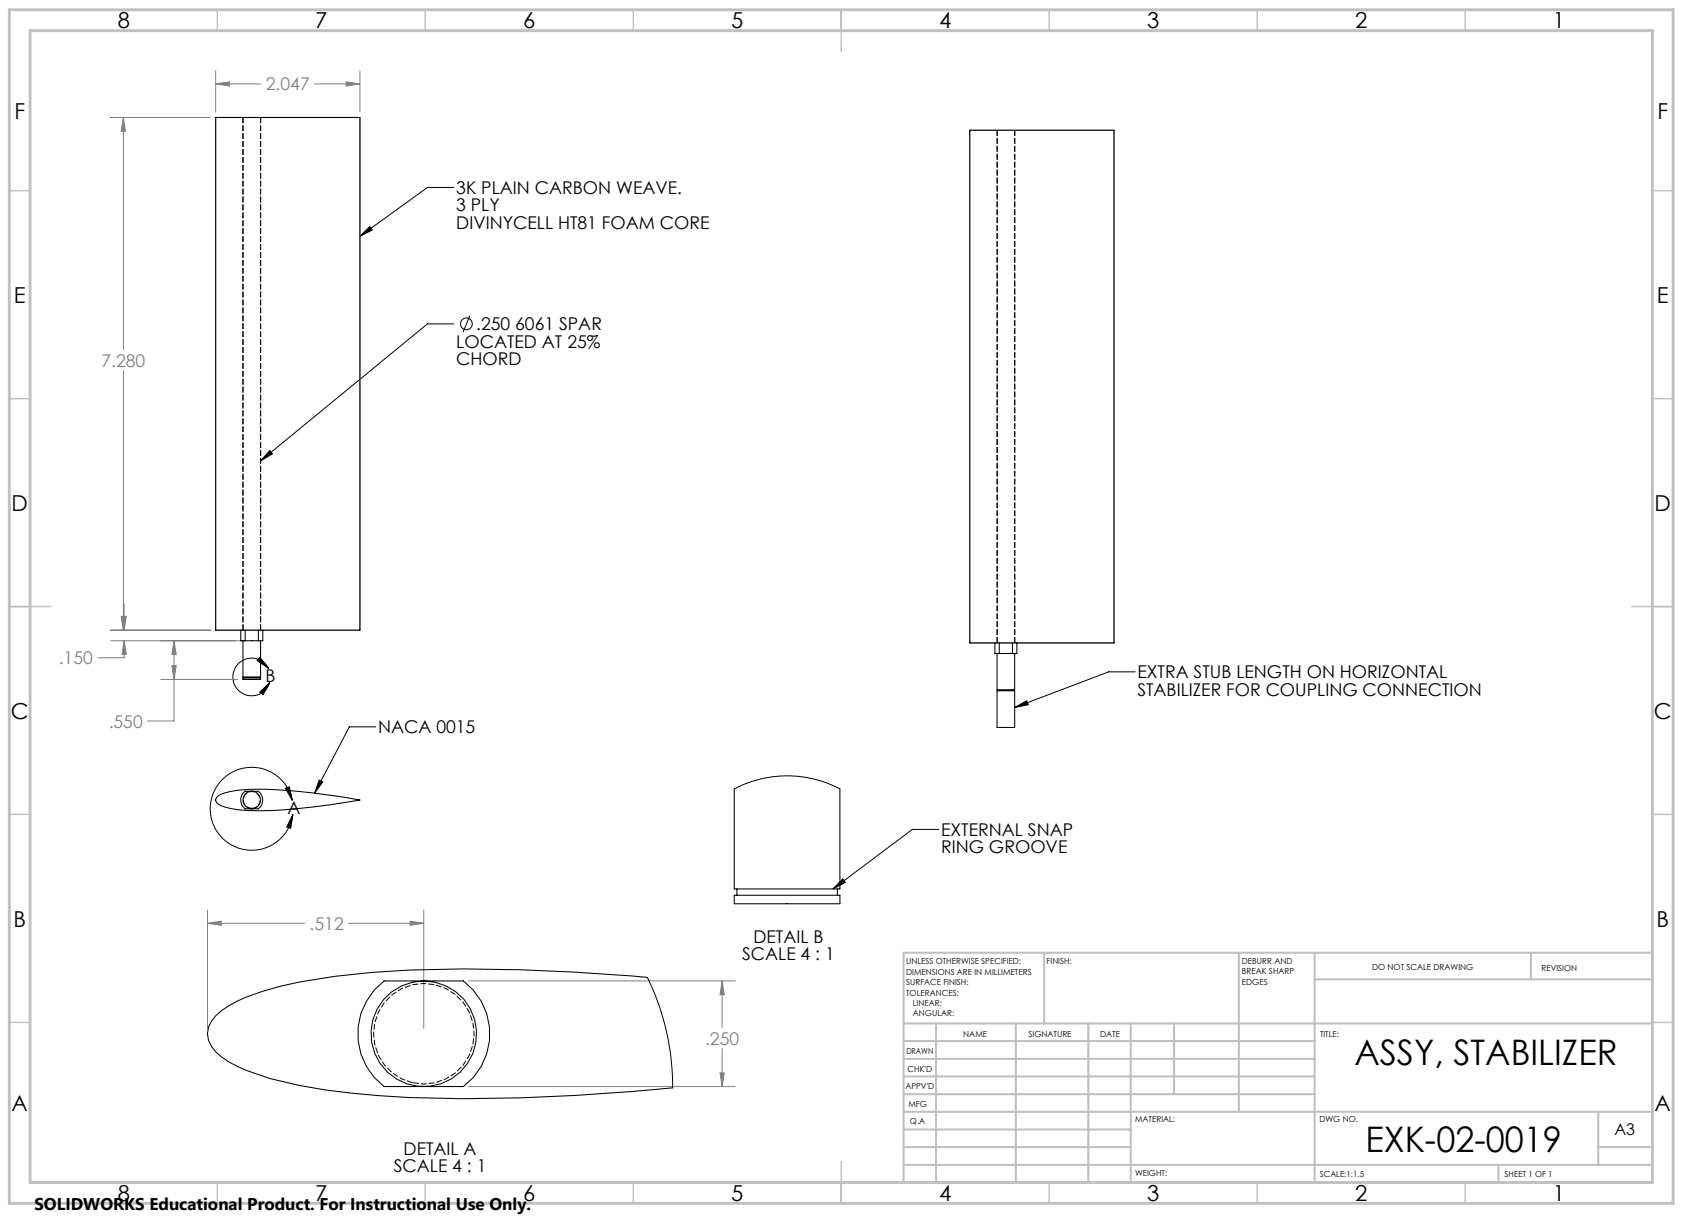
[picture p140: page 1]
.250 6061 SPAR LOCATED AT 25%; NACA 0015; DETAIL A SCALE 4 : 1; DETAIL B SCALE 4 : 1; EXTERNAL SNAP RING GROOVE; FINISH:; DEBURR AND; BREAK SHARP; DO NOT SCALE DRAWING; REVISION; SCALE:1:1.5; SHEET 1 OF 1

3K PLAIN CARBON WEAVE.
3 PLY
DIVINYCELL HT81 FOAM CORE

EXTRA STUB LENGTH ON HORIZONTAL
STABILIZER FOR COUPLING CONNECTION

UNLESS OTHERWISE SPECIFIED:
DIMENSIONS ARE IN MILLIMETERS
SURFACE FINISH:
TOLERANCES:
LINEAR:
ANGULAR:

NAME | SIGNATURE | DATE | | | | TITLE: ASSY, STABILIZER

DRAWN
CHK'D
APPV'D
MFG
Q.A | | | | MATERIAL: | DWG NO. EXK-02-0019 | A3

SOLIDWORKS Educational Product. For Instructional Use Only.
