corelab-umich/kiteCADRepo/solidworks/Exp Scale Manta Ray/WingBox.pdf

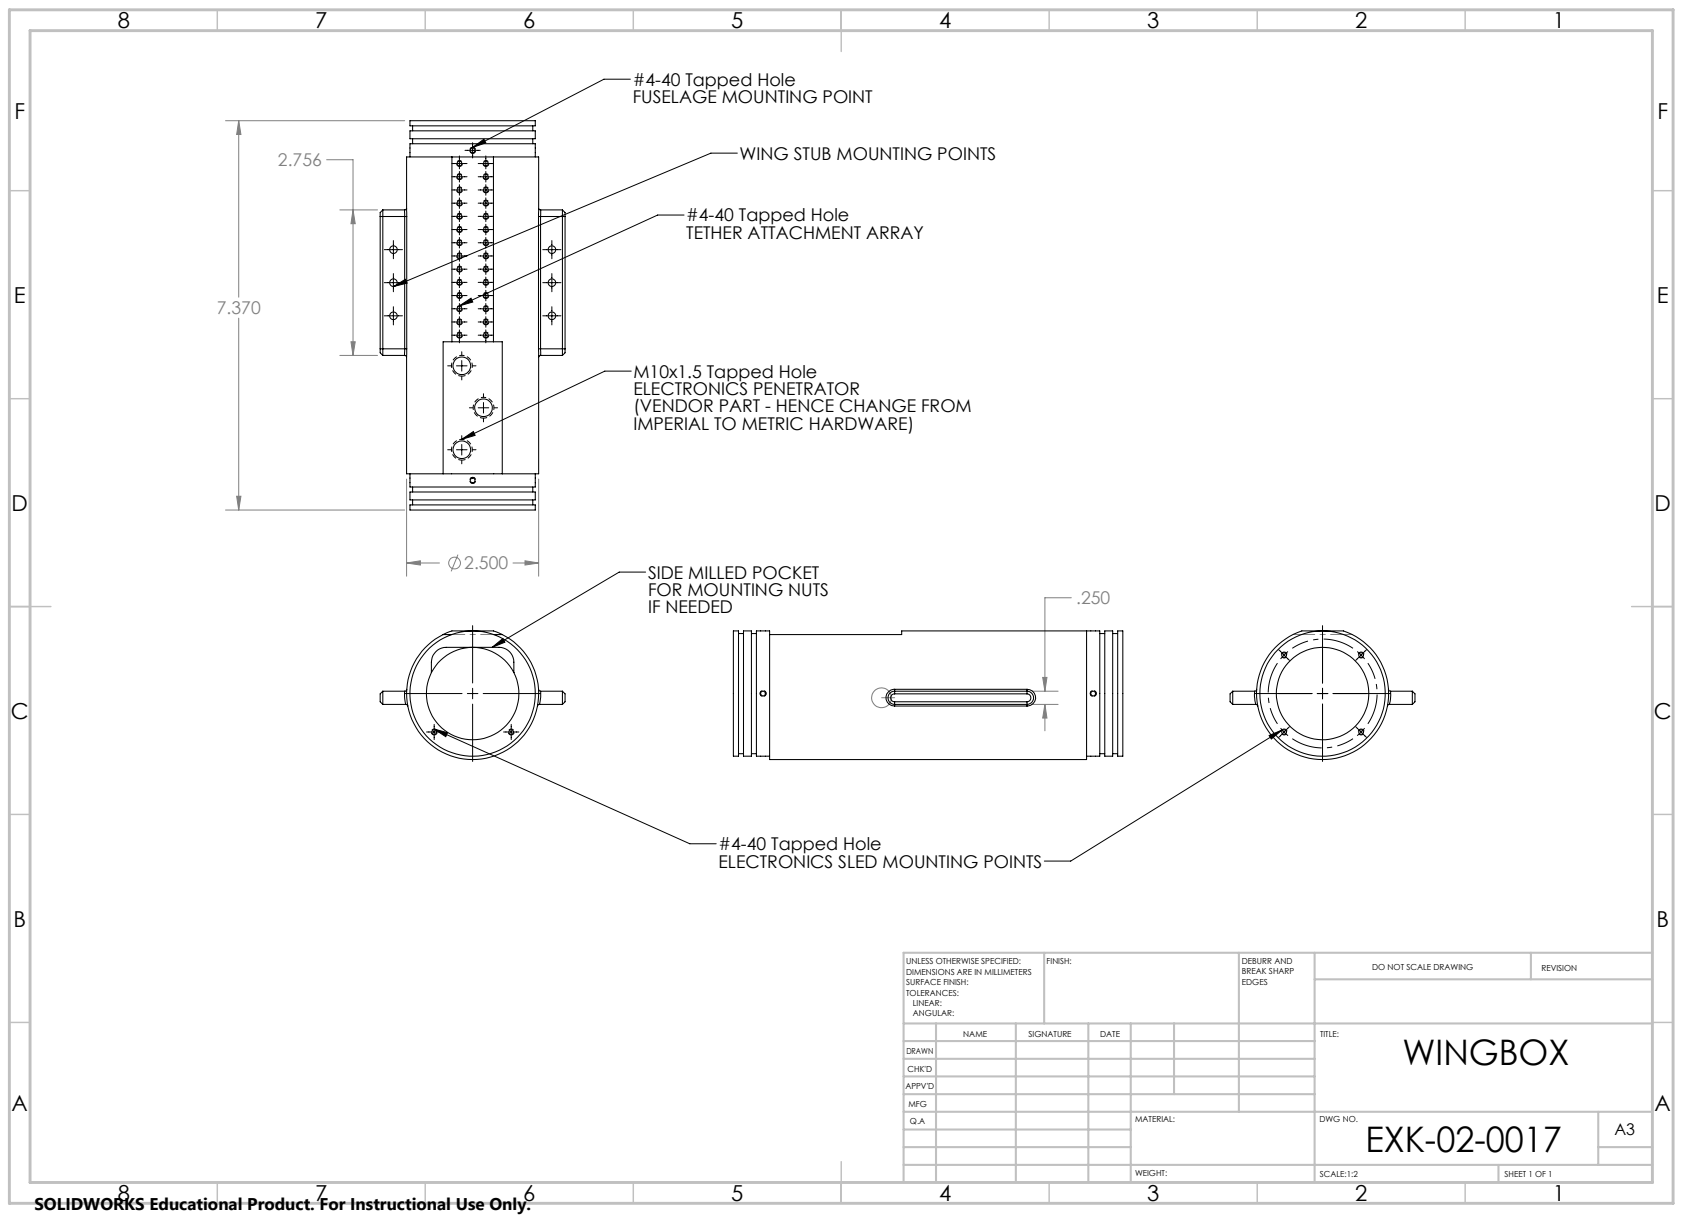
[picture p141: page 1]
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

#4-40 Tapped Hole
FUSELAGE MOUNTING POINT

WING STUB MOUNTING POINTS

TETHER ATTACHMENT ARRAY

M10x1.5 Tapped Hole
ELECTRONICS PENETRATOR
(VENDOR PART - HENCE CHANGE FROM
IMPERIAL TO METRIC HARDWARE)

SIDE MILLED POCKET
FOR MOUNTING NUTS
IF NEEDED

ELECTRONICS SLED MOUNTING POINTS

UNLESS OTHERWISE SPECIFIED:
DIMENSIONS ARE IN MILLIMETERS
SURFACE FINISH:
TOLERANCES:
LINEAR:
ANGULAR:

NAME | SIGNATURE | DATE | | | | TITLE: WINGBOX

DRAWN
CHK'D
APPV'D
MFG
Q.A | | | | MATERIAL: | DWG NO. EXK-02-0017 | A3

SOLIDWORKS Educational Product. For Instructional Use Only.
