corelab-umich/kiteCADRepo/solidworks/Line Angle Sensor/LAS-03-0004-B.PDF

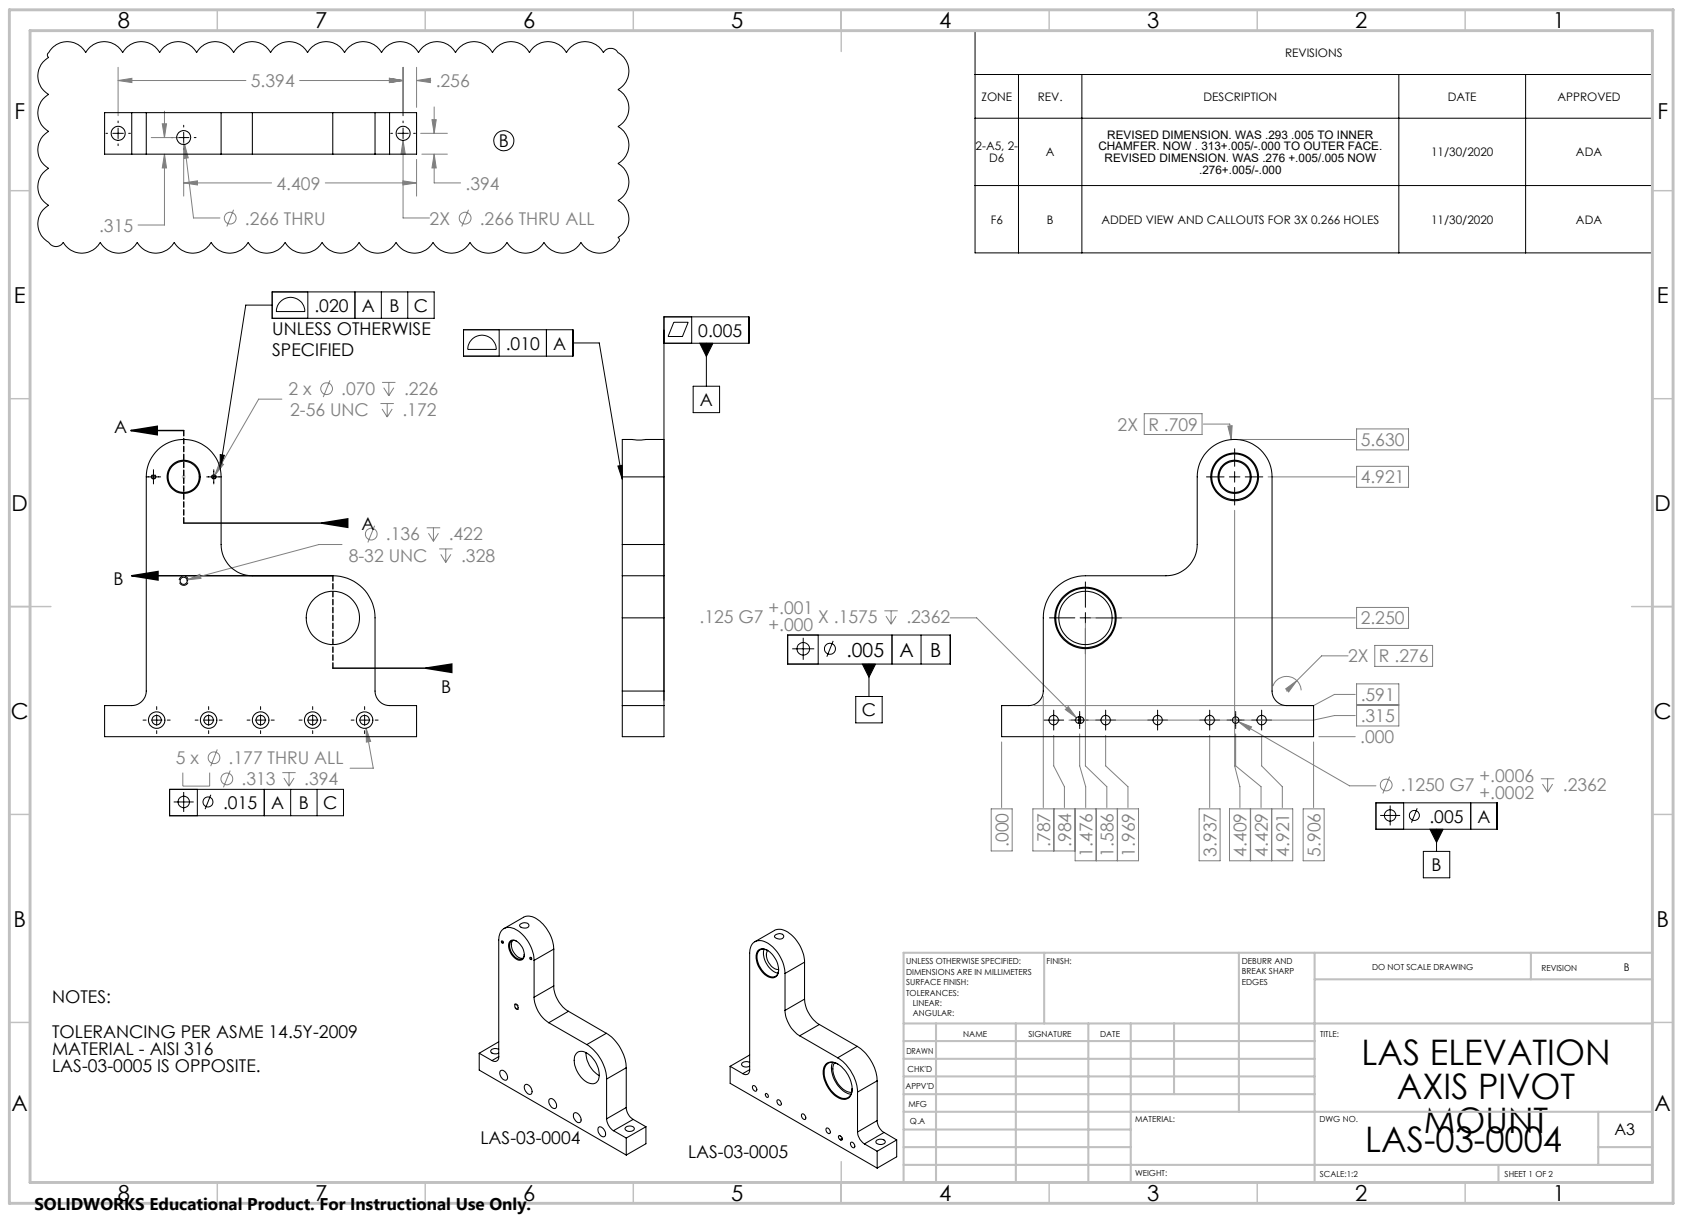
[picture p142: page 1]
.177 THRU ALL; 2-56 UNC; 8-32 UNC; UNLESS OTHERWISE; .266 THRU ALL; .266 THRU .315; FINISH:; DEBURR AND; BREAK SHARP; DO NOT SCALE DRAWING; REVISION; SCALE:1:2; SHEET 1 OF 2

REVISIONS

ZONE | REV. | DESCRIPTION | DATE | APPROVED

2-A5, 2-D6 | A | REVISED DIMENSION. WAS .293 .005 TO INNER CHAMFER. NOW . 313+.005/-.000 TO OUTER FACE. REVISED DIMENSION. WAS .276 +.005/.005 NOW .276+.005/-.000 | 11/30/2020 | ADA

F6 | B | ADDED VIEW AND CALLOUTS FOR 3X 0.266 HOLES | 11/30/2020 | ADA

UNLESS OTHERWISE SPECIFIED:
DIMENSIONS ARE IN MILLIMETERS
SURFACE FINISH:
TOLERANCES:
LINEAR:
ANGULAR:

NOTES:
TOLERANCING PER ASME 14.5Y-2009
MATERIAL - AISI 316
LAS-03-0005 IS OPPOSITE.

NAME | SIGNATURE | DATE | | | | TITLE: LAS ELEVATION AXIS PIVOT

DRAWN
CHK'D
APPV'D
Q.A | | | | MATERIAL: | MOUNT DWG NO. LAS-03-0004 | A3
MFG

SOLIDWORKS Educational Product. For Instructional Use Only.

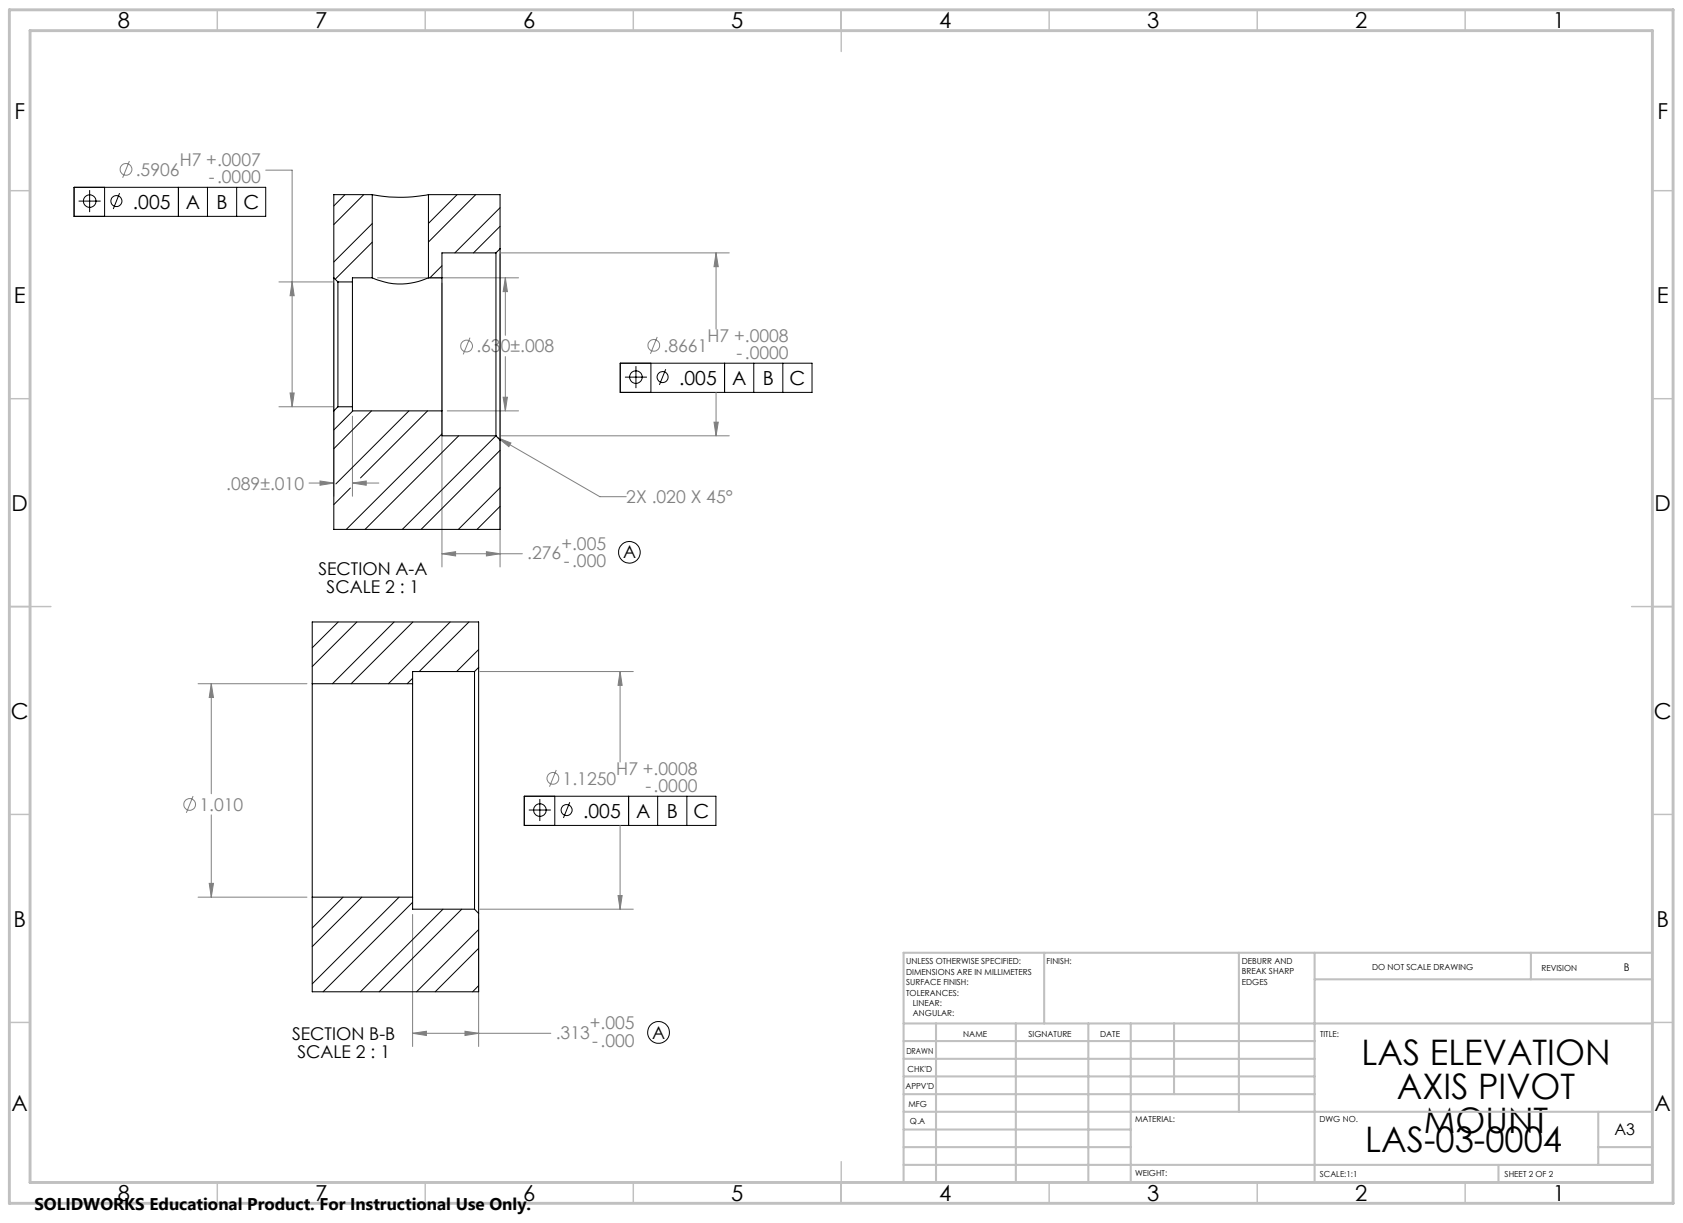
[picture p143: page 2]
SECTION A-A SCALE 2 : 1; .000 SECTION B-B SCALE 2 : 1; FINISH:; DEBURR AND; BREAK SHARP; DO NOT SCALE DRAWING; REVISION; SCALE:1:1; SHEET 2 OF 2

UNLESS OTHERWISE SPECIFIED:
DIMENSIONS ARE IN MILLIMETERS
SURFACE FINISH:
TOLERANCES:
LINEAR:
ANGULAR:

NAME | SIGNATURE | DATE | | | | TITLE: LAS ELEVATION AXIS PIVOT

DRAWN
CHK'D
APPV'D
Q.A | | | | MATERIAL: | MOUNT DWG NO. LAS-03-0004 | A3
MFG

SOLIDWORKS Educational Product. For Instructional Use Only.
