corelab-umich/kiteCADRepo/solidworks/Line Angle Sensor/LAS-01-0002.pdf

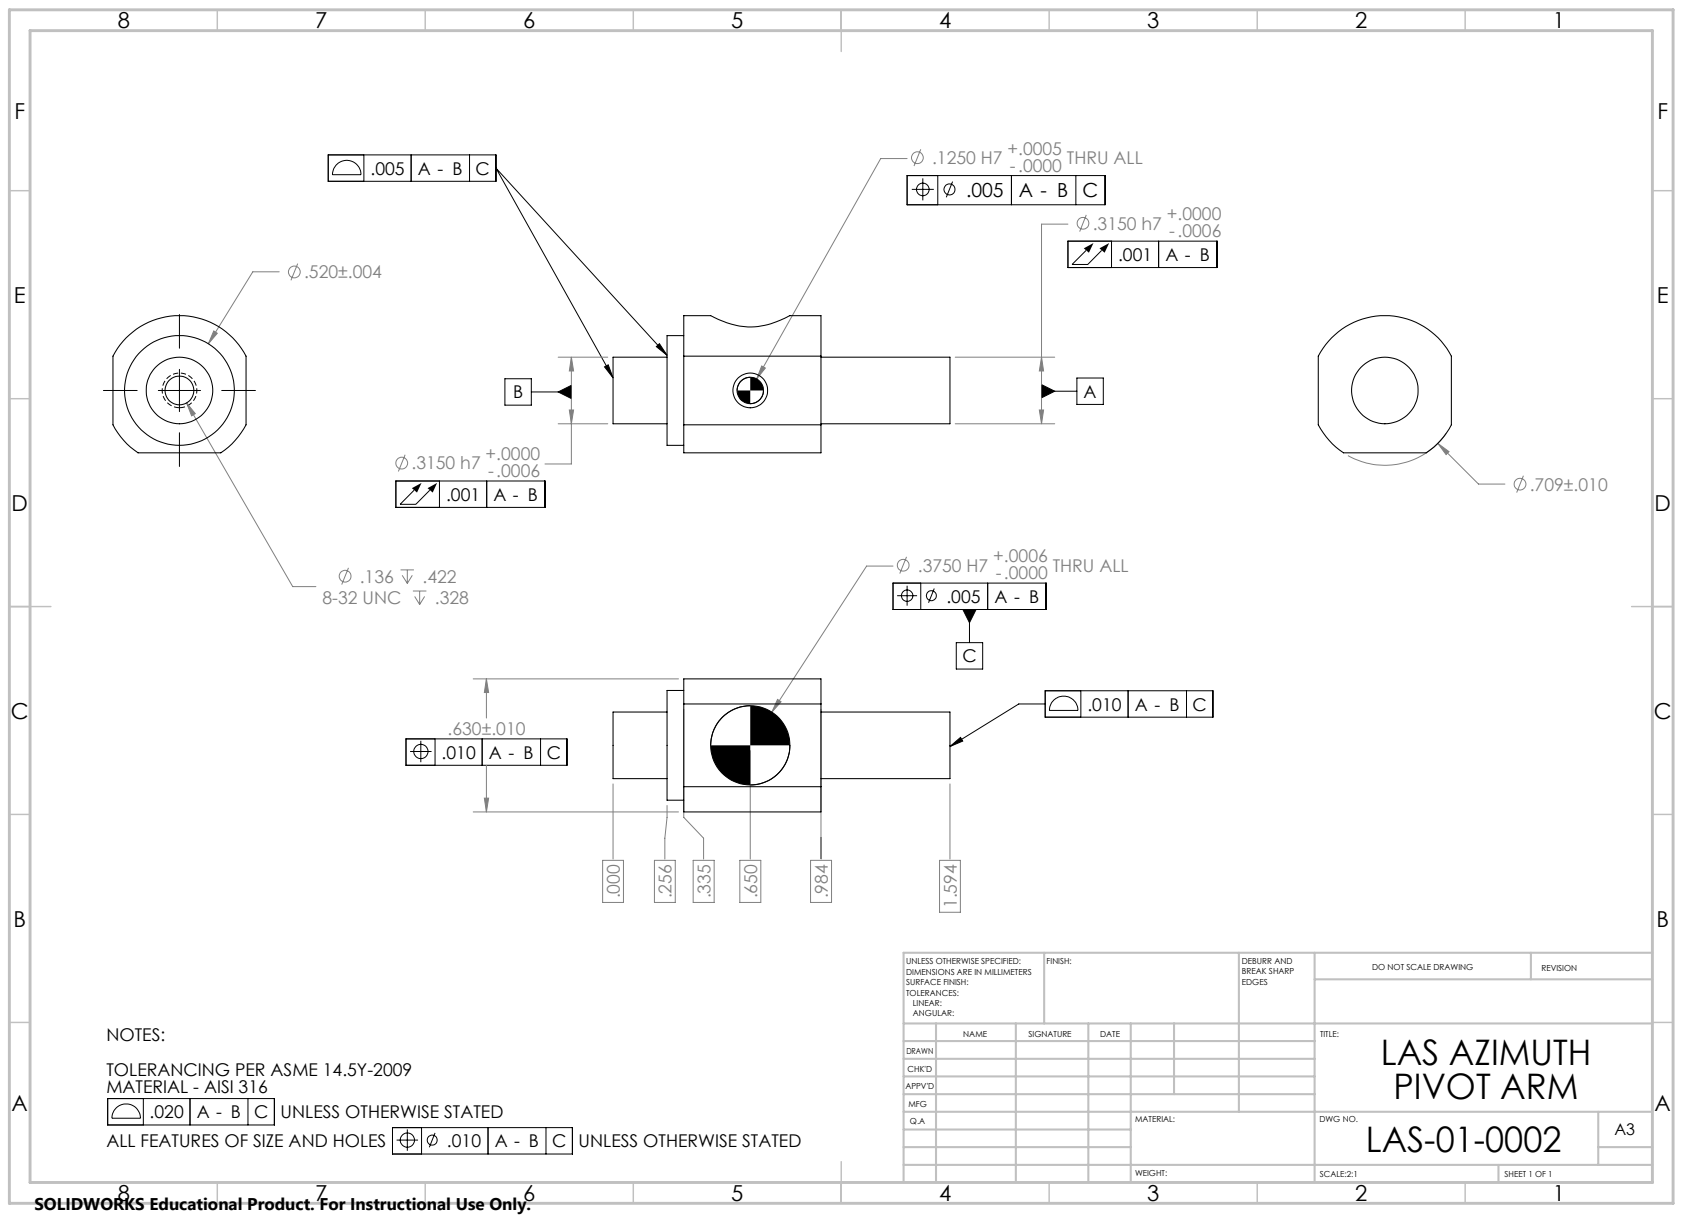
[picture p144: page 1]
.1250 H7 + .0000 THRU ALL; .3750 H7 + .0000 THRU ALL; 8-32 UNC; UNLESS OTHERWISE STATED; ALL FEATURES OF SIZE AND HOLES; FINISH:; DEBURR AND; BREAK SHARP; DO NOT SCALE DRAWING; REVISION; SCALE:2:1; SHEET 1 OF 1

UNLESS OTHERWISE SPECIFIED:
DIMENSIONS ARE IN MILLIMETERS
SURFACE FINISH:
TOLERANCES:
LINEAR:
ANGULAR:

NOTES:
TOLERANCING PER ASME 14.5Y-2009
MATERIAL - AISI 316
SOLIDWORKS Educational Product. For Instructional Use Only.

NAME | SIGNATURE | DATE | | | | TITLE: LAS AZIMUTH PIVOT ARM

DRAWN
CHK'D
APPV'D
MFG
Q.A | | | | MATERIAL: | DWG NO. LAS-01-0002 | A3
