corelab-umich/kiteCADRepo/solidworks/Line Angle Sensor/LAS-01-0012.pdf

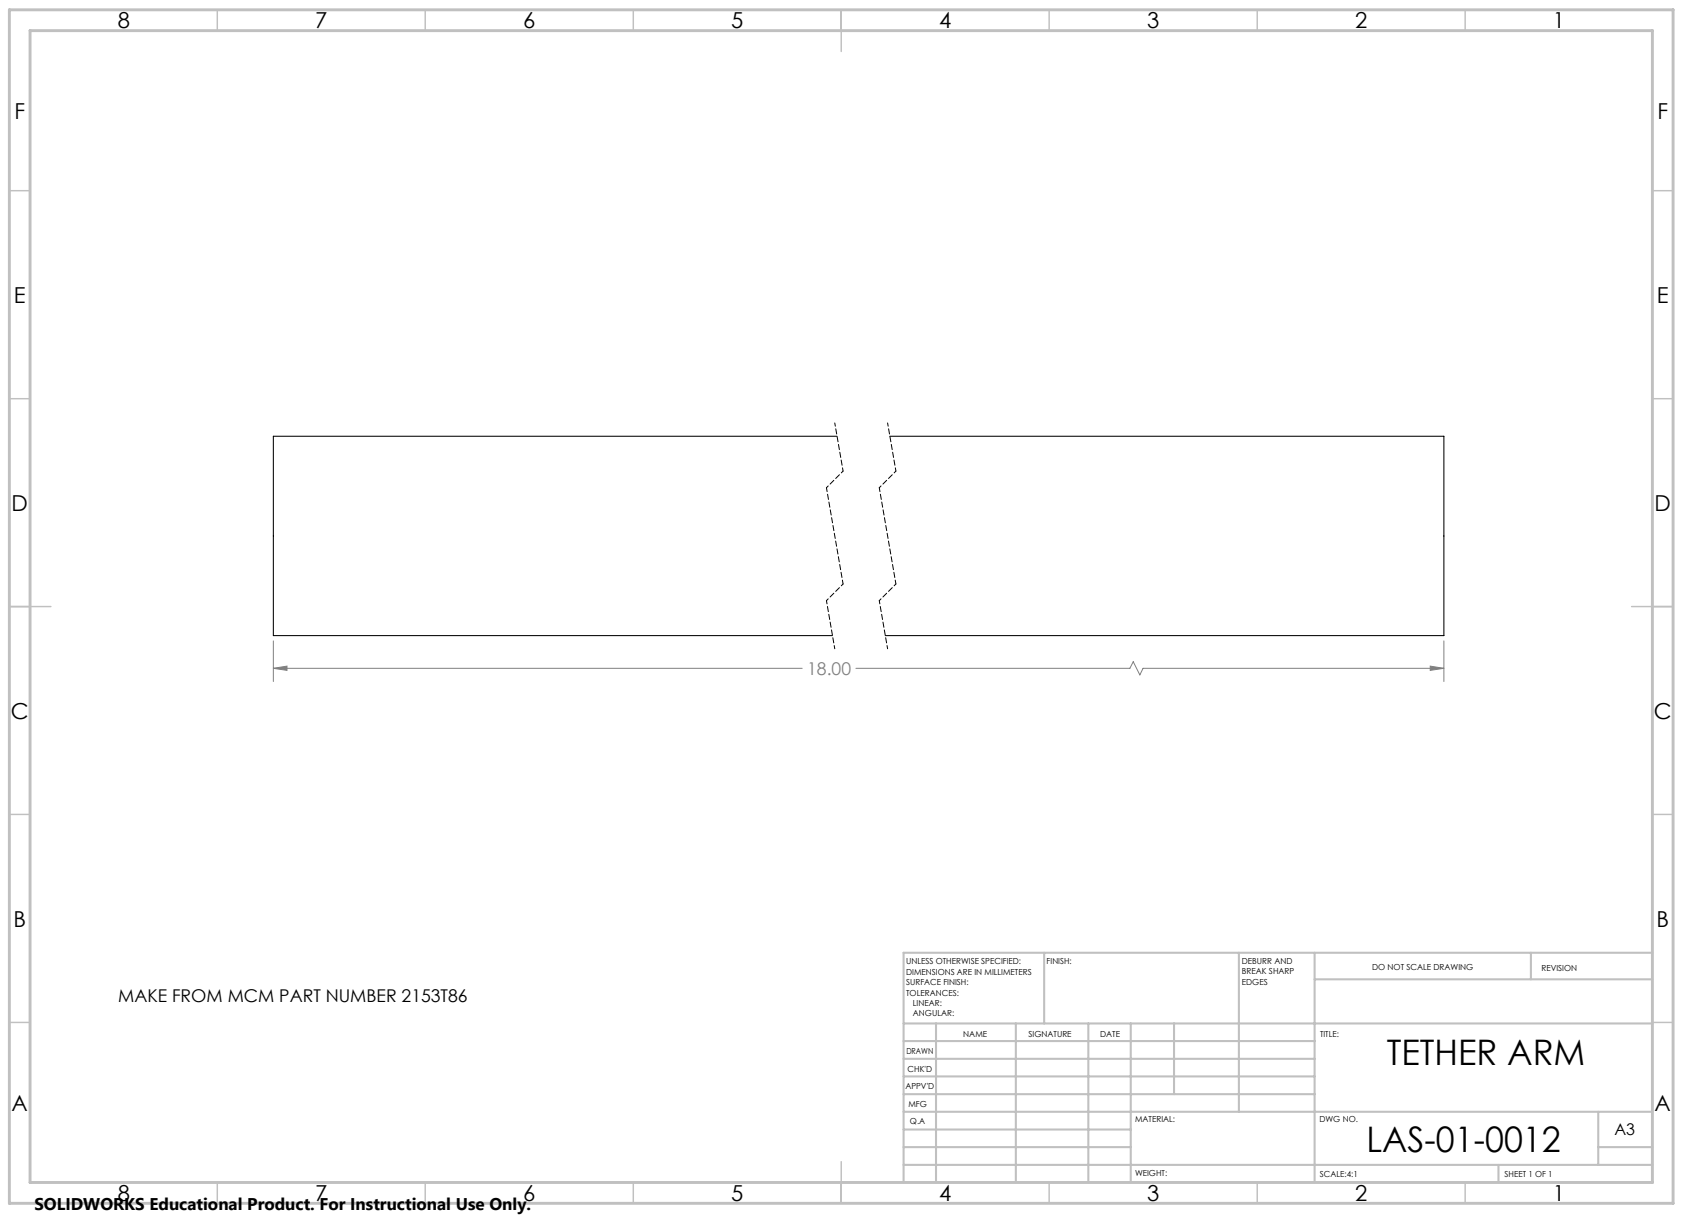
[picture p148: page 1]
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

UNLESS OTHERWISE SPECIFIED:
DIMENSIONS ARE IN MILLIMETERS
SURFACE FINISH:
TOLERANCES:
LINEAR:
ANGULAR:

MAKE FROM MCM PART NUMBER 2153T86

NAME | SIGNATURE | DATE | | | | TITLE: TETHER ARM

DRAWN
CHK'D
APPV'D
MFG
Q.A | | | | MATERIAL: | DWG NO. LAS-01-0012 | A3

SOLIDWORKS Educational Product. For Instructional Use Only.
