corelab-umich/kiteCADRepo/solidworks/Line Angle Sensor/LAS-02-0002.pdf

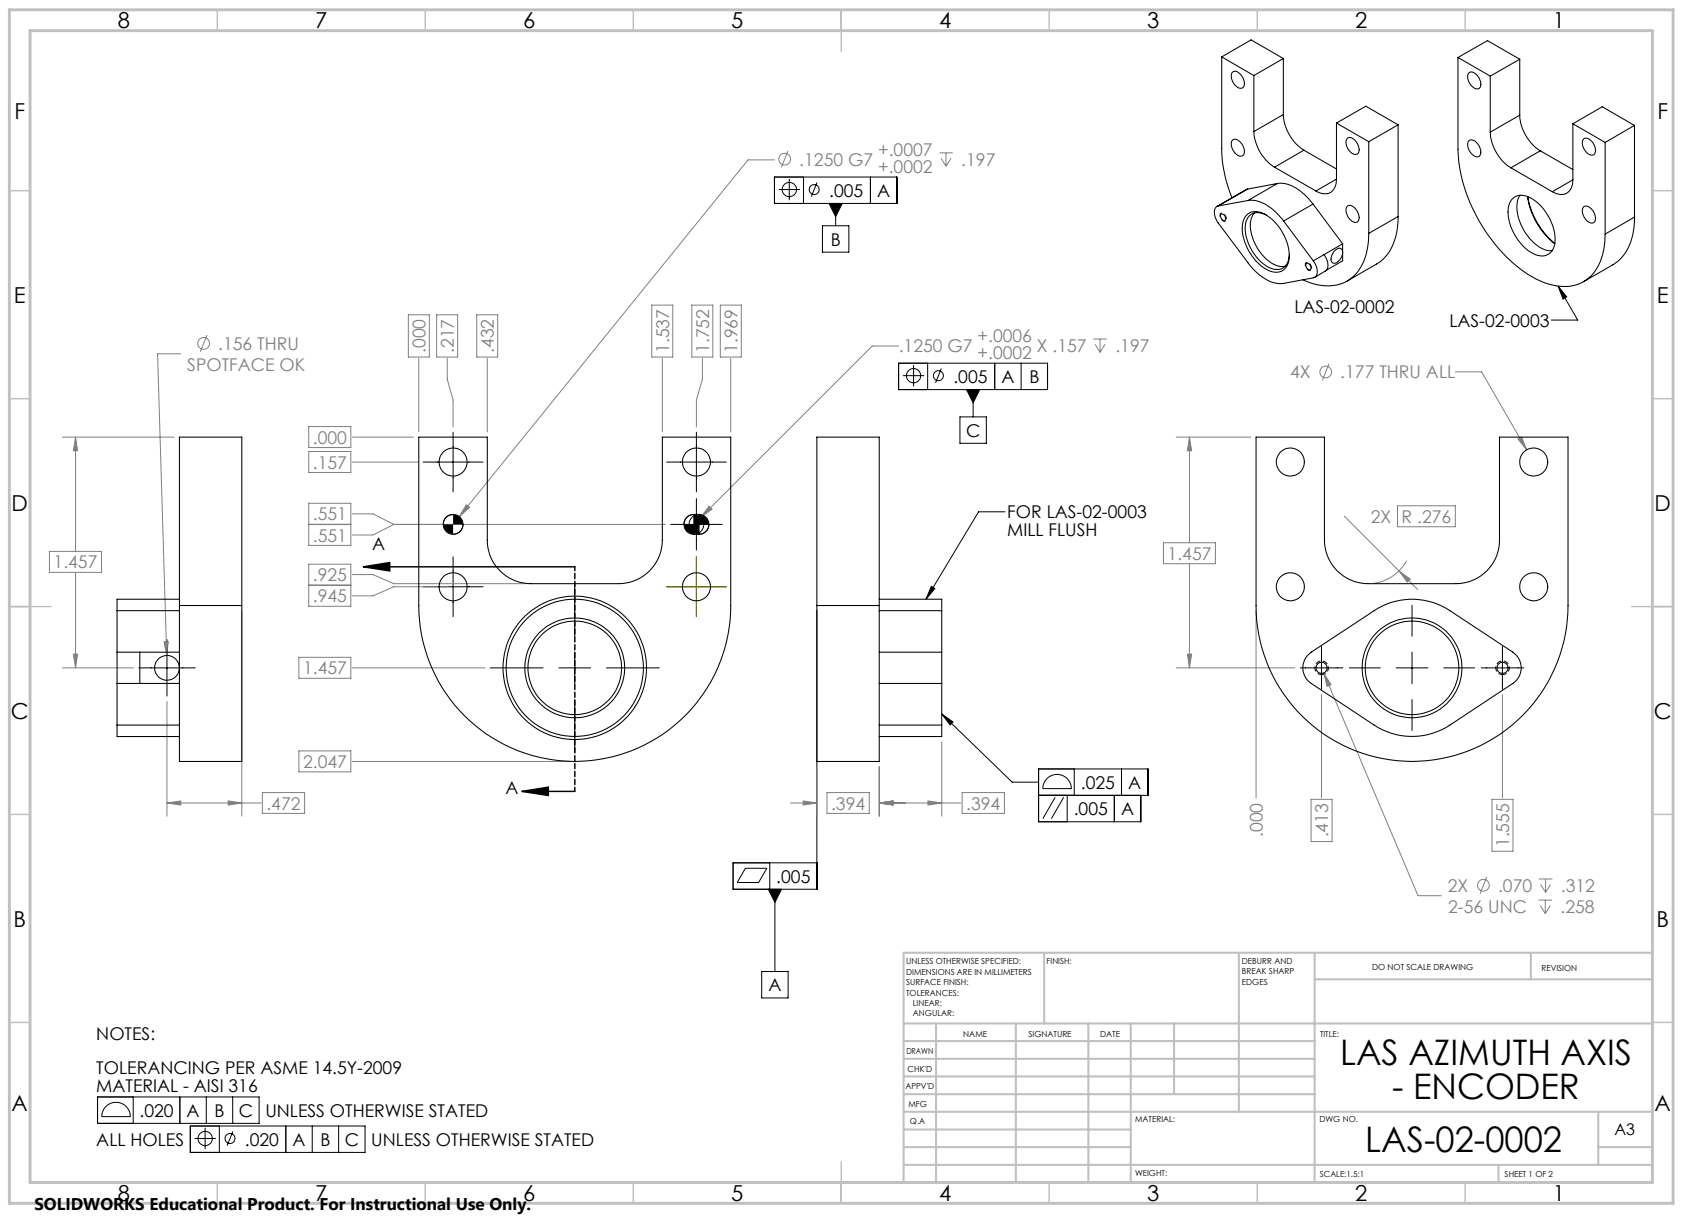
[picture p150: page 1]
.177 THRU ALL; 2-56 UNC; FOR LAS-02-0003 MILL FLUSH; .156 THRU SPOTFACE OK; A B C UNLESS OTHERWISE STATED; ALL HOLES; FINISH:; DEBURR AND; BREAK SHARP; DO NOT SCALE DRAWING; REVISION; SCALE:1.5:1; SHEET 1 OF 2

UNLESS OTHERWISE SPECIFIED:
DIMENSIONS ARE IN MILLIMETERS
SURFACE FINISH:
TOLERANCES:
LINEAR:
ANGULAR:

NOTES:
TOLERANCING PER ASME 14.5Y-2009
MATERIAL - AISI 316

NAME | SIGNATURE | DATE | | | | TITLE: LAS AZIMUTH AXIS - ENCODER

DRAWN
CHK'D
APPV'D
MFG
Q.A | | | | MATERIAL: | DWG NO. LAS-02-0002 | A3

SOLIDWORKS Educational Product. For Instructional Use Only.

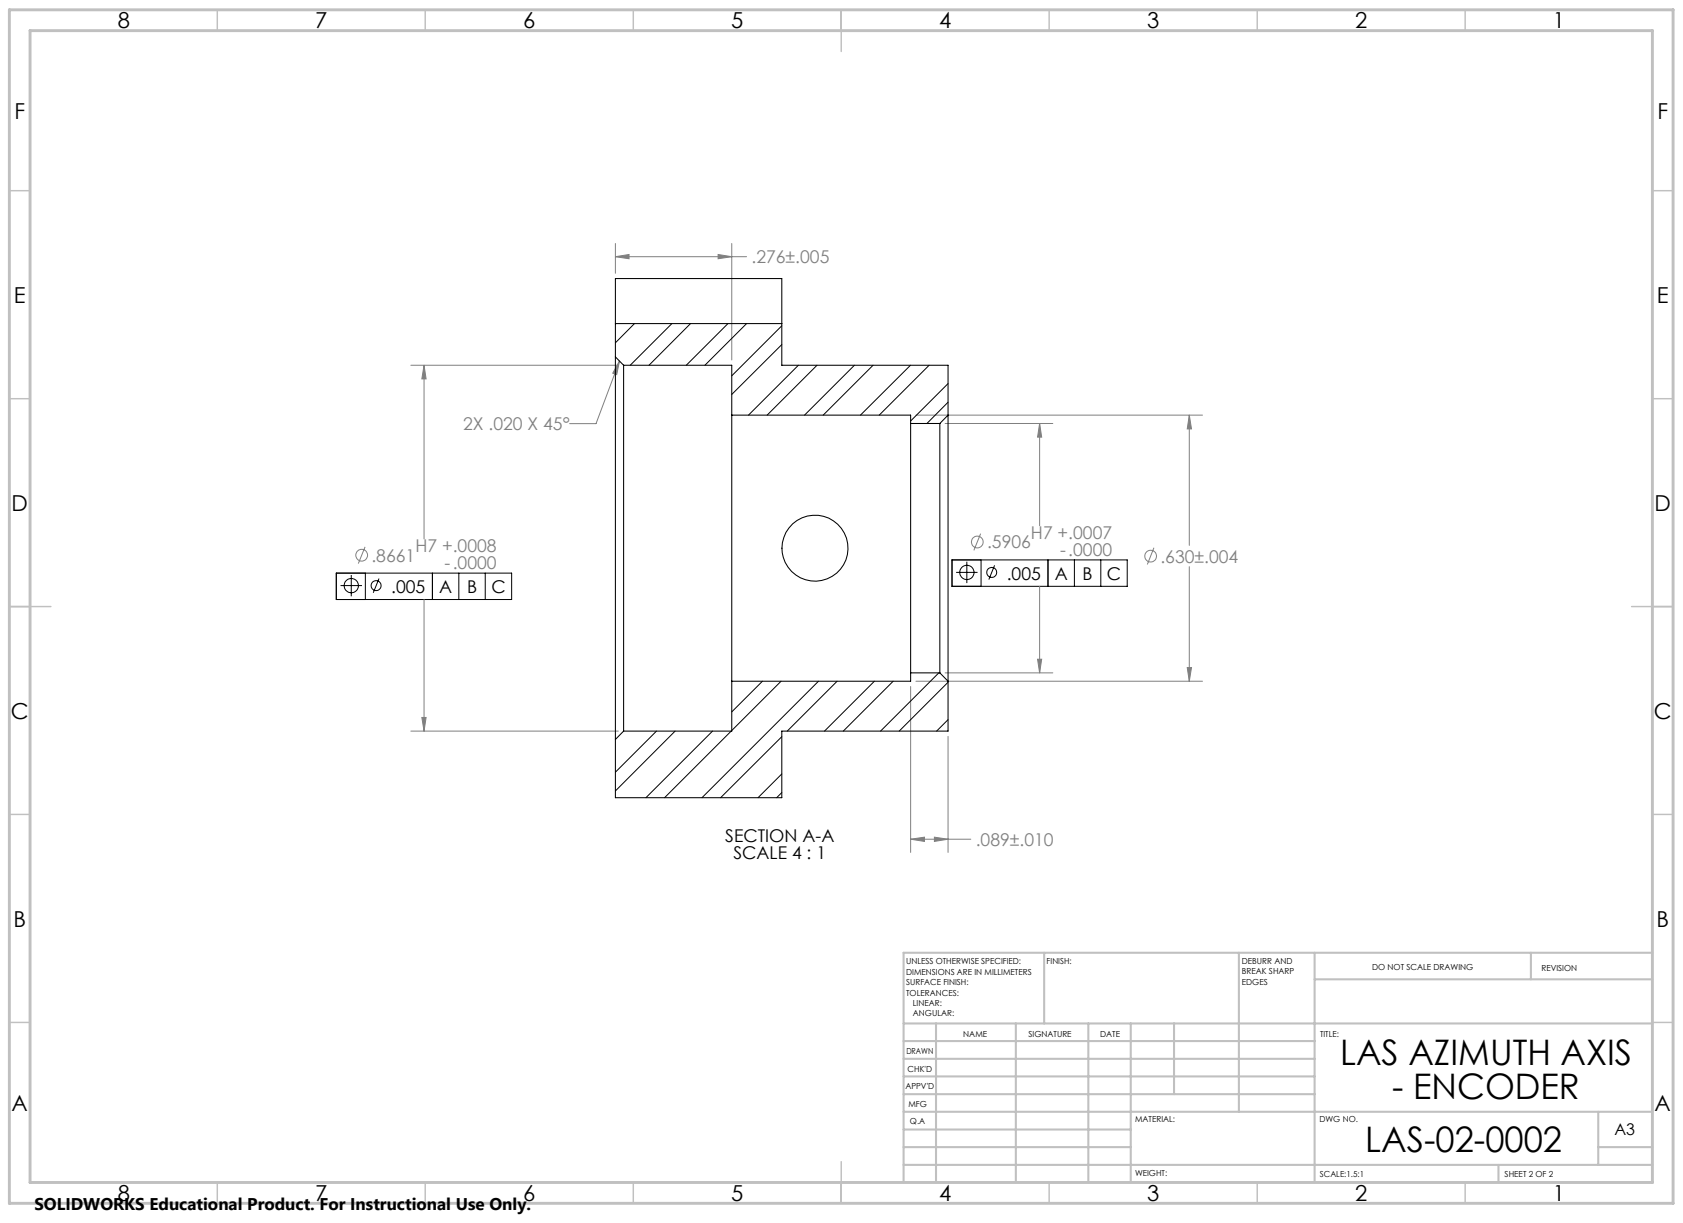
[picture p151: page 2]
SECTION A-A SCALE 4 : 1; FINISH:; DEBURR AND; BREAK SHARP; DO NOT SCALE DRAWING; REVISION; SCALE:1.5:1; SHEET 2 OF 2

UNLESS OTHERWISE SPECIFIED:
DIMENSIONS ARE IN MILLIMETERS
SURFACE FINISH:
TOLERANCES:
LINEAR:
ANGULAR:

NAME | SIGNATURE | DATE | | | | TITLE: LAS AZIMUTH AXIS - ENCODER

DRAWN
CHK'D
APPV'D
MFG
Q.A | | | | MATERIAL: | DWG NO. LAS-02-0002 | A3

SOLIDWORKS Educational Product. For Instructional Use Only.
