corelab-umich/kiteCADRepo/solidworks/Line Angle Sensor/LAS-02-0006-A.pdf

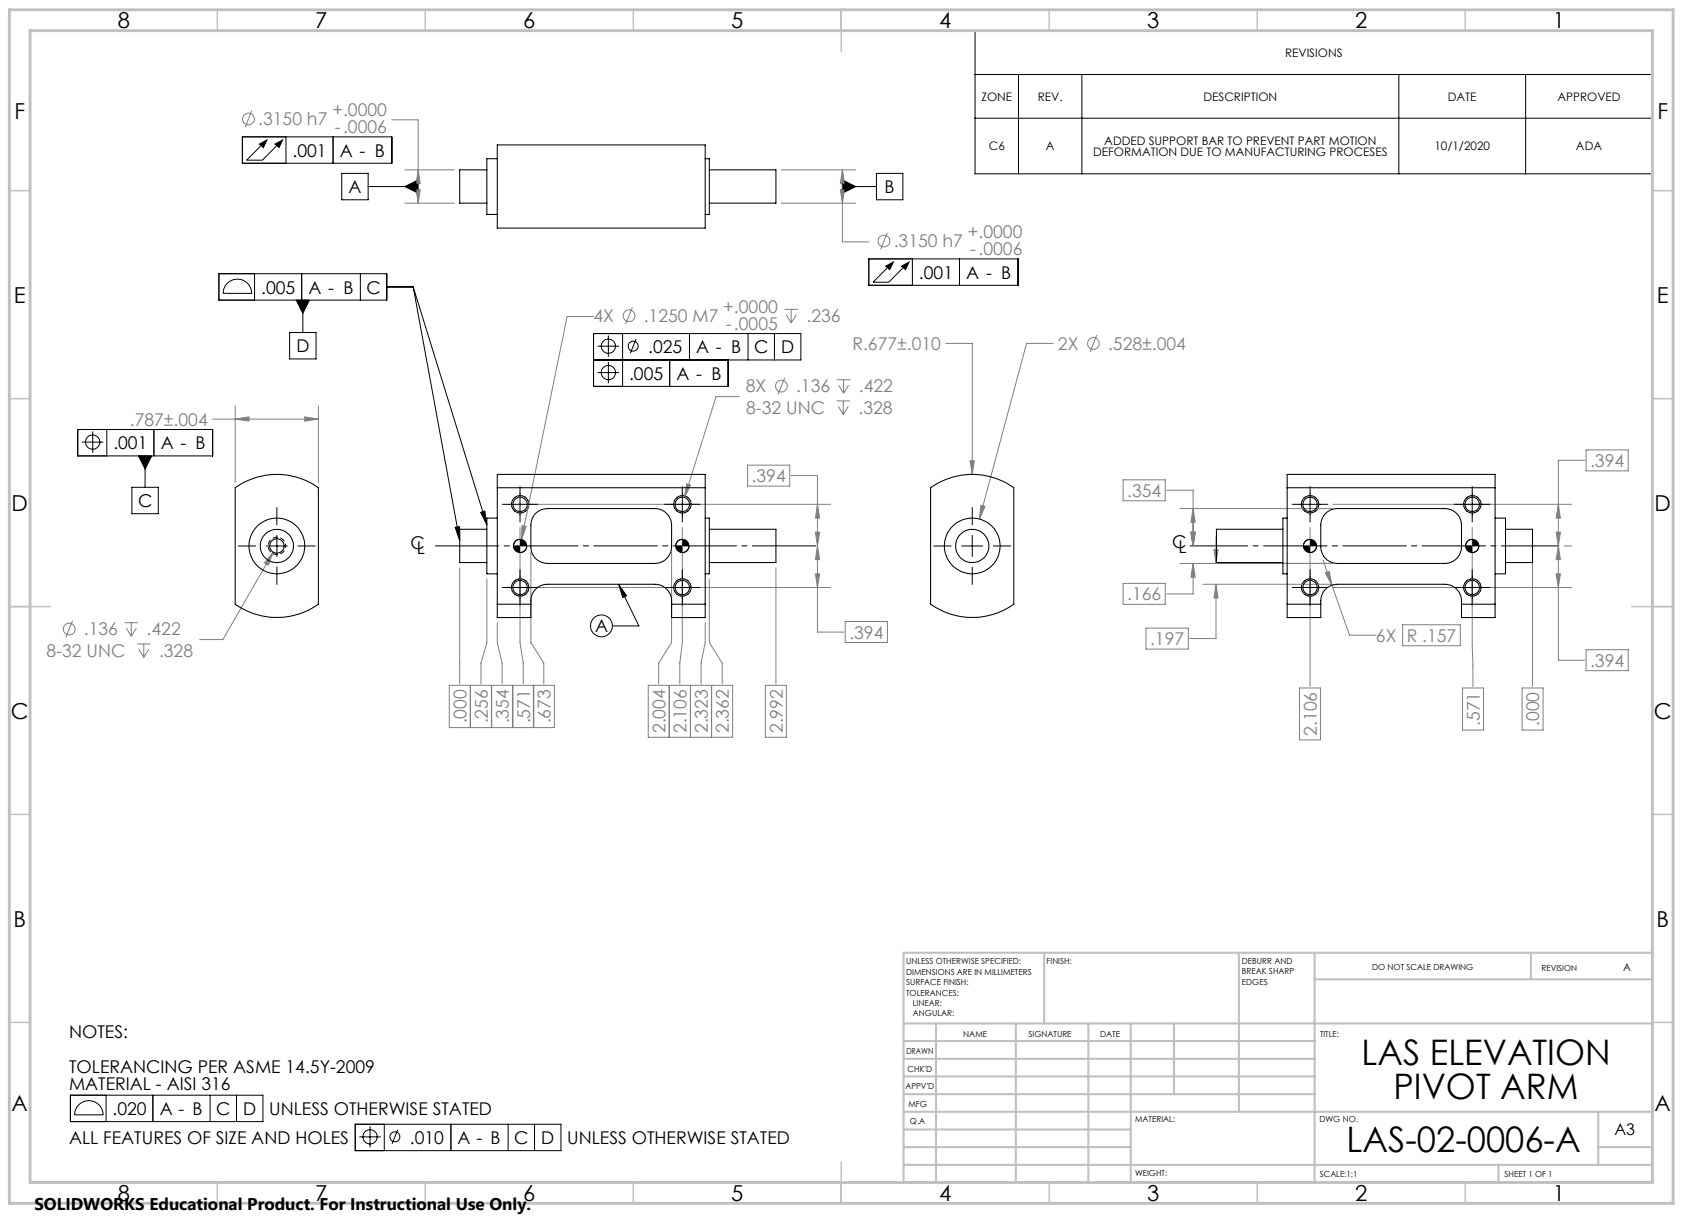
[picture p152: page 1]
8-32 UNC; A - B C D UNLESS OTHERWISE STATED; ALL FEATURES OF SIZE AND HOLES; FINISH:; DEBURR AND; BREAK SHARP; DO NOT SCALE DRAWING; REVISION; SCALE:1:1; SHEET 1 OF 1

.3150 h7 + .0000 -.0006 .3150 h7 + - | REVISIONS

ZONE | REV. | DESCRIPTION | DATE | APPROVED

C6 | A | ADDED SUPPORT BAR TO PREVENT PART MOTION DEFORMATION DUE TO MANUFACTURING PROCESES | 10/1/2020 | ADA

UNLESS OTHERWISE SPECIFIED:
DIMENSIONS ARE IN MILLIMETERS
SURFACE FINISH:
TOLERANCES:
LINEAR:
ANGULAR:

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

NAME | SIGNATURE | DATE | | | | TITLE: LAS ELEVATION PIVOT ARM

DRAWN
CHK'D
APPV'D
MFG
Q.A | | | | MATERIAL: | DWG NO. LAS-02-0006-A | A3
