corelab-umich/kiteCADRepo/solidworks/Line Angle Sensor/LAS-03-0004.pdf

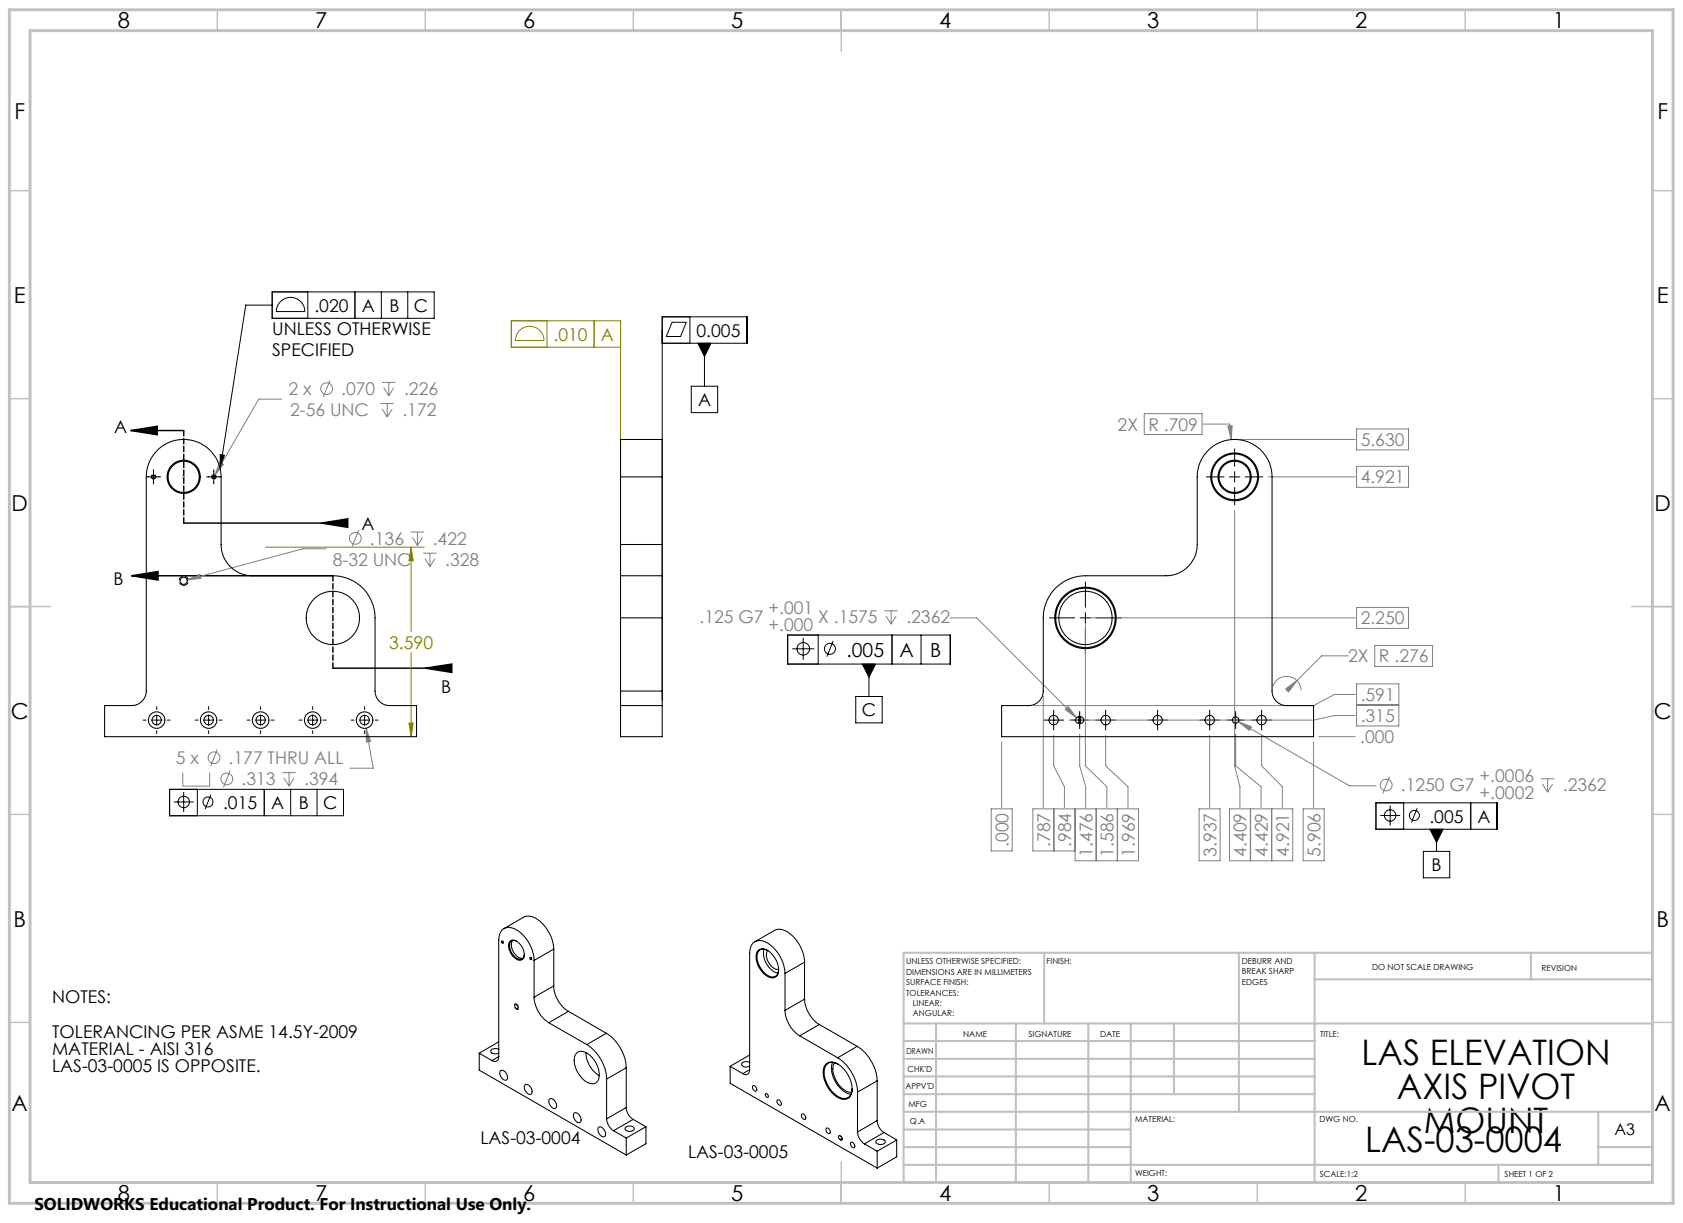
[picture p156: page 1]
.177 THRU ALL; 2-56 UNC; 8-32 UNC; UNLESS OTHERWISE; FINISH:; DEBURR AND; BREAK SHARP; DO NOT SCALE DRAWING; REVISION; SCALE:1:2; SHEET 1 OF 2

UNLESS OTHERWISE SPECIFIED:
DIMENSIONS ARE IN MILLIMETERS
SURFACE FINISH:
TOLERANCES:
LINEAR:
ANGULAR:

NOTES:
TOLERANCING PER ASME 14.5Y-2009
MATERIAL - AISI 316
LAS-03-0005 IS OPPOSITE.

NAME | SIGNATURE | DATE | | | | TITLE: LAS ELEVATION AXIS PIVOT

DRAWN
CHK'D
APPV'D
Q.A | | | | MATERIAL: | MOUNT DWG NO. LAS-03-0004 | A3
MFG

SOLIDWORKS Educational Product. For Instructional Use Only.

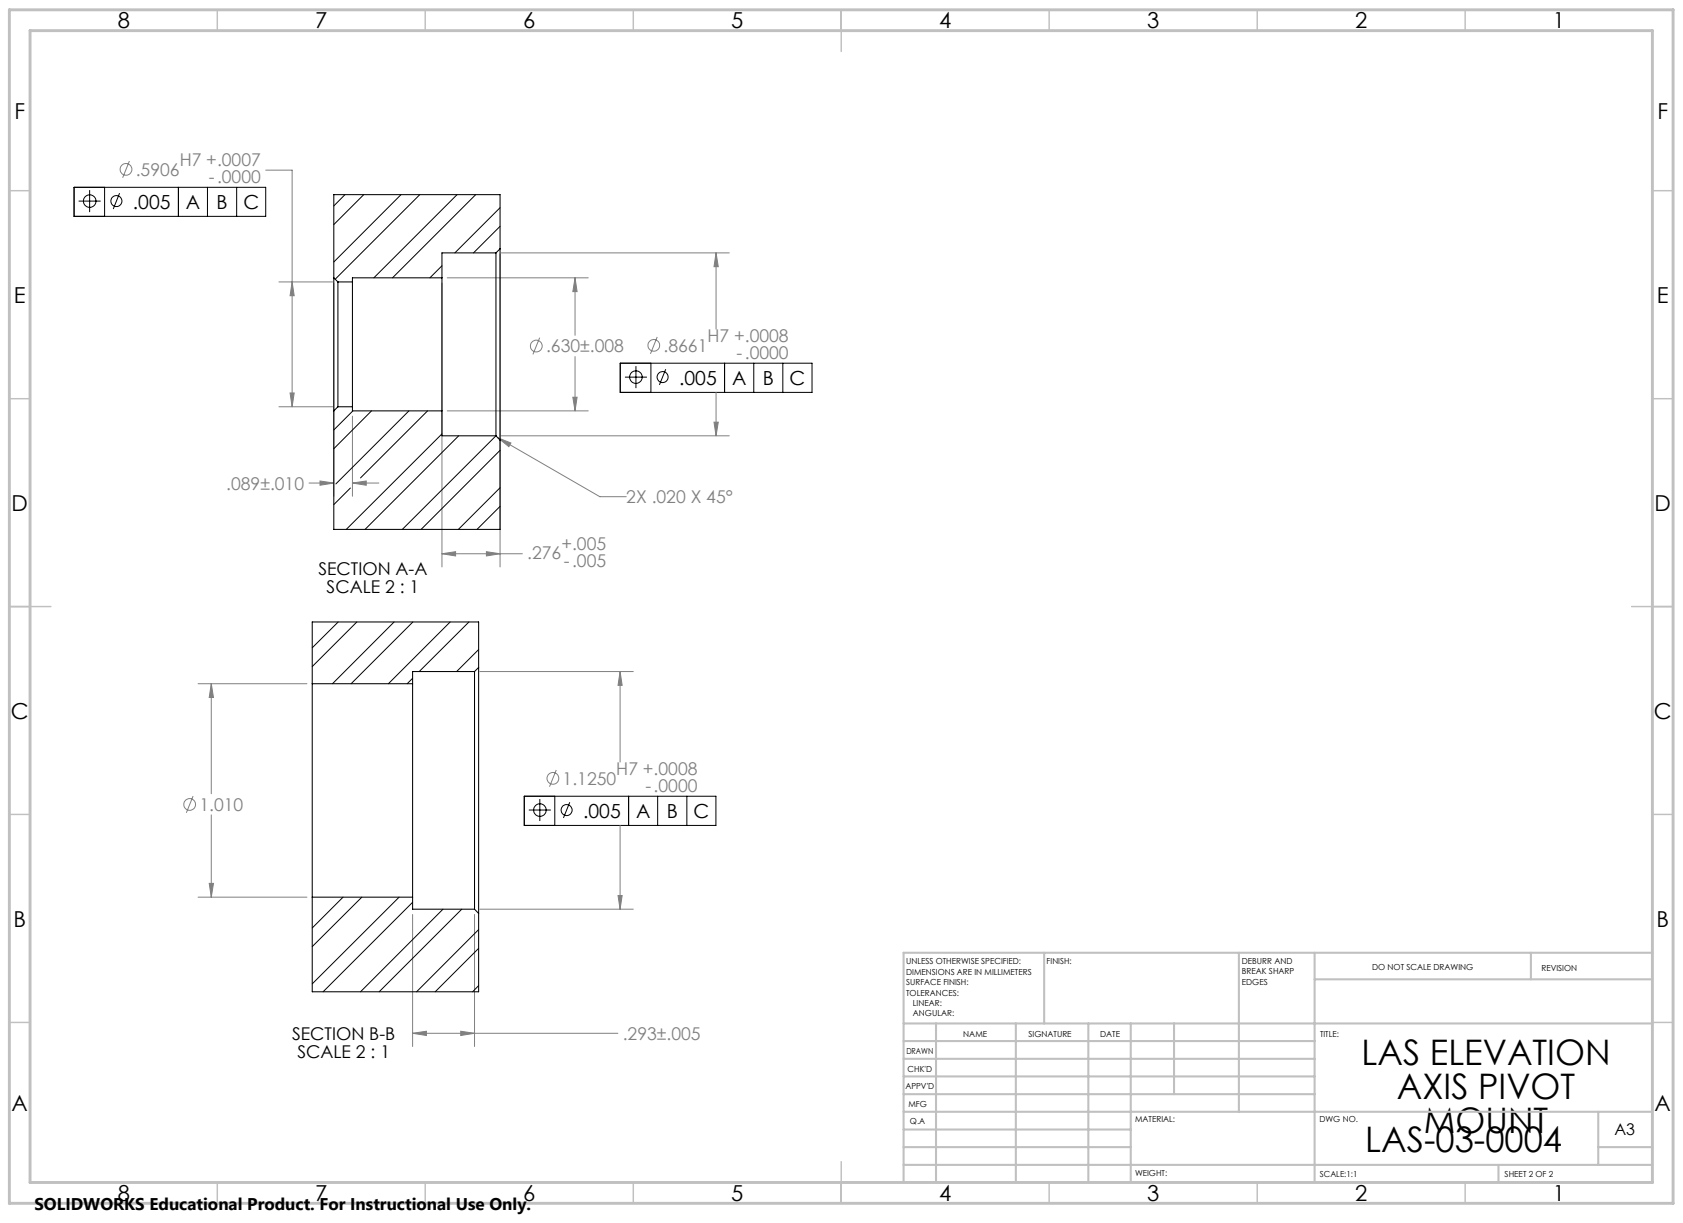
[picture p157: page 2]
SECTION A-A SCALE 2 : 1; SECTION B-B; SCALE 2 : 1; FINISH:; DEBURR AND; BREAK SHARP; DO NOT SCALE DRAWING; REVISION; SCALE:1:1; SHEET 2 OF 2

UNLESS OTHERWISE SPECIFIED:
DIMENSIONS ARE IN MILLIMETERS
SURFACE FINISH:
TOLERANCES:
LINEAR:
ANGULAR:

NAME | SIGNATURE | DATE | | | | TITLE: LAS ELEVATION AXIS PIVOT

DRAWN
CHK'D
APPV'D
Q.A | | | | MATERIAL: | MOUNT DWG NO. LAS-03-0004 | A3
MFG

SOLIDWORKS Educational Product. For Instructional Use Only.
