corelab-umich/kiteCADRepo/solidworks/Line Angle Sensor/Released Prints/LAS-01-0002.pdf

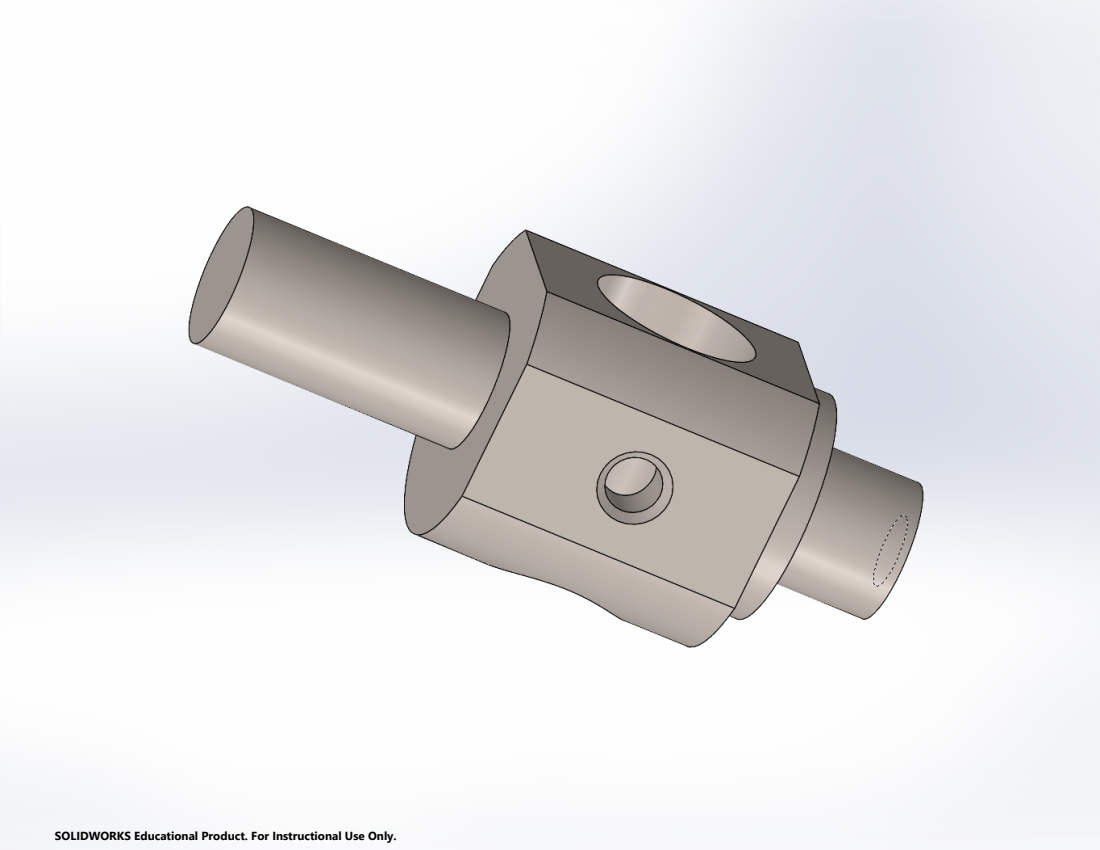
[picture p159: page 1]

SOLIDWORKS Educational Product. For Instructional Use Only.
