corelab-umich/kiteCADRepo/solidworks/Line Angle Sensor/Released Prints/LAS-01-0012.pdf

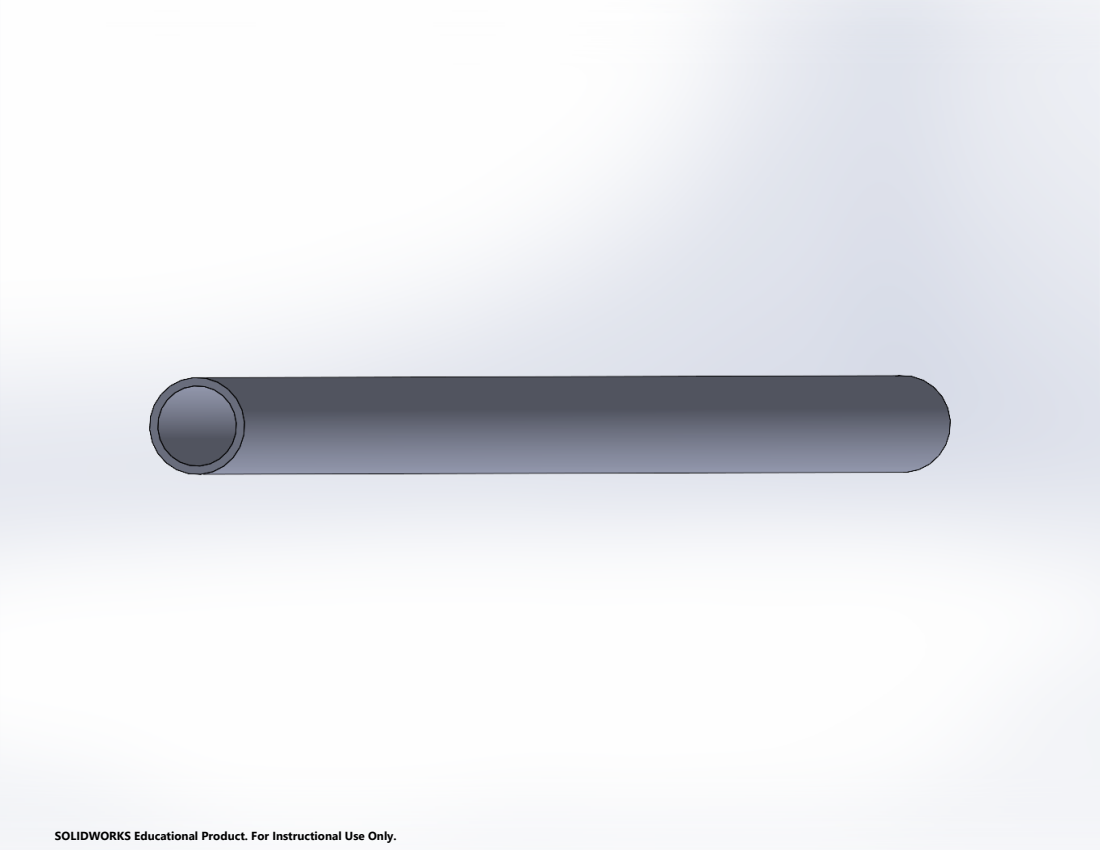
[picture p162: page 1]

SOLIDWORKS Educational Product. For Instructional Use Only.
