corelab-umich/kiteCADRepo/solidworks/Line Angle Sensor/Released Prints/LAS-01-0018.pdf

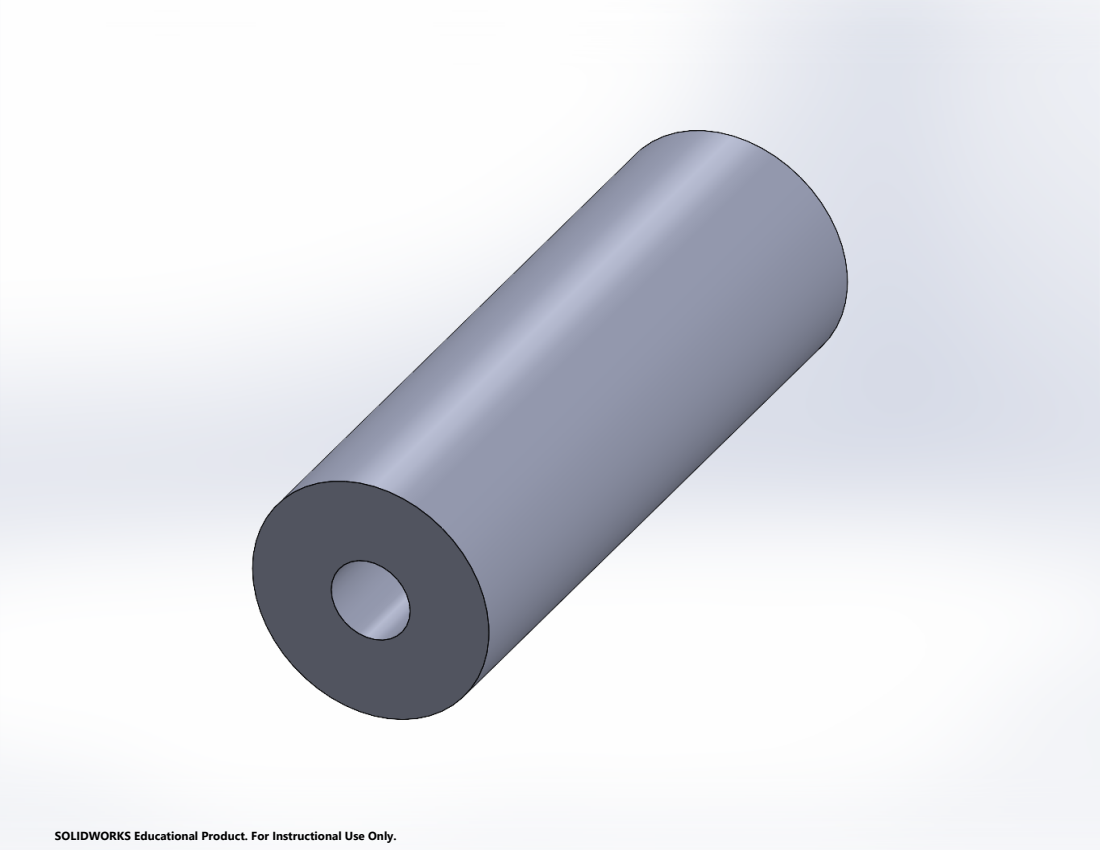
[picture p163: page 1]

SOLIDWORKS Educational Product. For Instructional Use Only.
