corelab-umich/kiteCADRepo/solidworks/Line Angle Sensor/Released Prints/LAS-02-0002.pdf

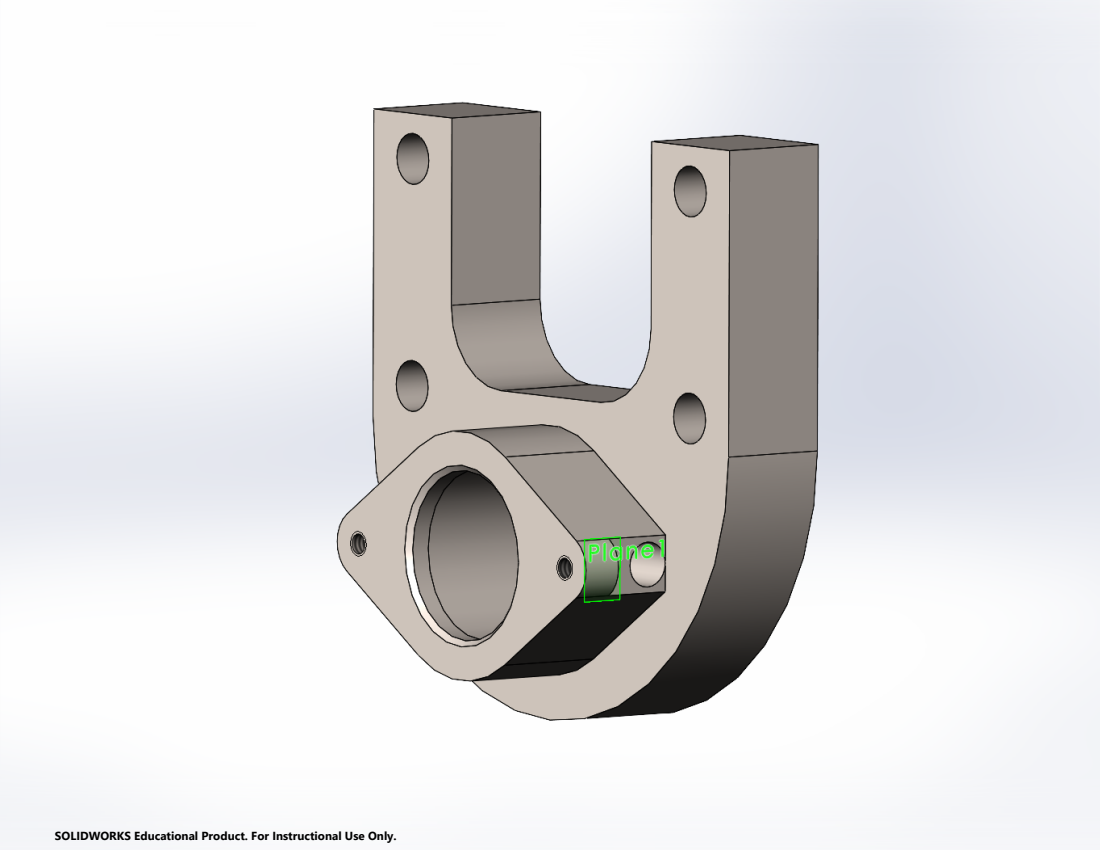
[picture p165: page 1]

SOLIDWORKS Educational Product. For Instructional Use Only.
