corelab-umich/kiteCADRepo/solidworks/Line Angle Sensor/Released Prints/LAS-02-0003.pdf

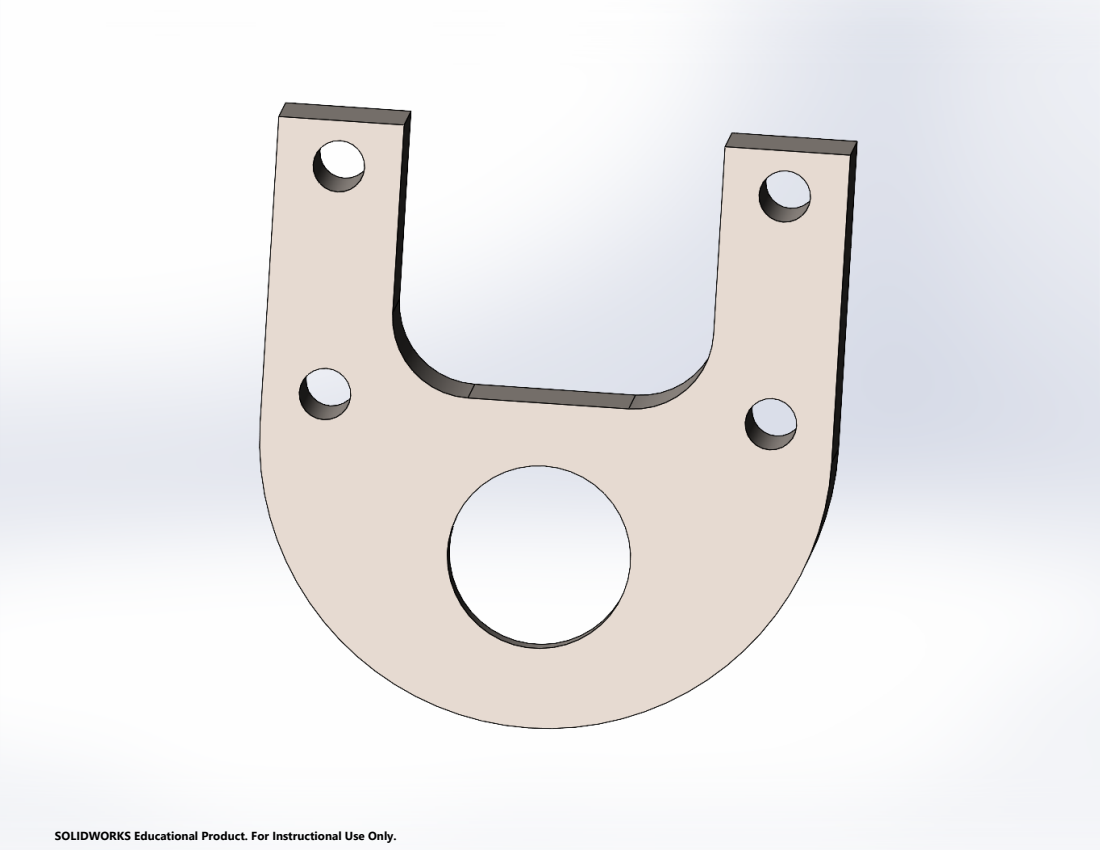
[picture p166: page 1]

SOLIDWORKS Educational Product. For Instructional Use Only.
