corelab-umich/kiteCADRepo/solidworks/Line Angle Sensor/Released Prints/LAS-02-0006.pdf

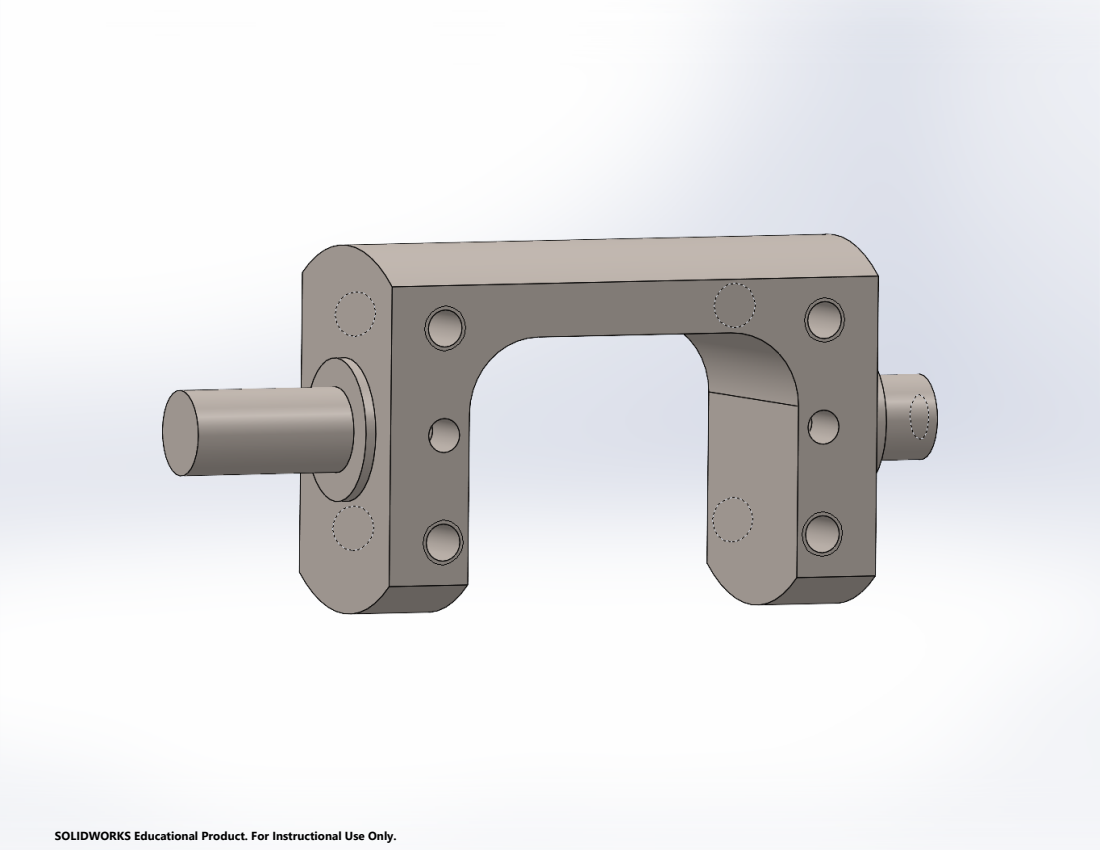
[picture p167: page 1]

SOLIDWORKS Educational Product. For Instructional Use Only.
