corelab-umich/kiteCADRepo/solidworks/Line Angle Sensor/Released Prints/LAS-03-0004.pdf

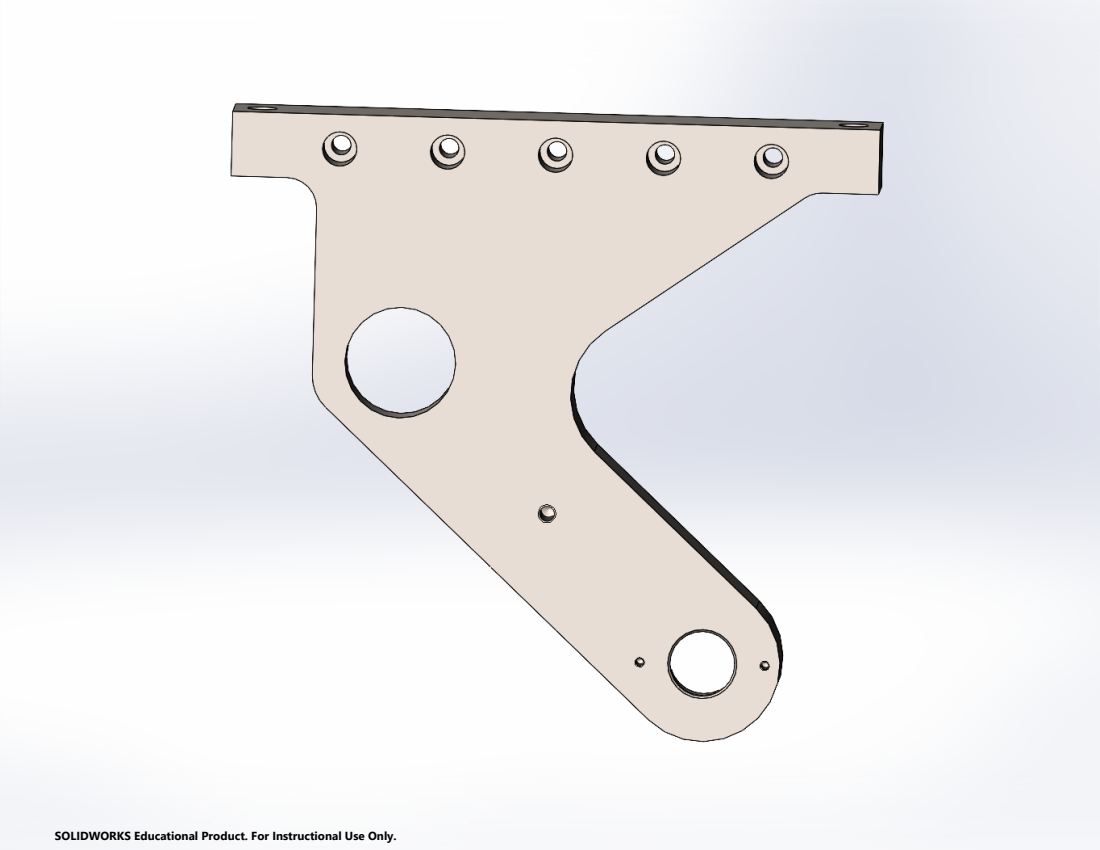
[picture p169: page 1]

SOLIDWORKS Educational Product. For Instructional Use Only.
