corelab-umich/kiteCADRepo/solidworks/Line Angle Sensor/Released Prints/LAS-03-0005.pdf

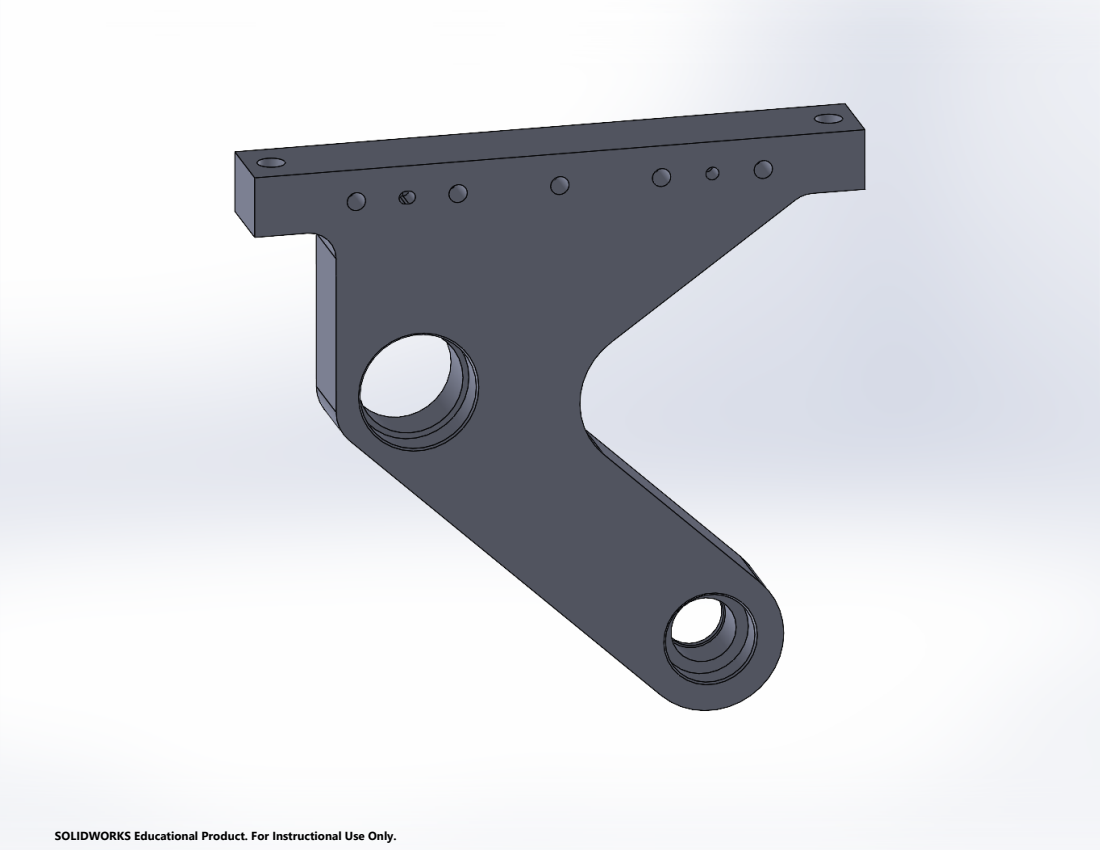
[picture p170: page 1]

SOLIDWORKS Educational Product. For Instructional Use Only.
