corelab-umich/kiteCADRepo/solidworks/Exp Scale Manta Ray/EXK-01-0008-01-01_RevA.PDF

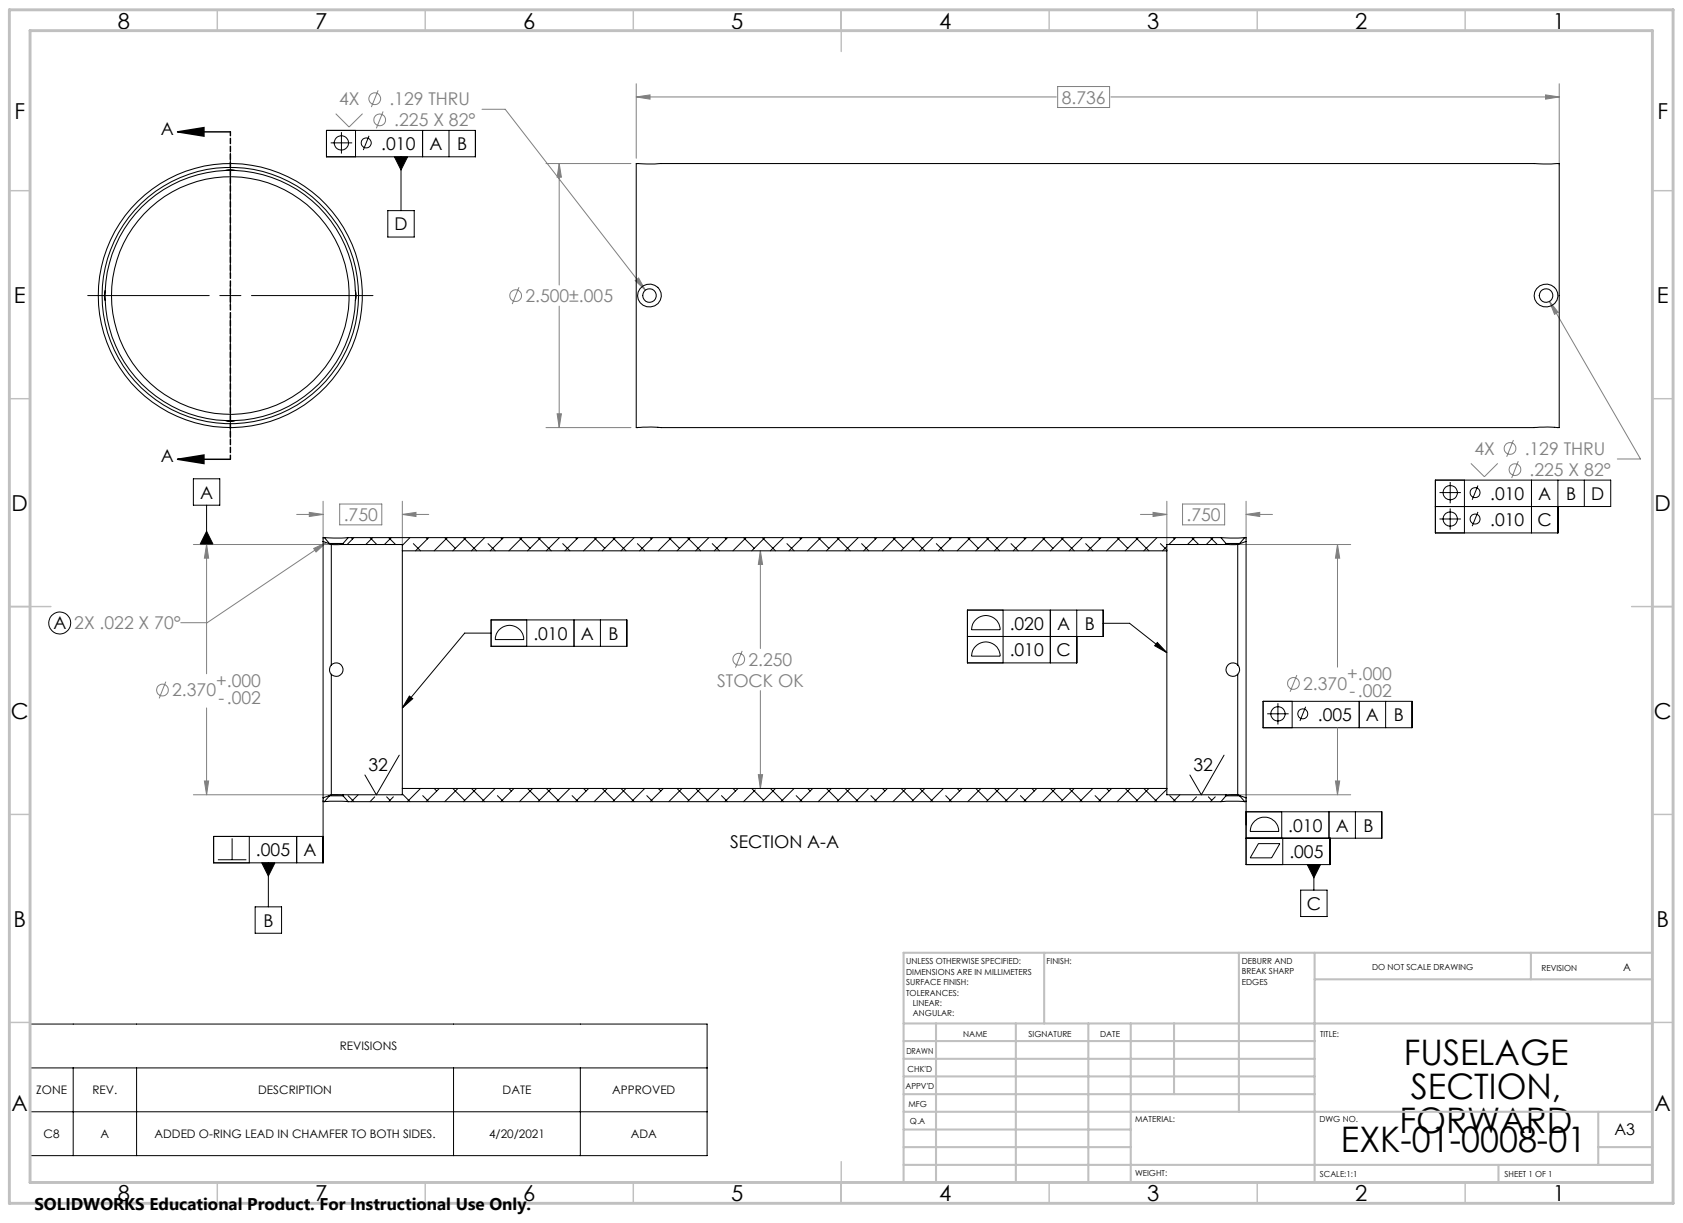
[picture p172: page 1]
.129 THRU; STOCK OK; SECTION A-A; ADDED O-RING LEAD IN CHAMFER TO BOTH SIDES.; ADA; FINISH:; DEBURR AND; BREAK SHARP; DO NOT SCALE DRAWING; REVISION; DWG NO.; SCALE:1:1; SHEET 1 OF 1

UNLESS OTHERWISE SPECIFIED:
DIMENSIONS ARE IN MILLIMETERS
SURFACE FINISH:
TOLERANCES:
LINEAR:
ANGULAR:

DRAWN
CHK'D
APPV'D
MFG

ZONE | REV. | DESCRIPTION | DATE | APPROVED

SOLIDWORKS Educational Product. For Instructional Use Only.
