corelab-umich/kiteCADRepo/(commit log)

2020-09-25 Added cad to new submodule repo. Please stop breaking simulink! AA
    [4668K150.SLDPRT, 4668K150_PERMANENTLY LUBRICATED SS BALL BRNG.SLDPRT, 5908K310.SLDPRT, 5908K310_ULTRA-CORROSION-RESISTANT SS BALL BEARING.SLDPRT, 5908K620_ULTRA-CORROSION-RESISTANT SS BALL BEARING.SLDPRT, 6153K880_STAINLESS STEEL BALL BEARING.SLDPRT, 90101A225_TYPE 18-8 SS THIN NYLON-INSERT LOCKNUT.SLDPRT, 90205A313_TYPE 316 STAINLESS STEEL NARROW HEX NUT.SLDPRT]
2020-09-30 Pre-production revision of LAS prints. Includes set of prints and models converted to .dxf/.pdf/.stp for manufacturing use. AA
    [00_LAS-02-0002.dxf, 00_LAS-03-0004.dxf, 01_LAS-02-0002.dxf, 01_LAS-03-0004.dxf, 4668K150.SLDPRT, 4668K150_PERMANENTLY LUBRICATED SS BALL BRNG.SLDPRT, 5908K310.SLDPRT, 5908K310_ULTRA-CORROSION-RESISTANT SS BALL BEARING.SLDPRT]
2020-09-30 Final update - AA
    [LAS-00-0000.SLDASM, LAS-01-0014.SLDASM, LAS-01-0016.SLDASM, LAS-02-0000.SLDASM, LAS-03-0000.SLDASM, LAS-03-0004.SLDPRT, LAS-03-0005.SLDPRT]
2020-10-07 Added experimental scale kite - Added Dillon's first cut at tow test assy - AA
    [1-2 inch x 1 inch SS, 1-2-20.SLDPRT, 1-2-20 SS Nut.SLDPRT, 1.5 inch lifting eye - no nut.SLDPRT, 1.5 inch lifting eye.SLDPRT, 2 ft x 2ft Al sheet.SLDPRT, 3DM-CX5-25.SLDPRT, 6 foot Pontoon.SLDPRT, 8020 -1inch - 0 ft 4.5 in.SLDPRT]
2020-10-07 Changed for example - AA - Will change back immediately
    [Nano.SLDPRT]
2020-10-07 Integrated Dillons model. AA
    [2 ft x 2ft Al sheet.SLDPRT, LAS-00-0000.SLDASM, LAS-01-0014.SLDASM, LAS-01-0016.SLDASM, LAS-02-0000.SLDASM, LAS-03-0000.SLDASM, MRkiteAssemblyWithProp_FS.SLDASM, NCSU Olympic Pool V2.0.SLDPRT]
2020-10-07 Removed from Git
    [MRfuselageWithProp_FS.SLDPRT, MRfuselageWithProp_FS_1.SLDPRT, MRhStab_FS.SLDPRT, MRkiteAssembly4Turb_FS.SLDASM, MRkiteAssembly4Turb_FS.STEP, MRkiteAssemblyWithProp_FS.SLDASM, MRkiteAssemblyWithProp_FS.STEP, MRpropellerGrabCad.SLDPRT]
2020-10-07 modified for DOE review. AA
    [LAS-00-0000.SLDASM, LAS-01-0014.SLDASM, LAS-01-0016.SLDASM, LAS-02-0000.SLDASM, LAS-03-0000.SLDASM, MRkiteAssemblyWithProp_FS.SLDASM, Raft V4.0.SLDASM, Retraction Reel Subassembly.SLDASM]
2020-10-14 Add files via upload
    Huzzah 32 Solidworks part file [units: inches]
    [Huzzah32ESP32Feather.SLDPRT]
2020-10-14 Arduino Nano SW part uploaded by MM [units: inches]
    [ArduinoNano.SLDPRT]
2020-10-14 Blue Robotics Part File uploaded by MM [units: inches]
    [BlueRoboticsBar02.SLDPRT]
2020-10-14 BNO055 SW part uploaded by MM [units: inches]
    [BNO055.SLDPRT]
2020-10-14 CDM-CX5-25 SW part uploaded by MM [units:inches]
    [CDMCX525.SLDPRT]
2020-10-14 UART-RS485 Breakout SW part uploaded by MM [units:inches]
    [UARTRS485Breakout.SLDPRT]
2020-10-14 Remove Out of Date Tow Assembly
    [1-2 inch x 1 inch SS, 1-2-20.SLDPRT, 1-2-20 SS Nut.SLDPRT, 1.5 inch lifting eye - no nut.SLDPRT, 1.5 inch lifting eye.SLDPRT, 2 ft x 2ft Al sheet.SLDPRT, 6 foot Pontoon.SLDPRT, 8020 -1inch - 0 ft 4.5 in.SLDPRT, 8020 -1inch - 1 ft 6 in.SLDPRT]
2020-10-14 Update Tow System CAD
    [1 inch x 2 inch L bracket.SLDPRT, 1-2 inch x 1 inch SS, 1-2-20.SLDPRT, 1-2-20 SS Nut.SLDPRT, 1.5 inch lifting eye - no nut.SLDPRT, 1.5 inch lifting eye.SLDPRT, 2 ft x 2ft Al sheet.SLDPRT, 2 inch roller.SLDPRT, 5908K310.SLDPRT]
2020-10-19 Solidworks updataes 0AA
    [LAS-00-0000.SLDASM, LAS-01-0014.SLDASM, LAS-01-0016.SLDASM, LAS-02-0000.SLDASM, LAS-03-0000.SLDASM, LAS-03-0005.SLDPRT]
2020-10-20 Add Redirect Pulleys
    [LAS-00-0000.SLDASM, LAS-01-0014.SLDASM, LAS-01-0016.SLDASM, LAS-02-0000.SLDASM, LAS-03-0000.SLDASM, _LAS Standoff Assy V1.0.SLDASM]
2020-10-20 Updating LAS Standoff to include redirect - in progress
    [LAS-00-0000.SLDASM, LAS-01-0014.SLDASM, LAS-01-0016.SLDASM, LAS-02-0000.SLDASM, LAS-03-0000.SLDASM, Retraction Reel Subassembly.SLDASM, _LAS Standoff Assy V1.0.SLDASM, _Retraction System Assy V1.0.SLDASM]
2020-10-20 Load Cell Implemented - Orientation not correct
    [LAS-00-0000.SLDASM, LAS-01-0014.SLDASM, LAS-01-0016.SLDASM, LAS-02-0000.SLDASM, LAS-03-0000.SLDASM, Retraction Reel Subassembly.SLDASM, _LAS Standoff Assy V1.0.SLDASM, _Retraction System Assy V1.0.SLDASM]
2020-10-21 Tether/Pulley Redirect for LAS complete - DJH
    [8020 -1inch - 1 ft 6 in.SLDPRT, Kite Tether Midsection.SLDPRT, LAS-00-0000.SLDASM, LAS-01-0014.SLDASM, LAS-01-0016.SLDASM, LAS-02-0000.SLDASM, LAS-03-0000.SLDASM, Retraction Frame.SLDASM]
2020-10-22 LAS Tether Redirect Updates
    [8020 -1inch - 1 ft 6 in.SLDPRT, LAS-00-0000.SLDASM, LAS-01-0014.SLDASM, LAS-01-0016.SLDASM, LAS-02-0000.SLDASM, LAS-03-0000.SLDASM, _Tow System Assy V1.1.SLDASM]
2020-10-22 Manta Briefing - 10.22.20
    [LAS-00-0000.SLDASM, LAS-01-0014.SLDASM, LAS-01-0016.SLDASM, LAS-02-0000.SLDASM, LAS-03-0000.SLDASM]
2020-10-29 Revisions to Raft Tether Redirect
    [LAS-00-0000.SLDASM, LAS-01-0014.SLDASM, LAS-01-0016.SLDASM, LAS-02-0000.SLDASM, LAS-03-0000.SLDASM, Raft Redirect Pulley - 1.5 inch.SLDPRT, Retraction Frame.SLDASM, Retraction Reel Subassembly.SLDASM]
2020-10-30 Redirect Updates, Tow System Updates - DJH
    [Kite Tether Midsection.SLDPRT, LAS-00-0000.SLDASM, LAS-01-0014.SLDASM, LAS-01-0016.SLDASM, LAS-02-0000.SLDASM, LAS-03-0000.SLDASM, Retraction Reel Subassembly.SLDASM, _LAS Standoff Assy V1.0.SLDASM]
2020-11-02 Update Redirect with missing files
    [1 inch 8020 - 12 inches - 45 ends.SLDPRT, 1 inch 8020 - 6 in - 45 ends.SLDPRT, 47065T331_ALUMINUM 1in Rail - 45 ends.SLDPRT, 5913K630_LOW-PROFILE MOUNTED BALL BEARING.SLDPRT, 6357K430_ULTRA-CORROSION-RESISTANT ACETAL BALL BEARING.SLDPRT, 8020 -1inch - 160mm.SLDPRT, 8020 -1inch - 181.75.SLDPRT, 8020 -1inch - 247.65mm.SLDPRT]
2020-11-03 Updates to Redirect - Created BOM
    [2 ft x 2ft Al sheet.SLDPRT, 6 foot Pontoon.SLDPRT, 90 exterior bracket.SLDPRT, 9466T890_HEAVY DUTY NYLON PULLEY FOR WIRE ROPE - 6in OD.SLDPRT, L Bracket.SLDPRT, LAS-00-0000.SLDASM, LAS-01-0014.SLDASM, LAS-01-0016.SLDASM]
2020-11-03 Tow System Updates
    [6357K430_ULTRA-CORROSION-RESISTANT ACETAL BALL BEARING.SLDPRT, 91247A219_MEDIUM-STRG GRADE 5 ZINC-PLTD STL CAP SCREW.SLDPRT, 94622A247_ARMY-NAVY STEEL HEX-HEAD SCREW.SLDPRT, 9466T680_HEAVY DUTY NYLON PULLEY FOR WIRE ROPE - 4_5-8 in OD.SLDPRT, 9466T680_HEAVY DUTY NYLON PULLEY FOR WIRE ROPE-4_5-8in POD.SLDPRT, 95030A210_LOW-STRENGTH STEEL LOCKNUT.SLDPRT, L Bracket Spacer.SLDPRT, LAS-00-0000.SLDASM]
2020-11-05 Redirect Updates
    [8020 -1inch - 52.4mm.SLDPRT, Load Cell Pulley Bracket.SLDPRT, _LAS Standoff Assy V1.0.SLDASM]
2020-11-08 Redirect Finalized
    [47065T145_SS T Rail Fastener.SLDPRT, 5537T457_ALUMINUM T-SLOTTED FRAMING Fastener 20mm Rail SS.SLDPRT, 5537T527_T-SLOTTED FRAMING 30mm rail SS.SLDPRT, 8982K461_ Left Custom for Load Cell and Pulley Bracket.SLDPRT, 8982K461_ Right Custom for Load Cell and Pulley Bracket.SLDPRT, 92510A618_ALUM UNTHRD SPACER 3_4OD x 5_8 long.SLDPRT, 94581A128_18-8 SS Weld Nut 10-32.SLDPRT, 94581A132_18-8 SS OFFSET-B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]
2020-11-08 Import UMD Winch
    [5448T18.step.SLDPRT, 92095A113.step.SLDPRT, Component1.step.SLDPRT, Component12.step.SLDPRT, Component13.step.SLDPRT, Component14.step.SLDPRT, Component15.step.SLDPRT, Component2.step.SLDPRT]
2020-11-12 Added last parts for Redirect
    [92185A677_TYPE 316 SS SOCKET HEAD CAP SCREW 1 1_2 inch length.SLDPRT, 92510A681_ALUM UNTHRD SPACER 3_4ID x 3_16 length.SLDPRT, _LAS Standoff Assy V1.0.SLDASM]
2020-11-17 Added manufacturing draings
    [LAS BOM.xlsx, LAS BOM_manufacturing.xlsx, LAS-01-0002.SLDPRT, LAS-01-0008.SLDPRT, LAS-01-0010.SLDPRT, LAS-01-0012.SLDPRT, LAS-01-0018.SLDPRT, LAS-01-0020.SLDPRT]
2020-11-25 Pulling .dxf files for waterjet
    [_LAS Standoff Assy V1.0.SLDASM]
2020-11-25 Tow Frame Bracing - working on hinge/bolt options
    [47065T701_45 Brace - 18 in.SLDPRT, 47065T703_45 brace - 24 in.SLDPRT, LAS-00-0000.SLDASM, LAS-01-0014.SLDASM, LAS-01-0016.SLDASM, LAS-02-0000.SLDASM, LAS-03-0000.SLDASM, Lower LAS Bracket.SLDPRT]
2020-12-04 Tow Frame Finalized
    [1614T644_1in x 17 in Aluminium bar - 5_16 thick.SLDPRT, 47065T139_Standard 1 in fastener.SLDPRT, 47065T512_8020 - 3inch - 1 ft 7 in.SLDPRT, 47065T570_Latch Pin.SLDPRT, 47065T570_Latch Receiver.SLDPRT, 6111K115_SS Leveling Foot.SLDPRT, 8020 -1inch - 0 ft 2 in.SLDPRT, 8020 -1inch - 0 ft 3 in.SLDPRT]
2020-12-04 Updates to fix pull issues. No part changes. -AA
    [EXK-01-0002.SLDPRT, LAS-00-0000.SLDASM, LAS-01-0014.SLDASM, LAS-01-0016.SLDASM, LAS-02-0000.SLDASM, LAS-02-0002.SLDDRW, LAS-03-0000.SLDASM, LAS-03-0004.SLDDRW]
2020-12-05 Frame Updates
2020-12-08 Raft Interface Planning
    [1630T651_6 in U Channel.SLDPRT, 1630T731_5 in U Channel.SLDPRT, 47065T512_1 in Triple Extrusion - 24 in.SLDPRT, 6 foot Pontoon.SLDPRT, 8982K297_6 in Angle.SLDPRT, 92186A550_SS 1-4_20 Bolt 2 in long.SLDPRT, 92851A125_SS HIGH-TENSION PUSH-BUTTON QUICK-RELEASE PIN - 2in length.SLDPRT, LAS-00-0000.SLDASM]
2020-12-09 CSI and Hardware Briefs
    [LAS-00-0000.SLDASM, LAS-01-0014.SLDASM, LAS-01-0016.SLDASM, LAS-02-0000.SLDASM, LAS-03-0000.SLDASM, Motor Support.step.SLDASM, Spool Core.step.SLDASM, Spool Support.step.SLDASM]
2020-12-09 Raft Interface with Kayak Updated
    [47065T512_1 in Triple Extrusion - 24 in.SLDPRT, 47065T512_1 in Triple Extrusion - 32 in.SLDPRT, 6 foot Pontoon.SLDPRT, 8020 -1inch - 32 inches - lifting eye holes.SLDPRT, 8020 -1inch - 6 feet.SLDPRT, 8982K286_ANGLE Lower Interface- 3in x 4 in x 6in long.SLDPRT, 8982K286_ANGLE Upper Interface- 3in x 4 in x 6in long.SLDPRT, 90715A125_TYPE 316 STAINLESS STEEL NYLON-INSERT LOCKNUT.SLDPRT]
2020-12-10 Tow Frame Updates
    [8020 -1inch - 1 ft 9 in.SLDPRT, 8020 -1inch - 2 ft 8 inches.SLDPRT, Motor Support.step.SLDASM, Spool Core.step.SLDASM, Spool Support.step.SLDASM, T Bracket.SLDPRT]
2020-12-16 Updated kite cad model - AA
    [640T.SLDPRT, Aileron.SLDPRT, EXK-01-0002.SLDPRT, EXK-01-0004.SLDPRT, EXK-01-0006.SLDPRT, EXK-02-0001.SLDPRT, EXK-02-0002.SLDPRT, EXK-02-0003.SLDPRT]
2020-12-17 Tow and Raft Updates
    [1614T644_1in x 17 in Aluminium bar - 5_16 thick.SLDPRT, 1614T644_1in x 364mm Aluminium bar - 5_16 thick.SLDPRT, 1614T644_1in x 465mm Aluminium bar - 5_16 thick.SLDPRT, 1614T644_1in x 48mm Aluminium bar - 5_16 thick.SLDPRT, 47065T125_2inch - 4 ft.SLDPRT, 47065T237_8020 2 in interior corner bracket.SLDPRT, 47065T512_8020 - 3inch - 1 ft 4.75 in.SLDPRT, 47065T512_8020 - 3inch - 1 ft 7 in.SLDPRT]
2020-12-19 Tow Tweaks
    [1.5 inch lifting eye.SLDPRT, 3032T610_316 SS EYEBOLT W NUT 1-4_20 x 4 in.SLDPRT, 4296A168_UHMV Plastic Shim 2in x 2in x 4in.SLDPRT, 6 foot Kayak.SLDPRT, 8020 - 2inch - 2 ft 2 in.SLDPRT, 8020 -1inch - 4 feet.SLDPRT, 8982K138_ANGLE Upper Interface- 3in x 4 in x 6in long.SLDPRT, 8982K286_ANGLE Lower Interface- 3in x 4 in x 6in long.SLDPRT]
2020-12-22 FEA on Tow Frame
    [1614T644_1in x 364mm Aluminium bar - 5_16 thick.SLDPRT, 3136N217_Heavy Duty 90 Pivot - V2.SLDPRT, 47065T778_1 in Slider.SLDPRT, 8020 -1inch - 2 ft 3 in.SLDPRT, 8020 -1inch - 2 ft 4 in.SLDPRT, 8020 -1inch - 2 ft 8 inches.SLDPRT, 90585A358_SS Countersunk Screw 1_4-20 x 5-8 in.SLDPRT, 92851A125_SS HIGH-TENSION PUSH-BUTTON QUICK-RELEASE PIN - 2in length.SLDPRT]
2020-12-23 FEA Pres
    [FEA - _Tow System Assy V1.1_defeature v3.SLDPRT, Motor Support.step.SLDASM, Spool Core.step.SLDASM, Spool Support.step.SLDASM]
2020-12-28 Tow Frame and Winch Updates
    [47065T663 Small Interior Gusset for 1 inch 8020.SLDPRT, 5448T18.step.SLDPRT, 8020 -1inch - 2 ft 0 in.SLDPRT, 92095A113.step.SLDPRT, Component1.step.SLDPRT, Component12.step.SLDPRT, Component13.step.SLDPRT, Component14.step.SLDPRT]
2020-12-29 Tow Reinforcement
    [47065T188_ 1 in 8020 45 brace 12 in.SLDPRT, GomexusReel.SLDASM, Handle.SLDPRT, Reel.SLDPRT]
2020-12-29 Raft Enclosure
    [3136N274_T-SLOTTED FRAMING.SLDPRT, 91772A537_18-8 SS PAN HEAD PHILLIPS MACHINE SCREW.SLDPRT, LCA_Baseline_Enclosure_16122020.SLDASM]
2020-12-29 Raft Enclosure LCA and Baseline with mounting MM
    [8961K93_MOUNTING ADAPTERS FOR DIN RAIL 10in.SLDPRT, 8961K93_MOUNTING ADAPTERS FOR DIN RAIL.SLDPRT, LCA_Enclosure_Mount.SLDASM]
2020-12-29 Raft Electrical Enclosure Brainstorming
    [1668T432_MULTIPURPOSE 6061 ALUMINUM T-BAR.SLDPRT, 47065T512_1 in Triple Extrusion - 32 in.SLDPRT, 91772A537_18-8 SS PAN HEAD PHILLIPS MACHINE SCREW.SLDPRT, LAS-00-0000.SLDASM, LAS-01-0014.SLDASM, LAS-01-0016.SLDASM, LAS-02-0000.SLDASM, LAS-03-0000.SLDASM]
2020-12-30 Updated kite geometry and added potential connectors. - AA
    [2401K123_ALUMINUM FLEXIBLE SHAFT COUPLING.SLDPRT, 2401K820_ALUMINUM FLEXIBLE SHAFT COUPLING.SLDPRT, 91182A604_TYPE 316 STAINLESS STEEL SHIM FOR BEARINGS.SLDPRT, 92479A730_EASY INSTALL SPIRAL INTERNAL RETAINING RING.SLDPRT, 93576A100_LIGHT DUTY SPIRAL EXTERNAL RETAINING RING.SLDPRT, AileronTry2.SLDPRT, Assem1.SLDASM, BAR02.SLDPRT]
2020-12-30 Raft with LCA/Baseline and Battery Enclosures
    [1668T432_MULTIPURPOSE 6061 ALUMINUM T-BAR.SLDPRT, 47065T512_1 in Triple Extrusion - 32 in.SLDPRT, 8020 -1inch - 32 inches - lifting eye holes.SLDPRT, LAS-00-0000.SLDASM, LAS-01-0014.SLDASM, LAS-01-0016.SLDASM, LAS-02-0000.SLDASM, LAS-03-0000.SLDASM]
2020-12-30 Tow Updates
    [LAS-00-0000.SLDASM, LAS-01-0014.SLDASM, LAS-01-0016.SLDASM, LAS-02-0000.SLDASM, LAS-03-0000.SLDASM, LCA_Baseline_Enclosure_16122020.SLDASM, LCA_Enclosure_Mount.SLDASM, _LAS Standoff Assy V1.0.SLDASM]
2020-12-30 Raft Enclosure Update - fixed references
    [1507 Bottom Tub.STEP, 1507 Top Tub.STEP, 7619K145_TAMPER-RESISTANT WASHDOWN ENCLOSURE.SLDPRT, ACAdapter.SLDPRT, Battery Enclosure 16122020.SLDASM, Battery_Mount.SLDASM, GoalZero.SLDPRT]
2020-12-30 Tow system with Mcmaster Enclosure
    [7619K145_TAMPER-RESISTANT WASHDOWN ENCLOSURE.SLDPRT]
2020-12-30 Check Sync
    [7619K145_TAMPER-RESISTANT WASHDOWN ENCLOSURE.SLDPRT, Battery Enclosure 16122020.SLDASM, Battery_Mount.SLDASM, LAS-00-0000.SLDASM, LAS-01-0014.SLDASM, LAS-01-0016.SLDASM, LAS-02-0000.SLDASM, LAS-03-0000.SLDASM]
2020-12-30 Raft Enclosure Mounting Updates
    [1507 Bottom Tub.SLDPRT, 1668T432_MULTIPURPOSE 6061 ALUMINUM T-BAR - 19.5in.SLDPRT, 1668T432_MULTIPURPOSE 6061 ALUMINUM T-BAR.SLDPRT, 47065T512_1 in Triple Extrusion - 32 in.SLDPRT, 8020 -1inch - 32 inches - lifting eye holes.SLDPRT, 8020 2 inch - 14.5 inches.SLDPRT, 8020 2 inch - 19 inches.SLDPRT, 8020 2 inch x 22 inch.SLDPRT]
2020-12-30 Electrical Enclosure Mounting Update
2020-12-30 Electrical Enclosure Update
    [8020 -1inch - 171.45 mm.SLDPRT, 8020 -1inch - 609.6mm.SLDPRT, 8020 -1inch - 933.45 mm.SLDPRT, 90185A106_GRADE 5 STEEL SQUARE-NECK CARRIAGE BOLT.SLDPRT, 95462A029_GRADE 5 STEEL HEX NUT.SLDPRT, L Bracket - Pool Enclosure Mount.SLDPRT]
2020-12-30 Raft Enclosure Update
2020-12-30 Raft Finalizations
    [8982K138_ANGLE Upper Interface- 3in x 4 in x 6in long.SLDPRT, Battery Enclosure 16122020.SLDASM, Battery_Mount.SLDASM, LAS-00-0000.SLDASM, LAS-01-0014.SLDASM, LAS-01-0016.SLDASM, LAS-02-0000.SLDASM, LAS-03-0000.SLDASM]
2020-12-30 Enclosure updates
    [GomexusReel.SLDASM]
2020-12-30 Tow updates with pool deck enclosure
2020-12-31 DDR Prep
    [2994T660_FORGED STL HOIST RING FOR LIFTING.SLDPRT, Battery Enclosure 16122020.SLDASM, Battery_Mount.SLDASM, Guy Wire Placeholder.SLDPRT, Guy Wire Span Beam.SLDPRT, LAS-00-0000.SLDASM, LAS-01-0014.SLDASM, LAS-01-0016.SLDASM]
2020-12-31 DDR Updates
    [4296A168_UHMV Plastic Shim 2in x 2in x 4in.SLDPRT, 8702K624 UHMV Plastic Shim 2in x 2in x 4in.SLDPRT, 8975K71 Underside Mounting Plate.SLDPRT, 93190A986 SS 3-4 x 7 in.SLDPRT, 93190A986_SS 3-4 x 7 in.SLDPRT, Battery Enclosure 16122020.SLDASM, Battery_Mount.SLDASM, LAS-00-0000.SLDASM]
2020-12-31 First attempt at retrieval system
    [1030A150_BRACKET.SLDPRT, 47065T186_ALUMINUM T-SLOTTED FRAMING EXTRUSION.SLDPRT, 47065T307_T-SLOTTED FRAMING.SLDPRT, 47065T703_ALUMINUM T-SLOTTED FRAMING EXTRUSION.SLDPRT, 47065T852_ALUMINUM T-SLOTTED FRAMING EXTRUSION.SLDPRT, 5537T384_ALUMINUM T-SLOTTED FRAMING EXTRUSION.SLDPRT, 8020 - 2inch - 312.7 mm.SLDPRT, 90696A196_18-8 STAINLESS STEEL SOCKET HEAD SCREW.SLDPRT]
2020-12-31 Updates to the Retrieval System
    [3018T140_GALV STL EYEBOLT W NUT AND W SHLDR.SLDPRT, 47065T139_ALUMINUM T-SLOTTED FRAMING EXTRUSION.SLDPRT, 8020 -1inch - 1 ft 4.75 in.SLDPRT, GomexusReel.SLDASM]
2020-12-31 DDR Pack and Go Stuff
    [1.5 inch lifting eye - no nut.SLDPRT, Fishing Line Placeholder.SLDPRT, Guide Line.SLDPRT, Kite Tether Midsection.SLDPRT, NCSU Olympic Pool V2.0.SLDPRT, Retraction Tether V2.0.SLDPRT, Swim Ladder V1.0.SLDPRT, Tow Tether V2.0.SLDPRT]
2021-01-03 BOM Takeoff
2021-01-03 Pool deck mounting update
    [90715A125_TYPE 316 STAINLESS STEEL NYLON-INSERT LOCKNUT-2.SLDPRT, 92240A628_18-8 STAINLESS STEEL HEX HEAD CAP SCREW.SLDPRT, 92673A125_ASTM F594 TYPE 18-8 STAINLESS STEEL HEX NUT.SLDPRT, 93190A547_TYPE 316 STAINLESS STEEL HEX HEAD CAP SCREW.SLDPRT]
2021-01-03 Updates to mounting pool deck enclosure
    [90107A013_TYPE 316 STAINLESS STEEL FLAT WASHER.SLDPRT, 92240A628_18-8 STAINLESS STEEL HEX HEAD CAP SCREW.SLDPRT, 92673A125_ASTM F594 TYPE 18-8 STAINLESS STEEL HEX NUT.SLDPRT]
2021-01-07 Tow Frame Brainstorming
    [1614T644_1in x 48mm Aluminium bar - 5_16 thick.SLDPRT, 2236T360_STACKABLE CLAMPING HANGER 1.5in ID.SLDPRT, 2236T360_STACKABLE CLAMPING HANGER 1.5in IDV3.SLDPRT, 2994T660_FORGED STL HOIST RING FOR LIFTINGV3.SLDPRT, 47065T125 8020 2inch - 2 ft 7 inV3.SLDPRT, 47065T125 8020 2inch - 4 ft.SLDPRT, 47065T188_ 1 in 8020 45 brace 12 inV3.SLDPRT, 47065T512_8020 - 3inch - 1 ft 3 inV3.SLDPRT]
2021-01-08 Tow Brainstorm Push
    [29605T450 316 SS U-BOLT.SLDPRT, 29605T450 316 SS U-BOLTFEA.SLDPRT, 2994T660_FORGED STL HOIST RING FOR LIFTINGV3FEA.SLDPRT, 47065T125 8020 2inch - 2 ft 4 inV3.SLDPRT, 47065T125 8020 2inch - 2 ft 4 inV3FEA.SLDPRT, 47065T125 8020 2inch - 2 ft 7 inV3.SLDPRT, 47065T186 8020 1in 45 Brace 6 in.SLDPRT, 47065T188_ 1 in 8020 45 brace 12 inFEA.SLDPRT]
2021-01-09 Adding holes to the raft enclosure for waterproof connectors
    [1507 Bottom Tub.SLDPRT, LCA_Baseline_Enclosure_16122020.SLDASM]
2021-01-11 Adding holes (waterproof connectors) to the raft enclosures
    [1507 Bottom Tub Battery 1.SLDDRW, 1507 Bottom Tub Battery 1.SLDPRT, 1507 Bottom Tub Battery.SLDPRT, 1507 Bottom Tub.SLDPRT]
2021-01-12 Adding Holes to the electrical enclosures MM
    [1507 Bottom Tub Battery 1.SLDDRW, 1507 Bottom Tub Battery 1.SLDPRT, 1507 Bottom Tub LCA 1.SLDDRW, 1507 Bottom Tub.SLDPRT, Battery Enclosure 16122020.SLDASM, LCA_Baseline_Enclosure_16122020.SLDASM]
2021-01-13 Simplify FEA Model for meeting with Eph
    [6689T606 CHROME-PLATED HARDENED 4140 ALLOY STEEL ROD 2in ODFEASimp.SLDPRT, Chrome Plated Steel Simp.SLDPRT, Guy Wire Span BeamV3FEASimp.SLDPRT, Guy Wire Vert BeamV3FEASimp.SLDPRT, Pool Surface ConstraintsSimp.SLDPRT, _Tow System Assy BRAINSTORMV3FEA.SLDASM, _Tow System Assy BRAINSTORMV3FEASimp.SLDASM]
2021-01-13 Sim mods
    [Chrome Plated Steel Simp.SLDPRT, Guy Wire Span BeamV3FEASimp.SLDPRT, Guy Wire Vert BeamV3FEASimp.SLDPRT, _Tow System Assy BRAINSTORMV3FEASimp.SLDASM]
2021-01-14 Updates to electrical enclosure holes.
    [1507 Bottom Tub Battery 1.SLDDRW, 1507 Bottom Tub LCA 1.SLDDRW, 1507 Bottom Tub.SLDPRT]
2021-01-17 FEA Tweaks
    [8020 -1inch - 1 ft 3 inV3.SLDPRT, Chrome Plated Steel Simp.SLDPRT, Guy Wire Span BeamV3FEASimp.SLDPRT, _Tow System Assy BRAINSTORMV3FEASimp.SLDASM]
2021-01-17 Tow Rev 3
    [29605T450 316 SS U-BOLT.SLDPRT, 2994T660_FORGED STL HOIST RING FOR LIFTINGV3.SLDPRT, 47065T125 8020 2inch - 2 ft 4 inV3.SLDPRT, 47065T188_ 1 in 8020 45 brace 12 in.SLDPRT, 47065T188_ 1 in 8020 45 brace 12 inV3.SLDPRT, 47065T512_8020 - 3inch - 1 ft 2 inV3.SLDPRT, 47065T663 Small Interior Gusset for 1 inch 8020V3.SLDPRT, 47065T701_45 Brace - 18 inV3.SLDPRT]
2021-01-17 Tow V4.0 Commit
    [29605T450 316 SS U-BOLT.SLDPRT, 2994T660_FORGED STL HOIST RING FOR LIFTINGV3.SLDPRT, 47065T125 8020 2inch - 2 ft 4 inV3.SLDPRT, 47065T188_ 1 in 8020 45 brace 12 in.SLDPRT, 47065T188_ 1 in 8020 45 brace 12 inV3.SLDPRT, 47065T512_8020 - 3inch - 1 ft 2 inV3.SLDPRT, 47065T663 Small Interior Gusset for 1 inch 8020V3.SLDPRT, 47065T701_45 Brace - 18 inV3.SLDPRT]
2021-01-17 Tow V4.0 New Files
    [29605T450 316 SS U-BOLT.SLDPRT, 2994T660_FORGED STL HOIST RING FOR LIFTINGV3.SLDPRT, 47065T125 8020 2inch - 2 ft 4 inV3.SLDPRT, 47065T188_ 1 in 8020 45 brace 12 in.SLDPRT, 47065T188_ 1 in 8020 45 brace 12 inV3.SLDPRT, 47065T512_8020 - 3inch - 1 ft 2 inV3.SLDPRT, 47065T663 Small Interior Gusset for 1 inch 8020V3.SLDPRT, 47065T701_45 Brace - 18 inV3.SLDPRT]
2021-01-18 Rev 4 updates
    [24125T270_LEVELING CASTER WNONMARKING BLK NYLON WHL.SLDPRT, 45lb plate.SLDPRT, 8020 - 2inch - 4 ft 0 in.SLDPRT, 8020 -1inch - 933.45 mmV3.SLDPRT, Guy Wire Lengthwise Support.SLDPRT, Guy Wire Vert BeamV3.SLDPRT]
2021-01-18 Tow Rev 4 Updates
    [25lb plate.SLDPRT, 8020 - 2inch - 1 ft 4 inV3.SLDPRT, 8020 -1inch - 1 ft 2 in.SLDPRT, 8020 -1inch - 1 ft 4 in.SLDPRT, 8020 -1inch - 2 ft 5 inchesV3.SLDPRT, 8020 -1inch - 2 ft 6 inchesV3.SLDPRT, 8974K711_ALUMINUM Rod 2in OD - 6in long.SLDPRT, 9008K874_6061 ALUMINUM rod 1.375 x 1.365 x 30 in.SLDPRT]
2021-01-18 Raft Manufacturing
    [8982K2_ANGLE Lower Interface- 3in x 3 in x 6in long.SLDPRT, Battery_Mount.SLDASM, LAS-00-0000.SLDASM, LAS-02-0000.SLDASM, LAS-03-0000.SLDASM, LCA_Enclosure_Mount.SLDASM]
2021-01-18 Tow Rev 4 Finalized
    [47065T893 8020 2in Interior Guesset.SLDPRT, 8020 - 2inch - 0 ft 9 in.SLDPRT, 8020 - 2inch - 3 ft 5 in.SLDPRT, 8020 - 2inch - 4 ft 0 in.SLDPRT, 8020 -1inch - 0 ft 6 in.SLDPRT, 8020 -1inch - 1 ft 2 in.SLDPRT, 8020 -1inch - 1 ft 4 in.SLDPRT, 8020 -1inch - 171.45 mmV3.SLDPRT]
2021-01-19 Tow Bom
2021-01-19 Tow Rev 4 BOM and Order
2021-01-20 Retrieval Inspection and Images for UREC Reservation
    [Battery Enclosure 16122020.SLDASM, Battery_Mount.SLDASM, LAS-00-0000.SLDASM, LAS-01-0014.SLDASM, LAS-01-0016.SLDASM, LAS-02-0000.SLDASM, LAS-03-0000.SLDASM, LCA_Baseline_Enclosure_16122020.SLDASM]
2021-01-21 Raft Modifications
    [3060T740 SS Square U Bolt - 4.375 width - 2.625 long - 3_8-16 thread.SLDPRT, 8889T420 SS U Bolt - 1.125in wide - 3.1875in long - 1_4-20.SLDPRT, 8889T912 SS U Bolt mounting plate - 1.125in spacing - 0.25in holes.SLDPRT, Battery Enclosure 16122020.SLDASM, Battery_Mount.SLDASM, LAS-00-0000.SLDASM, LAS-01-0014.SLDASM, LAS-01-0016.SLDASM]
2021-01-21 Takeoff for Tow Frame
2021-01-22 Edit to the Retraction System
    [GomexusReel.SLDASM]
2021-01-22 DOE Brief Updates
    [8020 - 2inch - 33.SLDPRT, 8020 - 2inch - 41.SLDPRT, Battery Enclosure 16122020.SLDASM, Battery_Mount.SLDASM, Fishing Line Placeholder.SLDPRT, GomexusReel.SLDASM, LAS-00-0000.SLDASM, LAS-01-0014.SLDASM]
2021-01-22 Updated Kite Geometry
    [2401K123_ALUMINUM FLEXIBLE SHAFT COUPLING.SLDPRT, 92479A730_EASY INSTALL SPIRAL INTERNAL RETAINING RING.SLDPRT, Assem1.SLDASM, Buoyancy Model.SLDPRT, EXK-00-0000.SLDASM, EXK-01-0002.SLDDRW, EXK-01-0002.SLDPRT, EXK-01-0006.SLDPRT]
2021-01-22 Fix the retrieval frame sync issue
2021-01-22 Fixing push and pull
    [GomexusReel.SLDASM]
2021-02-02 Caster Wheel Adapter
    [8974K72 6061 Al Rod 2in OD.SLDPRT, Caster Wheel Adapter.SLDPRT]
2021-02-04 Transmitted files to VX
    [Buoyancy Model.SLDPRT, CB6014CR04-1P.SLDPRT, EXK-00-0000.SLDASM, EXK-01-0010.SLDPRT, EXK-01-0012.SLDPRT, EXK-01-0014.SLDPRT, EXK-02-0001.SLDPRT, EXK-02-0003.SLDPRT]
2021-02-04 Static Level Wind
    [Static Level Wind.SLDPRT]
2021-02-16 Static Level Wind and Slip Ring Revision
    [Static Level Wind.SLDPRT]
2021-02-19 color test
    [7619K145_TAMPER-RESISTANT WASHDOWN ENCLOSUREV3.SLDPRT]
2021-02-19 counterweight added to retrieval
    [25lb weight.SLDPRT, 45lb weight_.SLDPRT, 8020 - 2inch - 15 in V302_weight bar.SLDPRT, GomexusReel.SLDASM, weight_plate_bar.SLDPRT]
2021-02-22 Retrieval Weight Carrier Takeoff
    [GomexusReel.SLDASM]
2021-02-22 Tow side counter weights
    [25lb weight.SLDPRT, 45lb weight_.SLDPRT, 8020 - 2inch - 1 ft 2 inV3_counter_weight.SLDPRT, 8020 - 2inch - 1 ft 2 inV3_counter_weight1.SLDPRT, 92851A140_SS HIGH-TENSION PUSH-BUTTON QUICK-RELEASE PIN - 4in usable length.SLDPRT, counterweight beam v1.SLDPRT]
2021-02-23 Tow Weight Carrier Review
    [7619K145_TAMPER-RESISTANT WASHDOWN ENCLOSUREV3.SLDPRT]
2021-02-23 TOW SIDE COUNTER WEIGHT V3
    [8020 - 2inch - 1 ft 2 inV3_counter_weight.SLDDRW, 8020 - 2inch - 1 ft 2 inV3_counter_weight.SLDPRT, 8020 - 2inch - 1 ft 2 inV3_counter_weight1.SLDDRW, 8020 - 2inch - 1 ft 2 inV3_counter_weight1.SLDPRT, 92196A307_18-8 STAINLESS STEEL SOCKET HEAD SCREW.SLDPRT, 92196A823_18-8 STAINLESS STEEL SOCKET HEAD SCREW.SLDPRT, counterweight beam v1.SLDDRW, counterweight beam v1.SLDPRT]
2021-02-24 Weight Carrier Revisions
    [8020 - 2inch - 1 ft 2 inV3_counter_weight.SLDDRW, 8020 - 2inch - 1 ft 2 inV3_counter_weight.SLDPRT, 8020 - 2inch - 1 ft 2 inV3_counter_weight1.SLDDRW, 8020 - 2inch - 3 ft 5 in.SLDPRT, counterweight beam v1.SLDPRT, counterweight beam vDH1.SLDDRW]
2021-03-02 Kite edits and drawings for subcomponent fabrication
    [Buoyancy Model.SLDPRT, EXK-00-0000.SLDASM, EXK-01-0002.SLDPRT, EXK-01-0006.SLDPRT, EXK-01-0008.SLDPRT, EXK-01-0012.SLDPRT, EXK-01-0014-01.SLDDRW, EXK-01-0014-01.SLDPRT]
2021-03-03 Slip Ring Retaining Plate Designed
    [Slip Ring Restraining Plate.SLDPRT]
2021-03-08 Raft Encoder Implementation
    [8982K461_ Right Custom for Load Cell and Pulley Bracket.SLDPRT, Custom Encoder Shaft.SLDPRT, Custom Pulley for Encoder.SLDPRT, Encoder Placeholder.SLDPRT, Encoder Shaft Bushing.SLDPRT, Encoder Shaft Key.SLDPRT, _LAS Standoff Assy V1.0.SLDASM]
2021-03-09 Level wind test fit
    [5057N110_PERMANENTLY LUBRICATED MOUNTED BALL BEARING.SLDPRT, L-00007 (NC STATE LEVELWIND).SLDPRT]
2021-03-09 Update with Fab Drawings
    [Buoyancy Model.SLDPRT, Buoyancy Model.STEP, COMPOUND.step.SLDPRT, EXK-00-0000.SLDASM, EXK-01-0002.SLDDRW, EXK-01-0002.SLDPRT, EXK-01-0006.SLDDRW, EXK-01-0006.SLDPRT]
2021-03-09 Fixed small geometry error EXK-02-0024
    [EXK-02-0024.SLDPRT]
2021-03-15 CSI Prep and String Pot Incorporation
    [8020 -1inch - 6 ft 0 in.SLDPRT, Kite Launch Platform.SLDASM, LAS-00-0000.SLDASM, LAS-02-0000.SLDASM, LAS-03-0000.SLDASM, String Pot Line Placeholder.SLDPRT, String Potentiometer.SLDPRT]
2021-03-22 Raft encoder Take off
    [_LAS Standoff Assy V1.0.SLDASM]
2021-03-23 Pulley Update for Raft Encoder
    [Custom Pulley for Encoder.SLDPRT]
2021-03-24 Pulley Revision
    [Custom Pulley for Encoder.SLDPRT, Encoder Shaft Bushing.SLDPRT, _LAS Standoff Assy V1.0.SLDASM]
2021-03-25 Take off for Raft Encoder and Winch Rev 2 Fab Requests
    [Custom Pulley for Encoder.SLDDRW, Custom Pulley for Encoder.SLDPRT, Encoder Shaft Bushing.SLDDRW, Encoder Shaft Bushing.SLDPRT, UMD - Winch Side Plate - DJH Edits.SLDPRT, _LAS Standoff Assy V1.0.SLDASM]
2021-04-02 DOE Quarterly Takeoff
    [LAS-00-0000.SLDASM, LAS-02-0000.SLDASM, LAS-03-0000.SLDASM]
2021-04-07 Drawing Take off for Load Cell Bracket V2 and Pulley Bracket V2 for raft encoder
    [8982K461_ Right Custom for Load Cell and Pulley Bracket.SLDPRT, Load Cell - 50 to 1000lbs.SLDPRT, Load Cell Bracket.SLDPRT, _LAS Standoff Assy V1.0.SLDASM]
2021-04-08 Kite geometry updates
    [90585A203_TYPE 316 SS FLAT-HEAD SOCKET CAP SCREW.SLDPRT, 91500A124_TYPE 316 SS FLAT HEAD PHILLIPS MACHINE SCREW.SLDPRT, Bridle.SLDPRT, Bridle_Compact.SLDPRT, EXK BOM.xlsx, EXK-01-0002.SLDPRT, EXK-01-0008-01.STEP, EXK-01-0008-02.STEP]
2021-04-09 Fab Request Take off
    [8982K461_ Right Custom for Load Cell and Pulley Bracket.SLDPRT, Load Cell Bracket.SLDPRT, _LAS Standoff Assy V1.0.SLDASM]
2021-05-12 updates to exp kite.
    [10K.stp.STEP.SLDPRT, 10uF.stp.STEP.SLDPRT, 20329.stp.STEP.SLDPRT, 4.7K.stp.STEP.SLDPRT, 5pin_M_254.STEP.SLDPRT, 92510A817_ALUM UNTHRD SPACER.SLDPRT, 92735A500_CLEVIS PIN WITH RETAINING RING GROOVE.SLDPRT, Assem2.SLDASM]
2021-06-01 Raft Encoder Bearing Update
    [8982K461_ Right Custom for Load Cell and Pulley Bracket.SLDPRT, _LAS Standoff Assy V1.0.SLDASM]
2021-06-08 Raft bearing updates
    [4390N128_FLANGED ULTRA-THIN BALL BEARING.SLDPRT, 5169N21_FLANGED DRY-RUNNING SLEEVE BEARING.SLDPRT, 5912K820_OIL-EMBEDDED MOUNTED SLEEVE BEARING.SLDPRT, 6656K182_ULTRA-THIN BALL BEARING.SLDPRT, 6660K321_SELF-ALIGNING BALL BEARING.SLDPRT, 8982K461_ Left Custom for Load Cell and Pulley Bracket.SLDPRT, 8982K461_ Right Custom for Load Cell and Pulley Bracket.SLDPRT, _LAS Standoff Assy V1.0.SLDASM]
2021-06-28 Raft Encoder Update 2.1
    [1511K260_QUICK-RELEASE CLAMPING SHAFT COLLAR.SLDPRT, 7405K230_FULLY KEYED 316 STAINLESS STEEL DRIVE SHAFT.SLDPRT, 8982K461_ Left Custom for Load Cell and Pulley Bracket.SLDPRT, 8982K461_ Right Custom for Load Cell and Pulley Bracket.SLDPRT, 90585A068_TYPE 316 SS FLAT-HEAD SOCKET CAP SCREW.SLDPRT, Custom Pulley for Encoder V2.0.SLDPRT, _LAS Standoff Assy V1.0.SLDASM]
2021-06-28 Boom Pressure Sensor and LAS Mount
    [51235K108_PUSH-TO-CONNECT TUBE FITTING WUNIVERSAL THREAD.SLDPRT, 90575A542_SUPER-CORROSION-RST 316 SS THREADED ROD 1.5in.SLDPRT, 90575A542_SUPER-CORROSION-RST 316 SS THREADED ROD.SLDPRT, 94819A043_ASTM F594 TYPE 316 STAINLESS STEEL HEX NUT.SLDPRT, Boom_Lower Adapter Plate.SLDPRT, Housing Edge Panels.SLDPRT, Inner End Cap.SLDPRT, LAS-00-0000.SLDASM]
2021-06-29 Privateer Hull
    [10-24 Thread Size_6in Long.SLDPRT, 655A-07-C.SLDPRT, Full Scale Lake Layout.SLDASM, Lake Body.SLDPRT, Lower End Cap.SLDPRT, LowerUnit-Eppler862.SLDPRT, MidUnit-Eppler862.SLDPRT, Pitot Tube.SLDPRT]
2021-06-30 V1 Boat PTO System added
    [1439K370_1045 CARBON STEEL KEYED ROTARY SHAFT.SLDPRT, 1439K370_1045 CARBON STEEL KEYED ROTARY SHAFT_editied.SLDPRT, 15-18mm Misalinemnt coupler.SLDASM, 1630T721_MULTIPURPOSE 6061 ALUMINUM U-CHANNEL.SLDPRT, 18-18mm Misalinemnt coupler.SLDASM, 28tooth.SLDASM, 3.5in pipe.SLDPRT, 34tooth pully.SLDPRT]
2021-07-02 added working files
    [5.SLDASM, BAR02.SLDPRT, Buoyancy Model.SLDPRT, CDMCX525.SLDPRT, ControlAr,.SLDPRT, EXK-01-0002.SLDPRT, EXK-01-0006.SLDDRW, EXK-01-0008.SLDPRT]
2023-12-21 Created A-Frame boat
    [2401K123_ALUMINUM FLEXIBLE SHAFT COUPLING.SLDPRT, 2401K820_ALUMINUM FLEXIBLE SHAFT COUPLING.SLDPRT, 4668K150.SLDPRT, 51235K108_PUSH-TO-CONNECT TUBE FITTING WUNIVERSAL THREAD.SLDPRT, 5908K310.SLDPRT, 655A-07-C.SLDPRT, 90107A029_ALLOY 20 STAINLESS STEEL FLAT WASHER for .25 in bolt.SLDPRT, 90575A542_SUPER-CORROSION-RST 316 SS THREADED ROD 1.5in.SLDPRT]
